SARAHXL1/Expo2023-HABOOB/hardware/3d-models/Anemometer DC motor - 3648443/images/piezas.png

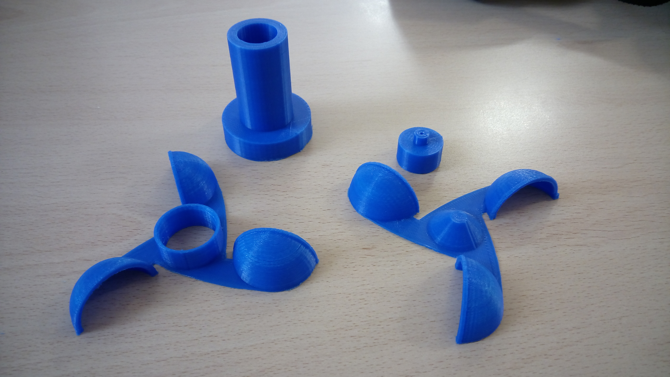
hardware/3d-models/Anemometer DC motor - 3648443/images/piezas.png
