SARAHXL1/Expo2023-HABOOB/hardware/3d-models/Anemometer DC motor - 3648443/README.txt

Anemometer DC motor by Rovegrod on Thingiverse: https://www.thingiverse.com/thing:3648443

Summary:
Low cost anemometer for your projects. I fully recommend the version wich is divided into two halves and the connector for a better an easier printing.Enjoy!
