SARAHXL1/Expo2023-HABOOB/src/05_docs/جدول-التوصيل.md

# جدول التوصيل الكامل

منقول من «دليل بناء عقدة الاستشعار — النموذج الأولي»، القسم 5.

> أرقام المنافذ مقترحة للوحة **ESP32 DevKit V1 ذات 30 منفذًا**.
> راجعها على الطباعة الموجودة على لوحتك قبل التوصيل.

## ملخص

- كل الحساسات والشاشة تتغذى من **3V3** في ESP32، ولها **GND مشترك** مع كل شيء.
- ناقل I2C (GPIO 21 و22) يجمع ADS1115 (`0x48`) وMLX90614 (`0x5A`) وBH1750 (`0x23`).
- ناقل SPI يربط الشاشة.
- DHT22 وDS18B20 لكل منهما سلك بيانات مستقل.
- خط 5V يأتي من TPS63020 إلى **VIN فقط**، ولا يدخل أي حساس.

## توزيع منافذ ESP32

| منفذ ESP32 | يوصل إلى | الغرض |
|---|---|---|
| VIN | VOUT في TPS63020، والطرف الموجب للمكثف | دخل 5V |
| GND | خط GND المشترك | أرضي |
| 3V3 | خط 3V3 على لوحة التجارب | تغذية الحساسات والشاشة |
| GPIO 4 | DATA في DHT22 | حرارة الهواء والرطوبة |
| GPIO 13 | DATA في DS18B20 | حرارة الكرة |
| GPIO 21 | SDA في ADS1115 وMLX90614 وBH1750 | بيانات I2C |
| GPIO 22 | SCL في ADS1115 وMLX90614 وBH1750 | ساعة I2C |
| GPIO 18 | SCL/CLK في الشاشة | ساعة SPI |
| GPIO 23 | SDA/DIN في الشاشة | بيانات SPI |
| GPIO 5 | CS في الشاشة | اختيار الشاشة |
| GPIO 16 | DC في الشاشة | أمر أو بيانات |
| GPIO 17 | RES/RST في الشاشة | إعادة تشغيل الشاشة |
| GPIO 32 | BL/BLK في الشاشة | تعتيم الإضاءة (PWM) |

**منافذ يجب تجنبها:** GPIO 6 إلى 11 (محجوزة للذاكرة). وGPIO 0 و2 و12 و15 منافذ
إقلاع (Strapping) قد تمنع الإقلاع. وGPIO 34 إلى 39 إدخال فقط.
GPIO 5 منفذ إقلاع أيضًا، لكنه مقبول لـ CS لأنه يبقى مرتفعًا وقت الإقلاع.

## DHT22

| الطرف | يوصل إلى |
|---|---|
| + (VCC) | 3V3 |
| OUT (DATA) | GPIO 4 |
| − (GND) | GND المشترك |

الحساس المجرد بأربعة أرجل يحتاج **مقاومة سحب 10kΩ** بين DATA وVCC.
الوحدة ذات الأطراف الثلاثة فيها المقاومة أصلًا.
لا يُقرأ أسرع من مرة كل ثانيتين، وإلا ترجع القراءة `NaN`.

## DS18B20 (داخل الكرة)

| الطرف | يوصل إلى |
|---|---|
| الأحمر (VDD) | 3V3 |
| الأسود (GND) | GND المشترك |
| الأصفر (DATA) | GPIO 13 |
| **مقاومة 4.7kΩ** | **بين DATA و3V3 — إلزامية** |

بدون المقاومة لا يرد الحساس. القراءة **−127 °م** تعني أن المجس غير متصل.
ألوان الأسلاك قد تختلف (الأبيض أحيانًا للبيانات).

## ADS1115

| الطرف | يوصل إلى | ملاحظة |
|---|---|---|
| VDD | 3V3 | |
| GND | GND المشترك | |
| SCL | GPIO 22 | ناقل I2C المشترك |
| SDA | GPIO 21 | ناقل I2C المشترك |
| ADDR | GND | العنوان `0x48` |
| ALRT | لا يوصل | |
| A0 | طرف الموتور الموجب **عبر مقاومة 1kΩ** | سرعة الرياح |
| A1 | منتصف مقسّم الجهد (10kΩ + 10kΩ) من B+ | جهد البطارية |
| A2، A3 | لا توصل | احتياط |

**لا يُدخل على أي مدخل جهد أعلى من 3.3V.** البطارية (4.2V) تُقسم على اثنين قبل A1.

الكسب: `GAIN_FOUR` (±1.024V) للموتور، و`GAIN_ONE` (±4.096V) للبطارية.

## الموتور (مقياس الرياح)

| من | إلى | ملاحظة |
|---|---|---|
| طرف الموتور (+) | مقاومة 1kΩ ثم A0 في ADS1115 | المقاومة تحد التيار |
| طرف الموتور (−) | GND المشترك | |
| مقاومة 10kΩ | بين طرفي الموتور مباشرة | حِمل يثبّت القراءة |

قِس جهد الموتور بالملتيميتر وأنت تديره بأقصى سرعة؛ إن تجاوز 3V أضف مقسّم جهد.
إن ظهرت القراءة سالبة، **اعكس سلكيه**. اجدل السلكين الطويلين لتقليل التشويش.

## MLX90614

| الطرف | يوصل إلى |
|---|---|
| VIN | 3V3 (تحقق من نسخة الجهد) |
| GND | GND المشترك |
| SCL | GPIO 22 |
| SDA | GPIO 21 |

يفرض سرعة I2C قدرها **100 kHz** على الناقل كله — `Wire.setClock(100000)`.

## BH1750

| الطرف | يوصل إلى |
|---|---|
| VCC | 3V3 (أقصى تغذية 3.6V) |
| GND | GND المشترك |
| SCL | GPIO 22 |
| SDA | GPIO 21 |
| ADDR | GND → العنوان `0x23` |

## شاشة ST7789

| طرف الشاشة | يوصل إلى |
|---|---|
| VCC | 3V3 |
| GND | GND المشترك |
| SCL أو CLK | GPIO 18 |
| SDA أو DIN | GPIO 23 |
| RES أو RST | GPIO 17 |
| DC | GPIO 16 |
| CS | GPIO 5 |
| BL أو BLK | GPIO 32 (أو 3V3 لإضاءة دائمة) |

أسماء الأطراف تختلف بين الموردين. أسلاك SPI تحب القِصر: أقل من 20 سم.

## دائرة الطاقة

### TP4056

| الطرف | يوصل إلى |
|---|---|
| منفذ USB-C | محول طاقة 5V USB-C (2A على الأقل) |
| IN+ / IN− | اللوح الشمسي (اختياري، فقط عند فصل المحول) |
| B+ | الطرف الموجب للبطاريتين (على التوازي) |
| B− | الطرف السالب للبطاريتين |
| OUT+ | طرف المفتاح الأوسط |
| OUT− | GND المشترك، وGND في TPS63020 |

**استخدم OUT وليس B للحمل**، لأن الحماية من التفريغ العميق تعمل على طرفي OUT فقط.

### البطاريتان (على التوازي)

| من | إلى |
|---|---|
| موجب الحامل 1 | موجب الحامل 2، ثم B+ |
| سالب الحامل 1 | سالب الحامل 2، ثم B− |

الجهد يبقى 3.7V والسعة تتضاعف إلى 7000 mAh.
**قِس جهد كل بطارية قبل الوصل**، ويجب أن يكون الفرق أقل من 0.1V.

### المفتاح SK12D07VG5

| الطرف | يوصل إلى |
|---|---|
| الأوسط (المشترك) | OUT+ في TP4056 |
| أحد الجانبيين | VIN في TPS63020 |
| الجانبي الآخر | لا يوصل |

المفتاح على خط الموجب فقط، فالشحن يستمر والعقدة مطفأة.

### TPS63020

| الطرف | يوصل إلى |
|---|---|
| VIN | الطرف الجانبي من المفتاح |
| GND (الدخل) | OUT− في TP4056 |
| VOUT | VIN في ESP32، والطرف الموجب للمكثف |
| GND (الخرج) | GND المشترك |
| EN (إن وُجد) | VIN |

**تحقق من جهد الخرج بالملتيميتر قبل توصيل ESP32.**

### المكثف 1000µF

| الطرف | يوصل إلى |
|---|---|
| الموجب (الرجل الأطول) | VIN في ESP32 (خط 5V) |
| السالب (جهة الخط الأبيض) | GND |

ضعه أقرب ما يمكن إلى VIN. **عكس قطبيته قد يجعله ينتفخ أو ينفجر.**

## خطوات أول تشغيل للطاقة

- [ ] قِس جهد كل بطارية منفردة، ثم صلهما على التوازي.
- [ ] صل البطاريتين بـ TP4056، وصل المحول. يجب أن يضيء ليد الشحن.
- [ ] **دون توصيل ESP32:** صل OUT ← المفتاح ← TPS63020، وقِس خرجه (قرابة 5V).
- [ ] ركّب المكثف على الخرج، مع الانتباه للقطبية.
- [ ] صل ESP32 بخرج 5V. يجب أن يضيء ليد الطاقة فيها.
- [ ] افصل المحول. يجب أن تستمر اللوحة في العمل دون إعادة تشغيل.

## ألوان الأسلاك المقترحة

أحمر = 5V · برتقالي = 3V3 · أسود = GND · أزرق = SDA · أخضر = SCL

## تحذيرات

- **لا تغذِّ ESP32 من USB ومن VIN في الوقت نفسه.** أثناء البرمجة من اللابتوب أطفئ مفتاح الطاقة.
- لا تلحم لوحة ESP32 مباشرة على PCB؛ استخدم مقابس نسائية.
- لا تلحم على البطارية مباشرة؛ استخدم الحاملين.
- تأكد من B+ وB− قبل أول توصيل؛ الخطأ هنا يتلف TP4056 فورًا.
