SARAHXL1/Expo2023-HABOOB/src/05_docs/خطة-الاختبار.md

# خطة الاختبار المرحلية

القسم 10 من ملف المتطلبات. **لا تنتقل لمرحلة قبل نجاح سابقتها.**
إضافة حساس واحد في كل مرة هي أسرع طريقة لمعرفة أي قطعة سببت المشكلة.

---

## المرحلة 0 — الخادم واللوحة في وضع المحاكاة ✅ جاهزة

**بلا أي عتاد.**

```bash
pip install pythermalcomfort pyserial
python3 02_server_backend/app.py --simulate
```

افتح `http://localhost:5000`.

**معيار النجاح:** تظهر كل البطاقات التسع بالحالات الصحيحة، ومحاكاة الأعطال
من قسم «أدوات» تغيّر الحالات والرسائل.

**تحقق آلي:**
```bash
python3 06_tools/acceptance_test.py
```

---

## المرحلة 1 — ESP32 وحده عبر USB

ارفع `01_firmware_esp32/sensor_node/sensor_node.ino` على اللوحة **بلا أي حساس موصول**.

```bash
python3 02_server_backend/app.py
python3 03_usb_bridge/serial_bridge.py --port <اسم المنفذ>
```

**معيار النجاح:** الجسر يمرر رسائل، والعقدة تظهر **متصلة** في اللوحة،
وكل الحساسات بحالة `not_found` — وهذا هو المتوقع تمامًا في هذه المرحلة.

> إن لم يفتح الجسر المنفذ: أغلق Serial Monitor في Arduino IDE.

---

## المرحلة 2 — إضافة DHT22

وصّل: `+` إلى 3V3، و`OUT` إلى GPIO 4، و`−` إلى GND.
إن كان مجردًا بأربعة أرجل، أضف مقاومة 10kΩ بين DATA و3V3.

**معيار النجاح:** بطاقة DHT22 خضراء، وقيمه منطقية (حرارة قريبة من حرارة الغرفة).

**إن فشل:** الحالة `read_error` تعني أن القراءة ترجع `NaN` — راجع سلك DATA،
والمقاومة، ولا تقرأه أسرع من كل ثانيتين.

---

## المرحلة 3 — التحقق من القطع المؤجلة وMRT المفترضة

**لا يوجد عتاد يُضاف في هذه المرحلة.** الكرة الحرارية والبطارية مؤجلتان
في الإصدار 2، والمطلوب التأكد أن الموقع يعرض ذلك بوضوح.

**معيار النجاح:**

- بطاقتا **حرارة الكرة الحرارية** و**البطارية** تظهران بحالة **«معطّل»** رمادية،
  لا «غير موجود» حمراء — فالفرق بين «مؤجلة عمدًا» و«مفقودة» واضح للجنة.
- بطاقة UTCI تعرض **MRT مع شارة «مفترضة»**، وقيمتها تساوي حرارة الهواء.
- UTCI يُحسب رغم ذلك، ولا تظهر رسالة نقص.
- لوحة التشخيص تعرض «مصدر MRT: مفترضة (تساوي حرارة الهواء)».

**لإعادة الكرة لاحقًا:** انظر القسم الأخير من هذا الملف.

---

## المرحلة 4 — إضافة ADS1115 والموتور

وصّل ADS1115 على I2C مع ADDR إلى GND، والموتور (+) عبر مقاومة 1kΩ إلى A0،
و(−) إلى GND، ومقاومة 10kΩ بين طرفي الموتور.

**معيار النجاح:** العنوان `0x48` يظهر في لوحة التشخيص،
و`wind_v` يرتفع عند تدوير الكؤوس بيدك.

**إن ظهرت القيمة سالبة:** اعكس سلكي الموتور (ستظهر لك رسالة CK-03 تلقائيًا).

### المعايرة

أمام مروحة عند 3 إلى 5 سرعات، قارن القراءة بمقياس رياح يدوي، وسجّل أزواج
(الجهد، السرعة). احسب ميل الخط `K` والتقاطع `B`، وأدخلهما في نموذج المعايرة
في اللوحة. **لا تحتاج إعادة رفع البرنامج** — الخادم يعيد الحساب من الجهد الخام.

---

## المرحلة 5 — إضافة MLX90614 وVEML7700

كلاهما على نفس ناقل I2C.

**معيار النجاح:** العنوانان `0x5A` و`0x10` يظهران في لوحة التشخيص،
وبطاقتاهما خضراوان.

**إن بقيت الإضاءة صفرًا** في مكان مضاء، سيظهر تنبيه CK-04 تلقائيًا:
تحقق من VIN وSDA وSCL ومن لحام أطراف VEML7700.

> MLX90614 يفرض سرعة I2C قدرها 100 kHz على الناقل كله. البرنامج يضبطها.

---

## المرحلة 6 — إضافة الشاشة (1.69 بوصة · 240×280)

وصّل حسب جدول SPI. أسلاك SPI قصيرة: أقل من 20 سم.

**معيار النجاح:** الشاشة تعرض القيم بالمقاس الصحيح **دون إزاحة أو قص**،
وقيمة UTCI تظهر بعد أول رد من الخادم. النصوص داخل هامش 20 بكسل
فلا تقطعها الزوايا الدائرية.

**إن ظهرت بيضاء:** راجع DC وRST، وتأكد من `init(240, 280)`.
**إن ظهرت مزاحة أو مقصوصة:** بعض وحدات ST7789V2 تحتاج ضبط بداية الصف
والعمود — جرّب `tft.setRowColStart()` حسب وحدتك، أو `init(240, 280, SPI_MODE2)`.
**إن انعكست الألوان:** جرّب `tft.invertDisplay(true)`.

---

## المرحلة 7 — الانتقال للواي فاي

1. شغّل هوتسبوت الجوال على **2.4 GHz**.
2. وصّل اللابتوب بالهوتسبوت.
3. شغّل الخادم وانسخ عنوان IP الذي يطبعه.
4. اكتب الشبكة والعنوان في إعدادات برنامج ESP32، وارفع البرنامج.
5. راقب Serial Monitor: يجب أن يظهر `WiFi connected` ثم `POST 200`.

**معيار النجاح:** نفس النتائج بلا كابل، وطريقة الاتصال في اللوحة «واي فاي».

**إن فشل:** تأكد أن جدار الحماية يسمح لـ Python بالاتصالات الواردة على المنفذ 5000.

---

## المرحلة 8 — استقرار التغذية من USB

دائرة البطارية مؤجلة في الإصدار 2، والتغذية من USB مباشرة بجهد 5V.

**معيار النجاح:** تشغيل متواصل **30 دقيقة** دون إعادة تشغيل —
راقب `وقت التشغيل` في شريط العقدة: يجب ألا يعود للصفر، ويجب أن يبقى
شريط العقدة أخضر طوال المدة.

**إن أُعيد التشغيل:** ستظهر رسالة CK-06 تلقائيًا. غيّر كابل USB
(كابل بيانات جيد، لا كابل شحن رخيص)، أو جرّب منفذ USB آخر، أو منفذًا
مغذّى (Powered Hub)، أو ركّب مكثفًا على خط التغذية.

**مصدر الطاقة** يظهر في شريط العقدة باسم «USB».

---

## المرحلة 9 — اختبار الأعطال

افصل كل حساس على حدة والعقدة تعمل.

**معيار النجاح:** بطاقة الحساس تتحول إلى الحالة الصحيحة **خلال 10 ثوانٍ**،
مع رسالة مساعدة، وإعادته تعيدها خضراء.

جرّب أيضًا إطفاء العقدة: يجب أن يظهر شريطها «غير متصلة» خلال 15 ثانية.

---

## المرحلة 10 — اختبار العرض

| التجربة | المتوقع |
|---|---|
| تشغيل مروحة أمام الكؤوس | ترتفع سرعة الرياح وتنخفض UTCI |
| إطفاء المروحة | تهبط الرياح وترتفع UTCI، وقد تظهر «رياح مقيّدة» |
| كلاهما | التغيير ظاهر بوضوح في الرسوم الصغيرة |

**المروحة وحدها** هي أداة العرض في هذا الإصدار، لأن الكرة الحرارية مؤجلة
وMRT مفترضة — فالمصباح الحراري لن يغيّر النتيجة.

> **في العرض الداخلي:** الرياح قرابة صفر عند إطفاء المروحة، فستظهر علامة
> «رياح مقيّدة». هذا سلوك صحيح: معادلة UTCI لا تقبل رياحًا أقل من 0.5 م/ث.

---

## قائمة التحقق قبل العرض

- [ ] مسح I2C يُظهر العناوين `0x10` و`0x48` و`0x5A`
- [ ] بطاقتا الكرة والبطارية تظهران «معطّل» لا «غير موجود»
- [ ] MRT تظهر بشارة «مفترضة»
- [ ] معايرة مقياس الرياح، وتسجيل K وB في اللوحة
- [ ] الشاشة تعرض 240×280 دون إزاحة أو قص
- [ ] تشغيل متواصل 30 دقيقة من USB دون إعادة تشغيل
- [ ] الخادم يستقبل `POST 200` واللوحة تعرض UTCI
- [ ] كابل USB جيد ومنفذ مغذٍّ جاهزان
- [ ] تجربة «وضع العرض» في اللوحة على الشاشة التي ستُستخدم
- [ ] **خطة احتياطية:** كابل USB وجسر USB جاهزان إن فشلت الشبكة

---

## إعادة الكرة الحرارية لاحقًا

ثلاث خطوات، والخطوة الثالثة وحدها تكفي من ناحية الخادم:

1. **العتاد:** وصّل DS18B20 على GPIO 13، مع مقاومة 4.7kΩ بين DATA و3V3.
2. **برنامج العقدة:** `#define ENABLE_GLOBE 1` في أعلى `sensor_node.ino`، ثم ارفعه.
3. **الخادم:** `"mrt_source": "globe"` في `config.json`، ثم أعد تشغيل الخادم.

ما يحدث تلقائيًا بعد الخطوة الثالثة:

- بطاقة DS18B20 تُفعَّل وتخرج من حالة «معطّل».
- MRT تُحسب من الكرة بمعادلة ISO، وتختفي شارة «مفترضة».
- الفحصان CK-01 وCK-05 يعملان.
- تصحيح الكرة (CA-06) يُطبَّق.
- `tg_c` تدخل في القيم الأساسية لـ UTCI (CA-07).

4. **المعايرة:** قبل إدخال المجس في الكرة، ضعه بجانب DHT22 في الظل، وقارن
   القراءتين، وسجّل الفرق في خانة «تصحيح الكرة» في نموذج المعايرة باللوحة.
