SARAHXL1/Expo2023-HABOOB/docs/requirements/متطلبات موقع اختبار الحساسات.docx

متطلبات موقع اختبار الحساسات والقطع

مشروع هاكثون إكسبو 2030 الرياض · تحدي 2.3

المشروع | منظومة الراحة الحرارية للمناطق الخارجية، تحدي 2.3، هاكثون إكسبو 2030 الرياض
نوع المستند | مواصفات متطلبات (Requirements Specification)، بلا أكواد
المرجع | «دليل بناء عقدة الاستشعار — النموذج الأولي» (الطلب رقم 85)
الاستخدام | يُعطى كاملًا لمحادثة جديدة لبناء الموقع خطوة بخطوة
التاريخ والحالة | 4 أكتوبر 2026 · الإصدار 1 · مسودة

هذا المستند يحدد ماذا يجب أن يفعله موقع الاختبار، ولا يحدد كيف يُكتب كوده. الهدف موقع يعمل على اللابتوب، يُظهر بوضوح قيمة كل حساس وحالته (يعمل، أو غير موجود، أو قراءته خاطئة، أو متوقف)، ويحسب UTCI، ويعمل مع العقدة عبر الواي فاي أو سلك USB.

ملاحظة لمن يبني الموقع: المعرّفات مثل FR-01 وDS-03 ثابتة، فاستخدمها عند مراجعة ما تم تنفيذه. الأرقام والحدود المذكورة قيم مقترحة يمكن تعديلها في ملف إعدادات واحد.

# 1. الهدف والنطاق

## 1.1 الهدف

موقع اختبار يُستخدم في ثلاث مراحل:

1. أثناء التجميع: للتأكد أن كل حساس موصول ويقرأ قيمًا منطقية، قبل اللحام.
2. أثناء المعايرة: لتسجيل القراءات الخام، مثل جهد الموتور، ومقارنتها بأجهزة مرجعية.
3. أثناء العرض أمام اللجنة: لعرض القيم وUTCI لحظيًا بشكل واضح.

## 1.2 داخل النطاق

- استقبال قراءات عقدة واحدة على الأقل (مع قابلية عدة عقد).
- عرض قيمة كل حساس وحالته وآخر تحديث له.
- حساب MRT وسرعة الرياح عند 10 م وUTCI وفئة الإجهاد.
- عرض تاريخ قصير (آخر 10 إلى 60 دقيقة) كرسوم صغيرة.
- تخزين القراءات محليًا وتصديرها إلى ملف CSV.
- طريقتا اتصال: الواي فاي، وسلك USB كبديل.
- وضع محاكاة يولّد بيانات وهمية لاختبار الموقع قبل وصول القطع.

## 1.3 خارج النطاق

- نموذج التقدير بين الأعمدة، والتوقع، والتوصيات، وحلقة الكفاءة (تأتي في المنصة).
- تسجيل الدخول والصلاحيات.
- الاستضافة على الإنترنت.

# 2. البنية العامة

النظام من أربعة أجزاء:

الجزء | يعمل على | مسؤوليته
برنامج العقدة (Firmware) | ESP32 | يقرأ الحساسات، ويحدد حالة كل قطعة، ويرسل رسالة JSON دورية
جسر USB (Serial Bridge) | اللابتوب | بديل عند غياب الواي فاي: يقرأ رسائل JSON من منفذ USB ويمررها للخادم
الخادم (Backend) | اللابتوب | يستقبل الرسائل، ويتحقق منها، ويحسب UTCI، ويحدد الحالات، ويخزن، ويقدم البيانات للواجهة
لوحة العرض (Dashboard) | متصفح اللابتوب | تعرض القيم والحالات والرسوم، وتتحدث تلقائيًا

مسار البيانات:

1. ESP32 يقرأ الحساسات.
2. يرسل JSON إلى الخادم: عبر الواي فاي (HTTP POST)، أو يطبعه على منفذ USB فيمرره الجسر.
3. الخادم يحسب ويخزن.
4. اللوحة تطلب آخر البيانات كل ثانيتين وتعرضها.

التقنيات المقترحة (قابلة للتغيير):

- برنامج العقدة: Arduino IDE مع حزمة esp32 من Espressif.
- الخادم والجسر: Python مع Flask (أو FastAPI)، ومكتبة pythermalcomfort للحسابات، وpyserial للجسر، وSQLite للتخزين.
- اللوحة: صفحة HTML واحدة مع JavaScript بسيط، بلا اعتماد على الإنترنت، لأن الشبكة في مكان العرض قد لا تكون متصلة بالإنترنت.

# 3. القطع المطلوب اختبارها وحالاتها

## 3.1 القطع ومعرّفاتها في الموقع

معرّف القطعة | القطعة | الاتصال | ما تُرسله
esp32 | لوحة ESP32 | — | حالة العقدة: وقت التشغيل، وقوة الواي فاي، والذاكرة الحرة، وسبب آخر إعادة تشغيل
dht22 | DHT22 | GPIO 4 | حرارة الهواء ta_c، والرطوبة rh_pct
ds18b20 | DS18B20 في الكرة | GPIO 13 (1-Wire) | حرارة الكرة tg_c، وعدد المجسات المكتشفة
ads1115 | ADS1115 | I2C 0x48 | جهد الموتور wind_v، وجهد البطارية bat_v
anemometer | موتور الرياح (عبر ADS1115) | A0 | سرعة الرياح wind_ms بعد المعايرة
mlx90614 | MLX90614 | I2C 0x5A | حرارة الأرض tsurf_c، وحرارة الحساس نفسه tamb_c
bh1750 | BH1750 | I2C 0x23 | الإضاءة lux
battery | البطاريتان (عبر ADS1115) | A1 | الجهد، ونسبة الشحن التقريبية
tft | شاشة ST7789 | SPI | لا ترسل قراءة؛ حالتها «مفترضة» فقط

## 3.2 حالات القطعة

كل قطعة لها حالة واحدة في كل لحظة. العقدة تحدد الحالات الثلاث الأولى، والخادم يحدد الباقي:

الحالة | من يحددها | المعنى | اللون في اللوحة
ok | العقدة، ثم يؤكدها الخادم | القطعة موجودة، والقراءة ضمن المدى المنطقي | أخضر
not_found | العقدة | القطعة لم تستجب عند التشغيل (عنوان I2C غير موجود، أو صفر مجسات) | أحمر
read_error | العقدة | القطعة موجودة لكن القراءة فشلت (NaN، أو −127 °م، أو انتهاء المهلة) | برتقالي
out_of_range | الخادم | القراءة خارج المدى المنطقي في الجدول 3.3 | أصفر
stale | الخادم | لم تصل قراءة جديدة منذ أكثر من 30 ثانية | رمادي
disabled | الإعدادات | القطعة معطلة عمدًا (مثل BH1750 في العرض الداخلي) | رمادي فاتح
assumed | العقدة | قطعة بلا طريقة للتحقق، مثل الشاشة | أزرق

## 3.3 المدى المنطقي لكل قيمة

القيمة | الحد الأدنى | الحد الأعلى | ملاحظة
ta_c (حرارة الهواء) | −10 °م | 60 °م | —
rh_pct (الرطوبة) | 0% | 100% | —
tg_c (حرارة الكرة) | −10 °م | 90 °م | −127 تعني أن المجس غير متصل
wind_v (جهد الموتور) | 0 V | 1.0 V | أعلى من 1V يعني أن مدى ADS1115 قد يتشبع؛ راجع الكسب
wind_ms (سرعة الرياح) | 0 م/ث | 30 م/ث | —
tsurf_c (حرارة الأرض) | −20 °م | 90 °م | —
lux (الإضاءة) | 0 | 120,000 | قيمة ثابتة عند 65,535 تعني تشبعًا
bat_v (البطارية) | 2.9 V | 4.3 V | أقل من 3.4V تحذير، وأقل من 3.1V حرج
rssi (الواي فاي) | −90 dBm | −30 dBm | أضعف من −80 تحذير

## 3.4 فحوص منطقية إضافية

المعرّف | الفحص | النتيجة عند الفشل
CK-01 | الفرق بين ta_c وtg_c أكبر من 3 °م في الظل وقت المعايرة | تنبيه «تحقق من معايرة الكرة»
CK-02 | wind_v ثابت عند الصفر مع تشغيل المروحة | تنبيه «تحقق من توصيل الموتور أو اتجاهه»
CK-03 | wind_v سالب | تنبيه «اعكس سلكي الموتور»
CK-04 | lux ثابت عند 65,535 | تنبيه «BH1750 متشبع، أضف مشتِّتًا»
CK-05 | tg_c يتغير أكثر من 10 °م خلال 10 ثوانٍ | تنبيه «قراءة الكرة غير مستقرة»
CK-06 | إعادة تشغيل متكررة للعقدة (uptime يعود للصفر أكثر من مرة خلال 5 دقائق) | تنبيه «مشكلة طاقة محتملة؛ تحقق من المكثف والمحول»

# 4. متطلبات برنامج العقدة (Firmware)

## 4.1 المتطلبات الوظيفية

المعرّف | المتطلب
FW-01 | عند التشغيل، يفحص البرنامج ناقل I2C، ويسجل العناوين الموجودة، ويحدد حالة ADS1115 وMLX90614 وBH1750 منها
FW-02 | يعدّ مجسات DS18B20 على السلك؛ إن كان العدد صفرًا فالحالة not_found
FW-03 | DHT22 لا يمكن اكتشافه مسبقًا؛ حالته تُحدد من أول قراءة (NaN تعني read_error)
FW-04 | يقرأ جهد الموتور كل 100 ملي ثانية، ويرسل متوسطه خلال فترة الإرسال
FW-05 | يقرأ باقي الحساسات كل 5 ثوانٍ، ولا يقرأ DHT22 أسرع من مرة كل ثانيتين
FW-06 | يرسل رسالة كل 5 ثوانٍ في وضع الاختبار، وكل 60 ثانية في وضع القياس الطويل؛ الفترة قابلة للتغيير
FW-07 | يرسل الرسالة بطريقتين في الوقت نفسه: HTTP POST عبر الواي فاي إن كان متصلًا، وسطر على منفذ USB يبدأ بالبادئة `DATA:` دائمًا
FW-08 | إن فشل الواي فاي، يستمر القياس والطباعة على USB، ويحاول إعادة الاتصال كل 30 ثانية دون أن يتوقف
FW-09 | لا يستخدم انتظارًا طويلًا (delay) في الحلقة الرئيسية؛ كل مهمة لها جدولة مستقلة بالوقت
FW-10 | يعرض على الشاشة: حرارة الهواء، والرطوبة، وحرارة الكرة، والرياح، والبطارية، وحالة الواي فاي، وآخر قيمة UTCI إن أرجعها الخادم
FW-11 | يقرأ قيمة UTCI وفئتها من رد الخادم (إن وُجدت) ويعرضها على الشاشة
FW-12 | كل الإعدادات (اسم الشبكة وكلمتها، وعنوان الخادم، ومعرّف العقدة، ومعاملات معايرة الرياح، وفترة الإرسال) في قسم واحد واضح أعلى البرنامج
FW-13 | يطبع على USB رسائل تشخيص مقروءة عند التشغيل: نتيجة فحص I2C، وعدد مجسات DS18B20، وحالة الواي فاي، وعنوان IP
FW-14 | يحصل على الوقت من NTP بتوقيت الرياض (UTC+3)؛ إن لم يتوفر، يرسل uptime ويترك الخادم يضع وقت الاستلام

## 4.2 المكتبات المطلوبة

القطعة | المكتبة
DHT22 | DHT sensor library (Adafruit) + Adafruit Unified Sensor
DS18B20 | OneWire + DallasTemperature
ADS1115 | Adafruit ADS1X15
MLX90614 | Adafruit MLX90614 Library
BH1750 | BH1750 (Christopher Laws)
الشاشة | Adafruit ST7735 and ST7789 Library + Adafruit GFX Library
JSON | ArduinoJson (الإصدار 7)
الشبكة والوقت | WiFi.h، وHTTPClient.h، وtime.h (مدمجة)

## 4.3 إعدادات العتاد التي يجب احترامها

- I2C: المنفذان SDA = GPIO 21 وSCL = GPIO 22، والسرعة 100 kHz (بسبب MLX90614).
- ADS1115: كسب `GAIN_FOUR` لمدخل الموتور A0، وكسب `GAIN_ONE` لمدخل البطارية A1. جهد البطارية الحقيقي = القراءة × 2 (مقسّم 10k/10k).
- معادلة الرياح: wind_ms = K × wind_v + B، وتساوي صفرًا إن كان wind_v أقل من V_MIN. القيم المبدئية K = 20 وB = 0.5 وV_MIN = 0.02 مؤقتة حتى المعايرة.
- الشاشة: CS = 5، وDC = 16، وRST = 17، والإضاءة على GPIO 32 بـ PWM.

# 5. عقد البيانات (رسالة JSON)

## 5.1 الهيكل

الرسالة كائن JSON واحد فيه معلومات العقدة، وكائن `sensors` فيه قطعة لكل حساس، ولكل قطعة حقل `status`:

{

"schema": 2,

"node_id": "node-01",

"fw": "0.2.0",

"ts": 1791100800,

"uptime_s": 742,

"reset_reason": "POWERON",

"wifi": {"connected": true, "rssi": -58, "ip": "192.168.1.77"},

"heap_free": 182340,

"i2c_found": ["0x23", "0x48", "0x5A"],

"send_interval_s": 5,

"sensors": {

"dht22": {"status": "ok", "ta_c": 34.2, "rh_pct": 21.5},

"ds18b20": {"status": "ok", "tg_c": 41.8, "count": 1},

"ads1115": {"status": "ok"},

"anemometer": {"status": "ok", "wind_v": 0.084, "wind_ms": 1.9, "height_m": 1.8, "samples": 50},

"battery": {"status": "ok", "bat_v": 3.98},

"mlx90614": {"status": "ok", "tsurf_c": 47.3, "tamb_c": 36.1},

"bh1750": {"status": "ok", "lux": 61200},

"tft": {"status": "assumed"}

}

}

## 5.2 قواعد العقد

المعرّف | القاعدة
DS-01 | الحقل `schema` إلزامي، ويُرفع رقمه عند أي تغيير في الهيكل
DS-02 | القيمة غير المتوفرة تُرسل `null`، ولا تُحذف ولا تُرسل كرقم وهمي
DS-03 | كل الوحدات ثابتة كما في أسماء الحقول (`_c` للدرجة المئوية، و`_pct` للنسبة، و`_v` للفولت، و`_ms` لمتر/ثانية)
DS-04 | العقدة ترسل القيم الخام، ولا تحسب MRT ولا UTCI
DS-05 | الرسالة على USB هي نفس JSON في سطر واحد، تسبقه البادئة `DATA:`
DS-06 | الخادم يقبل حقولًا إضافية غير معروفة ويتجاهلها، حتى لا يتعطل عند إضافة حساس جديد

## 5.3 رد الخادم

يرد الخادم على كل رسالة بكائن JSON فيه: `accepted` (نعم أو لا)، و`utci_c`، و`stress_category`، و`mrt_c`، و`server_time`. العقدة تعرض UTCI منه على الشاشة (FW-11).

# 6. متطلبات الخادم

## 6.1 الوظائف

المعرّف | المتطلب
SV-01 | يستقبل الرسائل من الواي فاي على نقطة استقبال (POST) ومن جسر USB بنفس الصيغة
SV-02 | يتحقق من الرسالة: وجود `node_id` و`sensors`، وأن الأرقام أرقام فعلًا؛ الرسالة المعطوبة تُرفض مع سبب واضح وتُسجل في سجل الأخطاء
SV-03 | يضع وقت الاستلام لكل رسالة، ويستخدمه بدل `ts` إن كان `ts` غير منطقي (مثل 1970)
SV-04 | يطبّق فحص المدى المنطقي (الجدول 3.3)، ويحوّل حالة `ok` إلى `out_of_range` عند الحاجة
SV-05 | يحدد حالة `stale` لأي قطعة لم تتحدث منذ أكثر من 30 ثانية، ويحدد أن العقدة غير متصلة إن لم تصل منها رسالة منذ أكثر من 15 ثانية في وضع الاختبار
SV-06 | يطبّق الفحوص المنطقية (الجدول 3.4) ويُخرج قائمة تنبيهات نصية
SV-07 | يحسب القيم المشتقة (القسم 7) ويخزنها مع الرسالة
SV-08 | يخزن كل رسالة كما وصلت مع القيم المشتقة في قاعدة بيانات محلية (SQLite)، مع وقت الاستلام ومعرّف العقدة
SV-09 | يقدم واجهات للوحة (القسم 6.2)
SV-10 | يصدّر البيانات إلى ملف CSV لفترة محددة، مع عمود لكل قيمة وعمود لكل حالة
SV-11 | يعمل على كل واجهات الشبكة (0.0.0.0) على منفذ ثابت (مقترح 5000)، حتى يصل إليه ESP32 من الشبكة المحلية
SV-12 | يطبع عند التشغيل عناوين IP الخاصة باللابتوب، حتى يعرف المستخدم ما يكتبه في إعدادات ESP32
SV-13 | فيه وضع محاكاة يولّد رسائل وهمية واقعية لعقدة أو اثنتين، مع خيار لمحاكاة أعطال (حساس مفقود، أو قراءة خاطئة، أو انقطاع)
SV-14 | ملف إعدادات واحد فيه: المنفذ، وحدود المدى، ومهلة stale، والقطع المعطلة، وقطر الكرة وانبعاثيتها، وارتفاع مقياس الرياح، ومعاملات المعايرة لكل عقدة
SV-15 | نقطة معايرة: إمكانية حفظ معاملات K وB لكل عقدة من الخادم وإعادة حساب wind_ms منها، حتى لا نعيد برمجة ESP32 بعد كل معايرة

## 6.2 الواجهات (API)

الطريقة | المسار | الوظيفة
POST | /api/readings | استقبال رسالة من العقدة أو الجسر
GET | /api/nodes | قائمة العقد، وحالة كل واحدة (متصلة أو لا)، وآخر ظهور
GET | /api/latest?node=node-01 | آخر رسالة بعد المعالجة: القيم، والحالات، والقيم المشتقة، والتنبيهات
GET | /api/history?node=node-01&minutes=15 | سلسلة زمنية للرسوم الصغيرة
GET | /api/export.csv?node=node-01&from=…&to=… | تصدير CSV
GET | /api/errors | آخر 50 رسالة مرفوضة وسبب الرفض
POST | /api/calibration | حفظ معاملات معايرة الرياح ومعامل تصحيح الكرة لعقدة
GET | / | لوحة العرض

# 7. الحسابات في الخادم

المعرّف | الحساب | الطريقة
CA-01 | سرعة الرياح عند 10 م | دالة `scale_wind_speed_log` من `pythermalcomfort.environment`، من ارتفاع الحساس (1.8 م مثلًا) إلى 10 م
CA-02 | MRT | دالة `mean_radiant_tmp` من `pythermalcomfort.environment`، بالمعطيات: tg، وtdb، وسرعة الرياح عند الكرة، وd = 0.04، وemissivity = 0.95، وstandard = "ISO"
CA-03 | UTCI وفئة الإجهاد | دالة `utci` من `pythermalcomfort.models` بالمعطيات tdb، وtr = MRT، وv = سرعة الرياح عند 10 م، وrh؛ ترجع `utci` و`stress_category`
CA-04 | حماية المدى | الدالة ترجع NaN إن كانت الرياح خارج 0.5 إلى 17 م/ث، أو MRT خارج (tdb − 30) إلى (tdb + 70). الخادم يرفع الرياح إلى 0.5 كحد أدنى، ويُظهر علامة «رياح مقيّدة» في اللوحة
CA-05 | نسبة البطارية | تقريب خطي من الجدول: 4.2V = 100%، و3.7V قرابة 50%، و3.3V قرابة 5%؛ مع تنبيه أنها تقريبية
CA-06 | تصحيح الكرة | إن وُجد معامل تصحيح محفوظ من المعايرة (الفرق مع DHT22 في الظل)، يُطرح من tg قبل الحساب
CA-07 | عند غياب قيمة | إن غابت قيمة أساسية (ta أو rh أو tg أو الرياح)، لا يُحسب UTCI، وتُعرض رسالة توضح القيمة الناقصة

ملاحظة: الكود يعتمد على الإصدار 3 أو أحدث من pythermalcomfort. يُراجع توثيق الإصدار المثبّت للتأكد من أسماء الدوال وما ترجعه.

# 8. متطلبات لوحة العرض

## 8.1 تخطيط الصفحة

الصفحة باللغة العربية ومن اليمين لليسار، ومن الأعلى إلى الأسفل:

الترتيب | القسم | المحتوى
1 | شريط العقدة | اسم العقدة؛ ونقطة ملونة (متصلة أو غير متصلة)؛ وآخر ظهور («منذ 3 ثوانٍ»)؛ وطريقة الاتصال (واي فاي أو USB)؛ وقوة الإشارة بأعمدة؛ والبطارية بالنسبة والجهد؛ ووقت التشغيل؛ وإصدار البرنامج
2 | بطاقة UTCI الكبيرة | القيمة بخط كبير؛ واسم فئة الإجهاد بالعربي؛ ولون الخلفية حسب الفئة (الجدول 8.3)؛ وتحتها MRT، والرياح عند 10 م، وعلامة «رياح مقيّدة» إن وُجدت
3 | شبكة بطاقات القطع | بطاقة لكل قطعة من الجدول 3.1 (القسم 8.2)
4 | التنبيهات | قائمة التنبيهات الحالية من الفحوص، مرتبة حسب الخطورة
5 | الرسوم الصغيرة | خط زمني لآخر 15 دقيقة لكل من: Ta، وTg، وMRT، وUTCI، وسرعة الرياح، وجهد البطارية
6 | لوحة التشخيص (قابلة للطي) | عناوين I2C المكتشفة، وعدد مجسات DS18B20، والذاكرة الحرة، وسبب آخر إعادة تشغيل، وآخر رسالة JSON خام كما وصلت، وآخر الرسائل المرفوضة
7 | أدوات | زر تصدير CSV؛ وزر إيقاف التحديث مؤقتًا؛ ونموذج إدخال معاملات المعايرة؛ ومفتاح تشغيل وضع المحاكاة

## 8.2 بطاقة القطعة

كل بطاقة تحتوي:

- اسم القطعة بالعربي، وتحته اسمها التقني (مثل «حرارة الهواء والرطوبة — DHT22»).
- شارة الحالة بالكلمة واللون (الجدول 3.2).
- القيمة أو القيم بخط واضح مع الوحدة.
- آخر تحديث كوقت نسبي.
- منفذ التوصيل كتذكير (مثل «GPIO 4»).
- سطر مساعدة يظهر فقط عند الخطأ، ويقترح السبب الأرجح (الجدول 8.4).

## 8.3 ألوان فئات UTCI

UTCI (°م) | الفئة بالعربي | اللون المقترح
أعلى من 46 | إجهاد حراري شديد جدًا | أحمر داكن
38 إلى 46 | إجهاد حراري قوي جدًا | أحمر
32 إلى 38 | إجهاد حراري قوي | برتقالي
26 إلى 32 | إجهاد حراري متوسط | أصفر
9 إلى 26 | لا يوجد إجهاد حراري | أخضر
0 إلى 9 | إجهاد بارد خفيف | أزرق فاتح
−13 إلى 0 | إجهاد بارد متوسط | أزرق
أقل من −13 | إجهاد بارد قوي أو أشد | أزرق داكن

## 8.4 رسائل المساعدة عند الأعطال

القطعة والحالة | الرسالة المقترحة
dht22 / read_error | تحقق من سلك DATA على GPIO 4، ومن مقاومة 10kΩ إن كان الحساس مجردًا، ولا تقرأه أسرع من كل ثانيتين
ds18b20 / not_found أو read_error | تحقق من مقاومة 4.7kΩ بين DATA و3V3، ومن ألوان الأسلاك؛ القيمة −127 تعني انقطاعًا
ads1115 / not_found | العنوان 0x48 غير موجود: تحقق من SDA وSCL ومن توصيل ADDR بـ GND
anemometer / out_of_range | راجع كسب ADS1115، أو اعكس سلكي الموتور إن كانت القيمة سالبة
mlx90614 / not_found | العنوان 0x5A غير موجود: تحقق من التغذية ونسخة الجهد
bh1750 / not_found | العنوان 0x23 غير موجود: تحقق من توصيل ADDR بـ GND
battery / out_of_range | تحقق من مقسّم الجهد على A1؛ والجهد المنخفض يعني الحاجة للشحن
العقدة / غير متصلة | تحقق من الطاقة، ومن الواي فاي 2.4 GHz، ومن عنوان الخادم في إعدادات ESP32، أو استخدم جسر USB

## 8.5 متطلبات عامة للوحة

المعرّف | المتطلب
UI-01 | تتحدث كل ثانيتين دون إعادة تحميل الصفحة
UI-02 | لا تعتمد على أي ملف من الإنترنت (لا CDN)؛ الخطوط والرسوم والسكربتات كلها محلية
UI-03 | الحالة لا تُعرف باللون وحده: كل شارة فيها كلمة أيضًا، لمن لا يميز الألوان
UI-04 | تُقرأ من مسافة مترين على شاشة لابتوب: قيمة UTCI بحجم 48 بكسل على الأقل، والقيم الأخرى 20 بكسل على الأقل
UI-05 | تعمل على متصفح الجوال أيضًا، فيفتحها عضو آخر من الفريق على نفس الشبكة
UI-06 | إن انقطع الخادم، تظهر رسالة واضحة أعلى الصفحة بدل تجمّد القيم
UI-07 | وضع العرض: زر يكبّر بطاقة UTCI والقيم الأساسية فقط، ويخفي التشخيص، لاستخدامه أمام اللجنة
UI-08 | عند اختيار عقدة من قائمة، تعرض اللوحة بياناتها (للاستعداد لعقدتين أو أكثر)

# 9. طرق ربط الحساسات باللابتوب

## 9.1 الطريقة الأولى: الواي فاي (الأساسية)

المتطلبات:

- شبكة واي فاي بتردد 2.4 GHz، لأن ESP32 لا يدعم 5 GHz. هوتسبوت الجوال هو الخيار الأضمن في مكان العرض.
- اللابتوب وESP32 على نفس الشبكة.
- جدار الحماية في اللابتوب يسمح لـ Python بالاتصالات الواردة على المنفذ 5000.

الخطوات:

1. شغّل هوتسبوت الجوال، وتأكد أنه على 2.4 GHz (في بعض الجوالات خيار «توسيع التوافق» أو «2.4 GHz»).
2. وصّل اللابتوب بالهوتسبوت.
3. شغّل الخادم، وانسخ عنوان IP الذي يطبعه (SV-12)، أو اعرفه بـ `ipconfig` في ويندوز أو من إعدادات الشبكة في ماك.
4. اكتب اسم الشبكة وكلمتها وعنوان الخادم في إعدادات برنامج ESP32، ثم ارفع البرنامج.
5. افتح Serial Monitor بسرعة 115200، وتأكد من ظهور: «WiFi connected» وعنوان IP للعقدة، ثم رد الخادم 200.
6. افتح اللوحة في المتصفح على `http://localhost:5000`.
7. إن تغيّر عنوان اللابتوب (يحدث عند إعادة الاتصال)، حدّث العنوان في ESP32. الحل الأفضل لاحقًا: تثبيت IP اللابتوب في إعدادات الشبكة، أو استخدام اسم mDNS.

## 9.2 الطريقة الثانية: سلك USB (البديلة)

تُستخدم إن لم يتوفر الواي فاي، أو لاختبار الحساسات قبل إعداد الشبكة.

المتطلبات:

- كابل USB للبيانات (لا للشحن فقط).
- تعريف شريحة USB في اللوحة: CP2102 أو CH340.
- جسر USB (برنامج Python صغير على اللابتوب) يقرأ المنفذ التسلسلي بسرعة 115200، ويأخذ فقط الأسطر التي تبدأ بـ `DATA:`، ويرسل ما بعدها إلى الخادم على `/api/readings`، ويضع في الرسالة أن طريقة الاتصال USB.

الخطوات:

1. وصّل ESP32 باللابتوب بالكابل.
2. اعرف اسم المنفذ: `COM3` مثلًا في ويندوز (من Device Manager)، أو `/dev/cu.usbserial-…` في ماك.
3. أغلق Serial Monitor في Arduino IDE، لأن المنفذ لا يُفتح من برنامجين في الوقت نفسه.
4. شغّل الخادم، ثم الجسر مع اسم المنفذ.
5. افتح اللوحة. يجب أن تظهر طريقة الاتصال «USB».

متطلبات الجسر:

المعرّف | المتطلب
BR-01 | يعيد محاولة فتح المنفذ تلقائيًا إن انفصل الكابل، دون أن يتوقف
BR-02 | يتجاهل أي سطر لا يبدأ بـ `DATA:`، ويطبع الأسطر الأخرى للتشخيص
BR-03 | يتجاهل السطر المعطوب ويستمر
BR-04 | يقبل اسم المنفذ والسرعة وعنوان الخادم كمعطيات عند التشغيل
BR-05 | يعرض قائمة المنافذ المتاحة إن لم يُحدَّد منفذ

## 9.3 مقارنة الطريقتين

| الواي فاي | USB
الحركة | العمود حر في مكانه | العمود قرب اللابتوب
الإعداد | شبكة، وعنوان IP، وجدار الحماية | كابل واسم منفذ
الطاقة | من بطارية العمود أو المحول | من اللابتوب عبر USB
مناسب لـ | العرض النهائي | التجميع الأول، والطوارئ في العرض

# 10. خطة الاختبار المرحلية

ابنِ واختبر بهذا الترتيب، ولا تنتقل لمرحلة قبل نجاح سابقتها:

المرحلة | ما يُختبر | معيار النجاح
0 | الخادم واللوحة في وضع المحاكاة | تظهر كل البطاقات بالحالات الصحيحة، ومحاكاة الأعطال تغيّر الحالات والرسائل
1 | ESP32 وحده عبر USB | الجسر يمرر رسائل، والعقدة تظهر متصلة، وكل الحساسات not_found
2 | إضافة DHT22 | بطاقته خضراء، وقيمه منطقية
3 | إضافة DS18B20 مع المقاومة | العدد 1، وقراءته قريبة من DHT22 في الظل
4 | إضافة ADS1115 والموتور | العنوان 0x48 يظهر، وwind_v يرتفع عند تدوير الكؤوس بيدك
5 | إضافة MLX90614 وBH1750 | العنوانان 0x5A و0x23 يظهران
6 | إضافة الشاشة | تعرض القيم
7 | الانتقال للواي فاي | نفس النتائج دون كابل، وطريقة الاتصال «واي فاي»
8 | دائرة الطاقة والبطارية | bat_v منطقي، وفصل المحول لا يسبب إعادة تشغيل (uptime لا يعود للصفر)
9 | اختبار الأعطال | فصل كل حساس يغيّر بطاقته إلى الحالة الصحيحة خلال 10 ثوانٍ، وإعادته تعيدها خضراء
10 | اختبار العرض | المصباح يرفع Tg وUTCI، والمروحة ترفع الرياح وتخفض UTCI، والتغيير ظاهر في الرسوم

# 11. المتطلبات غير الوظيفية

المعرّف | المتطلب
NF-01 | يعمل الموقع كاملًا بلا إنترنت، على شبكة محلية أو بسلك USB
NF-02 | يعمل على ويندوز وماك، بتثبيت أدوات Python المطلوبة فقط
NF-03 | التأخير من القياس إلى ظهوره في اللوحة أقل من 3 ثوانٍ في وضع الاختبار
NF-04 | يتحمل تشغيلًا متواصلًا 12 ساعة دون توقف أو تضخم ملحوظ في الذاكرة
NF-05 | ملف README يشرح التثبيت والتشغيل في أقل من 10 خطوات
NF-06 | هيكل ملفات واضح: مجلد للعقدة، ومجلد للخادم، ومجلد للواجهة، وملف إعدادات واحد
NF-07 | الرسائل للمستخدم بالعربي، وأسماء الحقول والمتغيرات بالإنجليزي
NF-08 | البيانات الخام لا تُعدّل بعد تخزينها؛ القيم المشتقة تُحسب وتُخزن بجانبها

# 12. معايير القبول

الموقع مقبول عندما:

☐ تظهر بطاقة لكل قطعة من الجدول 3.1، بحالتها الصحيحة.

☐ فصل أي حساس أثناء التشغيل يحوّل بطاقته إلى حالة خطأ مع رسالة مساعدة خلال 10 ثوانٍ.

☐ إطفاء العقدة يجعل شريطها «غير متصلة» خلال 15 ثانية.

☐ يُحسب UTCI وفئته، ويظهر لون الفئة، وتظهر علامة «رياح مقيّدة» عند الحاجة.

☐ تعمل الطريقتان: الواي فاي وUSB.

☐ يعمل وضع المحاكاة دون أي عتاد.

☐ يُصدَّر ملف CSV يُفتح في الإكسل بأعمدة واضحة.

☐ يعمل كل شيء بلا إنترنت.

# 13. نص جاهز لبدء المحادثة الجديدة

انسخ هذا النص وأرفق معه هذا الملف و«دليل بناء عقدة الاستشعار»:

أريد بناء موقع اختبار لعقدة استشعار ESP32 لمشروع الراحة الحرارية. أرفقت ملف متطلبات كاملًا فيه البنية، وعقد البيانات (JSON schema 2)، وحالات القطع، والحسابات بمكتبة pythermalcomfort، وتخطيط اللوحة، وطرق الربط بالواي فاي وUSB، وخطة الاختبار. وأرفقت دليل البناء الذي فيه توصيل كل قطعة ومنافذها. ابنِ المشروع على مراحل حسب القسم 10 من الملف: ابدأ بالخادم ولوحة العرض مع وضع المحاكاة (المرحلة 0)، ثم جسر USB، ثم برنامج ESP32. التزم بالمعرّفات (FR وDS وSV وCA وUI وBR) وأخبرني بعد كل مرحلة بما نُفذ منها. اللوحة عربية من اليمين لليسار، وتعمل بلا إنترنت. أنا أستخدم [ويندوز / ماك] وArduino IDE 2.

متطلبات موقع اختبار الحساسات والقطع
