SARAHXL1/Expo2023-HABOOB/hardware/3d-models/هبوب_مواصفات_الهيكل_الميكانيكي.md

# هبوب — مواصفات الهيكل الميكانيكي للنموذج الأولي
الإصدار B.2 · 12 أكتوبر 2026 · الحالة: مسودة للمراجعة
المرجع: «هبوب - الرسومات الهندسية - الإصدار B.2.pdf» (10 لوحات A3)، و«هبوب - ملفات STL - الإصدار B.2.zip»، وHB-201_202_outline.dxf

## قرارات الفريق المعتمدة (12 أكتوبر)
- الهيكل مقسّم إلى أقسام تُربط بوصلات: حجرة الحساسات، ثم العمود، ثم أسطوانة الزخارف، ثم حساس الرياح.
- حساس الرياح يركب على سطح غطاء أسطوانة الزخارف (الخيار الأخضر).
- لا يوجد حساس ضوء.
- فتحة الكيبل أفقية 50 × 10 في خلف حجرة الحساسات، وتبدأ على ارتفاع 5 من الأرضية. بجانبها مباشرة فتحة زر تشغيل 11 × 15.
- فتحة الموتور Ø20، مطابقة لملف base.STL.

## الأقسام (من الأسفل للأعلى)
| الرقم | القسم | المقاسات الأساسية | الارتفاع على الطاولة |
|---|---|---|---|
| HB-110 | حجرة الحساسات | القاعدة Ø150 × 3.2 ملتحمة بالجدار. أنبوب Ø130/Ø124.4 بارتفاع 100. 27 فتحة تهوية عرضها 10: 22 منها 5→60، والخمس التي فوق فتحتي الكيبل والزر 25→60. مجريان للوحة 90 × 70. فتحة الكيبل 50 × 10 (R5) في منتصف الخلف على 5→15 من الأرضية. فتحة الزر 11 × 15 على 5→20، والفاصل بينهما 4 على السطح الخارجي (على زاوية 121°). شفّة علوية Ø124.0 × 10 | 0 → 113.2 |
| HB-120 | العمود | أنبوب Ø130/Ø124.4 بارتفاع 100. نافذة الشاشة في الواجهة، مركزها على 50. شفّة علوية Ø124.0 × 10 | 103.2 → 203.2 |
| HB-130 | الوصلة الكبيرة | قرص Ø190 × 3. طوق داخلي Ø124.4 × 10، وشفّة خارجية Ø185.6 × 10 | 203.2 → 206.2 |
| HB-140 | أسطوانة الزخارف | أنبوب Ø190/Ø186 بارتفاع 100، وغطاؤه 3 جزء منه. في الغطاء فتحة Ø10، وثقبان Ø1.6 على دائرة Ø24. تُطبع مقلوبة | 206.2 → 306.2 |
| HB-104 | قاعدة المحرك | تجويف Ø20 نافذ، Ø30 عند الأعلى وØ40 عند الأسفل، ارتفاع 20. ثقبان Ø2 لبرغيي M2 | 306.2 → 326.2 |
| HB-200 | مجموعة الكؤوس | انظر أدناه، بدون تغيير | الارتفاع الكلي ≈394 |

## الوصلات
- **J1 وJ2 وJ3:** شفّة تخرج من القسم السفلي للأعلى بطول 10، والخلوص 0.2 قطريًا. J1 تُفك، وJ2 وJ3 تُلصقان.
- **J4:** قاعدة المحرك على الغطاء ببرغيين M2.
- **حلقات الاختبار HB-191…194:** تُطبع قبل الأقسام لضبط الخلوص.

## الشاشة (من رسم الفريق)
- TFT بمقاس 1.69 بوصة (ST7789).
- اللوحة 34 × 49، والعرض 34 مستنتج. الزجاج 30 × 38. الثقوب Ø2، والمسافة بينها 30 × 45.
- تُثبَّت من الداخل بأربعة براغٍ M2.

## الكؤوس (من STL، ولا تُعدَّل لأنها معايرة)
- أنصاف كرات: القطر الخارجي Ø39 والداخلي Ø35. الحافة Ø40 بسمك 1.5.
- المراكز على دائرة Ø80 بزاوية 120° بينها، وقطر الدوران Ø120. الارتفاع بعد اللصق 40.
- النصف السفلي فيه حلقة محور Ø29/Ø25 بطول 13.5. النصف العلوي فيه مخروط من Ø27 إلى Ø8 بارتفاع 10.5.
- الوصلة Ø24 × 18، فيها ثقب محور Ø2 بعمق 5.
- الرأس المدبب Ø8 × 30 يُطبع منفصلًا ويُلصق.
- الدوران عكس عقارب الساعة عند النظر من أعلى (مستنتج من شكل الكؤوس).

## افتراضات تحتاج تأكيدًا
- العرض 34 للشاشة، والمساحة المضيئة 28 × 32.6.
- ثقوب اللوحة الخضراء وسمكها 1.6.
- مقاس فتحة الزر وسمك اللوح الذي تمسكه مشابكه (الجدار مرقّق حوله إلى 1.6).
- طول الموتور البارز تقريبي.
- الزر يقطع خط 5V، ويحتاج لوحة USB صغيرة إذا كان الكيبل يدخل في منفذ ESP32 مباشرة.

## مفتوح
- تفاصيل النقش على أسطوانة الزخارف: بارز أم محفور، والعمق، وعدد التكرارات على المحيط 596.9.
