SARAHXL1/Expo2023-HABOOB/hardware/3d-models/هبوب - شبك التهوية وتعديل حساس الرياح/اقرأني.md

# هبوب: شبك التهوية وتعديل حساس الرياح

13 أكتوبر 2026 · ملف منفصل يكمّل حزمة «هبوب - ملفات الطباعة B.4» · الوحدة مم

## ما في هذا الملف

```
1 - شبك فتحات التهوية/
    HB-111 شبك فتحة تهوية طويلة.3mf          تحتاج 22 قطعة
    HB-112 شبك فتحة تهوية قصيرة.3mf          تحتاج 5 قطع
    لوح طباعة كامل - 22 شبك طويل و5 قصيرة.3mf    الـ 27 قطعة مرتبة على سرير واحد
2 - حساس الرياح/
    HB-195 قطعة اختبار ثقب عمود الموتور.3mf
    HB-200 مجموعة الكؤوس - ثقب 1 الأضيق.3mf
    HB-200 مجموعة الكؤوس - ثقب 2 المقترح.3mf
    HB-200 مجموعة الكؤوس - ثقب 3 الأوسع.3mf
صور للمراجعة/
STL/          القطع نفسها بالمجلدات نفسها (اللوح الكامل في 3MF فقط)
```

ملفات HB-200 هنا تحل محل ملف HB-200 في حزمة B.4. بقية القطع لم تتغير.

## 1 - شبك فتحات التهوية

**الوظيفة:** غطاء شبكي سداسي لكل فتحة تهوية في حجرة الحساسات HB-110. يمنع الحشرات والأوساخ والأصابع، ويبقى الهواء يمر إلى الحساس. يُركّب ويُفك باليد، ولا يحتاج تعديلًا في HB-110.

- **HB-111 شبك طويل:** للفتحات الـ 22 الطويلة.
- **HB-112 شبك قصير:** للفتحات الـ 5 القصيرة في الخلف، فوق فتحة الكيبل وزر التشغيل.
- **فتحة الكيبل وفتحة الزر بلا شبك،** لأنهما مستخدمتان.

**طريقة العمل:**
- **الوجه:** لوح أمامي بخلايا سداسية مقاسها 3.6 مم، وحافة بعرض 1.6 تجلس على سطح الجدار.
- **التثبيت:** خلف الوجه طوق يدخل الفتحة بعمق 2 مم، وعليه أربعة نتوءات صغيرة تمسكه بالاحتكاك. النتوءات مستدقة: أول الإدخال سهل، وآخره محكم.
- **الحز:** في الطرف السفلي من الحافة حز صغير للفك.

**التركيب والفك:**
- **التركيب:** اجعل الحز للأسفل، وادفع الشبك بالإبهام حتى تجلس الحافة على الجدار.
- **الفك:** ضع ظفرك أو مفكًا مسطحًا صغيرًا في الحز وارفع.

**الطباعة:**
- كما هي في الملف: الوجه على السرير، والطوق للأعلى، بلا دعامات.
- **ابدأ بشبك طويل واحد** وجرّبه في HB-110 المطبوع. إن ناسب، فاطبع اللوح الكامل.
- **إن كان ضيقًا أو واسعًا** فأخبرني، وأعدّل الخلوص في الملف كله.

**أثره على التهوية:** كل شبك يترك قرابة 60% من مساحة الفتحة مفتوحة، فتقل التهوية الكلية قرابة 40%. هذا يؤثر مباشرة على قراءة الحرارة والرطوبة. يُنصح بتجربة قصيرة: قارن قراءة الحساس بالشبك ومن دونه بجانب ميزان حرارة مرجعي.

## 2 - حساس الرياح: ثقب عمود الموتور

**المشكلة:** الثقب السابق مصمم Ø2.0، والثقوب الصغيرة تخرج في الطباعة أضيق من التصميم، فلم يدخل عمود الموتور (Ø2).

**التصميم الجديد للثقب:**
- **مدخل مشطوف:** Ø3.4، ليبدأ العمود بسهولة.
- **تجويف واسع Ø2.4،** وفيه ثلاثة أضلاع رفيعة بطول الثقب. الأضلاع وحدها تلمس العمود وتنضغط عليه، فيكون الإدخال بدفعة يد والإخراج أصعب قليلًا.
- **العمق 5،** وطرف الثقب مدبب فلا يحتاج دعامات داخله.
- **الأضلاع في الخيارات الثلاثة:** تضيّق الثقب إلى Ø1.85 في ثقب 1، وØ1.95 في ثقب 2، وØ2.05 في ثقب 3.

**الخطوات:**
1. **اطبع HB-195 قطعة الاختبار** (34 × 12 × 7). فيها الثقوب الثلاثة، وبجانب كل ثقب نقاط برقمه: نقطة لثقب 1، ونقطتان لثقب 2، وثلاث لثقب 3.
2. **جرّب عمود الموتور في كل ثقب.** اختر الثقب الذي يدخل فيه العمود بدفعة يد ولا يخرج بسحب خفيف.
3. **اطبع ملف HB-200 بالرقم نفسه.** الكؤوس تُطبع كما في B.4: قائمة، مع دعامات شجرية.

**إن كانت الثلاثة كلها ضيقة أو كلها واسعة،** فأخبرني بالنتيجة، وأزيح المدى كله.

## ملاحظات

- **قاعدة المحرك HB-104 لم تتغير.** إن وجدتم فتحتها Ø20 ضيقة على الموتور، فأعالجها بالطريقة نفسها.
- **أرقام القطع الجديدة مقترحة:** HB-111 وHB-112 وHB-195، وتُعتمد بعد موافقتكم.
- **التحقق:** القطع مغلقة وسليمة. قُرئت كل ملفات 3MF بالمكتبة المرجعية دون تحذيرات. ركّبت الشبك على نموذج HB-110 رقميًا في الفتحات الـ 27: الحافة تجلس على الجدار، ولا يدخل شيء داخل الحجرة، ولا تتلامس شبكتان.
