SARAHXL1/Expo2023-HABOOB/hardware/3d-models/هبوب - ملفات الطباعة B.4/اقرأني.md

# هبوب: ملفات الطباعة، الإصدار B.4

12 أكتوبر 2026 · من نموذج Onshape B.4 (HabubB4Structure) · الوحدة مم

## ترتيب المجلدات

```
هبوب - ملفات الطباعة B.4/
├── 1 - حلقات اختبار الخلوص (اطبعها أولًا)/   HB-191 إلى HB-194
├── 2 - الهيكل/                                HB-110 و HB-120 و HB-130
├── 3 - أسطوانة الزخارف/                       HB-140 (4 ألوان)
├── 4 - حساس الرياح/                           HB-104 و HB-200
├── صور للمراجعة/
└── STL/                                       نسخة احتياطية بالمجلدات نفسها
```

- **أرقام المجلدات:** تتبع ترتيب الطباعة المقترح.
- **رقم القطعة:** كل ملف يبدأ برقمه (HB-xxx)، وهو الرقم نفسه في Onshape ومستند المواصفات.
- **حساس الرياح:** صار قطعتين فقط، هما قاعدة المحرك HB-104 ومجموعة الكؤوس HB-200 قطعة واحدة. حُذفت الأجزاء المفصولة HB-201 وHB-202 وHB-203 وHB-204.

## طريقة الاستخدام

- **الطابعة:** Bambu Lab A1 أو P1S أو X1C (سرير 256 × 256).
- **الملفات:** ملف 3MF لكل قطعة، في منتصف السرير وباتجاه الطباعة الصحيح، فلا تحتاج تدويرًا.
- **الألوان:** كل القطع بيضاء، ما عدا HB-140.
- **HB-140:** جسم واحد من 4 أجزاء: 1 أحمر (الجسم والغطاء كاملين)، 2 أبيض، 3 أخضر، 4 أسود.
  - إن ظهرت نافذة ربط الألوان عند فتح الملف في Bambu Studio، فاربط كل لون بخانته في الـ AMS.
  - إن لم تظهر، فغيّر خيط كل جزء يدويًا من قائمة الأجسام بالترتيب نفسه.
- **مجلد STL:** للطابعات أو البرامج التي لا تقرأ 3MF. أسطوانة الزخارف فيه 4 ملفات، ملف لكل لون:
  - اسحبها معًا إلى Bambu Studio.
  - ثم وافق على رسالة «Load these files as a single object with multiple parts?».

## القطع

| المجلد | الملف | المقاس (مم) | الوضع على السرير | الدعامات |
|---|---|---|---|---|
| 1 | HB-191 إلى HB-194 حلقات الاختبار | حتى Ø190 × 18 | كما هي | لا |
| 2 | HB-110 حجرة الحساسات | Ø150 × 113.2 | القاعدة على السرير | لا. سقف فتحة الكيبل جسر بطول 40، وقد يترهل قليلًا |
| 2 | HB-120 العمود | Ø130 × 110 | الطرف السفلي على السرير، والشفّة للأعلى | نعم، من السرير فقط، تحت قاعدة الشاشة الداخلية |
| 2 | HB-130 الوصلة الكبيرة | Ø190 × 13 | القرص على السرير | لا |
| 3 | HB-140 أسطوانة الزخارف | Ø190 × 100 | مقلوبة، والغطاء على السرير | لا |
| 4 | HB-104 قاعدة المحرك | Ø40 × 20 | القاعدة العريضة على السرير | لا |
| 4 | HB-200 مجموعة الكؤوس | 99.5 × 106 × 60.5 | قائمة، وأسفل الكؤوس على السرير | نعم، دعامات شجرية تلقائية (انظر أدناه) |

## HB-200 مجموعة الكؤوس، قطعة واحدة

- **القطعة:** الكؤوس الثلاث والصفيحة والمحور والمخروط والرأس المدبب كلها جسم واحد، فلا تحتاج لصقًا.
- **الربط مع الموتور:** المحور مصمت، وفيه بروز Ø8 وثقب عمود الموتور Ø2 بعمق 5.
- **الدعامات لا مفر منها في أي اتجاه،** وتلزم في هذه المواضع:
  - تحت الكؤوس.
  - تحت الصفيحة، على ارتفاع 19 فوق السرير.
  - تحت المحور.
  - داخل قبة كل كأس. هذه الدعامات تقوم على القطعة نفسها، فلا تختر «On build plate only».
- **أثرها على القياس:** سطح الكؤوس يكون أخشن مكان الدعامات. معايرة الحساس تكون على القطعة المطبوعة نفسها.

## HB-140 بأربعة ألوان

- **عدد تبديلات الخيط:** قرابة 640 بطبقة 0.2، وقرابة 460 بطبقة 0.28. هذا تقدير، والعدد الفعلي يحدده برنامج التقطيع.
- **الهدر:** خيار «Flush into objects' infill» يقلّل هدر التنظيف.
- **البديل السريع:** اطبع الجزء الأحمر وحده، ثم لُفّ عليه ملصقًا مطبوعًا بالنقش بمقاس 596.9 × 100.

## التحقق

- **الحجوم:** حجم كل قطعة يطابق Onshape B.4 بفرق أقل من 0.06%.
- **سلامة الملفات:** كل الشبكات مغلقة ومتسقة الاتجاه، وقُرئت كل ملفات 3MF بالمكتبة المرجعية lib3mf في الوضع الصارم دون تحذيرات.
- **صور للمراجعة:** فيها النقش مفرودًا كما قُرئ من الملف، ومقطع في مجموعة الكؤوس.

## ملاحظات

- **مسافة ثقوب اللوحة الخضراء في HB-110:** 85 × 65 افتراض، قيسوها على اللوحة الفعلية قبل الطباعة.
- **مخطط الصفيحة في HB-200:** مأخوذ من رسم اللوحة 8، لأن ملف DXF الأصلي غير متوفر.
