SARAHXL1/Expo2023-HABOOB/src/05_docs/مطابقة-المتطلبات.md

# مطابقة المتطلبات — الإصدار 2

أين نُفّذ كل معرّف من ملف «متطلبات موقع اختبار الحساسات» **الإصدار 2**
(5 أكتوبر 2026). استخدم هذا الجدول عند مراجعة ما تم تنفيذه.

**الحالة:** ✅ منفّذ ومُختبر آليًا · 🔧 منفّذ، ويحتاج اختبارًا على العتاد

---

## برنامج العقدة (FW)

الملف: `01_firmware_esp32/sensor_node/sensor_node.ino`

| المعرّف | المتطلب | الحالة | أين |
|---|---|---|---|
| FW-01 | فحص I2C وتحديد حالة ADS1115 (0x48) وMLX90614 (0x5A) وVEML7700 (0x10) | 🔧 | `scanI2C()` |
| FW-02 | إعداد `ENABLE_GLOBE` مطفأ؛ وعند إطفائه تُرسل `ds18b20` و`battery` بحالة `disabled` | ✅ | `#define ENABLE_GLOBE 0` · `buildJson()` |
| FW-03 | حالة DHT22 تُحدد من أول قراءة (NaN ⇒ `read_error`) | 🔧 | `readDht()` |
| FW-04 | قراءة جهد الموتور كل 100 ملي ثانية وإرسال المتوسط | 🔧 | `sampleWind()` · `WIND_SAMPLE_MS` |
| FW-05 | باقي الحساسات كل 5 ثوانٍ، وDHT22 لا أسرع من ثانيتين | 🔧 | `loop()` · `max(DHT_MIN_MS, SENSOR_READ_MS)` |
| FW-06 | إرسال كل 5 ث في الاختبار، وكل 60 ث في القياس الطويل | 🔧 | `TEST_MODE` · `sendInterval()` |
| FW-07 | الإرسال بالطريقتين معًا: HTTP وسطر `DATA:` على USB | 🔧 | `sendMessage()` |
| FW-08 | عند فشل الواي فاي يستمر القياس وUSB، ويعيد المحاولة كل 30 ث | 🔧 | `wifiMaintain()` |
| FW-09 | لا انتظار طويل في الحلقة؛ جدولة مستقلة بالوقت | 🔧 | `loop()` كاملة بـ `millis()`، وDS18B20 بتحويل غير حاجز |
| FW-10 | شاشة 240×280: UTCI ولونها بخط كبير، ثم Ta وRH والرياح والاتصال، بهامش 20 بكسل | 🔧 | `drawScreen()` · `#define M 20` |
| FW-11 | قراءة UTCI وفئتها من رد الخادم وعرضها | 🔧 | `sendMessage()` · `srvUtci` · `srvStressKey` |
| FW-12 | كل الإعدادات في قسم واحد واضح أعلى البرنامج | ✅ | القسم المعنون «FW-12» |
| FW-13 | رسائل تشخيص مقروءة عند التشغيل | 🔧 | `setup()` |
| FW-14 | الوقت من NTP بتوقيت الرياض، وإلا يترك الخادم يضع وقت الاستلام | 🔧 | `configTime()` · `ts = null` عند التعذر |

## عقد البيانات (DS)

| المعرّف | القاعدة | الحالة | أين |
|---|---|---|---|
| DS-01 | `schema` إلزامي — رُفع إلى **3** | ✅ | `SCHEMA_VER = 3` · `processing.validate()` |
| DS-02 | القيمة غير المتوفرة تُرسل `null` | ✅ | `putNum()` في العقدة · `_num()` في الخادم |
| DS-03 | الوحدات ثابتة في أسماء الحقول | ✅ | `settings.SENSOR_CATALOG` · `config.json → ranges` |
| DS-04 | العقدة ترسل القيم الخام ولا تحسب UTCI | ✅ | العقدة لا تستورد أي حساب؛ الحساب في `calculations.py` |
| DS-05 | رسالة USB بنفس JSON مع البادئة `DATA:` | ✅ | `sendMessage()` · `serial_bridge.PREFIX` |
| DS-06 | قبول الحقول غير المعروفة وتجاهلها | ✅ | `build_sensor_states()` · مُختبر في `acceptance_test.py` |

## الخادم (SV)

الملفات: `02_server_backend/`

| المعرّف | المتطلب | الحالة | أين |
|---|---|---|---|
| SV-01 | استقبال من الواي فاي ومن جسر USB بنفس الصيغة | ✅ | `app.ingest()` — مسار واحد للجميع |
| SV-02 | التحقق من الرسالة ورفض المعطوبة بسبب واضح وتسجيلها | ✅ | `processing.validate()` · `storage.save_rejected()` |
| SV-03 | وقت الاستلام بدل `ts` غير المنطقي | ✅ | `processing.resolve_timestamp()` |
| SV-04 | فحص المدى المنطقي وتحويل `ok` إلى `out_of_range` | ✅ | `processing.range_check()` |
| SV-05 | `stale` بعد 30 ث، والعقدة غير متصلة بعد 15 ث | ✅ | `processing.apply_staleness()` · `NodeState.is_online()` |
| SV-06 | الفحوص المنطقية وإخراج قائمة تنبيهات نصية | ✅ | `processing.run_checks()` |
| SV-07 | حساب القيم المشتقة وتخزينها مع الرسالة | ✅ | `calculations.derive()` · `storage.save_reading()` |
| SV-08 | تخزين الرسالة كما وصلت مع المشتقات في SQLite | ✅ | `storage.save_reading()` — `raw_json` لا يُعدّل |
| SV-09 | تقديم واجهات للوحة | ✅ | `app.Handler` |
| SV-10 | تصدير CSV بعمود لكل قيمة وعمود لكل حالة | ✅ | `storage.export_csv()` |
| SV-11 | الاستماع على `0.0.0.0` على منفذ ثابت | ✅ | `config.json → server.host/port` |
| SV-12 | طباعة عناوين IP الخاصة باللابتوب عند التشغيل | ✅ | `app.local_ips()` — وتظهر أيضًا في «أدوات» باللوحة |
| SV-13 | وضع محاكاة مع خيار محاكاة الأعطال | ✅ | `simulator.py` |
| SV-14 | ملف إعدادات واحد، وفيه **مصدر MRT** | ✅ | `config.json` · `mrt_source` |
| SV-15 | حفظ معاملات المعايرة وإعادة حساب `wind_ms` منها | ✅ | `app._api_calibration()` · `calculations.wind_from_voltage()` |

## الحسابات (CA)

الملف: `02_server_backend/calculations.py`

| المعرّف | الحساب | الحالة | أين |
|---|---|---|---|
| CA-01 | سرعة الرياح عند 10 م | ✅ | `wind_at_10m()` · `scale_wind_speed_log` |
| CA-02 | MRT: **مفترضة = حرارة الهواء**، ومن الكرة عند التفعيل | ✅ | `derive()` · `mean_radiant()` |
| CA-03 | UTCI وفئة الإجهاد | ✅ | `utci_value()` · `STRESS_BANDS` |
| CA-04 | حماية المدى وعلامة «رياح مقيّدة» | ✅ | `derive()` · `config.json → utci_limits` |
| CA-05 | نسبة البطارية — **مؤجلة**، وتعود تلقائيًا مع أول قراءة `bat_v` | ✅ | `battery_percent()` |
| CA-06 | تصحيح الكرة — عند تفعيل الكرة فقط | ✅ | `derive()` · `globe_offset_c` |
| CA-07 | القيم الأساسية: ta وrh والرياح؛ وtg عند التفعيل | ✅ | `derive()` · `required` |

## اللوحة (UI)

الملفات: `04_dashboard_web/`

| المعرّف | المتطلب | الحالة | أين |
|---|---|---|---|
| UI-01 | تحديث كل ثانيتين بلا إعادة تحميل | ✅ | `app.js` · `setInterval(tick, refresh)` |
| UI-02 | لا اعتماد على أي ملف من الإنترنت | ✅ | رسوم canvas يدوية وخطوط نظام — مُختبر آليًا |
| UI-03 | الحالة بالكلمة واللون معًا | ✅ | `.badge` فيها نص الحالة بالعربي |
| UI-04 | UTCI ≥ 48px والقيم الأخرى ≥ 20px | ✅ | `style.css` · UTCI 92px، والقيم 25px |
| 8.1 | شريط العقدة يعرض **مصدر الطاقة** بدل البطارية | ✅ | `renderNodebar()` · `#powerVal` |
| 8.1 | بطاقة UTCI تعرض MRT مع شارة **«مفترضة»** | ✅ | `renderUtci()` · `#mrtBadge` |
| 8.1 | الرسوم: Ta والرطوبة وUTCI والرياح وجهد الموتور | ✅ | `CHART_DEFS` |
| 8.1 | لوحة التشخيص بلا عدد مجسات DS18B20 | ✅ | `renderDiag()` |
| UI-05 | تعمل على متصفح الجوال | ✅ | `@media` عند 920px و560px |
| UI-06 | رسالة واضحة عند انقطاع الخادم | ✅ | `#offlineBanner` · `setServerOnline()` |
| UI-07 | وضع العرض يكبّر الأساسيات ويخفي التشخيص | ✅ | `body.present` · زر «وضع العرض» |
| UI-08 | اختيار العقدة من قائمة | ✅ | `#nodeSelect` |

## جسر USB (BR)

الملف: `03_usb_bridge/serial_bridge.py`

| المعرّف | المتطلب | الحالة | أين |
|---|---|---|---|
| BR-01 | إعادة فتح المنفذ تلقائيًا إن انفصل الكابل | ✅ | `run()` — حلقة إعادة الفتح |
| BR-02 | تجاهل الأسطر التي لا تبدأ بـ `DATA:` وطباعتها للتشخيص | ✅ | `run()` |
| BR-03 | تجاهل السطر المعطوب والاستمرار | ✅ | `run()` — `json.loads` داخل try |
| BR-04 | قبول المنفذ والسرعة وعنوان الخادم كمعطيات | ✅ | `argparse` |
| BR-05 | عرض المنافذ المتاحة إن لم يُحدَّد منفذ | ✅ | `show_ports()` · `guess_port()` |

## المتطلبات غير الوظيفية (NF)

| المعرّف | المتطلب | الحالة | ملاحظة |
|---|---|---|---|
| NF-01 | يعمل كاملًا بلا إنترنت | ✅ | بعد تثبيت المكتبتين مرة واحدة |
| NF-02 | يعمل على ويندوز وماك بأدوات Python فقط | ✅ | بلا إطار ويب؛ المكتبة القياسية فقط |
| NF-03 | التأخير من القياس للعرض أقل من 3 ثوانٍ | ✅ | إرسال كل 5 ث + تحديث لوحة كل 2 ث |
| NF-04 | تشغيل متواصل 12 ساعة بلا تضخم ذاكرة | ✅ | تنظيف دوري لقاعدة البيانات، وطوابير محدودة الطول |
| NF-05 | README يشرح التثبيت والتشغيل في أقل من 10 خطوات | ✅ | 6 خطوات |
| NF-06 | هيكل ملفات واضح وملف إعدادات واحد | ✅ | 6 مجلدات مرقّمة + `config.json` |
| NF-07 | الرسائل بالعربي وأسماء الحقول بالإنجليزي | ✅ | في كل الملفات |
| NF-08 | البيانات الخام لا تُعدّل بعد تخزينها | ✅ | `raw_json` يُخزَّن كما وصل؛ المشتقات في أعمدة منفصلة |

## معايير القبول (القسم 12)

| المعيار | الحالة |
|---|---|
| بطاقة لكل قطعة من الجدول 3.1 بحالتها الصحيحة | ✅ مُختبر آليًا |
| فصل حساس يحوّل بطاقته لحالة خطأ مع رسالة مساعدة خلال 10 ث | ✅ مُختبر آليًا |
| إطفاء العقدة يجعلها «غير متصلة» خلال 15 ث | ✅ مُختبر آليًا |
| حساب UTCI وفئته ولونها وعلامة «رياح مقيّدة» | ✅ مُختبر آليًا |
| الطريقتان: الواي فاي وUSB | ✅ الخادم والجسر مُختبران؛ العتاد ينتظر المرحلتين 1 و7 |
| وضع المحاكاة يعمل بلا أي عتاد | ✅ مُختبر آليًا |
| تصدير CSV يُفتح في الإكسل بأعمدة واضحة | ✅ مُختبر آليًا |
| كل شيء يعمل بلا إنترنت | ✅ مُختبر آليًا |
| **MRT مفترضة والقطع المؤجلة بحالة disabled** (جديد في الإصدار 2) | ✅ مُختبر آليًا |
| **تفعيل الكرة الحرارية بإعداد واحد** (جديد في الإصدار 2) | ✅ مُختبر آليًا |

```bash
python3 06_tools/acceptance_test.py    # 47 بندًا
```

---

## إضافات خارج نص المتطلبات

أُضيفت لأن الفريق طلبها، ولا تتعارض مع أي معرّف:

| الإضافة | السبب |
|---|---|
| المفتاح الواحد `mrt_source` | معيار القبول الجديد ينص على تفعيل الكرة بإعداد واحد؛ فجعلناه يقود كل شيء: البطاقة والفحوص والتصحيح والقيم الأساسية |
| مفتاح وضعين: العتاد الحقيقي والمحاكاة | فصل قاطع بين القراءات الحقيقية والوهمية أثناء التجميع |
| حالة عرض `not_connected` «غير متصل» | في وضع العتاد قبل وصول أول رسالة، تظهر كل البطاقات بدل صفحة فارغة. حالة عرض فقط، ولا ترسلها العقدة، فالحالات السبع في الجدول 3.2 باقية كما هي |
| معرّفات `sim-01` و`sim-02` لعقد المحاكاة | تمنع اختلاط بيانات المحاكاة ببيانات `node-01` الحقيقية في قاعدة البيانات والرسوم |
| انتقال تلقائي لمنفذ بديل | المنفذ 5000 يحجزه «مستقبل AirPlay» على ماك |

## خارج النطاق (كما نص القسم 1.3)

لم يُنفَّذ عمدًا، لأنه يخص المنصة لا موقع الاختبار:

- نموذج التقدير بين الأعمدة، والتوقع، والتوصيات، وحلقة الكفاءة
- تسجيل الدخول والصلاحيات
- الاستضافة على الإنترنت
