SARAHXL1/Expo2023-HABOOB/docs/requirements/تحديثات ملف المتطلبات - من الإصدار 1 إلى 2.docx

تحديثات ملف متطلبات موقع الاختبار — من الإصدار 1 إلى الإصدار 2

مشروع هاكثون إكسبو 2030 الرياض · تحدي 2.3

المشروع | هبوب — عقدة استشعار الراحة الحرارية، تحدي 2.3، هاكثون إكسبو 2030 الرياض
نوع المستند | سجل التغييرات
يقارن بين | «متطلبات موقع اختبار الحساسات والقطع» الإصدار 1 (4 أكتوبر 2026) والإصدار 2 (5 أكتوبر 2026)
الحالة | مسودة

# 1. أسباب التحديث

1. تغيّر اسم المشروع إلى هبوب.
2. تأجيل الكرة الحرارية (DS18B20)، لأن التقييم داخل القاعة وليس في الشمس.
3. وصل حساس الضوء VEML7700 بدل BH1750.
4. وصلت شاشة 1.69 بوصة بدل شاشة 2.0 بوصة.
5. صارت التغذية من USB مباشرة بدل دائرة البطارية.

# 2. التغييرات حسب أقسام الملف

القسم | الإصدار 1 | الإصدار 2
العنوان والترويسة | منظومة الراحة الحرارية | هبوب، ومرجعه «دليل بناء عقدة هبوب» الإصدار 2
جديد: جدول «التغييرات في الإصدار 2» | غير موجود | أُضيف في أول الملف
1.2 داخل النطاق | حساب MRT من الكرة | MRT مفترضة تساوي حرارة الهواء، وقابلة للتحويل إلى قياس من الكرة لاحقًا
3.1 القطع | bh1750 على 0x23 | veml7700 على 0x10
3.1 القطع | ds18b20 تعمل | ds18b20 مؤجلة (disabled)
3.1 القطع | battery على A1 | battery مؤجلة (disabled)
3.1 القطع | ads1115 يقرأ الموتور والبطارية | يقرأ الموتور فقط
3.1 القطع | شاشة ST7789 | شاشة 1.69 بوصة ST7789V2
3.2 الحالات | disabled مثالها BH1750 | مثالها DS18B20 والبطارية
3.2 الحالات | assumed للشاشة فقط | assumed للشاشة، ولقيمة MRT المفترضة
3.3 المدى | lux حتى 120,000 | lux حتى 140,000، وهو حد VEML7700 في ملف المواصفات
3.3 المدى | tg_c وbat_v مفعّلتان | عند التفعيل فقط
3.4 الفحوص | CK-01 وCK-05 مفعّلان | عند تفعيل الكرة فقط
3.4 الفحوص | CK-04: تشبع BH1750 عند 65,535 | CK-04: lux ثابت عند الصفر في مكان مضاء (تحقق من VEML7700)
3.4 الفحوص | CK-06: تحقق من المكثف والمحول | CK-06: غيّر كابل USB أو المنفذ، أو ركّب المكثف
4.1 FW-01 | عناوين ADS1115 وMLX90614 وBH1750 | 0x48 و0x5A و0x10 (VEML7700)
4.1 FW-02 | عدّ مجسات DS18B20 | إعداد جديد ENABLE_GLOBE مطفأ. عند إطفائه تُرسل ds18b20 وbattery بحالة disabled
4.1 FW-10 | الشاشة تعرض الكرة والبطارية | شاشة 240×280: UTCI ولونها بخط كبير، ثم Ta وRH والرياح والاتصال، مع هامش 20 بكسل للزوايا الدائرية
4.2 المكتبات | BH1750 (Christopher Laws) | Adafruit VEML7700 Library؛ ومكتبات DS18B20 عند التفعيل فقط
4.3 العتاد | A1 للبطارية مع الكسب GAIN_ONE | A1 غير مستخدم
4.3 العتاد | — | أضيفت قائمة عناوين I2C المتوقعة
4.3 العتاد | الشاشة: الأطراف فقط | ST7789V2 بدقة 240×280، مع التحقق من الدقة والإزاحة
4.3 العتاد | — | أضيف أن التغذية USB بجهد 5V
5.1 رسالة JSON | schema 2 | schema 3، والإصدار fw 0.3.0
5.1 رسالة JSON | — | حقل جديد power_source = "usb"
5.1 رسالة JSON | قائمة I2C: 0x23 و0x48 و0x5A | 0x10 و0x48 و0x5A
5.1 رسالة JSON | ds18b20 وbattery بقيم | disabled مع null
5.1 رسالة JSON | bh1750 | veml7700
5.3 رد الخادم | utci وmrt وغيرها | أضيف حقل mrt_source (assumed أو globe)
6.1 SV-14 الإعدادات | قطر الكرة وانبعاثيتها | أضيف مصدر MRT (assumed أو globe)
7 CA-02 حساب MRT | من الكرة بمعادلة ISO | الآن MRT = Ta بحالة assumed؛ ومعادلة الكرة عند التفعيل
7 CA-05 البطارية | مفعّل | مؤجل
7 CA-06 تصحيح الكرة | مفعّل | عند تفعيل الكرة
7 CA-07 القيم الأساسية | ta وrh وtg والرياح | ta وrh والرياح؛ وtg عند التفعيل
8.1 شريط العقدة | البطارية بالنسبة والجهد | مصدر الطاقة (USB)
8.1 بطاقة UTCI | MRT | MRT مع شارة «مفترضة»
8.1 الرسوم | Ta وTg وMRT وUTCI والرياح والبطارية | Ta والرطوبة وUTCI والرياح وجهد الموتور
8.1 التشخيص | فيه عدد مجسات DS18B20 | أزيل
8.4 رسائل الأعطال | DHT22: مقاومة 10kΩ | تحقق من OUT والتغذية (الوحدة فيها المقاومة)
8.4 رسائل الأعطال | MLX90614: نسخة الجهد | التغذية ولحام الأطراف
8.4 رسائل الأعطال | BH1750 على 0x23 | VEML7700 على 0x10: VIN وSDA وSCL ولحام الأطراف
8.4 رسائل الأعطال | رسالة البطارية موجودة | حُذفت
8.4 رسائل الأعطال | العقدة غير متصلة: الطاقة | كابل USB والطاقة
9.3 مقارنة الطريقتين | الطاقة من بطارية العمود | من محول USB أو باور بانك
10 المرحلة 3 | إضافة DS18B20 | التحقق أن القطع المؤجلة disabled، وMRT «مفترضة»
10 المرحلة 5 | MLX90614 وBH1750 (0x23) | MLX90614 وVEML7700 (0x10)
10 المرحلة 6 | الشاشة تعرض القيم | تعرض بالمقاس 240×280 دون إزاحة أو قص
10 المرحلة 8 | دائرة البطارية وفصل المحول | استقرار التغذية من USB لمدة 30 دقيقة
10 المرحلة 10 | المصباح يرفع Tg وUTCI | المروحة فقط، وMRT «مفترضة»
12 معايير القبول | — | أضيف معياران: MRT مفترضة والقطع المؤجلة disabled؛ وتفعيل الكرة بإعداد واحد
13 النص الجاهز | عام | يذكر هبوب والقطع الفعلية وschema 3، والمعرّفات FW
ملاحظة البداية | المعرّف FR-01 | تصحيح إلى FW-01

# 3. ما لم يتغير

- البنية العامة: برنامج العقدة، وجسر USB، والخادم، ولوحة العرض.
- طريقتا الربط: الواي فاي وكابل USB، وخطواتهما.
- واجهات الخادم (API).
- ألوان فئات UTCI.
- حساب الرياح عند 10 م، وحد 0.5 م/ث الأدنى.
- المتطلبات غير الوظيفية NF-01 إلى NF-08.
- متطلبات الجسر BR-01 إلى BR-05.

# 4. لإعادة الكرة الحرارية لاحقًا

1. وصّل DS18B20 على GPIO 13، مع مقاومة 4.7kΩ.
2. شغّل الإعداد ENABLE_GLOBE في برنامج العقدة.
3. غيّر مصدر MRT في إعدادات الخادم إلى globe.
4. نفّذ المعايرة: قارن حساس الكرة مع DHT22 في الظل، وسجّل الفرق كمعامل تصحيح.

تحديثات ملف المتطلبات — هبوب
