SARAHXL1/Expo2023-HABOOB/docs/data-science/هبوب_دليل_علم_البيانات_v3.docx

هبوب

HABOOB · Expo 2030 Riyadh Challenge 2.3

الدليل المرجعي لمسار علم البيانات والذكاء الاصطناعي

الحد الأدنى اللازم للنموذج الأولي، ومعه التحسينات المقترحة

البند | القيمة
نوع الوثيقة | وثيقة مرجعية تقنية (Technical Reference)
المشروع | هبوب — منظومة ترصد الإحساس الحراري في المساحات الخارجية لإكسبو 2030 الرياض
المؤشر المعتمد | حرارة الكرة والبصيلة الرطبة (WBGT) وفق المعيار ISO 7243:2017
النطاق | نموذج أولي للهاكثون: أقل بيانات وأقل جهد برمجي يثبت الفكرة
القالب المستخدم | لا يوجد قالب رسمي لهذا النوع من الوثائق؛ هيكل مقترح
الجمهور | ريناد العوفي (علم البيانات والذكاء الاصطناعي)، ثم بقية الفريق التقني
الإصدار والتاريخ | الإصدار 3.0 · 12 أكتوبر 2026 (يحل محل الإصدار 2.0)
الحالة | مسودة للمراجعة (Draft)

المحتويات

ملاحظة: إذا ظهر الفهرس فارغًا، اضغط عليه بالزر الأيمن في Word واختر «تحديث الحقل».

# 1. الملخص: ما الأساسي وما التحسين

هذه النسخة مبنية على قاعدة واحدة: في كل جزء نأخذ أبسط ما يثبت الفكرة ويعمل يوم العرض، وكل ما عداه يُذكر كتحسين مقترح. كل جدول في الوثيقة فيه عمود يوضح أي البنود أساسية وأيها تحسين.

الجزء | الأساسي فقط | التحسين المقترح
الحساسات | DHT22، والكؤوس عبر ADS1115، وVEML7700 | حرارة السطح، والكرة السوداء، وحساس إشعاع حقيقي
المؤشر | WBGT بدالة جاهزة واحدة (Liljegren) وعلم الخطر | عرض Tnw وTg منفصلتين، وتصحيح الملابس CAV
البيانات من خارج الحساسات | ثوابت: ضغط الهواء، والموقع، ومعامل الإضاءة، وحالة الزائر | خصائص المناطق، والفعاليات، وحالة الأجهزة
التخزين | الجدول الموجود readings، مع إضافة wbgt_c وflag | جدول متوسطات الدقيقة، وجداول منفصلة
التحليلات | 8 تحليلات: الحساب، العلم، المؤشرات، حالة العمود، التفسير، التوصية، أثرها، التوقع | 16 تحليلًا إضافيًا، منها نماذج التعلم الآلي
التوقع | توقع الطقس من Open-Meteo يُحوَّل إلى WBGT بالدالة نفسها، بلا تدريب | نموذج تعلم آلي يصحح التوقع محليًا

أين الذكاء الاصطناعي في الحد الأدنى؟ القرار التشغيلي مبني على معادلة فيزيائية وقواعد شفافة، والتوقع مأخوذ من نموذج طقس عالمي. نموذج التعلم الآلي المدرَّب هو أول تحسين مقترح (القسم 7.3)، ويُبنى إذا بقي وقت بعد اكتمال الأساسي.

# 2. الحساسات المرتبطة بالمؤشر

في العقدة ثلاثة حساسات تغذي معادلة WBGT. هذه هي البيانات الوحيدة التي يحتاجها الحد الأدنى:

الحساس | ما يقيسه | الحقل في الرسالة | الوحدة | دوره في WBGT
DHT22 | حرارة الهواء Ta | sensors.dht22.ta_c | °C | يدخل مباشرة بوزن 10%، ويدخل في حساب Tnw وTg
DHT22 | الرطوبة النسبية RH | sensors.dht22.rh_pct | % | أهم مدخل في Tnw (وزنه 70%)
الكؤوس مع محرك DC عبر ADS1115 | جهد يتحول إلى سرعة رياح | sensors.anemometer.wind_v | V ثم m/s | الرياح تبرّد الكرة وتزيد التبخر، فتؤثر في Tg وTnw
VEML7700 | شدة الإضاءة | sensors.veml7700.lux | lux | تتحول إلى إشعاع شمسي W/m²، وهو أكبر مدخل في Tg

سرعة الرياح = K × الجهد + B، والمعاملان K وB من معايرة الكؤوس ومحفوظان في config.json. الرسالة تُرسل كل 5 ثوانٍ، والكؤوس على ارتفاع 1.8 م.

### للعلم فقط: مكونات مرتبطة بالمؤشر خارج الحد الأدنى

المكوّن | ما يضيفه | البديل في الحد الأدنى
MLX90614 (مفصول حاليًا) | حرارة سطح الأرضية، لتمييز الأسطح الساخنة وللتقدير المكاني | لا يحتاجه حساب WBGT
الكرة السوداء DS18B20 (مؤجلة) | Tg مقاسة مباشرة بدل حسابها | Tg تُحسب من الإشعاع والرياح والحرارة
ترمومتر البصيلة الرطبة الطبيعية (غير مدرج) | Tnw مقاسة مباشرة | Tnw تُحسب من الحرارة والرطوبة والرياح والإشعاع

# 3. وصول البيانات وتخزينها

## 3.1 المسار

# | الخطوة | أين | ماذا يحدث

1 | القراءة | العقدة ESP32 | تقرأ الحساسات وتحسب متوسط جهد الكؤوس
2 | الإرسال | العقدة ← الخادم | رسالة JSON واحدة كل 5 ثوانٍ، بطلب HTTP POST إلى ‎/api/readings على المنفذ 5050 عبر هوتسبوت الجوال
3 | التخزين | app.py ← data/readings.db | الخادم يحفظ الرسالة في جدول readings
4 | الحساب | الخادم | يحسب الرياح من الجهد، ثم WBGT والعلم، ويحفظهما مع الرسالة نفسها
5 | العرض والتحليل | اللوحة وكود التحليل | اللوحة تعرض القيم الحية، وكود التحليل يقرأ الجدول نفسه

## 3.2 التخزين: نستخدم الجدول الموجود

الخادم يحفظ كل رسالة صفًا في الجدول readings داخل قاعدة SQLite المحلية. الحد الأدنى لا يضيف جداول جديدة؛ يضيف فقط حقلين داخل نتيجة الحساب المحفوظة مع كل رسالة:

عمود في readings | محتواه | التعديل في الحد الأدنى
node_id | معرّف العمود (node-01) | لا شيء
rx_ts | وقت الاستلام (epoch) | لا شيء
raw_json | الرسالة كما وصلت من العقدة | لا شيء
derived_json | ما حسبه الخادم | إضافة wbgt_c وflag (وwbgt_method)

إعداد واحد ضروري: الإعداد history_keep_minutes في config.json يحدد مدة الاحتفاظ بالقراءات (180 دقيقة الآن). يُرفع إلى 1,440 دقيقة (يوم) أو أكثر إذا أردنا تحليل يوم كامل. وقبل إيقاف الخادم يمكن التصدير من «أدوات ← تصدير CSV».

## 3.3 كيف يقرأ كود التحليل البيانات

دالة واحدة تقرأ الجدول وتحوّله إلى جدول pandas: صف لكل رسالة، ثم متوسط كل دقيقة لكل عمود. متوسط الدقيقة هو الصيغة التي تعمل عليها كل التحليلات:

import json, sqlite3

import pandas as pd

def load_readings(db="data/readings.db"):

"""Read stored messages into one table: one row per message, then 1-minute means per node."""

con = sqlite3.connect(f"file:{db}?mode=ro", uri=True)

rows = con.execute("select rx_ts, node_id, raw_json, derived_json from readings order by id").fetchall()

recs = []

for rx, node, raw, der in rows:

s = json.loads(raw)["sensors"]

d = json.loads(der or "{}").get("derived", {})

recs.append({"ts": pd.to_datetime(rx, unit="s") + pd.Timedelta(hours=3), "node_id": node,

"ta_c": s["dht22"]["ta_c"], "rh_pct": s["dht22"]["rh_pct"],

"wind_v": s["anemometer"]["wind_v"], "lux": s["veml7700"]["lux"],

"wbgt_c": d.get("wbgt_c"), "flag": d.get("flag")})

df = pd.DataFrame(recs)

per_min = (df.set_index("ts").groupby("node_id")

.resample("1min").mean(numeric_only=True).reset_index())

return df, per_min

الكود جُرّب على قاعدة تجريبية بالبنية نفسها، ولم يُجرَّب بعد على قاعدة الفريق الفعلية.

## 3.4 جودة البيانات في الحد الأدنى

فحصان فقط، وكلاهما موجود فعليًا في المنظومة: الخادم يرفض القيم الخارجة عن المدى المحدد في config.json، والقيمة الفارغة (null) لا تدخل في الحساب.

تحسين مقترح: كشف القفزات المفاجئة، والقيم الثابتة لفترة طويلة، وسد الفجوات القصيرة، ومقارنة الأعمدة ببعضها (القسم 7.3، ب1 وب2).

# 4. البيانات التي لا تأتي من الحساسات

أرقام الأثر محسوبة على حالة ظهر أكتوبر في القسم 5.4 (WBGT = 29.1). الخلاصة: لا يوجد بند خارجي يمنع حساب WBGT، وكل البنود الأساسية ثوابت تُكتب مرة واحدة في الإعدادات.

البيان | النوع | القيمة أو البديل | هل افتراضه خطير؟
ضغط الهواء | أساسي | ثابت 945 hPa يناسب ارتفاع الرياض (نحو 600 م) | لا: بين 900 و1013 يتغير WBGT أقل من 0.2°
موقع الشمس | أساسي | يُحسب من الوقت والإحداثيات (24.71، 46.68) بمعادلة جاهزة | لا: حساب دقيق
تحويل الإضاءة إلى إشعاع | أساسي | الإشعاع = الإضاءة ÷ 110 | متوسط: خطأ 20% يغيّر WBGT نحو 1.2° تحت الشمس، وصفر داخل القاعة
نسبة الإشعاع المباشر | أساسي | 0.8 إذا زاد الإشعاع عن 250 W/m²، وإلا 0 | لا: بين 0.6 و0.9 يتغير أقل من 0.7°
نشاط الزائر وتأقلمه | أساسي | مشي خفيف وغير متأقلم، فالحد المرجعي 29°C | لا: يغيّر الحد المرجعي فقط لا قيمة WBGT
ملابس الزائر (CAV) | تحسين مقترح | ملابس عادية: CAV = 0 | لا
خصائص المناطق (ظل، أرضية) | تحسين مقترح | الاستغناء عنها؛ عمود واحد = منطقة واحدة في العرض | لا يمس القراءة المقاسة
جدول الفعاليات | تحسين مقترح | بيانات تجريبية معلنة كذلك | لا
حالة الأجهزة | تحسين مقترح | تسجيل يدوي في المنصة | لا
أعداد الزوار | تحسين مقترح | الاستغناء عنها | لا

# 5. المعادلات

## 5.1 مؤشر WBGT

WBGT يجمع العوامل البيئية الأربعة (حرارة الهواء، والرطوبة، والإشعاع، والرياح) في رقم واحد بوحدة °C. الوزن الأكبر للبصيلة الرطبة لأن تبخر العرق هو العامل الحاسم في تبريد الجسم:

WBGT = 0.7 × Tnw + 0.2 × Tg + 0.1 × Ta

Tnw حرارة البصيلة الرطبة الطبيعية، وTg حرارة الكرة السوداء، وTa حرارة الهواء. العمود لا يقيس Tnw ولا Tg، لذلك تحسبهما دالة جاهزة من حرارة الهواء والرطوبة والرياح والإشعاع بطريقة Liljegren (2008)، وهي الطريقة التي يستخدمها تشغيليًا معهد الأرصاد الهولندي (KNMI). الدالة calculate_wbgt_liljegren في مكتبة thermofeel من المركز الأوروبي (ECMWF)، الإصدار 2.3.0. لا حاجة لبرمجة المعادلات الفيزيائية.

## 5.2 مدخلات الدالة

المدخل | من أين | المعادلة
حرارة الهواء | DHT22 | Ta + 273.15 (بالكلفن)
الرطوبة | DHT22 | كما هي
الرياح على 10 م | الكؤوس | v10 = 1.33 × v عند ارتفاع 1.8 م (المقطع اللوغاريتمي بخشونة 0.01 م)
الإشعاع الشمسي | VEML7700 | G = E ÷ 110
نسبة الإشعاع المباشر | ثابت | 0.8 في الشمس، 0 في الظل
زاوية الشمس | الوقت والموقع | cos θz = sin φ sin δ + cos φ cos δ cos h (صيغة NOAA)
ضغط الهواء | ثابت | 945 hPa

## 5.3 الاحتياط إذا غاب الإشعاع أو الرياح

WBGT ≈ 0.567 × Ta + 0.393 × e + 3.94

صيغة تقريبية (ACSM 1984) تحتاج حرارة الهواء والرطوبة فقط، وموجودة في المكتبة نفسها (calculate_wbgt_simple). تُستخدم تلقائيًا إذا غابت قراءة الكؤوس أو الإضاءة، حتى تبقى قيمة معروضة، مع وسم الطريقة simple.

## 5.4 أمثلة محسوبة

حُسبت بمكتبة thermofeel 2.3.0. الإشعاع وأثر الأجهزة افتراضات توضيحية لبيان حساسية المؤشر، وليست قياسات.

الحالة | Ta °C | RH % | رياح عند الكؤوس m/s | إشعاع W/m² | WBGT °C | العلم
ظهر أكتوبر، شمس مباشرة | 35 | 20 | 1.0 | 800 | 29.1 | أخضر
+ تظليل | 35 | 20 | 1.0 | 120 | 24.5 | أبيض
+ مراوح | 35 | 20 | 3.0 | 800 | 26.8 | أخضر
+ رذاذ (Ta ‎−3‎°، RH ‎+14‎) | 32 | 34 | 1.0 | 800 | 29.3 | أخضر
ظهر أكتوبر حار وساكن | 38 | 25 | 0.3 | 850 | 34.7 | أسود
داخل القاعة | 25 | 47 | 0.3 | 0 | 19.1 | أبيض

ما تكشفه الأمثلة

التظليل أقوى تدخل لأنه يقطع الإشعاع عن الكرة: ‎−4.6‎°.

المراوح تفيد (‎−2.3‎°) في هذا المثال، لكنها مقيدة بحرارة هواء أقل من 37° لأنها قد تزيد الإجهاد في الحر الشديد الجاف.

الرذاذ لا يخفض رقم WBGT (‎+0.2‎°) لأنه يخفض الحرارة ويرفع الرطوبة معًا، فيبقى أثره على الإحساس لا على المؤشر.

تحسينات مقترحة على الحساب: عرض Tnw وTg منفصلتين بجانب WBGT (الدالتان solve_wetbulb وsolve_globe في المكتبة)، وتصحيح الملابس WBGTeff = WBGT + CAV، ومتوسط الساعة كما يشترط المعيار للتقارير.

# 6. الحدود والجداول العالمية المعتمدة للإجهاد الحراري

## 6.1 الحدود المرجعية لـ WBGT وفق ISO 7243:2017

المعيار الدولي لا يعطي رقمًا واحدًا للخطر، بل حدًا مرجعيًا لكل مستوى نشاط. إذا تجاوز WBGTeff هذا الحد فالإجهاد الحراري قائم ويلزم إجراء (تقليل النشاط، راحة، تبريد). القيم من إصدار 2017، والجهات الأمريكية (ACGIH) تتبنى المنهجية نفسها وتسمي حد المتأقلم TLV وحد غير المتأقلم Action Limit.

فئة النشاط | مثال | المعدل التقريبي (W) | الحد للمتأقلم (°C) | الحد لغير المتأقلم (°C)
0 – راحة | جلوس | 115 | 33 | 32
1 – خفيف | عمل يدوي خفيف، وقوف | 180 | 30 | 29
2 – متوسط | مشي مستمر، حمل خفيف | 300 | 28 | 26
3 – شاق | حمل ثقيل، حفر | 415 | 26 | 23
4 – شاق جدًا | جهد أقصى سريع | 520 | 25 | 20

تطبيقها في هبوب: الزائر الذي يقف أو يمشي ببطء بين الأجنحة يقع غالبًا في الفئة 1، ومن يمشي مسافات طويلة في الفئة 2. والمقترح اعتبار الزوار غير متأقلمين لأن أغلبهم قادمون من خارج المنطقة. بهذا يكون الحد المرجعي للزوار 29°C (الفئة 1، غير متأقلم). أما فرق التشغيل والصيانة فيُطبّق عليهم حد فئة نشاطهم الفعلي، وهي زاوية إضافية لسلامة العاملين في الموقع.

## 6.2 جدول الأعلام التشغيلي

هذا التصنيف المبسط هو الأوسع استخدامًا ميدانيًا (العسكرية الأمريكية، OSHA، الرياضة)، ويحوّل قيمة WBGT إلى مستوى خطر وزمن راحة لكل ساعة نشاط تحت الشمس، بحسب حاسبة WBGT لدى هيئة الأرصاد الأمريكية (NWS).

العلم | WBGT (°C) | يبدأ الإجهاد بعد | الراحة المطلوبة كل ساعة
أبيض | 26.6 أو أقل | — | لا قيود خاصة
أخضر | 26.7 إلى 29.3 | 45 دقيقة | 15 دقيقة على الأقل
أصفر | 29.4 إلى 31.0 | 30 دقيقة | 30 دقيقة على الأقل
أحمر | 31.1 إلى 32.1 | 20 دقيقة | 40 دقيقة على الأقل
أسود | 32.2 أو أكثر | 15 دقيقة | 45 دقيقة على الأقل

لا تُخلط الأرقام بين المؤشرات: 32°C في WBGT تعني خطرًا عاليًا (علم أسود)، بينما 32°C في مؤشر الحرارة بداية الحذر فقط.

## 6.3 المؤشرات المساندة وجداولها

هذه المؤشرات لا تحل محل WBGT، لكن اللجنة قد تسأل عنها، وبعضها مفيد للمقارنة.

### مؤشر المناخ الحراري العالمي (UTCI)

مؤشر دولي لراحة الناس في الأماكن الخارجية، يحسب من حرارة الهواء والرطوبة والرياح على 10 م ومتوسط درجة الحرارة الإشعاعية (Tmrt) بمتعددة حدود من الدرجة السادسة، ويغطي الحر والبرد. فئاته العشر للعلم:

UTCI °C | الفئة | الإجراءات الموصى بها
أكبر من 46 | إجهاد حراري شديد (Extreme heat stress) | تبريد مؤقت للجسم، منع النشاط البدني، شرب أكثر من 0.5 لتر/ساعة
38 إلى 46 | إجهاد حراري قوي جدًا (Very strong) | تكييف مؤقت، أماكن مظللة ضرورية، تقليل النشاط
32 إلى 38 | إجهاد حراري قوي (Strong) | أماكن مظللة، شرب أكثر من 0.25 لتر/ساعة
26 إلى 32 | إجهاد حراري معتدل (Moderate) | شرب أكثر من 0.25 لتر/ساعة
9 إلى 26 | لا إجهاد حراري (No thermal stress) | لا إجراء
0 إلى 9 | إجهاد برد خفيف (Slight cold) | ملابس دافئة خفيفة
‎−13‎ إلى 0 | إجهاد برد معتدل (Moderate cold) | زيادة النشاط، حماية الوجه والأطراف
‎−27‎ إلى ‎−13‎ | إجهاد برد قوي (Strong cold) | ملابس دافئة
‎−40‎ إلى ‎−27‎ | إجهاد برد قوي جدًا (Very strong cold) | تقليل وقت البقاء في الخارج
أقل من ‎−40‎ | إجهاد برد شديد (Extreme cold) | البقاء في الداخل

### مؤشر الحرارة (Heat Index) — هيئة الأرصاد الأمريكية NWS

يعتمد على حرارة الهواء والرطوبة فقط بمعادلة Rothfusz (1990)، ويفترض الظل. في الأجواء الجافة جدًا مثل الرياض يكون منخفضًا نسبيًا رغم شدة الشمس، فلا يصلح مؤشرًا رئيسيًا. التصنيف بحسب جدول ECMWF المأخوذ من NWS:

مؤشر الحرارة °C | التصنيف | الأثر على الجسم
26.7 إلى 32.2 | حذر (Caution) | إرهاق محتمل مع التعرض الطويل أو النشاط
32.2 إلى 39.4 | حذر شديد (Extreme caution) | ضربة شمس أو تشنجات أو إنهاك حراري محتمل مع التعرض الطويل
39.4 إلى 51.1 | خطر (Danger) | التشنجات والإنهاك مرجّحان، وضربة الشمس محتملة
51.1 فأكثر | خطر شديد (Extreme danger) | ضربة الشمس مرجّحة جدًا

### مؤشر Humidex — كندا

Humidex = Ta + 0.5555 × (e − 10)، حيث e ضغط البخار بوحدة hPa. يعتمد على الحرارة والرطوبة فقط، وأثره محدود في هواء الرياض الجاف.

Humidex °C | درجة الإزعاج
20 إلى 30 | إزعاج بسيط
30 إلى 40 | بعض الإزعاج
40 إلى 46 | إزعاج كبير؛ تجنب المجهود
46 فأكثر | خطر؛ ضربة شمس محتملة

### حرارة المكافئ الفسيولوجي (PET)

PET شائع في دراسات التخطيط الحضري، ويحتاج المدخلات البيئية مع افتراضات عن الشخص. التصنيف المتداول (Matzarakis وMayer 1996، لغرب أوروبا ووسطها): 18–23 لا إجهاد، 23–29 إجهاد حراري خفيف، 29–35 معتدل، 35–41 قوي، أكثر من 41 شديد. هذه الحدود معايرة على مناخ أوروبي، ويُتحقق منها في المرجع قبل الاستشهاد بها.

## 6.4 لماذا WBGT هو المؤشر الرئيسي في هبوب

المؤشر | المدخلات | يشمل الإشعاع | يشمل الرياح | له حدود تدخل دولية | دوره في هبوب
WBGT | Tnw، Tg، Ta | نعم | نعم | نعم (ISO 7243، ACGIH، OSHA) | المؤشر الرئيسي لكل القرارات
UTCI | Ta، RH، الرياح، Tmrt | نعم | نعم | فئات استجابة لا حدود تدخل | مقارنة، ولتغطية البرد مستقبلًا
Heat Index | Ta، RH | لا (يفترض الظل) | لا | تصنيف تحذيري | مقارنة مفهومة للجمهور فقط
Humidex | Ta، ضغط البخار | لا | لا | لا | لا يُستخدم
PET | المدخلات البيئية + صفات الشخص | نعم | نعم | لا | مقارنة أكاديمية إن طُلبت

أسباب الاختيار: WBGT يجمع العوامل البيئية الأربعة التي يذكرها نص التحدي 2.3، وله معيار دولي بحدود تدخل واضحة لكل مستوى نشاط، ونظام أعلام مجرّب في الفعاليات والرياضة يفهمه المشغّل مباشرة، ومعادلته بسيطة تفسّر أثر كل أداة تلطيف (الظل يخفض Tg، والتكييف يخفض Tnw). حدّان يجب معرفتهما: المعيار صُمم للتعرض المهني حتى 8 ساعات، ولا يقيس إجهاد البرد.

## 6.5 مناخ الرياض خلال فترة إكسبو

يُقام إكسبو 2030 الرياض من 1 أكتوبر 2030 إلى 31 مارس 2031 بحسب المكتب الدولي للمعارض (BIE). المتوسطات الشهرية التالية من سجل climate-zone لمحطة الرياض، وهي تقريبية للتخطيط فقط:

الشهر | متوسط العظمى °C | متوسط الصغرى °C | ما يعنيه لهبوب
أكتوبر | 35 | 21 | أعلام خضراء إلى سوداء في الساحات المشمسة ظهرًا؛ أعلى حمل على التظليل والتبريد
نوفمبر | 26 | 15 | علم أبيض غالبًا، وأخضر محتمل في الشمس المباشرة
ديسمبر | 22 | 11 | علم أبيض؛ لا إجهاد حراري
يناير | 20 | 8 | علم أبيض؛ البرد في الفجر والليل خارج نطاق WBGT
فبراير | 23 | 11 | مشابه لديسمبر
مارس | 26 | 13 | عودة الأعلام الخضراء في الشمس أواخر الشهر

الاستنتاج: الطلب على التدخل يتركز في أكتوبر وبداية نوفمبر ومارس. من ديسمبر إلى فبراير يبقى WBGT غالبًا بعلم أبيض، والبرد في الأمسيات خارج نطاق المؤشر. إذا أراد الفريق تغطيته لاحقًا يمكن عرض UTCI كمؤشر مساند في هذه الأشهر.

## 6.6 ربط المنصة بأعلام WBGT

حالات المنصة مضبوطة على أرقام UTCI، وتُحوَّل إلى أعلام WBGT كالتالي:

العنصر في النموذج الأولي | الحد المستخدم | ما يقابله في WBGT | التعديل المطلوب
الحالة «مريحة» | أقل من 32 | 32 في WBGT علم أسود | تصبح: علم أبيض، 26.6 أو أقل
الحالة «تنبيه» | 32 إلى 38 | كلها فوق حد الخطر | تصبح: أخضر وأصفر
الحالتان «إجهاد حراري» و«حرجة» | 38–42 وأكبر من 42 | قيم WBGT نادرة الحدوث | تصبحان: أحمر وأسود
شريط التصنيف في صفحة المنطقة | فئات UTCI الخمس | غير مطابق | يُستبدل بالأعلام الخمسة مع خط الحد المرجعي 29
رد الخادم وشاشة العقدة | utci_c وstress_key | غير مطابق | wbgt_c وflag، وتلوين الشاشة بالأعلام

### المقترح: المستوى التشغيلي = علم WBGT

المستوى التشغيلي | شرط الدخول (WBGT °C) | الإجراء الافتراضي
أبيض — مراقبة | 26.6 أو أقل | مراقبة فقط
أخضر — جاهزية | 26.7 إلى 29.3 | توفير مياه الشرب، ومتابعة الفعاليات القريبة
أصفر — تدخل | 29.4 إلى 31.0 | تفعيل التظليل، ثم المراوح بحسب جدول التوصية (7.2)؛ تجاوز الحد المرجعي 29 للزوار
أحمر — تدخل فوري | 31.1 إلى 32.1 | التظليل والتبريد فورًا، ومراجعة توقيت الفعاليات
أسود — خطر | 32.2 أو أكثر | تدخل فوري، وتقليل النشاط، وتقييد الوصول عند الحاجة

قواعد الاستقرار المقترحة: الصعود لعلم أعلى بعد بقاء الشرط 3 دقائق متصلة، والنزول بعد انخفاض WBGT نصف درجة تحت الحد لمدة 5 دقائق. هذا يمنع تذبذب الحالة والأجهزة حول الحد. هذه القواعد تحسين مقترح؛ الحد الأدنى يكتفي بالعلم اللحظي.

# 7. التحليلات والقرارات في المنصة

الحصر مأخوذ من صفحات النموذج الأولي للمنصة. كل بند مصنّف حسب طريقة بنائه: أ حساب حتمي بمعادلة أو جدول، وب قواعد وإحصاء ومحاكاة بلا تدريب، وج نموذج تعلم آلي يحتاج بيانات وتدريبًا. ثم قُسمت البنود إلى أساسي (يكفي لإثبات الفكرة) وتحسين مقترح.

## 7.1 التحليلات الأساسية (8 بنود)

# | التحليل | الفئة | طريقة البناء | الجهد

1 | حساب WBGT لكل رسالة | أ | دالة thermofeel (الملحق أ) | منخفض
2 | علم الخطر ومقارنته بالحد المرجعي 29 | أ | جدول الأعلام (القسم 6.2) | منخفض جدًا
3 | حالة المنطقة ومؤشرات الصفحة الرئيسية | أ | عمود واحد = منطقة واحدة؛ عدّ المناطق لكل علم | منخفض جدًا
4 | حالة اتصال العمود | أ | متصل إذا وصلت رسالة خلال 5 دقائق، وإلا غير متصل | منخفض جدًا
5 | تفسير السبب: مساهمة الإشعاع وضعف الرياح | ب | إعادة حساب WBGT مرتين (الملحق ب) | منخفض
6 | التوصية بالإجراء | ب | جدول قواعد من 4 أسطر (7.2) | منخفض
7 | الأثر المتوقع للإجراء | ب | إعادة حساب WBGT بالمدخل المعدّل | منخفض
8 | توقع WBGT للساعات القادمة | ب | توقع Open-Meteo يُحوَّل إلى WBGT بالدالة نفسها (الملحق ج) | منخفض

## 7.2 تفاصيل البنود الأساسية

### 1 إلى 4: من الرسالة إلى الصفحة الرئيسية

1. قراءة حرارة الهواء والرطوبة؛ إذا غابت لا يُحسب WBGT.
2. إذا غابت الكؤوس أو الإضاءة تُستخدم الصيغة الاحتياطية (5.3).
3. حساب الرياح على 10 م، والإشعاع، وزاوية الشمس، ثم WBGT والعلم.
4. حفظ wbgt_c وflag في derived_json، وعرضهما في اللوحة وعلى شاشة العقدة.

### 5: تفسير السبب

نعيد حساب WBGT مرة بإشعاع صفر (ظل كامل)، ومرة برياح معتادة (3 m/s على 10 م). الفرق عن القيمة الحالية هو مساهمة كل عامل. في مثال ظهر أكتوبر (29.1): الإشعاع يساهم بـ 6.1 درجة، وضعف الرياح بـ 1.8. التفسير ناتج من المعادلة نفسها لا من تخمين، ويقود مباشرة إلى الأداة المناسبة.

مساهمة الإشعاع = WBGT(الآن) − WBGT(بإشعاع صفر)

### 6: جدول قواعد التوصية (الحد الأدنى)

الشرط | الإجراء | السبب
العلم أصفر فأعلى، ومساهمة الإشعاع هي الأكبر | التظليل | يخفض Tg، وهو أكبر أثر (‎−4.6‎° في المثال)
العلم أصفر فأعلى، والرياح أقل من 1.5 m/s، وحرارة الهواء أقل من 37° | المراوح | تزيد التبخر وتبرّد الكرة
العلم أحمر أو أسود | التظليل والتبريد فورًا، وتقليل النشاط | حد الخطر في جدول الأعلام
العلم أبيض أو أخضر | مراقبة فقط | تحت الحد المرجعي

### 7: الأثر المتوقع

WBGT بعد الإجراء − WBGT الآن: التظليل يخفض الإشعاع إلى 120 W/m² (المنتشر فقط)، والمراوح ترفع الرياح إلى 3 m/s. هذه قيم افتراضية معلنة؛ قياس أثر الأجهزة الحقيقي تحسين مقترح.

### 8: التوقع

نطلب توقع الساعات القادمة لموقع الرياض من Open-Meteo (حرارة، رطوبة، رياح على 10 م، إشعاع كلي ومباشر)، ونمرر كل ساعة على دالة WBGT نفسها. النتيجة منحنى WBGT وأعلامه لست ساعات قادمة، بلا تدريب وبلا بيانات تاريخية. يحتاج اتصالًا بالإنترنت، والهوتسبوت يوفره.

## 7.3 التحسينات المقترحة (16 بندًا)

مرتبة حسب قيمتها أمام اللجنة. يُبنى منها ما يسمح به الوقت بعد اكتمال الأساسي، بدءًا من الأعلى.

# | التحسين | الفئة | ماذا يضيف | ما يحتاجه

ج1 | نموذج تعلم آلي يصحح توقع WBGT محليًا | ج | مكوّن ذكاء اصطناعي مدرَّب، ورقم دقة مقيس | بيانات ERA5 للرياض + LightGBM؛ تقييم MAE على سنة محجوزة
ج2 | تقدير WBGT للمناطق بلا أعمدة | ج | قلب التحدي 2.3: القياس في نقاط قليلة | عمودان فأكثر، وفئة ظل لكل منطقة
ب11 | خطر الفعالية واقتراح وقت أنسب | ب | ربط مباشر بتشغيل إكسبو | التوقع (بند 8) وجدول فعاليات
ب7 | الأتمتة مع منع التذبذب | ب | تشغيل وإيقاف مستقر للأجهزة | مدة صعود 3 دقائق ونزول 5 دقائق
ب10 | مؤشر جودة القراءة | ب | شفافية: مقاسة أم مقدّرة | وسم الطريقة ووجود الحساسات
ب8 | الاتجاه: سرعة ارتفاع WBGT | ب | إنذار مبكر | ميل خط على آخر 30 دقيقة
ب1 | كشف القفزات والقيم الثابتة | ب | بيانات أنظف | قواعد معدل التغير والثبات
ب2 | سد الفجوات القصيرة | ب | رسوم متصلة | استيفاء خطي حتى 3 رسائل
ب3 | تقدير عمود منقطع من جيرانه | ب | استمرار الخريطة عند الأعطال | عمودان فأكثر
ب9 | كشف عطل جهاز من أثره | ب | صيانة استباقية | سجل تشغيل الأجهزة
أ6 | ساعات العلم الأصفر فأعلى، وخريطة الساعات × الأيام | أ | تحليلات يومية وأسبوعية | بيانات متراكمة لأيام
أ7 | مؤشرات الكفاءة: التدخلات، الاعتماد، الاستجابة، المياه | أ | قياس الأثر التشغيلي | سجل قرارات المنصة
أ8 | زمن الراحة الموصى به لكل علم | أ | إرشاد مباشر للمشغل | جدول الأعلام فقط
ج3 | اختيار أفضل وقت ومكان للفعالية | ج | تحسين جدولة الفعاليات | ج1 وج2
ج4 | تعلّم الأثر الفعلي لكل جهاز | ج | توصيات مبنية على قياس | أسابيع من بيانات قبل/بعد
ج5 | كشف الشذوذ متعدد المتغيرات | ج | كشف أعطال أدق | بيانات متراكمة

# 8. مصادر البيانات

المصدر | النوع | ماذا يوفر | الاستخدام
قاعدة readings في الخادم | أساسي | قراءات العقدة وWBGT المحسوب | العرض الحي والتحليلات الأساسية
Open-Meteo Forecast | أساسي | توقع ساعي: حرارة، رطوبة، رياح على 10 م، إشعاع كلي ومباشر. بلا مفتاح، والرياح بوحدة m/s عبر wind_speed_unit=ms | التوقع (بند 8)
مكتبة thermofeel 2.3.0 | أساسي | دوال WBGT | كل الحسابات
Open-Meteo Historical (ERA5) | تحسين مقترح | بيانات ساعية منذ 1940 بالمتغيرات نفسها | تدريب نموذج ج1
وضع المحاكاة في الخادم | تحسين مقترح | عقدتان وهميتان | اختبار ب3 وج2 بلا عتاد إضافي
المخطط العام لإكسبو | تحسين مقترح | مواقع المناطق وظلالها | التقدير المكاني ج2

# 11. قرارات للفريق وافتراضات

## 11.1 قرارات تحتاج الفريق

1. اعتماد الحد المرجعي للزوار 29°C (الفئة 1، غير متأقلم)، والأعلام الخمسة كحالات المنصة.
2. اعتماد التوقع من Open-Meteo بلا تدريب في الحد الأدنى، وتأجيل نموذج التعلم الآلي لما بعد اكتمال الأساسي.

## 11.2 الافتراضات

- ضغط هواء 945 hPa، وخشونة أرض 0.01 م، ومعامل إضاءة 110، ونسبة إشعاع مباشر 0.8 في الشمس.
- الإشعاع وأثر الأجهزة في أمثلة القسم 5.4 توضيحية.
- حدود قواعد التوصية (1.5 m/s و37°) مقترحة وتُضبط بالتجربة.

## 11.3 الأثر على ملفات أخرى

رد الخادم وتلوين شاشة العقدة (من utci_c إلى wbgt_c وflag)، وحالات المنصة (إلى الأعلام الخمسة)، وشرائح العرض التي تذكر UTCI.

# 12. المراجع

[1] ISO 7243:2017 — Ergonomics of the thermal environment: Assessment of heat stress using the WBGT index.

[2] Liljegren J.C. et al. (2008). Modeling the wet bulb globe temperature using standard meteorological measurements. J Occup Environ Hyg 5(10):645–655.

[3] ECMWF thermofeel 2.3.0 — calculate_wbgt_liljegren, calculate_wbgt_simple. https://github.com/ecmwf/thermofeel

[4] ACSM (1984). Prevention of thermal injuries during distance running. Physician and Sportsmedicine 12(7).

[5] NWS — WBGT calculator and flag categories. https://www.weather.gov

[6] ECMWF Forecast User Guide — New parameters: heat and cold indices (IFS Cycle 49r1). https://confluence.ecmwf.int/spaces/FCST/pages/462912535

[7] Błażejczyk K. et al. (2013). An introduction to the Universal Thermal Climate Index (UTCI). Geographia Polonica 86(1):5–10.

[8] Rothfusz L. (1990). The heat index equation. NWS Technical Attachment SR 90-23.

[9] Matzarakis A., Mayer H. (1996). Another kind of environmental stress: thermal stress. WHO Newsletter 18:7–10.

[10] BIE — General Assembly grants registration to World Expo 2030 Riyadh (1 Oct 2030 – 31 Mar 2031). https://www.bie-paris.org

[11] Open-Meteo — Weather Forecast API documentation. https://open-meteo.com/en/docs

[12] climate-zone.com — Riyadh monthly climate averages. https://www.climate-zone.com/climate/saudi-arabia/celsius/riyadh.htm

[13] مصادر الفريق الداخلية: ملف مقاييس الإجهاد الحراري (WBGT وفق ISO 7243 وجدول الأعلام وأدوات التلطيف)، وبرنامج العقدة، وخادم الموقع التجريبي، والنموذج الأولي للمنصة.

# الملحق أ: حساب WBGT

جُرّب في بيئة Python مع thermofeel 2.3.0: رسالة ظهر أكتوبر في الشمس أعطت 29.1 بعلم أخضر، ورسالة القاعة 19.2 بعلم أبيض، ورسالة بلا كؤوس انتقلت للصيغة الاحتياطية. لم يُجرَّب بعد داخل خادم الفريق.

import math

import datetime as dt

import numpy as np

import thermofeel as tf

CFG = {"k": 20.0, "b": 0.5, "v_min": 0.02, "z0": 0.01, "lux_per_wm2": 110.0,

"sun_wm2": 250.0, "fdir_sun": 0.8, "p_hpa": 945.0, "lat": 24.71, "lon": 46.68, "tz": 3}

FLAGS = [(26.6, "white"), (29.3, "green"), (31.0, "yellow"), (32.1, "red")] # upper bound inclusive

def wbgt_flag(w):

for upper, key in FLAGS:

if w <= upper:

return key

return "black"

def wind_10m(v_h, h, z0=CFG["z0"]):

return v_h * math.log(10 / z0) / math.log(h / z0)

def cos_zenith(t_local, lat=CFG["lat"], lon=CFG["lon"], tz=CFG["tz"]):

"""NOAA solar position approximation. t_local: datetime in local time."""

n = t_local.timetuple().tm_yday

hour = t_local.hour + t_local.minute / 60

g = 2 * math.pi / 365 * (n - 1 + (hour - 12) / 24)

decl = (0.006918 - 0.399912 * math.cos(g) + 0.070257 * math.sin(g)

- 0.006758 * math.cos(2 * g) + 0.000907 * math.sin(2 * g)

- 0.002697 * math.cos(3 * g) + 0.00148 * math.sin(3 * g))

eqt = 229.18 * (0.000075 + 0.001868 * math.cos(g) - 0.032077 * math.sin(g)

- 0.014615 * math.cos(2 * g) - 0.040849 * math.sin(2 * g))

tst = hour * 60 + eqt + 4 * lon - 60 * tz

ha = math.radians(tst / 4 - 180)

la = math.radians(lat)

return max(0.0, math.sin(la) * math.sin(decl) + math.cos(la) * math.cos(decl) * math.cos(ha))

def wbgt_liljegren(ta, rh, v10, ghi, fdir, cz, p=CFG["p_hpa"]):

a = lambda x: np.array([x], dtype=float)

r = tf.calculate_wbgt_liljegren(a(ta + 273.15), a(rh), a(p), a(v10), a(ghi), a(fdir), a(cz))

return float(r[0]) - 273.15

def wbgt_simple(ta, rh):

e = rh / 100 * 6.112 * math.exp(17.62 * ta / (243.12 + ta))

return 0.567 * ta + 0.393 * e + 3.94

def compute(msg, t_local, cfg=CFG):

s, flags = msg["sensors"], []

d = s.get("dht22", {})

if d.get("status") != "ok" or d.get("ta_c") is None or d.get("rh_pct") is None:

return {"wbgt_c": None, "reason": "missing_ta_rh"}

ta, rh = float(d["ta_c"]), float(d["rh_pct"])

an, li = s.get("anemometer", {}), s.get("veml7700", {})

if an.get("status") != "ok" or an.get("wind_v") is None or li.get("status") != "ok" or li.get("lux") is None:

w = wbgt_simple(ta, rh) # fallback: no wind or no light reading

return {"wbgt_c": round(w, 1), "flag": wbgt_flag(w), "wbgt_method": "simple", "flags": ["fallback_simple"]}

V = float(an["wind_v"])

v_h = 0.0 if V < cfg["v_min"] else cfg["k"] * V + cfg["b"]

v10 = wind_10m(v_h, float(an.get("height_m") or 1.8))

ghi = float(li["lux"]) / cfg["lux_per_wm2"]

sun = ghi > cfg["sun_wm2"]

cz = cos_zenith(t_local)

w = wbgt_liljegren(ta, rh, v10, ghi, cfg["fdir_sun"] if sun else 0.0, cz)

if math.isnan(w):

return {"wbgt_c": None, "reason": "no_convergence"}

return {"wbgt_c": round(w, 1), "flag": wbgt_flag(w), "wbgt_method": "liljegren",

"v10_ms": round(v10, 2), "ghi_wm2": round(ghi), "sun_flag": int(sun),

"cossza": round(cz, 3), "flags": flags}

## الملحق ب: تفسير السبب

def explain(ta, rh, v10, ghi, fdir, cz, v10_ref=3.0):

"""Contribution = WBGT(actual) - WBGT(with that factor at its reference value)."""

base = wbgt_liljegren(ta, rh, v10, ghi, fdir, cz)

return {

"radiation": round(base - wbgt_liljegren(ta, rh, v10, 0.0, 0.0, cz), 1),

"low_wind": round(base - wbgt_liljegren(ta, rh, max(v10_ref, v10), ghi, fdir, cz), 1),

"humidity": round(base - wbgt_liljegren(ta, 50.0, v10, ghi, fdir, cz), 1),

"wbgt": round(base, 1),

}

# explain(35, 20, 1.33, 800, 0.8, 0.836)

# -> {'radiation': 6.1, 'low_wind': 1.8, 'humidity': -4.9, 'wbgt': 29.1}

## الملحق ج: التوقع من Open-Meteo

جُرّب منطق الدالة على استجابة وهمية بالبنية نفسها؛ الاتصال الفعلي بالخدمة لم يُجرَّب من هنا.

import datetime as dt

import requests

from haboob_wbgt import wbgt_liljegren, wbgt_flag, cos_zenith

URL = "https://api.open-meteo.com/v1/forecast"

def wbgt_forecast(lat=24.71, lon=46.68, hours=6):

"""Next-hours WBGT from the Open-Meteo forecast, using the same WBGT function (no training).

Open-Meteo radiation is the mean of the preceding hour, so the sun angle is taken at mid-hour."""

p = {"latitude": lat, "longitude": lon, "timezone": "Asia/Riyadh", "forecast_days": 2,

"wind_speed_unit": "ms",

"hourly": "temperature_2m,relative_humidity_2m,wind_speed_10m,shortwave_radiation,direct_radiation"}

h = requests.get(URL, params=p, timeout=10).json()["hourly"]

now = dt.datetime.now().replace(minute=0, second=0, microsecond=0)

out = []

for i, t in enumerate(h["time"]):

ti = dt.datetime.fromisoformat(t)

if ti <= now or len(out) >= hours:

continue

ghi = h["shortwave_radiation"][i] or 0.0

fdir = (h["direct_radiation"][i] or 0.0) / ghi if ghi > 0 else 0.0

w = wbgt_liljegren(h["temperature_2m"][i], h["relative_humidity_2m"][i],

h["wind_speed_10m"][i], ghi, min(fdir, 0.9), cos_zenith(ti - dt.timedelta(minutes=30)))

out.append({"time": t, "wbgt_c": round(w, 1), "flag": wbgt_flag(w)})

return out

هبوب · الدليل المرجعي لمسار علم البيانات والذكاء الاصطناعي · الإصدار 3.0
