SARAHXL1/Expo2023-HABOOB/docs/system-docs/الإجهاد الحراري.docx

# الإجهاد الحراري: العوامل والقياس وجداول التصنيف

7 أكتوبر 2026

## الخلاصة

الإجهاد الحراري هو مجموع الحرارة التي يتعرض لها الجسم من البيئة ومن نشاطه وملابسه، بحيث يصعب عليه التخلص منها. المقياس المعتمد دوليًا لتقييمه هو WBGT وفق المعيار ISO 7243:2017، ويُقرأ مقابل حدود تتغير حسب شدة النشاط والتأقلم.

- 6 عوامل تحدد الإجهاد: 4 بيئية (حرارة الهواء، الرطوبة، الإشعاع، حركة الهواء) و2 شخصية (النشاط، الملابس).
- WBGT يجمع العوامل البيئية الأربعة في رقم واحد، بعكس مؤشر الحرارة (Heat Index) الذي يكتفي بالحرارة والرطوبة.

## العوامل الست للإجهاد الحراري

الجسم يبرد نفسه أساسًا بتبخر العرق، فكل عامل يزيد الحرارة الداخلة أو يعيق التبخر يرفع الإجهاد. العوامل الست معتمدة في أدبيات الصحة المهنية (AIHA (https://publications.aiha.org/202004-heat-and-humidity)).

العامل | النوع | تأثيره ببساطة | أداة القياس
حرارة الهواء (Ta) | بيئي | كلما ارتفعت قلّ فرق الحرارة بين الجلد والهواء فيصعب التبريد | ترمومتر جاف محمي من الشمس
الرطوبة | بيئي | الهواء الرطب يبطئ تبخر العرق، فيفقد الجسم وسيلة تبريده الرئيسية | ترمومتر رطب أو حساس رطوبة
الحرارة الإشعاعية (Tmrt) | بيئي | حرارة الشمس والأسطح الساخنة (أسفلت، جدران) تصل للجسم مباشرة | الكرة السوداء (Globe)
حركة الهواء (الرياح) | بيئي | تساعد التبريد ما دام الهواء أبرد من الجلد (نحو 35°C)، وفوق ذلك قد تنقل حرارة للجسم | مقياس سرعة الهواء (Anemometer)
معدل النشاط (الأيض M) | شخصي | المجهود البدني ينتج حرارة داخلية؛ العمل الشاق يضاعف الحمل | جداول تقدير بالواط (W)
الملابس | شخصي | تعزل الجسم وتعيق التبخر؛ الملابس الثقيلة أو الواقية ترفع الإجهاد | قيمة تصحيح الملابس (CAV)

عوامل مساندة تزيد قابلية التأثر: التأقلم مع الحر (يحتاج أيامًا من التعرض التدريجي)، والعمر، واللياقة، وبعض الأمراض والأدوية.

## كيف يُقاس: جهاز WBGT ومعادلته

جهاز WBGT يحوي ثلاثة حساسات، وكل حساس يمثل جانبًا من شعور الجسم بالحر (NWS (https://www.weather.gov/mpx/wbgt)):

- الترمومتر الرطب الطبيعي (Tnw): بصيلة ملفوفة بفتيل مبلل ومعرضة للهواء الطبيعي، تحاكي تبريد العرق، فتعكس الرطوبة والرياح معًا.
- الكرة السوداء (Tg): حساس داخل كرة سوداء مطفأة تمتص الإشعاع، فتعكس حرارة الشمس والأسطح.
- الترمومتر الجاف (Ta): حرارة الهواء العادية في الظل.

في الخارج تحت الشمس:

WBGT=0.7 T_(nw) +0.2 T_g +0.1 T_a

في الداخل أو بدون شمس مباشرة:

WBGT=0.7 T_(nw) +0.3 T_g

الوزن الأكبر (70%) للترمومتر الرطب لأن قدرة العرق على التبخر هي العامل الحاسم. مثال: هواء 35°C، رطب 29°C، كرة سوداء 47°C تعطي WBGT = 20.3 + 9.4 + 3.5 = 33.2°C.

تصحيح الملابس (ISO 7243:2017): تُضاف قيمة CAV حسب نوع اللباس للحصول على القيمة الفعلية:

WBGT_(eff) =WBGT+CAV

حسب المعيار، يُقاس عند مستوى البطن أو عند أشد نقطة حرارة، ويُحسب متوسط ساعة ممثلة للعمل، ويطبق على تعرض حتى 8 ساعات (ISO 7243 – EVS (https://www.evs.ee/en/iso-7243-2017)).

## المؤشرات الأخرى ومعادلاتها باختصار

WBGT هو الأشمل لأنه يدخل الإشعاع والرياح؛ المؤشرات الأخرى أبسط أو موجهة لاستخدام مختلف.

المؤشر | ما يدخل في حسابه | المرجع | متى يُستخدم
WBGT (https://www.weather.gov/mpx/wbgt) | حرارة الهواء + رطوبة + إشعاع + رياح | ISO 7243، OSHA، ACGIH | العمل والرياضة والفعاليات، خصوصًا تحت الشمس
UTCI (https://thermofeel.readthedocs.io/en/stable/guide/utci/) | حرارة الهواء + إشعاع (Tmrt) + رياح + رطوبة، مع نموذج لاستجابة الجسم | مؤشر دولي (Jendritzky وآخرون، 2012) | تقييم راحة الناس في الأماكن الخارجية والمدن
مؤشر الحرارة HI (https://www.weather.gov/media/unr/heatindex.pdf) | حرارة الهواء + الرطوبة فقط | هيئة الأرصاد الأمريكية NWS | تحذيرات الطقس العامة؛ قيمه للظل وقد ترتفع حتى 15°F (نحو 8°C) في الشمس
Humidex (https://www.canada.ca/en/services/environment/weather/severeweather/humidex.html) | حرارة الهواء + نقطة الندى | الأرصاد الكندية | الإحساس العام بالحر والرطوبة

Humidex (أبسطها حسابًا)، حيث e ضغط بخار الماء بالهكتوباسكال:

H=T_a +0.5555 (e−10)

مؤشر الحرارة HI: معادلة انحدار (Rothfusz) من الحرارة والرطوبة النسبية، تُقرأ عمليًا من جدول NWS.

UTCI: يُحسب بمعادلة متعددة الحدود طويلة من أربعة مدخلات (حرارة الهواء، Tmrt، الرياح على 10 م، ضغط البخار)، ولا يُحسب يدويًا بل ببرامج وحزم جاهزة.

ملاحظة مهمة: في الأجواء الجافة جدًا (مثل الرياض صيفًا) يكون HI وHumidex منخفضين نسبيًا رغم شدة الشمس، لذا WBGT هو الأدق للأماكن المكشوفة.

## الجدول المعتمد دوليًا: حدود WBGT حسب ISO 7243

المعيار الدولي لا يعطي رقمًا واحدًا للخطر، بل حدًا مرجعيًا لكل مستوى نشاط؛ إذا تجاوز WBGTeff هذا الحد فالإجهاد قائم ويلزم إجراء (تقليل العمل، راحة، تبريد). القيم من الإصدار 2017 (Certifico (https://certifico.com/component/attachments/download/7733)، KEM (https://www.kem.kyoto/en/wp-content/uploads/sites/2/2023/07/WBGT-301WBGT-302_CN131A.pdf)).

فئة النشاط | مثال | المعدل التقريبي (W) | الحد للمتأقلم (°C) | الحد لغير المتأقلم (°C)
0 – راحة | جلوس | 115 | 33 | 32
1 – خفيف | عمل يدوي خفيف، وقوف | 180 | 30 | 29
2 – متوسط | مشي مستمر، حمل خفيف | 300 | 28 | 26
3 – شاق | حمل ثقيل، حفر | 415 | 26 | 23
4 – شاق جدًا | جهد أقصى سريع | 520 | 25 | 20

الجهات الأمريكية (ACGIH) تتبنى المنهجية نفسها وتسمي حد المتأقلم TLV وحد غير المتأقلم Action Limit.

### جدول الأعلام التشغيلي (WBGT)

هذا التصنيف المبسط الأوسع استخدامًا ميدانيًا (العسكرية الأمريكية، OSHA، الرياضة) ويحوّل قيمة WBGT إلى مستوى خطر وزمن راحة لكل ساعة عمل تحت الشمس (NWS – حاسبة WBGT (https://www.weather.gov/epz/wxcalc_wbgt)).

العلم | WBGT (°C) | يبدأ الإجهاد بعد | الراحة المطلوبة كل ساعة
أبيض | ≤ 26.6 | — | لا قيود خاصة
أخضر | 26.7 – 29.3 | 45 دقيقة | 15 دقيقة على الأقل
أصفر | 29.4 – 31.0 | 30 دقيقة | 30 دقيقة على الأقل
أحمر | 31.1 – 32.1 | 20 دقيقة | 40 دقيقة على الأقل
أسود | ≥ 32.2 | 15 دقيقة | 45 دقيقة على الأقل

بالمثال السابق (33.2°C) يكون التصنيف أسود، وهو فوق حد ISO لكل الفئات حتى الراحة (33°C).

## جدول مساند: مؤشر الحرارة

مؤشر الحرارة (NWS) بأربع فئات، وقيمه للظل (PMC – NOAA (https://pmc.ncbi.nlm.nih.gov/articles/PMC3001853/table/T0001)):

مؤشر الحرارة (°C) | الفئة | الأثر المحتمل
54 فأكثر | خطر شديد | ضربة شمس مرجحة
41 – 54 | خطر | تقلصات وإنهاك حراري مرجح، وضربة شمس ممكنة مع الاستمرار
32 – 41 | حذر شديد | تقلصات وإنهاك حراري ممكن مع التعرض الطويل
27 – 32 | حذر | إرهاق مع التعرض الطويل أو المجهود

لا تُخلط الأرقام بين المؤشرات: 32°C في WBGT تعني خطرًا عاليًا، بينما 32°C في مؤشر الحرارة بداية الحذر فقط.

## أدوات وأجهزة تلطيف الأجواء الخارجية

كل أداة تخفض مكوّنًا مختلفًا من WBGT، ولهذا تُصنف هنا أيضًا حسب المكوّن الذي تؤثر فيه:

- الظل يخفض حرارة الكرة السوداء (Tg، وزنها 20%).
- التبريد بالتبخير يخفض حرارة الهواء (Ta، وزنها 10%) لكنه يرفع الرطوبة، فيبقى الترمومتر الرطب (Tnw، وزنه 70%) شبه ثابت. لذلك أثره على رقم WBGT أقل من أثره على الإحساس.
- التكييف بالتبريد الميكانيكي يخفض الحرارة والرطوبة معًا، فيخفض Tnw، وهو الأكثر خفضًا لـ WBGT لكنه الأعلى كلفة.

### الصنف الأول: قابل للأتمتة

أجهزة تعمل بالكهرباء أو بمحرك، فيمكن تشغيلها وإيقافها وضبطها آليًا بحساسات ومتحكمات.

الأداة | كيف تعمل | المكوّن الذي تخفضه | ما يُتحكم فيه آليًا | ملاحظة تشغيلية
رشاشات الرذاذ عالي الضغط (Misting) | مضخة بضغط 500–1000 psi تدفع الماء عبر فوهات دقيقة جدًا فيتبخر في الهواء (براءة اختراع (https://image-ppubs.uspto.gov/dirsearch-public/print/downloadPdf/4721250)) | Ta | تشغيل/إيقاف المضخة والصمامات، تقسيم المناطق، دورات التشغيل | كلما كان الهواء أحر وأجف زاد التبريد؛ تحتاج ماء معالجًا وتنظيف فوهات
مراوح الرذاذ | مروحة تنفث رذاذًا مع تيار هواء | Ta + تبخير العرق | السرعة، الرذاذ، الدوران | في المسجد النبوي 436 مروحة على أعمدة المظلات، وكل عمود يستهلك نحو 200 لتر/ساعة (الرياض ديلي/واس (https://alriyadhdaily.com/article/eb0001f99e7540a1aefdd5f2b8cac8c2))
المبردات التبخيرية المتنقلة (الصحراوية) | يمر الهواء عبر وسادة مبللة فيبرد | Ta | التشغيل، السرعة، مضخة الماء | أقصى خفض ممكن = الفرق بين الترمومتر الجاف والرطب، وتضعف كفاءتها فوق رطوبة 50% (ITU (https://polen.itu.edu.tr/entities/publication/cc9b8a51-e417-4ab1-ad7d-4d3036967f73/full))
التكييف الموضعي الخارجي (Spot cooling) | هواء مبرد ميكانيكيًا يُدفع عبر فتحات قريبة من الناس، مثل فتحات تحت المقاعد في ملاعب قطر (فيفا (https://www.fifa.com/en/news/dr-cool-the-mastermind-behind-qatar-2022-s-air-cooled-stadiums)) | Ta + الرطوبة (Tnw) | درجة الحرارة المطلوبة، تدفق الهواء، المناطق | الأعلى فاعلية والأعلى استهلاكًا للطاقة
المكيفات المتنقلة للخيام والمناطق شبه المغلقة | تكييف ميكانيكي لمساحة محاطة | Ta + Tnw | الحرارة المطلوبة، التشغيل | فعالة فقط حين يكون المكان محاطًا جزئيًا
المراوح الكبيرة (بدون رذاذ) | تحريك الهواء لزيادة تبخر العرق | Tnw (بزيادة الرياح) | السرعة والتشغيل | في الحر الشديد الجاف قد تزيد الإجهاد؛ بحث جامعة سيدني يقترح حدًا قرابة 39°C للشباب الأصحاء (جامعة سيدني (https://www.sydney.edu.au/news-opinion/news/2021/06/11/air-conditioning-unnecessary-in-majority-of-heatwave-conditions-.html))
المظلات الآلية القابلة للطي | مظلات كبيرة تفتح وتغلق بمحركات | Tg | الفتح والإغلاق حسب الوقت أو الشمس أو الرياح | مثال: 250 مظلة آلية في ساحات المسجد النبوي (عكاظ (https://www.okaz.com.sa/news/local/2200586))
الستائر والمظلات المتحركة (برجولات بشرائح، مظلات قابلة للسحب) | ظل يتحرك بمحرك | Tg | زاوية الشرائح، الفتح والسحب | مناسبة للممرات والجلسات

### الصنف الثاني: غير مؤتمت (تشغيل يدوي من فريق المشغلين)

أجهزة وأدوات يركّبها فريق التشغيل ويشغّلها ويتابعها بيده في العادة، وليس فيها تحكم إلكتروني. لبعضها نسخ مؤتمتة مذكورة في الصنف الأول، لكن النسخ الشائعة ميدانيًا يدوية.

الأداة | كيف تعمل | المكوّن الذي تخفضه | مهمة فريق المشغلين
المظلات اليدوية (مظلات بذراع أو رافعة يدوية) | تُفتح وتُغلق باليد لتوفير ظل | Tg | فتحها وتوجيهها مع حركة الشمس، وإغلاقها عند الرياح القوية. الظل يخفض الحرارة الإشعاعية بفارق كبير، ففي دراسة ميدانية انخفضت نحو 28°C مقابل 1–2°C للهواء (HIT (https://scholar.hit.edu.cn/en/publications/field-assessment-of-neighboring-building-and-tree-shading-effects/))
الأشرعة والمظلات القماشية المؤقتة | قماش مشدود على أعمدة أو حبال | Tg | التركيب والشد وتعديل الزاوية، والفك عند الرياح
الخيام والسرادقات المتنقلة | مساحة مظللة شبه مغلقة | Tg (وتسمح بالتكييف داخلها) | النصب، ورفع الستائر الجانبية وإنزالها حسب اتجاه الشمس والتهوية
مراوح الرذاذ المتنقلة بخزان | مروحة مع خزان ماء ومضخة صغيرة | Ta | النقل والتوزيع، تعبئة الخزان، التشغيل والإيقاف بالمفتاح، تنظيف الفوهات
المبردات التبخيرية المتنقلة (الصحراوية) | هواء يمر على وسادة مبللة | Ta | تعبئة الماء وإضافة الثلج، تغيير الوسائد، تحريكها نحو أماكن التجمع
خطوط الرذاذ منخفضة الضغط | خرطوم بفوهات يعمل بضغط ماء الشبكة | Ta | فتح المحبس وإغلاقه يدويًا، ومراقبة تبلل الأرضيات وخطر الانزلاق
رش الأرضيات والممرات بالماء | خراطيم أو صهاريج ماء لتبريد الأسطح الساخنة | Tg (حرارة الأسطح) | الرش في أوقات الذروة، مع تجنب تجمّع الماء
المراوح المتنقلة (أرضية وعمودية) | تحريك الهواء | Tnw (بزيادة الرياح) | التوزيع والتوجيه والتشغيل، مع الحذر في الحر الجاف جدًا
المكيفات المتنقلة للخيام | تكييف ميكانيكي لمساحة محاطة | Ta + Tnw | التوصيل، ضبط الحرارة يدويًا، تصريف الماء، إغلاق الفتحات
مولدات الكهرباء المتنقلة | تغذية الأجهزة في المواقع بلا كهرباء | لا تخفض شيئًا مباشرة | التشغيل والوقود والصيانة، وتوزيع الأحمال على الأجهزة
جهاز WBGT المحمول | قياس يدوي للإجهاد الحراري | — (أداة قياس) | أخذ القراءات دوريًا في نقاط محددة، وتسجيلها، ورفع مستوى الاستجابة حسب جدول الأعلام

## المصادر

- ISO 7243:2017 – وصف المعيار (EVS) (https://www.evs.ee/en/iso-7243-2017)
- حدود WBGT وفق EN ISO 7243:2017 – Certifico (https://certifico.com/component/attachments/download/7733)
- جدول حدود ISO 7243 – نشرة أجهزة KEM (https://www.kem.kyoto/en/wp-content/uploads/sites/2/2023/07/WBGT-301WBGT-302_CN131A.pdf)
- WBGT ومعادلته – هيئة الأرصاد الأمريكية NWS (https://www.weather.gov/mpx/wbgt)
- حاسبة WBGT وجدول الأعلام – NWS (https://www.weather.gov/epz/wxcalc_wbgt)
- فئات UTCI – thermofeel (ECMWF) (https://thermofeel.readthedocs.io/en/stable/guide/utci/)
- جدول مؤشر الحرارة – NWS (https://www.weather.gov/media/unr/heatindex.pdf)
- فئات مؤشر الحرارة – PMC/NOAA (https://pmc.ncbi.nlm.nih.gov/articles/PMC3001853/table/T0001)
- Humidex – حكومة كندا (https://www.canada.ca/en/services/environment/weather/severeweather/humidex.html)
- عوامل الإجهاد الحراري – AIHA (https://publications.aiha.org/202004-heat-and-humidity)
- نظام الرذاذ عالي الضغط – براءة اختراع USPTO 4721250 (https://image-ppubs.uspto.gov/dirsearch-public/print/downloadPdf/4721250)
- مراوح الرذاذ في المسجد النبوي – الرياض ديلي/واس (https://alriyadhdaily.com/article/eb0001f99e7540a1aefdd5f2b8cac8c2)
- المظلات الآلية في المسجد النبوي – عكاظ (https://www.okaz.com.sa/news/local/2200586)
- كفاءة المبردات التبخيرية – ITU (https://polen.itu.edu.tr/entities/publication/cc9b8a51-e417-4ab1-ad7d-4d3036967f73/full)
- التبريد الموضعي في ملاعب قطر – FIFA (https://www.fifa.com/en/news/dr-cool-the-mastermind-behind-qatar-2022-s-air-cooled-stadiums)
- حدود استخدام المراوح في الحر – جامعة سيدني (https://www.sydney.edu.au/news-opinion/news/2021/06/11/air-conditioning-unnecessary-in-majority-of-heatwave-conditions-.html)
- أثر الظل على الحرارة الإشعاعية – HIT (https://scholar.hit.edu.cn/en/publications/field-assessment-of-neighboring-building-and-tree-shading-effects/)
