SARAHXL1/Expo2023-HABOOB/docs/system-docs/هبوب منظومة الراحه الحراريه.docx

تحدي إكسبو 2030 الرياض

مسار الاستدامة والأثر البيئي

منظومة الراحة الحرارية للمساحات الخارجية

وصف فكرة الحل

التحدي 2.3: الراحة الحرارية في المناطق الخارجية

مسودة عمل – الإصدار 0.1

سبتمبر 2026

# أولًا: المسار – الاستدامة والأثر البيئي

يُعنى هذا المسار بتطوير حلول تقلل الأثر البيئي لموقع إكسبو 2030 الرياض أثناء تشغيله، عبر إدارة أذكى للمياه والطاقة والموارد. ويرفع المسار السؤال من "كيف نشغّل الموقع؟" إلى "كيف نشغّله بكفاءة ودون هدر؟".

وتزداد أهمية هذا المسار بالنظر إلى حجم الحدث؛ إذ يُقام المعرض في الفترة من 1 أكتوبر 2030 إلى 31 مارس 2031، ويستهدف 40 مليون زيارة. كما أن المخطط العام للمعرض يجمع بين مفهومي الواحة والحديقة، وهما أصل اسم مدينة الرياض، مما يجعل المساحات الخارجية جزءًا أساسيًا من هوية الموقع وتجربة زواره.

# ثانيًا: التحدي – 2.3 الراحة الحرارية في المناطق الخارجية

ينص التحدي على إبقاء المناطق الخارجية صالحة للاستخدام حين تتغير الحرارة والرطوبة والرياح على مدار اليوم، بينما لا تُقاس هذه الظروف إلا في نقاط ثابتة قليلة.

وعليه، فإن التحدي لا يطلب مجرد قياس الطقس، بل ضمان بقاء المساحات قابلة للاستخدام الفعلي في ظروف متغيرة وبمعلومات محدودة.

# ثالثًا: المشكلة والمشكلات الفرعية

## 1. المشكلة الرئيسية

يفتقر المشغلون إلى صورة دقيقة ولحظية لمدى صلاحية كل منطقة خارجية للاستخدام؛ لذلك تُتخذ قرارات التبريد والتدفئة والتظليل وتوزيع الأنشطة كرد فعل بعد تدهور الظروف، لا استباقًا له. والنتيجة تجربة زائر متراجعة، وموارد مياه وطاقة تُستهلك دون معرفة أثرها الفعلي.

## 2. المشكلات الفرعية

تتفرع عن المشكلة الرئيسية خمس مشكلات:

1. فجوة التغطية المكانية: نقاط القياس الثابتة القليلة لا تعكس التباين الحاد بين منطقة وأخرى؛ فساحة مكشوفة وأخرى مظللة تفصل بينهما أمتار قليلة قد تختلفان جذريًا في صلاحيتهما للاستخدام، والقراءة الواحدة لا تمثل الموقع كله.
2. قياس لا يعبّر عن إحساس الإنسان: حرارة الهواء وحدها لا تحدد الراحة الحرارية في الأماكن المفتوحة؛ إذ تؤثر أشعة الشمس والحرارة المنبعثة من الأسطح والرياح والرطوبة مجتمعةً في إحساس الزائر، وتجاهلها يعطي صورة مضللة. فالمنطقتان اللتان تسجلان حرارة الهواء نفسها قد يختلف الإحساس فيهما اختلافًا كبيرًا.
3. الفجوة الزمنية وتأخر القرار: تتغير الظروف خلال ساعات اليوم، والمشغل الذي يعتمد على قراءات لحظية فقط يكتشف المشكلة بعد وقوعها، ولا يملك مؤشرًا مبكرًا يتيح له الاستعداد.
4. فجوة التحويل إلى قرار: حتى مع توفر البيانات، تبقى أرقامًا خامًا تتطلب خبرة وتحليلًا لفهمها، بينما يحتاج المشغل في غرفة العمليات إلى إجابة مباشرة: أي منطقة تحتاج تدخلًا؟ وما التدخل المناسب؟
5. هدر الموارد دون قياس الأثر: تستهلك الرشاشات والمكيفات والدفايات الخارجية مياهًا وطاقة كبيرة، ولا توجد عادةً آلية تقيس هل حسّن تشغيلها الظروف فعلًا، وبأي قدر، وبأي تكلفة؛ فتستمر الموارد في العمل حيث لا تُحدث فرقًا يُذكر.

## 3. البعد الموسمي

تمتد فترة المعرض من أواخر الصيف حتى الشتاء، فتواجه المساحات الخارجية الحر في أسابيعها الأولى وأوقات الظهيرة، والبرودة والرياح في ليالي الشتاء، وهو ما يتطلب حلًا يتعامل مع الاتجاهين معًا.

# رابعًا: فكرة الحل

الحل منظومة متكاملة موجهة للمشغلين، تحوّل الظروف المناخية في المساحات الخارجية إلى قرارات تشغيلية واضحة. وتنتقل المنظومة من سؤال "كم درجة الحرارة؟" إلى سؤال "هل هذه المنطقة صالحة للاستخدام الآن وخلال الساعات القادمة؟ وما أنسب إجراء لها؟".

وتعتمد المنظومة على أعمدة استشعار مدمجة في تصميم الموقع، بارتفاع أعمدة إنارة الحدائق، تقيس العوامل المؤثرة فعليًا في الراحة الحرارية. وتُرسل هذه القياسات إلى منصة تحللها وتحولها إلى مؤشر مفهوم لقابلية الاستخدام، يقدّر حالة المناطق الواقعة بين الأعمدة ويتوقع تغيرها، ثم يقترح على المشغل الإجراء المناسب: تشغيل الرشاشات، أو التبريد، أو التدفئة، أو إعادة توجيه الزوار أو الأنشطة.

وتتميز المنظومة بحلقة تقييم مستمرة؛ فبعد تنفيذ أي إجراء تقيس المنظومة أثره الفعلي على المنطقة، وبذلك تتعلم مع الوقت أي الموارد أكثر فاعلية في كل موقع وتوقيت، فتوجّه تشغيلها حيث يُحدث فرقًا حقيقيًا، وتتجنب تشغيلها حيث يكون هدرًا.

# خامسًا: آلية العمل

تعمل المنظومة عبر ثلاث مراحل متتابعة:

## المرحلة الأولى: الاستشعار والجمع (عمود الاستشعار)

يقيس كل عمود الظروف المحيطة على مستوى إحساس الإنسان: حرارة الهواء، والرطوبة، وسرعة الرياح، وأثر الإشعاع الشمسي، وحرارة الأسطح، ثم يرسل هذه البيانات الخام دوريًا إلى المنصة. ويقتصر دور العمود على القياس الدقيق والإرسال الموثوق.

## المرحلة الثانية: التحليل واتخاذ القرار (الخادم والخوارزميات والذكاء الاصطناعي)

تستقبل المنصة البيانات وتنقّيها وتعايرها، ثم تنفذ الخطوات التالية:

- حساب مؤشر قابلية الاستخدام لكل منطقة استنادًا إلى مؤشرات الراحة الحرارية المعتمدة علميًا.
- تقدير حالة المناطق التي لا تحتوي على أعمدة، بالاستفادة من خصائص كل منطقة كالتظليل ونوع الأرضية واتجاه الشمس.
- توقع تغير الظروف خلال الساعات القادمة.
- توليد توصيات تشغيلية مرتبة حسب الأولوية.
- تقييم أثر الإجراءات المنفذة لتحسين التوصيات لاحقًا.

## المرحلة الثالثة: العرض والتنفيذ (واجهة المشغلين)

تعرض الواجهة حالة الموقع كاملًا على خريطة بألوان تدل على قابلية الاستخدام، مع التنبيهات والتوصيات الجاهزة للتنفيذ. وقد صُممت الواجهة لتمكّن المشغل من فهم الوضع واتخاذ القرار خلال ثوانٍ، دون الحاجة إلى تفسير أرقام أو رسوم معقدة. ويبقى القرار النهائي بيد المشغل، إذ يعتمد التوصية أو يعدّلها.

# سادسًا: مميزات الحل وارتباطها بمعايير التقييم

يوضح الجدول (1) ارتباط مميزات الحل بمعايير التقييم المعتمدة في التحدي وأوزانها.

المعيار | الوزن | المميزات المرتبطة
الابتكار والإبداع | 25% | - ينتقل الحل من قياس الطقس إلى قياس قابلية الاستخدام كما يشعر بها الإنسان. - لا يكتفي بزيادة نقاط القياس، بل يقدّر الحالة بين النقاط ويتوقعها. - يضيف حلقة تقييم تقيس أثر كل مورد وتتعلم منه. - التصميم الخارجي للعمود مستلهم من المشربية التقليدية التي عالجت تاريخيًا المشكلة نفسها: الظل مع التهوية، والغلاف الزخرفي يؤدي وظيفة هندسية في حماية الحساسات من الإشعاع، لا وظيفة جمالية فقط.
جدوى الحل وقابلية التطبيق | 25% | - يعتمد على مكونات متاحة ومنخفضة التكلفة نسبيًا. - تندمج الأعمدة في البنية التحتية للإنارة والتنسيق الخارجي، ولا تُضاف كمعدات غريبة عن الموقع. - قدرة التقدير بين الأعمدة تقلل عدد الأعمدة المطلوبة لتغطية الموقع. - يبقى القرار النهائي للمشغل، مما يسهّل تبني المنظومة ضمن إجراءات التشغيل القائمة. - البنية قابلة للتوسع لاحقًا لخدمة فريق المسطحات الخضراء وإدارة الري.
الجودة التقنية والتنفيذ | 20% | - تتكامل في المنظومة تخصصات هندسة الاستشعار والإلكترونيات، وتحليل البيانات والذكاء الاصطناعي، وتطوير الخادم، وتصميم تجربة المستخدم. - يمثل كل تخصص حلقة لا تعمل المنظومة بدونها. - القياس مبني على أسس علمية معتمدة في قياس الراحة الحرارية، لا على قراءات حرارة مجردة.
الارتباط بمستهدفات إكسبو 2030 | 20% | - يخدم الاستدامة مباشرة عبر ترشيد استهلاك المياه والطاقة في التبريد والتدفئة الخارجية. - يرتقي بتجربة الزائر في المساحات المفتوحة التي تمثل جوهر مفهوم الواحة والحديقة في المخطط العام. - يعكس الهوية السعودية عبر زخارف قابلة للتخصيص حسب كل جناح. - يحمل قيمة إرثية؛ إذ صُمم المعرض ليبقى إرثًا دائمًا لا ليُفكك بعد انتهائه، مما يتيح للمنظومة الاستمرار في خدمة الحي بعد المعرض.
جودة العرض | 10% | - لحظة الإثبات في العرض بصرية ومباشرة: تتغير الظروف حول النموذج أمام اللجنة، فيتغير المؤشر على الواجهة، وتظهر التوصية، ثم يُقاس أثر تنفيذها لحظيًا.

جدول (1): ارتباط مميزات الحل بمعايير التقييم

# سابعًا: مكونات الحل

## 1. وحدة الاستشعار الميدانية (العمود)

- الحساسات:
  - حساس حرارة الهواء والرطوبة.
  - مقياس الحرارة الكروي لقياس أثر الإشعاع الشمسي.
  - مقياس سرعة الرياح.
  - حساس حرارة الأسطح بالأشعة تحت الحمراء.
  - حساس شدة الإضاءة (اختياري).
- المعالجة والاتصال: متحكم دقيق (ESP32) يقرأ الحساسات ويرسل البيانات لاسلكيًا إلى المنصة.
- الهيكل والحماية:
  - عمود بارتفاع يتراوح بين متر ومتر ونصف.
  - غلاف زخرفي مثقّب يعمل كواقٍ من الإشعاع مع تهوية للحساسات.
  - قفص زخرفي يحمي المقياس الكروي.
  - تصميم مقاوم للظروف الخارجية.
- الطاقة: تغذية كهربائية للنموذج الأولي، مع إمكانية الربط بشبكة الإنارة في التطبيق الفعلي.

## 2. الخادم ومعالجة البيانات (Backend)

- استقبال البيانات: واجهة برمجية (API) لاستقبال القراءات من الأعمدة.
- التخزين: قاعدة بيانات للقراءات الزمنية، ولبيانات المناطق وخصائصها، ولسجل الإجراءات المنفذة.
- التنقية والمعايرة: معالجة القراءات الشاذة أو المفقودة، وتوحيد معايرة الأعمدة فيما بينها.

## 3. التحليل والذكاء الاصطناعي

- مؤشر قابلية الاستخدام: يحدد حالة كل منطقة (صالحة، محدودة، غير صالحة) بناءً على مؤشر راحة حرارية معتمد.
- نموذج التقدير المكاني: يقدّر حالة المناطق الواقعة بين الأعمدة.
- نموذج التوقع قصير المدى: يتنبأ بتغير الحالة خلال الساعات القادمة.
- محرك التوصيات: يقترح الإجراء المناسب لكل منطقة ويرتبه حسب الأولوية.
- تقييم الكفاءة: يقيس أثر كل مورد مقارنة باستهلاكه، ويغذي التوصيات المستقبلية.

## 4. واجهة المشغلين (Frontend)

- الخريطة الرئيسية: تعرض حالة جميع المناطق بألوان واضحة.
- صفحة المنطقة: تفاصيل الحالة الحالية والمتوقعة والعوامل المؤثرة فيها.
- لوحة التوصيات والتنبيهات: إجراءات جاهزة للاعتماد أو التعديل.
- تقارير الكفاءة: أثر الموارد واستهلاكها بمرور الوقت.

## 5. الهوية البصرية والتصميم

- أغلفة زخرفية قابلة للتبديل: مستوحاة من أنماط الزخرفة السعودية (النجدي، والسدو، والقط العسيري، والرواشين الحجازية، وغيرها) بحسب هوية كل جناح.
- تكامل الشكل مع الوظيفة: الزخرفة نفسها تؤدي دورًا في حماية الحساسات وتهويتها.

# ملحق: ملاحظات العمل قبل الاعتماد

هذا الملحق للاستخدام الداخلي، ويُحذف من النسخة النهائية.

## أولًا: بنود مؤكدة من الفريق

- المسار والتحدي، وفئة المستخدمين (المشغلون).
- المراحل الثلاث، ووجود واجهة سهلة.
- الموارد المستهدفة (الدفايات والرشاشات والمكيفات).
- الارتفاع، والزخارف القابلة للتخصيص.
- التوسع المستقبلي لخدمة المسطحات.

## ثانيًا: بنود مقترحة أُدرجت في النص (تُحذف إن لم تُعتمد)

- مؤشر قابلية الاستخدام.
- التقدير بين الأعمدة والتوقع.
- حلقة تقييم الكفاءة.
- فكرة الغلاف كواقٍ من الإشعاع.
- بقاء القرار بيد المشغل.

## ثالثًا: بنود موثقة بمصادر

- تواريخ المعرض، وعدد الزيارات المستهدفة، ومفهوم الواحة والحديقة، والطابع الإرثي للموقع.

## رابعًا: بنود تحتاج إلى تحقق

- محاور إكسبو الفرعية: تختلف تسمياتها بين المصادر، فلم تُذكر بالاسم. والشعار في الموقع الرسمي هو (Foresight for Tomorrow)، ويجب اعتماد الصياغة الرسمية.
- تقليل عدد الأعمدة المطلوبة، وترشيد الاستهلاك: هدفان يحتاجان إلى اختبار لإثباتهما، ولا يُقدَّمان بوصفهما نتائج.

## خامسًا: أسئلة مفتوحة

1. اسم الحل: يحتاج الملف والعرض إلى اسم معتمد؛ هل لدى الفريق اسم، أم تُقترح خيارات؟
2. قائمة الحساسات المتوفرة: مطلوبة لضبط قسم المكونات بدقة.
3. الإدارة الآلية للموارد: هل يُضاف تشغيل الرشاشات دون تدخل بشري بوصفه عملًا مستقبليًا، أم يبقى القرار دائمًا بيد المشغل؟

## المصادر

1. Saudipedia. Riyadh Expo 2030. saudipedia.com/en/riyadh-expo-2030
2. Expomuseum. Expo 2030 Riyadh. expomuseum.com/expo-2030-riyadh
3. MICE Times. What "Expo 2030 Riyadh" Envisions. micetimes.jp/en/expo-2030-en
4. Expo 2030 Riyadh (الموقع الرسمي). expo2030riyadh.sa/en

منظومة الراحة الحرارية للمساحات الخارجية – وصف فكرة الحل
