SARAHXL1/Expo2023-HABOOB/docs/ux-ui/فيد باك النسخه الاولى لواجهات هبوب.docx

# ملاحظات تطوير واجهات منصة «هبوب | HABOOB»

## مراجعة شاملة لتجربة المستخدم (UX)، تصميم الواجهات (UI)، والوظائف التشغيلية

الهدف من المراجعة: تطوير واجهات منصة «هبوب» لتكون أكثر وضوحًا وفعالية لفريق إدارة وتشغيل المساحات الخارجية، مع التركيز على سهولة الوصول إلى المعلومات، تقليل خطوات المستخدم، وربط صفحات النظام ببعضها استعدادًا لتحويل النموذج الأولي إلى نظام تشغيلي فعلي.

جرى تنظيم الملاحظات الواردة في التسجيلات بحسب صفحات المنصة ووظائفها، مع الحفاظ على جميع المتطلبات والاقتراحات والنقاط التي تحتاج إلى مناقشة أو تحديد لاحقًا.

هناك تمييز مهم بين ثلاثة أنواع من الملاحظات:

- متطلب أساسي: وظيفة أو تعديل أكّد التسجيل ضرورة وجوده في النظام.
- تحسين مقترح: تعديل يُفضّل تنفيذه، مع ترك حرية اختيار التصميم المناسب للفريق.
- اختياري أو قابل للنقاش: فكرة لم يُحسم شكلها النهائي، أو ذُكر أن تنفيذها يعتمد على الوقت المتاح.

# أولًا: الصفحة الرئيسية (Overview / Dashboard)

## 1. ربط خريطة إكسبو بالخريطة الحية

المشكلة الحالية:

تُعرض خريطة إكسبو في الصفحة الرئيسية، لكن التفاعل معها لا يحقق الانتقال المطلوب إلى الخريطة الحية وتفاصيل المناطق.

التعديل المطلوب:

1. جعل خريطة إكسبو الموجودة في الصفحة الرئيسية قابلة للتفاعل.
2. عند الضغط على الخريطة أو إحدى مناطقها، يتم الانتقال إلى صفحة الخريطة الحية.
3. عند اختيار منطقة معينة، يجب أن تظهر التفاصيل المرتبطة بالمنطقة المحددة.
4. تشمل التفاصيل حالة المنطقة، والفعاليات الموجودة فيها، والمعلومات التشغيلية ذات العلاقة.
5. يجب أن تكون تفاصيل المنطقة أوضح وأكثر اكتمالًا من المعلومات المختصرة المعروضة في الصفحة الرئيسية.

الهدف:

أن تكون خريطة الصفحة الرئيسية نقطة وصول سريعة للخريطة الحية، دون الحاجة إلى الانتقال يدويًا عبر القائمة الجانبية.

## 2. إعادة تقييم بطاقات الإحصائيات الرئيسية (KPIs)

المشكلة الحالية:

تعرض الصفحة الرئيسية بطاقات إحصائية مثل:

- إجمالي المناطق الخارجية.
- المناطق المريحة.
- المناطق التي تحتاج متابعة.
- المناطق الحرجة.
- التنبيهات النشطة.

لكن لا يتضح الأساس الذي تعتمد عليه هذه التصنيفات أو المعايير المستخدمة لحساب الأرقام.

التعديل المطلوب:

أ. توضيح أساس التصنيف

يجب أن يكون واضحًا للمستخدم على أي أساس صُنفت المناطق إلى مريحة أو تحتاج متابعة أو حرجة.

هل تعتمد التصنيفات على مؤشر الإجهاد الحراري؟ أم حالة التشغيل؟ أم معايير أخرى؟

لا بد من تحديد هذه المعايير وإظهارها بصورة مناسبة في الواجهة.

ب. مراجعة القيمة الفعلية لكل بطاقة

ينبغي تقييم المعلومات الموجودة من وجهة نظر فريق المشغلين.

السؤال الأساسي هو: ما المعلومة التي يحتاج المشغّل إلى معرفتها فور فتح المنصة، والتي تساعده على اتخاذ إجراء أو الوصول إلى مشكلة بسرعة؟

ليس الهدف عرض أرقام لمجرد وجودها، وإنما تقديم معلومات ذات قيمة تشغيلية.

ج. تحويل البطاقات إلى اختصارات تفاعلية

يُفضّل أن تكون بطاقات الإحصائيات قابلة للضغط، وأن تنقل المستخدم مباشرة إلى الصفحة المرتبطة بالمعلومة.

على سبيل المثال، عند الضغط على «إجمالي المناطق الخارجية»، ينتقل المستخدم إلى الخريطة الحية.

وينطبق المبدأ نفسه على بقية البطاقات بحسب طبيعتها.

ملاحظة: لم يُحدد في التسجيل تصميم نهائي لهذه البطاقات أو مجموعة بديلة من المؤشرات. المطلوب من الفريق دراسة المعلومات الأنسب لشخصية المستخدم الأساسية، وهي فريق التشغيل والإدارة.

## 3. تحسين عرض حالة شبكة المستشعرات

المشكلة الحالية:

تظهر في الصفحة الرئيسية معلومة مثل:

«36 عمود استشعار متصل».

لكن عرض الرقم وحده لا يساعد المستخدم على فهم الحالة التشغيلية للشبكة.

التعديل المطلوب:

1. إظهار عدد المستشعرات المتصلة مقارنة بإجمالي عدد المستشعرات.
2. توضيح ما إذا كانت هناك مستشعرات غير متصلة.
3. توضيح وجود مستشعرات تحتاج إلى صيانة أو تدخل.
4. جعل هذه المعلومة قابلة للضغط للانتقال مباشرة إلى صفحة شبكة المستشعرات.

مثال توضيحي لشكل العرض، وليس بيانات فعلية:

«36 من أصل 37 عمود استشعار متصل».

بهذه الطريقة يستطيع المستخدم معرفة أن هناك عمودًا غير متصل، بدل الاكتفاء برقم لا يوضح الصورة الكاملة.

ملاحظة إضافية:

يوجد حاليًا إشعار يشير إلى وجود مستشعر واحد غير متصل. يُفضّل إعادة النظر في موضع هذا الإشعار بحيث يظهر بصورة أنسب ضمن المعلومات المتعلقة بشبكة المستشعرات.

## 4. تحسين وضوح المنطقة المحددة على الخريطة

المشكلة الحالية:

عند الضغط على إحدى المناطق داخل الخريطة، لا يكون واضحًا بصورة كافية أي منطقة اختارها المستخدم.

اللون أو تأثير التحديد الحالي غير بارز بما يكفي، كما ظهر في المثال المذكور عن المنطقة W.

التعديل المطلوب:

1. تحسين الحالة البصرية للمنطقة المحددة (Selected State).
2. استخدام لون أو درجة تظليل أكثر وضوحًا.
3. يمكن تغميق المنطقة المحددة أو إضافة حدود بارزة حولها.
4. يجب أن يستطيع المستخدم معرفة المنطقة المحددة مباشرة دون البحث عن اسمها أو محاولة استنتاجها من التصميم.

الهدف:

زيادة وضوح التفاعل وتقليل الالتباس عند التنقل بين المناطق.

## 5. تحسين مفتاح ألوان حالات المناطق (Map Legend)

المشكلة الحالية:

تظهر تصنيفات مثل:

- مريحة.
- إجهاد حراري.
- حرجة.
- تنبيه.

لكن طريقة عرض التصنيفات لا توضح معناها أو حجم تأثيرها بصورة كافية.

التحسين المقترح:

إعادة تصميم مفتاح الألوان ليكون أكثر وضوحًا، مع إمكانية إضافة أرقام أو إحصائيات مرتبطة بكل حالة.

يمكن، على سبيل المثال، توضيح عدد المناطق الموجودة ضمن كل تصنيف.

درجة الأولوية: تحسين اختياري.

لم يُطلب تصميم محدد أو إضافة جميع الإحصائيات بالضرورة، وإنما تحسين الوضوح العام بحسب ما يراه الفريق مناسبًا.

## 6. إعادة تنظيم بطاقة المنطقة المحددة

المشكلة الحالية:

المعلومات المعروضة عن المنطقة المحددة تحتاج إلى إعادة ترتيب، بحيث يظهر المؤشر الأساسي وحالة المنطقة بصورة أوضح.

التعديل المطلوب:

### أ. إبراز المؤشر الأساسي

عند اختيار منطقة، يجب أن يظهر المؤشر الرئيسي المرتبط بحالتها بصورة واضحة.

ويُعرض معه التصنيف المقابل للقيمة، مثل «معتدل».

### ب. إضافة وصف مختصر للحالة

لا يكفي عرض قيمة المؤشر والتصنيف فقط.

يُضاف وصف قصير يشرح معنى حالة المنطقة وما إذا كانت الظروف مناسبة أو تستدعي الانتباه.

ملاحظة: سيُقدَّم ملف مستقل يتضمن معلومات المؤشر، ومعاني تصنيفاته، والأجهزة المرتبطة بالنظام. ينبغي اعتماد هذه المعلومات عند كتابة الأوصاف، بدل صياغة تفسيرات غير مستندة إلى معايير المشروع.

### ج. مراجعة الإحصائيات الثانوية

يمكن إعادة ترتيب المعلومات الموجودة أسفل المؤشر، مثل:

- حالة الراحة في المنطقة.
- عدد الزوار.
- عدد الفعاليات.
- أي معلومات تشغيلية أخرى مناسبة.

المطلوب اختيار البيانات التي تعطي المستخدم تصورًا سريعًا عن وضع المنطقة.

لا توجد أرقام أو بطاقات محددة يجب إضافتها جميعًا؛ للفريق حرية اختيار الأنسب.

## 7. إعادة تنظيم القيم المناخية والأجهزة المرتبطة

المشكلة الحالية:

تستهلك بعض البطاقات مساحة يمكن استخدامها لعرض معلومات أخرى أكثر ارتباطًا بالتشغيل.

كما أن العلاقة بين القيم المناخية والأجهزة التشغيلية المرتبطة بالمنطقة ليست واضحة بما يكفي.

التعديل المطلوب:

أولًا: القيم المناخية

إعادة تنظيم عرض القيم المناخية، مع إمكانية تصغير بطاقاتها.

وتشمل:

1. درجة الحرارة.
2. الرطوبة.
3. سرعة الرياح.
4. الإشعاع الشمسي.

يجب توضيح أن هذه البيانات تمثل القراءات المناخية للمنطقة المحددة.

ثانيًا: الأجهزة والأنظمة المرتبطة

إضافة قسم واضح للأجهزة أو الأنظمة التشغيلية الموجودة في المنطقة.

يجب أن يوضح القسم وجود هذه الأجهزة وارتباطها بالنظام، بما في ذلك الأجهزة التي يمكن تشغيلها من خلال الأتمتة.

الهدف:

أن يستطيع المستخدم التمييز بين البيانات التي تقيسها المستشعرات والأنظمة التي يمكن استخدامها للتأثير في الظروف التشغيلية للمنطقة.

## 8. إعادة النظر في موضع قسم «يتطلب قرارك الآن»

المشكلة الحالية:

يظهر قسم «يتطلب قرارك الآن» بصورة بارزة عند فتح الصفحة الرئيسية، لكن مكانه وآلية ظهوره لا يبدوان مناسبين تمامًا.

كما لا تتضح طريقة التعامل معه بعد إغلاقه أو تجاوزه.

التعديل المطلوب:

1. إعادة تقييم موقع هذا القسم في الصفحة الرئيسية.
2. دراسة ما إذا كان الأنسب عرضه ضمن الصفحة أو من خلال نافذة منبثقة (Popup).
3. توضيح المكان الذي يمكن للمستخدم العودة إليه لمراجعة القرار.
4. توضيح وقت التنبيه أو الطلب؛ هل يشير إلى وقت إرساله أم وقت حدوث المشكلة؟
5. إظهار حالة القراءة، بحيث يعرف المستخدم ما إذا كان قد اطّلع على التنبيه سابقًا.
6. تحسين عرض المعلومات بما يساعد المستخدم على اتخاذ القرار.

ملاحظة:

لا يوجد اشتراط بنقل القسم إلى مكان محدد؛ المطلوب دراسة السيناريو الأنسب من منظور المستخدم.

يمكن الاحتفاظ به في الصفحة الرئيسية إذا أُعيد تصميمه بصورة أوضح.

## 9. نقل سجل العمليات إلى قسم الصيانة والعمليات

المشكلة الحالية:

يوجد سجل للعمليات ضمن الصفحة الرئيسية، لكن طبيعة العمليات المسجلة فيه غير واضحة.

هل هي:

- قراءات المستشعرات؟
- عمليات الصيانة؟
- المهام المسندة للعاملين؟
- الإجراءات التشغيلية المنفذة؟

التعديل المطلوب:

1. توضيح المقصود بسجل العمليات ونوعية المعلومات التي يحتوي عليها.
2. إعادة النظر في وجوده داخل الصفحة الرئيسية.
3. يُفضّل نقله إلى صفحة «الصيانة والعمليات».
4. ربط السجل بالمهام والإجراءات التي يقوم بها فريق التشغيل والصيانة.
5. إظهار تفاصيل العمليات بشكل يفيد المدير عند مراجعة الإجراءات والإسنادات.

الهدف:

وضع المعلومات في القسم الأكثر ارتباطًا بوظيفتها بدل توزيعها بطريقة قد تربك المستخدم.

## 10. ربط توقعات الساعات القادمة بالمنطقة المحددة

المشكلة الحالية:

تعرض الصفحة الرئيسية توقعات الساعات القادمة، لكن هذه التوقعات لا تتغير عند تغيير المنطقة المحددة.

كذلك لا يتضح ما إذا كانت التوقعات تخص منطقة معينة أو متوسط جميع المناطق.

التعديل المطلوب:

1. ربط بيانات التوقعات بالمنطقة التي يحددها المستخدم.
2. تحديث التوقعات عند اختيار منطقة مختلفة.
3. توضيح المنطقة التي تمثلها البيانات.
4. عرض متوسطات أو توقعات المنطقة المحددة بما يساعد المستخدم على تقييم حالتها مستقبلًا.

الهدف:

أن تكون التوقعات مرتبطة بسياق المستخدم الحالي، بدل عرض بيانات عامة لا يستطيع ربطها بمنطقة محددة.

## 11. تحسين قائمة الحساب الشخصي

المشكلة الحالية:

لا يؤدي الضغط على الحساب الشخصي إلى عرض معلومات أو خيارات واضحة.

كما أن تسجيل الخروج غير متاح بصورة ظاهرة.

التعديل المطلوب:

إضافة قائمة للحساب الشخصي تظهر عند الضغط على صورة المستخدم أو اسمه.

وتحتوي على:

1. الملف الشخصي.
2. إعدادات الحساب.
3. معلومات المستخدم.
4. تسجيل الخروج.

يمكن للفريق تنفيذ القائمة بالشكل المناسب دون الحاجة إلى تصميم معقد.

ملاحظة تقنية:

ستُبرمج وظائف تسجيل الدخول والإعدادات العامة والبريد وغيرها لاحقًا، لكن ينبغي أن تكون الواجهات مستعدة لهذه الوظائف.

## 12. الفصل بين إعدادات المستخدم وإعدادات النظام

المشكلة الحالية:

لا يتضح المقصود بزر «الإعدادات».

هل يشير إلى:

- إعدادات حساب المستخدم؟
- إعدادات شبكة المستشعرات؟
- إعدادات تشغيل المنصة؟

التعديل المطلوب:

توضيح الفرق بين إعدادات الحساب والإعدادات التشغيلية للنظام.

ويُفضّل عدم وضع الوظائف المختلفة تحت مسمى عام قد يسبب التباسًا للمستخدم.

# ثانيًا: الخريطة الحية (Live Map)

## 13. إعادة تنظيم صفحة الخريطة الحية

الملاحظة العامة:

الخريطة الموجودة حاليًا ستبقى جزءًا أساسيًا من الصفحة، لكن المطلوب إعادة تنظيم المحتوى والوظائف المحيطة بها.

الهدف أن تصبح الخريطة الحية مركزًا موحدًا لعرض المناطق والفعاليات وحالتها التشغيلية.

التعديل المطلوب:

تجميع المعلومات المرتبطة بالمناطق داخل صفحة الخريطة الحية، مع توفير وسائل واضحة للوصول إلى التفاصيل.

يُترك للفريق تحديد طريقة توزيع العناصر بصريًا بما يحقق أفضل تجربة استخدام.

## 14. إضافة عرض مختصر للفعاليات داخل الخريطة الحية

المشكلة الحالية:

لا تظهر الفعاليات المرتبطة بالمناطق الخارجية ضمن الخريطة الحية بالشكل المطلوب.

مع أن هذه المعلومات ضرورية لفريق التشغيل.

التعديل المطلوب:

إضافة جزء واضح يعرض الفعاليات المهمة المرتبطة بالمناطق الخارجية.

يمكن أن يكون عنوان الصفحة مثلًا:

«الخريطة والفعاليات».

أو يمكن الإبقاء على اسم الخريطة الحية مع إضافة قسم مستقل للفعاليات.

### البيانات المطلوب عرضها لكل فعالية

يحتوي كرت الفعالية على:

1. اسم الفعالية.
2. المنطقة التي تُقام فيها.
3. وقت الفعالية.
4. حالة الفعالية من ناحية الحاجة إلى التدخل.
5. معلومات مختصرة عن الفعالية.

التفاعل المطلوب:

عند الضغط على الفعالية، ينبغي أن يستطيع المستخدم الوصول إلى تفاصيل المنطقة المرتبطة بها.

ومن هناك يمكن الاطلاع على حالتها والأنظمة والأجهزة المرتبطة بها.

ملاحظة مهمة:

لا يُفضّل عرض جميع تفاصيل الفعاليات في الصفحة الرئيسية؛ لأن ذلك قد يسبب ازدحامًا بصريًا.

المكان الأساسي لعرض هذه المعلومات هو الخريطة الحية، مع إمكانية توفير اختصار لها في الصفحة الرئيسية.

## 15. تطوير صفحة تفاصيل المنطقة

صفحة تفاصيل المنطقة الحالية تحتاج إلى استكمال بعض المعلومات والوظائف.

التعديل المطلوب:

عند الدخول إلى أي منطقة، يجب أن تتوفر معلومات عن:

- الحالة الحالية للمنطقة.
- المؤشر الرئيسي وتصنيفه.
- وصف مختصر لمعنى الحالة.
- القيم المناخية.
- الفعاليات الموجودة داخل المنطقة.
- الأنظمة والأجهزة التشغيلية المرتبطة بها.
- شبكة المستشعرات الموجودة داخل المنطقة.
- المشكلات أو التنبيهات المتعلقة بالمنطقة.
- وسائل الانتقال إلى الصيانة أو إسناد المهام عند الحاجة.

ملاحظة:

هذه ليست مطالبة بإنشاء صفحة مختلفة عن صفحة تفاصيل المنطقة الموجودة؛ المطلوب تطوير الصفحة نفسها واستكمال المعلومات والروابط الناقصة.

## 16. توضيح عدد أعمدة الاستشعار في المنطقة

المشكلة الحالية:

في مثال المنطقة F «جادة الأمم»، تظهر معرفات مثل:

HBB-06 وHBB-30

لكن طريقة العرض لا توضح أن هذه المعرفات تمثل عمودَي استشعار مختلفين.

التعديل المطلوب:

1. توضيح عدد أعمدة الاستشعار الموجودة في المنطقة.
2. عرض معرف كل عمود بصورة مفهومة.
3. عدم الاكتفاء بعرض المعرفات دون تعريفها.
4. يمكن إضافة عبارة توضح أن المنطقة تحتوي على عمودَي استشعار، ثم عرض أرقامهما.

الهدف:

أن يفهم المستخدم طبيعة المعلومات دون الحاجة إلى تفسير رموز الأجهزة بنفسه.

## 17. تحسين وضوح المعلومات النصية داخل المنطقة

الملاحظة:

بعض المعلومات، مثل عدد الزوار، واضحة في معناها الحالي.

لذلك لا تتطلب بالضرورة إعادة تصميم كاملة.

لكن المعلومات المتعلقة بالمستشعرات والفعاليات تحتاج إلى تسميات ووصف أوضح.

التعديل المطلوب:

مراجعة النصوص والعناوين المعروضة، والتأكد من أن المستخدم يستطيع فهم المقصود بكل رقم أو معرف أو حالة.

# ثالثًا: صفحة المناطق (Zones)

## 18. دمج قائمة المناطق مع الخريطة الحية

المشكلة الحالية:

توجد صفحة مستقلة للمناطق، رغم أن المعلومات المعروضة فيها مرتبطة مباشرة بالخريطة الحية.

الفرق الأساسي أن صفحة المناطق تعرض المعلومات في شكل جدول، بينما تعرضها الخريطة بصورة مكانية.

هذا يؤدي إلى فصل وظيفتين مترابطتين في صفحتين مختلفتين.

التعديل المقترح:

دمج جدول المناطق داخل صفحة الخريطة الحية، بدل الاحتفاظ به بالضرورة كصفحة مستقلة.

يمكن وضع الجدول أسفل الخريطة أو في موضع آخر مناسب.

الهدف:

توفير طريقتين لعرض المناطق داخل الواجهة نفسها:

1. العرض الجغرافي من خلال الخريطة.
2. العرض التفصيلي من خلال الجدول.

## 19. إضافة البحث والتصفية إلى جدول المناطق

التعديل المطلوب:

توفير إمكانية:

- البحث عن منطقة بالاسم.
- تصفية المناطق.
- الوصول إلى المنطقة المطلوبة مباشرة.
- الاطلاع على البيانات الرئيسية للمنطقة من الجدول.

المعلومات المقترحة داخل الجدول:

اسم المنطقة، حالتها، درجة الحرارة، وبقية القيم والمعلومات التشغيلية المناسبة.

ملاحظة:

لم يُحدد التسجيل جميع أعمدة الجدول بصورة نهائية؛ المطلوب اختيار الأعمدة الأكثر فائدة للمستخدم.

## 20. تقليل خطوات الوصول إلى تفاصيل المنطقة

المشكلة الحالية:

قد يضطر المستخدم إلى تنفيذ عدة خطوات للوصول إلى المعلومات المطلوبة، مثل:

1. اختيار المنطقة.
2. الضغط على «فتح التفاصيل».
3. البحث داخل صفحة التفاصيل عن المعلومة.

وهذا يزيد عدد خطوات مسار المستخدم (User Flow).

التعديل المطلوب:

تبسيط مسار الوصول إلى المعلومات.

يُفضّل أن تظهر البيانات الأساسية مباشرة داخل الجدول، وأن يتيح الضغط على المنطقة فتح تفاصيلها دون خطوات إضافية غير ضرورية.

الهدف:

تقليل عدد التفاعلات المطلوبة لإنجاز المهمة وتحسين سرعة استخدام النظام.

# رابعًا: التنبيهات (Alerts)

## 21. إعادة تقييم وجود صفحة مستقلة للتنبيهات

الملاحظة:

قد لا تكون هناك حاجة للاحتفاظ بصفحة كاملة للتنبيهات إذا أمكن عرضها بصورة أكثر فاعلية في موضع آخر.

الخيارات المطروحة:

الخيار الأول: دمج التنبيهات داخل الصفحة الرئيسية أو أحد أقسام المنصة المرتبطة بها.

الخيار الثاني: عرض التنبيهات من خلال قائمة أو واجهة مختصرة يمكن الوصول إليها بسهولة.

الخيار الثالث: الإبقاء على صفحة التنبيهات المستقلة إذا كانت توفر تجربة استخدام أفضل.

التوجيه:

يُترك للفريق تقييم الخيار المناسب.

ليس المطلوب حذف صفحة التنبيهات بشكل إلزامي، وإنما تجنب الفصل غير الضروري بين الوظائف.

## 22. تحسين محتوى التنبيه نفسه

المشكلة الحالية:

عند ظهور تنبيه مثل «إجهاد حراري حرج»، يستطيع المستخدم معرفة طبيعة المشكلة، لكنه لا يعرف بالضرورة الإجراء المطلوب للتعامل معها.

التعديل المطلوب:

يجب أن يوضح التنبيه:

1. نوع المشكلة.
2. المنطقة المتأثرة.
3. وصف المشكلة بصورة مفهومة.
4. نوع التدخل المطلوب.

### أنواع التدخل المذكورة

أ. تدخل صيانة

عندما تكون المشكلة مرتبطة بعطل أو خلل يحتاج إلى معالجة فنية.

ب. تدخل تشغيلي أو إسناد

عندما تتطلب المشكلة توجيه أحد أفراد فريق التشغيل لتنفيذ مهمة.

ج. تدخل تلقائي (Automation)

عندما يكون بالإمكان معالجة الحالة من خلال الأنظمة الآلية المرتبطة بالمنصة.

الهدف:

تحويل التنبيه من مجرد عرض للمشكلة إلى معلومة تساعد المستخدم على فهم ما ينبغي فعله.

درجة الأولوية: تحسين مقترح يعتمد على الوقت المتاح.

ذُكر في التسجيل أن تنفيذ هذا التحسين ليس إلزاميًا إذا كان سيحتاج إلى وقت كبير.

كما سيُقدَّم ملف يتضمن المعلومات التفصيلية المرتبطة بالحالات والتدخلات.

# خامسًا: الفعاليات (Events)

## 23. ربط الفعاليات بالخريطة الحية

المشكلة الحالية:

توجد صفحة مستقلة للفعاليات، بينما يفترض أن تكون الفعاليات مرتبطة بالمناطق الخارجية الموجودة على الخريطة.

التعديل المقترح:

دمج عرض الفعاليات ضمن الخريطة الحية، مع الاحتفاظ بإمكانية الوصول إلى تفاصيل الفعاليات.

المقترح:

أن تتضمن الخريطة الحية جزءًا يعرض الفعاليات، مع توضيح المناطق المرتبطة بها وحالتها التشغيلية.

## 24. عرض مختصر للفعاليات في الصفحة الرئيسية

المقترح:

يمكن إضافة قسم مختصر في الصفحة الرئيسية يعرض عددًا محدودًا من الفعاليات، مثل أول ثلاث فعاليات.

عند الضغط على أي فعالية أو على خيار عرض المزيد، ينتقل المستخدم إلى صفحة الفعاليات أو تفاصيلها.

الهدف:

توفير نظرة سريعة على الفعاليات دون ازدحام الصفحة الرئيسية بالمعلومات.

## 25. تحديد الشكل النهائي لصفحة الفعاليات

يوجد أكثر من خيار مقبول:

1. دمج الفعاليات بالكامل داخل الخريطة الحية.
2. الاحتفاظ بصفحة مستقلة للفعاليات مع ربطها بالخريطة.
3. عرض مختصر للفعاليات في الصفحة الرئيسية، مع توفير عرض تفصيلي في صفحة أخرى.

ملاحظة:

لم يُحسم اختيار أحد هذه الحلول بصورة نهائية.

المعيار الأساسي هو سهولة الوصول إلى الفعاليات وارتباطها بالمناطق التي تُقام فيها.

# سادسًا: الأتمتة (Automation)

## 26. إعادة تنظيم صفحة الأتمتة بحسب نوع الجهاز

المشكلة الحالية:

تُعرض الأنظمة والأجهزة التشغيلية بطريقة تجعل التمييز بين أنواعها غير واضح.

كما أن تكرار عناصر مثل التظليل لكل منطقة قد يسبب ازدحامًا وصعوبة في الوصول إلى الأجهزة المطلوبة.

التعديل المطلوب:

إعادة تنظيم الصفحة بحسب أنواع الأنظمة والأجهزة، بدل عرض جميع الأجهزة بصورة مختلطة.

تشمل الأنواع المذكورة في التسجيل:

- أنظمة التظليل.
- أنظمة الرذاذ.
- أنظمة التبريد.
- المراوح.

طريقة العرض المقترحة:

استخدام جداول أو بطاقات (Cards) لتنظيم الأجهزة.

عند اختيار فئة معينة، مثل «الرذاذ»، تظهر الأجهزة التابعة لهذه الفئة فقط.

وعند اختيار «التظليل»، تظهر أجهزة التظليل وحدها.

ينطبق الأمر نفسه على بقية الأنواع.

الهدف:

أن يستطيع المشغّل الوصول إلى مجموعة محددة من الأجهزة دون الحاجة إلى استعراض جميع الأنظمة في الوقت نفسه.

## 27. تحسين عرض الأجهزة داخل كل فئة

التعديل المطلوب:

عند الدخول إلى فئة معينة من الأتمتة، يجب أن تظهر الأجهزة المرتبطة بها بصورة منظمة وواضحة.

يمكن استخدام الجدول الموجود حاليًا بعد تعديله ليتوافق مع الفئة المحددة.

المطلوب ألّا تظهر جميع أنواع الأجهزة مجتمعة عندما يختار المستخدم نوعًا معينًا.

ملاحظة تصميمية:

لم يُشترط استخدام الجداول تحديدًا؛ يمكن استخدام البطاقات إذا كانت أنسب لتجربة المستخدم.

## 28. إضافة سجل لحالات تشغيل الأجهزة

الملاحظة:

من المفيد أن يستطيع المستخدم الاطلاع على الحالات السابقة للأجهزة التشغيلية.

التعديل المقترح:

عند الدخول إلى جهاز أو فئة من الأجهزة، يمكن عرض سجل يتضمن:

1. وقت تشغيل الجهاز.
2. وقت إيقافه.
3. حالة الجهاز في الوقت المحدد.
4. التغيرات التي حدثت في حالته.
5. أي حالات غير طبيعية أو أعطال مسجلة.

الفائدة التشغيلية:

عند مراجعة مشكلة معينة، يستطيع المستخدم معرفة ما إذا كان الجهاز يعمل في ذلك الوقت، أو كان متوقفًا، أو حدث له خلل.

كما تساعد هذه المعلومات في تتبع أسباب الأعطال لاحقًا.

الجانب التقني:

يمكن الاستفادة من البيانات التي ستُسجل في قاعدة البيانات من خلال النظام والأجهزة المرتبطة به.

درجة الأولوية: تحسين إضافي غير أساسي.

ذُكر أن تنفيذه يعتمد على الوقت المتاح، ويمكن تطوير واجهته بالشكل المناسب دون الحاجة إلى تعقيد كبير.

## 29. توفير خيار لإيقاف الأتمتة والتحكم اليدوي

المشكلة الحالية:

لا توجد طريقة واضحة تتيح للمستخدم التدخل عند حدوث خلل في نظام يعمل تلقائيًا.

المتطلب الأساسي:

يجب توفير وسيلة واضحة لإيقاف الأتمتة عند الحاجة.

التعديل المطلوب:

1. إضافة خيار واضح مثل «إيقاف الأتمتة».
2. تمكين المستخدم من إيقاف التشغيل التلقائي عند حدوث مشكلة.
3. توفير إمكانية الانتقال إلى التحكم اليدوي (Manual Control).
4. تمكين المستخدم من التحكم بالنظام بعد إيقاف الأتمتة.

مثال على الاستخدام:

إذا كان نظام تبريد يعمل تلقائيًا وحدث خلل، يجب أن يستطيع المسؤول إيقاف الأتمتة والتحكم بالنظام يدويًا.

مكان الوظيفة:

يمكن وضع هذه الإمكانية داخل:

- لوحة التحكم الرئيسية.
- الخريطة الحية.
- صفحة الأتمتة.
- أي موضع آخر مناسب يختاره الفريق.

ملاحظة مهمة:

وجود وظيفة إيقاف الأتمتة والتحكم اليدوي متطلب أساسي، حتى لو تُرك مكانها النهائي للفريق.

# سابعًا: التحليلات (Analytics)

## 30. إعادة تحديد محتوى صفحة التحليلات

الملاحظة العامة:

لم يُحدد تصور نهائي لصفحة التحليلات أثناء التسجيل.

المطلوب من الفريق إعداد تصور أولي للمحتوى والواجهات، ثم مناقشته واعتماده.

الفئات المقترحة للتحليلات:

### أ. أداء المناطق

تحليل حالة المناطق المختلفة ومستوى أدائها خلال الفترات الزمنية.

يمكن أن يشمل ذلك التغيرات التي تطرأ على ظروف المناطق.

### ب. الصيانة والتدخلات

تحليل العمليات المرتبطة بالصيانة والتدخلات التشغيلية.

ومن المعلومات المقترحة:

- عدد التدخلات.
- أنواع التدخلات.
- سرعة الاستجابة.
- الوقت المستغرق لتنفيذ الإجراءات.

### ج. ساعات الذروة

دراسة الأوقات التي ترتفع فيها الحاجة إلى التدخل أو التشغيل.

### د. الكفاءة التشغيلية

تحليل مستوى كفاءة عمليات التشغيل.

يمكن أن يشمل عدد الإجراءات المنفذة وطبيعتها.

### هـ. أداء الأتمتة

تحليل التدخلات التي نُفذت من خلال الأنظمة الآلية.

ومن ذلك معرفة العمليات التي تمت تلقائيًا مقارنة بالتدخلات الأخرى.

### و. تحليلات الفعاليات

تحليل الفعاليات المرتبطة بالمناطق الخارجية.

وتشمل المؤشرات المقترحة:

- عدد الفعاليات.
- أداء المناطق أثناء الفعاليات.
- المعلومات التشغيلية المرتبطة بكل فعالية.

مصادر البيانات:

ستعتمد هذه التحليلات على البيانات الموجودة في النظام، بما في ذلك البيانات المتاحة من نموذج الذكاء الاصطناعي والأنظمة المرتبطة به.

ملاحظة:

هذه الفئات تمثل تصورًا أوليًا، وليست قائمة نهائية بمؤشرات الأداء.

المطلوب من الفريق اقتراح طريقة عرضها، ثم مناقشة التفاصيل قبل اعتماد التصميم النهائي.

## 31. إضافة إصدار التقارير وتصديرها

التعديل المقترح:

إضافة إمكانية إصدار التقارير وتصدير البيانات من صفحة التحليلات.

المطلوب:

1. توفير زر واضح لإنشاء أو تصدير تقرير.
2. تمكين المستخدم من تحديد البيانات أو نوع الأداء الذي يريد تضمينه في التقرير.
3. إتاحة تنزيل التقرير.
4. توفير صيغ مناسبة للتصدير.

الصيغ المذكورة:

- Excel.
- Word.

ملاحظة:

لا يُشترط دعم جميع الصيغ منذ البداية.

لكن يُفضّل، من منظور تجربة المستخدم، توفير إمكانية اختيار صيغة التصدير إذا كانت المنصة تدعم أكثر من صيغة.

# ثامنًا: شبكة المستشعرات (Sensor Network)

## 32. إظهار المستشعرات داخل تفاصيل كل منطقة

المشكلة الحالية:

توجد صفحة مستقلة لشبكة المستشعرات، لكنها ليست مرتبطة بتفاصيل المناطق بالشكل الكافي.

التعديل المطلوب:

عند فتح تفاصيل أي منطقة، يجب أن يظهر قسم يوضح المستشعرات الموجودة فيها.

المعلومات المطلوب إظهارها:

1. أسماء المستشعرات أو معرفاتها.
2. عدد المستشعرات الموجودة في المنطقة.
3. حالة اتصال المستشعر.
4. حالة تشغيل المستشعر.
5. المعلومات الأساسية المرتبطة به.

طريقة العرض:

يمكن استخدام جدول مختصر داخل تفاصيل المنطقة.

كما يمكن اختيار موضع آخر مناسب بشرط أن تكون المعلومات واضحة وسهلة الوصول.

الهدف:

أن يستطيع المستخدم معرفة المستشعرات المرتبطة بالمنطقة دون الحاجة إلى الخروج من تفاصيلها والانتقال إلى صفحة أخرى.

## 33. الإبقاء على صفحة شبكة المستشعرات المستقلة

الملاحظة:

صفحة شبكة المستشعرات الحالية مناسبة بشكل عام.

لا يوجد طلب لإعادة تصميمها بالكامل أو حذفها.

التعديل الأساسي:

ربط المعلومات الموجودة فيها بصفحات المناطق.

بمعنى أن صفحة شبكة المستشعرات توفر عرضًا شاملًا للشبكة، بينما تعرض صفحة المنطقة المستشعرات الخاصة بتلك المنطقة.

# تاسعًا: الصيانة والعمليات (Maintenance & Operations)

## 34. إضافة صفحة لإدارة الصيانة والمهام

المتطلب الأساسي:

إضافة صفحة مخصصة للصيانة والعمليات التشغيلية، تكون موجهة إلى إدارة فرق التشغيل والصيانة.

الهدف:

تمكين المسؤول من إنشاء مهام الصيانة، وتحديد طبيعتها، وإسنادها إلى العاملين.

## 35. إنشاء مهام الصيانة

التعديل المطلوب:

توفير إمكانية إنشاء مهمة صيانة جديدة.

يجب أن يستطيع المستخدم تحديد:

1. المنطقة التي تحتاج إلى الصيانة.
2. الجهاز أو الجزء الذي يحتاج إلى الصيانة.
3. نوع الصيانة المطلوبة.
4. وصف المشكلة أو المهمة.
5. الشخص الذي ستُسند إليه المهمة.
6. الوقت المرتبط بالمهمة.

التوضيح:

يجب ألّا يقتصر الإسناد على اختيار منطقة عامة.

بل ينبغي أن يتمكن المسؤول من تحديد المشكلة أو الجهاز المطلوب التعامل معه بدقة.

كما يجب توفير خانة تسمح بكتابة وصف تفصيلي عند الحاجة.

طريقة العرض:

يمكن تنفيذ هذه الوظائف من خلال جدول ونموذج لإضافة المهام، أو أي طريقة أخرى مناسبة.

## 36. ربط الصيانة بالتنبيهات وتفاصيل المناطق

المشكلة:

إذا ظهرت مشكلة في منطقة أو جهاز، يجب ألّا يضطر المسؤول إلى بدء عملية الإسناد من الصفر في صفحة منفصلة.

التعديل المطلوب:

ربط صفحة الصيانة والعمليات بكل من:

- تفاصيل المناطق.
- التنبيهات.
- الأجهزة التشغيلية المرتبطة بالمناطق.

سيناريو الاستخدام:

عند ظهور مشكلة في جهاز تبريد داخل منطقة معينة، يستطيع المسؤول الانتقال من التنبيه أو تفاصيل المنطقة إلى وظيفة إنشاء مهمة صيانة.

ويجب أن يكون الربط بين المشكلة والمهمة واضحًا.

الهدف:

تقليل خطوات المستخدم، والمحافظة على الترابط بين اكتشاف المشكلة واتخاذ الإجراء المطلوب.

## 37. عرض حالة أفراد الفريق وتوزيع المهام

المشكلة الحالية:

يحتاج مدير الفريق إلى معرفة حالة العاملين قبل إسناد أي مهمة.

التعديل المطلوب:

توفير عرض يوضح:

1. أفراد الفريق المتاحين.
2. الأفراد المشغولين.
3. الأفراد الذين لم تُسند إليهم مهام.
4. المهام المسندة إلى كل فرد.

الهدف:

مساعدة المدير على اختيار الشخص المناسب للمهمة بناءً على حالة انشغاله والمهام المسندة إليه.

ملاحظة تصميمية:

يمكن وضع هذه المعلومات داخل صفحة الصيانة، أو إنشاء قسم مستقل لإدارة العاملين.

لم يُشترط أحد الخيارين.

## 38. توضيح سجل العمليات والمهام

التعديل المطلوب:

إذا أُضيف سجل للعمليات داخل صفحة الصيانة، يجب أن يوضح نوع العمليات التي يسجلها.

ومن الأمثلة التي نوقشت:

- مهام الصيانة.
- عمليات إسناد المهام.
- الإجراءات التشغيلية المنفذة.

ويجب تمييز هذه المعلومات عن القراءات التي تنتجها المستشعرات.

# عاشرًا: إدارة العاملين والفرق (Team Management)

## 39. إنشاء صفحة لإدارة الكادر البشري

المتطلب الأساسي:

توفير مكان يستطيع المدير من خلاله الاطلاع على جميع أفراد الفريق وإدارتهم.

يمكن إنشاء صفحة مستقلة أو دمج هذه الوظائف ضمن قسم الصيانة والعمليات.

## 40. تصنيف العاملين بحسب أدوارهم

التصنيفات التي جرى الاتفاق عليها في التسجيل:

### أ. الإدارة والمسؤولون

يشمل هذا القسم الأشخاص الذين يمتلكون صلاحيات إدارية.

لا يقتصر النظام على مدير واحد؛ يجب أن يكون بالإمكان إضافة مسؤولين آخرين.

ومن وظائف الإدارة:

- الإشراف على النظام.
- الاطلاع على المعلومات التشغيلية.
- اتخاذ القرارات.
- توجيه الفرق وإسناد المهام.

### ب. فريق التشغيل

يتولى فريق التشغيل تنفيذ المهام الميدانية والتعليمات الصادرة من المسؤولين.

ومن الأمثلة المذكورة:

- نقل أجهزة التبريد بين المواقع.
- تنفيذ إجراءات تشغيلية داخل الفعاليات.
- تحريك معدات أو أجهزة إلى أماكن مختلفة.
- تنفيذ الإجراءات التي لا تتم تلقائيًا.

الفرق بين الإدارة وفريق التشغيل:

الأصل أن الإدارة تتخذ القرارات، بينما ينفذ المشغلون التعليمات.

لكن قد يمتلك بعض العاملين صلاحية اتخاذ قرارات في حالات محددة.

لا يعني ذلك أن جميع المشغلين يملكون صلاحيات إدارية كاملة.

### ج. فريق الصيانة

يتولى معالجة الأعطال والمشكلات الفنية المرتبطة بالأجهزة والأنظمة.

يجب تمييز هذا الفريق عن فريق التشغيل؛ لأن طبيعة مهامه مختلفة.

ملاحظة:

وردت في التسجيل تسميات متعددة أثناء مناقشة التقسيم، لكن التقسيم النهائي المقصود هو ثلاثة أقسام رئيسية: الإدارة أو المسؤولون، التشغيل، والصيانة.

## 41. إضافة العاملين وإدارة بياناتهم

التعديل المطلوب:

إتاحة إضافة أفراد جدد إلى النظام.

تتضمن البيانات الأساسية المذكورة:

1. بيانات تعريف الموظف.
2. البريد الإلكتروني.
3. رقم الهاتف.
4. القسم أو الدور الوظيفي.
5. المهام المسندة إليه.

التفاعل المطلوب:

عند الدخول إلى بيانات أحد العاملين، يستطيع المسؤول الاطلاع على المهام المرتبطة به.

## 42. إدارة صلاحيات المسؤولين

المتطلب:

يجب ألّا تقتصر الإدارة على حساب مسؤول واحد.

التعديل المطلوب:

إتاحة إضافة مسؤولين آخرين يستطيعون الاطلاع على النظام وممارسة الصلاحيات التي تُمنح لهم.

ملاحظة:

لم تُحدد مستويات الصلاحيات التفصيلية في التسجيل، لذلك يجب مناقشة آلية توزيعها عند تطوير النظام.

# الحادي عشر: الإعدادات (Settings)

## 43. إعادة تصميم صفحة الإعدادات

المشكلة الحالية:

تحتوي الإعدادات على معلومات لا تمثل إعدادات فعلية للنظام، وإنما معلومات مرتبطة بالعرض التوضيحي للنموذج الأولي.

التعديل المطلوب:

تحويل صفحة الإعدادات إلى واجهة مناسبة لنظام تشغيلي حقيقي.

يجب أن تكون المعلومات الموجودة فيها مرتبطة بوظائف المستخدم أو إعدادات النظام، لا بطريقة استعراض المشروع.

## 44. إزالة المعلومات الخاصة بالعرض التجريبي

المعلومات المطلوب إزالتها من الإعدادات:

- مسار المستخدم العام عندما يكون الغرض منه شرح العرض.
- الهيكلة التوضيحية للنظام.
- المعلومات الخاصة بكيفية استعراض وظائف الذكاء الاصطناعي.
- دورة العرض أو مسار العرض التجريبي.
- أي محتوى موجود فقط لإرشاد مقدم المشروع أثناء شرح النموذج.

السبب:

هذه العناصر قد تكون مفيدة أثناء تقديم المشروع، لكنها ليست جزءًا مناسبًا من إعدادات النظام الفعلي.

## 45. إضافة إعدادات مناسبة للمستخدم والنظام

التعديل المطلوب:

تنظيم الإعدادات بحيث تتضمن الوظائف التي يحتاج إليها المستخدم بصورة فعلية.

ومن الأمور المذكورة سابقًا في التسجيل:

- معلومات الحساب.
- الإعدادات العامة.
- البريد الإلكتروني.
- وظائف الحساب الأساسية.
- تسجيل الخروج.

مع توضيح الفرق بين إعدادات الحساب والإعدادات المرتبطة بالأجهزة والنظام.

ملاحظة:

لم تُحدد جميع إعدادات النظام النهائية؛ المطلوب إنشاء واجهة أولية مناسبة وقابلة للتطوير لاحقًا.

# الثاني عشر: ملاحظات عامة على تجربة المستخدم وهيكلة المنصة

## 46. تصميم الواجهات بناءً على شخصية المستخدم الأساسية

يجب تقييم تصميم المنصة من منظور الشخص الذي سيستخدمها فعليًا، وليس فقط من منظور عرض المعلومات.

الشخصية الأساسية التي ركز عليها التسجيل:

مدير فريق التشغيل أو المسؤول عن إدارة المساحات الخارجية.

ويحتاج هذا المستخدم إلى:

- فهم حالة المناطق بسرعة.
- تحديد المشكلات التي تتطلب تدخلًا.
- معرفة الأجهزة والمستشعرات المرتبطة بالمناطق.
- الاطلاع على الفعاليات.
- اتخاذ قرارات تشغيلية.
- إسناد المهام.
- متابعة العاملين.
- مراجعة العمليات والنتائج.

التوجيه:

عند اختيار المعلومات أو مواضع العناصر، يجب سؤال الفريق عن القيمة التي سيحصل عليها المستخدم من كل عنصر.

## 47. تقليل عدد خطوات المستخدم (User Flow)

من الملاحظات المتكررة أن بعض الوظائف تتطلب انتقالات أكثر من اللازم.

المطلوب:

- تقليل التنقل بين الصفحات التي تؤدي وظائف متشابهة.
- إظهار المعلومات الأساسية بصورة مباشرة.
- جعل البطاقات والعناصر المهمة تفاعلية.
- توفير روابط واضحة بين المعلومات والإجراءات المرتبطة بها.
- تجنب إضافة خطوات لا تحقق فائدة للمستخدم.

## 48. تجنب ازدحام الصفحة الرئيسية

لا ينبغي نقل جميع معلومات النظام إلى الصفحة الرئيسية.

المطلوب تحديد ما يحتاجه المستخدم فور الدخول، مع توفير اختصارات للأقسام الأكثر تفصيلًا.

أمثلة على ذلك:

تُعرض الفعاليات بصورة مختصرة في الصفحة الرئيسية، بينما تظهر معلوماتها التفصيلية في الخريطة الحية أو قسم الفعاليات.

كذلك تُعرض حالة المستشعرات بصورة مختصرة، مع إمكانية الانتقال إلى شبكة المستشعرات لمراجعة التفاصيل.

## 49. تحسين وضوح النصوص والتسميات

يجب ألّا يحتاج المستخدم إلى تخمين المقصود بالمعلومات المعروضة.

يشمل ذلك:

- أسماء الأجهزة والمستشعرات.
- أعداد الأجهزة.
- حالات المناطق.
- أنواع التنبيهات.
- أوقات حدوث المشكلات.
- حالة قراءة التنبيهات.
- أنواع التدخل المطلوبة.
- طبيعة سجلات العمليات.
- المقصود بكل قسم في الإعدادات.

## 50. تعزيز الترابط بين وظائف النظام

من أهم التوجهات العامة الواردة في التسجيل ألا تعمل أقسام المنصة بصورة منفصلة.

الترابط المطلوب:

المنطقة ← المستشعرات: يستطيع المستخدم معرفة المستشعرات الموجودة في منطقة معينة.

المنطقة ← الفعاليات: يستطيع المستخدم معرفة الفعاليات المرتبطة بالمنطقة.

المنطقة ← الأجهزة: يستطيع المستخدم معرفة الأنظمة التشغيلية الموجودة في المنطقة.

التنبيه ← الصيانة: يستطيع المسؤول الوصول إلى إجراءات الصيانة المرتبطة بالمشكلة.

المهمة ← الموظف: يستطيع المسؤول معرفة الشخص الذي أُسندت إليه المهمة.

الأتمتة ← التحكم اليدوي: يستطيع المسؤول إيقاف الأتمتة والتدخل يدويًا عند الحاجة.

العمليات ← التحليلات: يمكن الاستفادة من بيانات التشغيل والصيانة لإعداد التحليلات والتقارير.

# الثالث عشر: نقاط تحتاج إلى تحديد لاحق

هذه النقاط لم تُحسم أثناء التسجيل، ولذلك يُفترض عدم اعتماد قرار نهائي بشأنها دون مناقشة.

الموضوع | النقطة التي تحتاج إلى تحديد
بطاقات الصفحة الرئيسية | تحديد أهم المؤشرات والمعلومات المناسبة لفريق التشغيل.
تصنيف حالات المناطق | تحديد المعايير المستخدمة لتصنيف المناطق.
مؤشر UTCI | اعتماد الأوصاف والتصنيفات وفق ملف المعلومات الذي سيُقدَّم.
التنبيهات | تقرير الإبقاء على صفحة مستقلة أو دمجها في موضع آخر.
الفعاليات | تحديد ما إذا كانت ستصبح جزءًا من الخريطة الحية أو ستحتفظ بصفحة مستقلة.
جدول المناطق | تحديد موضعه النهائي داخل الخريطة الحية.
التحليلات | تحديد مؤشرات الأداء وطريقة عرضها بصورة نهائية.
إدارة العاملين | تحديد ما إذا كانت صفحة مستقلة أو جزءًا من الصيانة والعمليات.
صلاحيات المستخدمين | تحديد مستويات الوصول والصلاحيات لكل دور.
تصدير التقارير | تحديد الصيغ التي سيدعمها النظام.
سجل تشغيل الأجهزة | تحديد التفاصيل التي ستُعرض وكيفية الوصول إليها.
الحساب والإعدادات | تحديد الشكل النهائي للقوائم والإعدادات.
إيقاف الأتمتة | تحديد موضع التحكم، مع التأكيد على ضرورة وجود الوظيفة.

# الرابع عشر: ترتيب أولويات التنفيذ

هذا الترتيب مقترح لتنظيم العمل بناءً على التأكيدات الواردة في التسجيل، وليس ترتيبًا نصيًا حدده المتحدث بصورة نهائية.

## الأولوية الأولى: المتطلبات الأساسية

1. ربط الخريطة الرئيسية بالخريطة الحية.
2. تحسين تمييز المنطقة المحددة.
3. ربط معلومات المنطقة بالمؤشر الرئيسي وحالتها.
4. توضيح القيم المناخية والأجهزة المرتبطة.
5. ربط توقعات الساعات القادمة بالمنطقة المحددة.
6. عرض الفعاليات المرتبطة بالمناطق.
7. توضيح أعمدة الاستشعار داخل كل منطقة.
8. ربط المستشعرات بتفاصيل المناطق.
9. إعادة تنظيم الأتمتة بحسب أنواع الأجهزة.
10. توفير إيقاف الأتمتة والتحكم اليدوي.
11. إنشاء صفحة الصيانة والعمليات.
12. توفير إنشاء المهام وإسنادها.
13. توفير إدارة العاملين وتصنيف الأدوار.
14. إضافة وظائف الحساب الشخصي وتسجيل الخروج.
15. إزالة معلومات العرض التجريبي من الإعدادات.

## الأولوية الثانية: تحسينات تجربة المستخدم

1. تحسين محتوى بطاقات الإحصائيات وجعلها اختصارات تفاعلية.
2. تحسين عرض حالة اتصال شبكة المستشعرات.
3. إعادة تنظيم بطاقة المنطقة المحددة.
4. تحسين مفتاح ألوان حالات المناطق.
5. إعادة تقييم مكان «يتطلب قرارك الآن».
6. توضيح وقت التنبيهات وحالة قراءتها.
7. نقل سجل العمليات إلى موضع مناسب.
8. دمج جدول المناطق مع الخريطة الحية.
9. إضافة البحث والتصفية.
10. تقليل خطوات الانتقال إلى تفاصيل المناطق.
11. تحسين وصف التنبيهات وأنواع التدخلات.
12. تنظيم عرض الفعاليات في الصفحة الرئيسية والخريطة الحية.
13. إعادة تنظيم إعدادات المستخدم والنظام.

## الأولوية الثالثة: تحسينات إضافية قابلة للنقاش

1. إضافة سجل تاريخي لحالات الأجهزة التشغيلية.
2. تطوير التصور النهائي للتحليلات ومؤشرات الأداء.
3. إضافة خيارات إصدار التقارير وتصديرها.
4. توسيع معلومات حالة العاملين وتوزيع المهام.
5. تحسين طرق عرض الفعاليات ومعلوماتها الثانوية.
6. إضافة تفاصيل وإحصائيات أخرى داخل مفتاح حالات المناطق.

# الخامس عشر: تصور الهيكلة المقترحة للمنصة

استنادًا إلى الملاحظات، يمكن أن تصبح البنية العامة للمنصة بالشكل التالي:

القسم الرئيسي | الوظائف والمحتوى
النظرة العامة | مؤشرات الأداء، حالة المناطق، خريطة مختصرة، التنبيهات المهمة، الفعاليات المختصرة، التوقعات.
الخريطة الحية | الخريطة التفاعلية، الفعاليات، جدول المناطق، البحث والتصفية، الوصول إلى تفاصيل المناطق.
تفاصيل المنطقة | الحالة، مؤشر UTCI، القيم المناخية، الفعاليات، المستشعرات، الأنظمة التشغيلية، التنبيهات، الصيانة.
الأتمتة | إدارة الأجهزة بحسب النوع، متابعة حالة التشغيل، سجل التشغيل، التحكم اليدوي وإيقاف الأتمتة.
شبكة المستشعرات | جميع أعمدة الاستشعار، حالات الاتصال والتشغيل، معلومات الأجهزة.
الصيانة والعمليات | إنشاء المهام، تحديد المشكلات، إسناد المهام، متابعة الصيانة، سجل العمليات.
إدارة العاملين | الإدارة، فريق التشغيل، فريق الصيانة، بيانات العاملين، المهام المسندة.
التحليلات | أداء المناطق، الصيانة، التدخلات، ساعات الذروة، الكفاءة التشغيلية، الفعاليات، التقارير.
الإعدادات | إعدادات النظام الفعلية، الإعدادات العامة، إدارة الخصائص ذات العلاقة.
الحساب الشخصي | الملف الشخصي، بيانات الحساب، إعدادات المستخدم، تسجيل الخروج.

تنبيه بشأن الهيكلة: هذا تصور تنظيمي يجمع الملاحظات، وليس شرطًا أن تكون جميع الأقسام المذكورة صفحات مستقلة. بعض الملاحظات طرحت صراحةً إمكانية دمج صفحات المناطق والفعاليات والتنبيهات، كما تركت للفريق حرية تحديد موقع إدارة العاملين.

## الخلاصة العامة للملاحظات

تتمحور المراجعة حول تحويل «هبوب» من واجهة تعرض بيانات ومعلومات متفرقة إلى منصة متكاملة لإدارة وتشغيل المساحات الخارجية.

التركيز الأساسي ليس على تحسين التصميم البصري وحده، بل على جعل النظام يساعد المسؤول في إنجاز سلسلة مترابطة من المهام:

مراقبة المنطقة ← فهم حالتها ← اكتشاف المشكلة ← تحديد التدخل المناسب ← تنفيذ الإجراء أو إسناده ← متابعة النتيجة وتحليل الأداء.

ولهذا يجب أن تعكس الواجهات الاحتياجات الفعلية للإدارة والمشغلين وفرق الصيانة، مع تقليل خطوات الوصول إلى المعلومات والقرارات.

كذلك يجب الحفاظ على مرونة التصميم؛ فبعض الملاحظات حددت وظائف أساسية لا بد من تنفيذها، بينما تُركت تفاصيل كثيرة، مثل مكان عرض التنبيهات، وأسلوب تنظيم الجداول والبطاقات، وتوزيع الصفحات، لاجتهاد فريق تجربة المستخدم.

ملاحظتان مهمتان عند التنفيذ:

أولًا، ورد في التسجيل أن هناك ملفًا سيُقدَّم لاحقًا يتضمن تفاصيل مؤشر UTCI، والأجهزة المرتبطة بالنظام، ومعاني الحالات والتدخلات. لم يكن هذا الملف ضمن المرفقات الحالية، لذلك لم تُفترض قيم أو معايير علمية غير موجودة في المصادر.

ثانيًا، لم تُحسم جميع وظائف التحليلات أو جميع قرارات دمج الصفحات؛ ولذلك احتُفظ بها بوصفها موضوعات تحتاج إلى مناقشة، بدل تحويل الاقتراحات إلى متطلبات إلزامية.

بهذا الترتيب، جُمعت الملاحظات المتعلقة بجميع صفحات المنصة، بما فيها الملاحظات التي وردت في نهاية التسجيل عن إيقاف الأتمتة، وإدارة الفرق، وتصدير التقارير، مع الفصل بين المتطلبات الأساسية والتحسينات الاختيارية.
