SARAHXL1/Expo2023-HABOOB/docs/data-science/هبوب_دليل_علم_البيانات_v2.docx

هبوب

HABOOB · Expo 2030 Riyadh Challenge 2.3

الدليل المرجعي لمسار علم البيانات والذكاء الاصطناعي

بيانات الحساسات، ومعادلات مؤشر WBGT، والمعايير العالمية للإجهاد الحراري، وحصر التحليلات المطلوبة وتصنيفها

البند | القيمة

المحتويات

ملاحظة: إذا ظهر الفهرس فارغًا، اضغط عليه بالزر الأيمن في Word واختر «تحديث الحقل».

# 1. الملخص التنفيذي

مهمة مسار علم البيانات في هبوب أن يحوّل قراءات أعمدة الاستشعار إلى مؤشر WBGT لكل عمود، ثم إلى علم خطر وحالة تشغيلية لكل منطقة، ومعها تفسير لسبب الإجهاد، وتوصية بإجراء وأثرها المتوقع، وتوقع للساعات القادمة، وتقدير للمناطق التي لا يوجد فيها عمود.

المعيار ISO 7243 يعرّف WBGT من ثلاث قراءات: البصيلة الرطبة الطبيعية (Tnw)، والكرة السوداء (Tg)، وحرارة الهواء (Ta). عمود هبوب لا يقيس Tnw ولا Tg مباشرة، لذلك يحسبهما الخادم فيزيائيًا من حرارة الهواء والرطوبة والرياح والإشعاع الشمسي بطريقة Liljegren (2008)، وهي الطريقة التي يستخدمها تشغيليًا معهد الأرصاد الهولندي (KNMI) وتنفّذها مكتبة thermofeel من المركز الأوروبي (ECMWF).

الخلاصة الأهم من حصر المنصة: معظم ما يظهر للمشغّل حسابات حتمية وقواعد واضحة، ولا يحتاج تدريب نموذج. نموذجان فقط يحتاجان تعلمًا آليًا فعليًا: التوقع الزمني، والتقدير المكاني.

الفئة | عدد التحليلات | أمثلة | تحتاج تدريبًا؟
أ. حساب حتمي (معادلة أو جدول) | 8 | WBGT، علم الخطر، حالة المنطقة، مؤشرات الصفحة الرئيسية، ساعات التجاوز | لا
ب. قواعد وإحصاء ومحاكاة فيزيائية | 11 | تنظيف البيانات، تفسير السبب، التوصية وأثرها المتوقع، قواعد الأتمتة، الاتجاه | لا، لكنها تحتاج معاملات تُضبط
ج. نموذج تعلم آلي | 5 | توقع WBGT للساعات القادمة، تقدير المناطق بلا حساسات، تعلّم أثر التدخلات | نعم

ثلاث ملاحظات قبل البدء بالبناء

1. الإشعاع الشمسي هو أكبر عامل في WBGT تحت الشمس (6.1 درجة في مثال ظهر أكتوبر، القسم 4.7)، وهو يُقدَّر من حساس الإضاءة بتحويل تقريبي. داخل القاعة الإشعاع صفر، فيكون الحساب دقيقًا للعرض.

2. حدود الحالات في النموذج الأولي للمنصة مبنية على أرقام UTCI (32، 38، 42)، ويجب استبدالها بأعلام WBGT (26.7، 29.4، 31.1، 32.2). التفاصيل في القسم 5.6.

3. الخادم يحذف القراءات الأقدم من 180 دقيقة. يجب رفع المدة أو التصدير الدوري قبل أي جمع بيانات للتدريب أو المعايرة (القسم 3).

# 2. الحساسات المرتبطة بالمؤشر

العمود يحمل أربعة حساسات لها علاقة بمؤشر WBGT. كل حساس يغذي مكوّنًا أو أكثر من مكوّنات المعادلة:

الحساس | ما يقيسه | الحقل في الرسالة | الوحدة | دوره في WBGT
DHT22 | حرارة الهواء Ta | sensors.dht22.ta_c | °C | يدخل مباشرة بوزن 10%، ويدخل في حساب Tnw وTg
DHT22 | الرطوبة النسبية RH | sensors.dht22.rh_pct | % | أهم مدخل في Tnw (وزنه 70%)
مقياس رياح بمحرك DC عبر محول ADS1115 | جهد يتحول إلى سرعة رياح | sensors.anemometer.wind_v و height_m | V ثم m/s | الرياح تبرّد الكرة وتزيد التبخر من البصيلة الرطبة، فتؤثر في Tg وTnw
VEML7700 | شدة الإضاءة E | sensors.veml7700.lux | lux | تتحول تقريبيًا إلى إشعاع شمسي W/m²، وهو أكبر مدخل في Tg

قيم التشغيل في الكود الحالي: عينة رياح كل 100 ملي ثانية تُجمع في متوسط، وبقية الحساسات كل 5 ثوانٍ (DHT22 لا يُقرأ أسرع من ثانيتين)، ومقياس الرياح على ارتفاع 1.8 م. معاملات تحويل جهد الرياح إلى سرعة (K = 20 وB = 0.5) مؤقتة حتى المعايرة.

### للعلم فقط: مكونات مرتبطة بالمؤشر غير موجودة في النموذج الأولي

المكوّن | ما كان سيقيسه | البديل المستخدم الآن
حساس الكرة السوداء DS18B20 داخل كرة (مؤجل) | حرارة الكرة Tg مباشرة | Tg يُحسب من الإشعاع والرياح وحرارة الهواء بطريقة Liljegren
ترمومتر البصيلة الرطبة الطبيعية (غير مدرج في التصميم) | Tnw مباشرة | Tnw يُحسب من حرارة الهواء والرطوبة والرياح والإشعاع بطريقة Liljegren
MLX90614 | حرارة سطح الأرضية Ts | sensors.mlx90614.tsurf_c | °C | لا يدخل في معادلة Liljegren مباشرة؛ يُستخدم لتمييز الأسطح الساخنة وفي التقدير المكاني

# 3. كيف تصل البيانات إلى الخادم وكيف تُخزَّن

العقدة تقيس وترسل القيم الخام فقط، والخادم يحسب كل شيء آخر. السبب أن تعديل المعادلات ومعاملات المعايرة في الخادم أسهل من إعادة برمجة الأعمدة.

## 3.1 المسار خطوة بخطوة

# | المرحلة | أين | ماذا يحدث

1 | القراءة | العقدة ESP32 | تقرأ الحساسات وتحسب متوسط جهد الرياح لعيّنات الفترة
2 | التغليف | العقدة | تضع القراءات في رسالة JSON واحدة فيها معرّف العمود والوقت وحالة كل حساس
3 | الإرسال | العقدة ← الخادم | طلب HTTP POST إلى ‎/api/readings على المنفذ 5050 عبر الواي فاي، كل 5 ثوانٍ في وضع الاختبار أو كل 60 ثانية في القياس الطويل. البديل عند تعطل الشبكة: سطر DATA على كابل USB يقرأه برنامج الجسر serial_bridge.py ويرسله للخادم نفسه
4 | الاستقبال | الخادم app.py | يتحقق من الرسالة، ويضع وقت الاستلام إذا وصل الوقت فارغًا، ويحفظها كما هي
5 | المعالجة | الخادم | يطبّق فحوص الجودة، ويحسب سرعة الرياح والإشعاع ثم WBGT والعلم، ويحفظ الناتج
6 | الرد | الخادم ← العقدة | يرد بقيمة WBGT والعلم لتعرضهما شاشة العقدة
7 | التحليل | خدمة التحليل في الخادم | تقرأ الجدول المعالج لحساب الحالات والتنبيهات والتوقع، وتُصدَّر منه ملفات CSV للتدريب

## 3.2 شكل الرسالة الواصلة (الحقول المرتبطة بالمؤشر)

القيم توضيحية لشكل الرسالة. الرسالة الفعلية تحمل أيضًا بيانات تشخيص للعقدة (مدة التشغيل، سبب آخر إعادة تشغيل، قوة إشارة الواي فاي)، وهي تفيد الصيانة ولا تدخل في المؤشر.

{

"schema": 3, "node_id": "node-01", "ts": 1792401522, "send_interval_s": 5,

"sensors": {

"dht22": {"status": "ok", "ta_c": 25.3, "rh_pct": 47.0},

"anemometer": {"status": "ok", "wind_v": 0.0412, "height_m": 1.80, "samples": 50},

"mlx90614": {"status": "ok", "tsurf_c": 27.9},

"veml7700": {"status": "ok", "lux": 412}

}

}

لكل حساس حقل status: القيمة ok تعني قراءة سليمة، وnot_found تعني أن القطعة لم تظهر عند الإقلاع، وread_error تعني فشل القراءة. في الحالتين الأخيرتين تصل القيمة فارغة (null) ولا تدخل في الحساب.

## 3.3 طريقة التخزين المقترحة

الخادم يحفظ الرسائل حاليًا في قاعدة SQLite محلية (data/readings.db). المقترح تنظيم التخزين في ثلاثة جداول، حتى يأخذ النموذج بياناته بالصيغة نفسها دائمًا:

الجدول | محتواه | صف واحد = | الغرض
raw_readings | الرسالة كما وصلت (نص JSON) مع وقت الاستلام | رسالة واحدة | الرجوع للأصل عند أي خطأ في المعالجة
wbgt_readings | القيم المنظفة والمشتقة وWBGT والعلم وعلامات الجودة | رسالة واحدة | العرض الحي والتنبيهات
wbgt_minute | متوسط كل دقيقة لكل عمود | عمود × دقيقة | مدخل التحليلات ونماذج التعلم الآلي

أعمدة الجدول wbgt_minute، وهي الصيغة الموحدة التي يقرأها النموذج:

ts_minute, node_id, zone_id,

ta_c, rh_pct, v_h_ms, v10_ms, lux, ghi_wm2, sun_flag, cossza, tsurf_c,

tnw_c, tg_c, wbgt_c, wbgt_method, flag,

quality, n_msgs, devices_on, event_id

العمود | المعنى
ghi_wm2 | الإشعاع الشمسي المقدّر من الإضاءة (W/m²)
sun_flag | 1 إذا كان العمود في الشمس، و0 إذا كان في الظل أو داخل مبنى
cossza | جيب تمام زاوية سمت الشمس، محسوب من الوقت والإحداثيات
tnw_c وtg_c | البصيلة الرطبة الطبيعية والكرة السوداء المحسوبتان
wbgt_method | liljegren أو simple (القسم 4.5)
flag | white أو green أو yellow أو red أو black
quality | high أو medium أو low (القسم 6.3، ب10)
n_msgs | عدد الرسائل التي دخلت في متوسط الدقيقة

إعدادان يجب تغييرهما قبل جمع البيانات

مدة الحفظ: الإعداد history_keep_minutes في config.json قيمته 180 دقيقة. يُرفع إلى 43,200 دقيقة (30 يومًا) على الأقل، أو تُصدَّر البيانات قبل إيقاف الخادم من «أدوات ← تصدير CSV».

فترة الإرسال: 5 ثوانٍ مناسبة للعرض الحي. لجمع بيانات طويلة تكفي 60 ثانية، لأن النموذج يعمل على متوسط الدقيقة.

## 3.4 أهم مشكلات جودة البيانات في النموذج الأولي

هذه المشكلات الخمس هي التي تؤثر فعلًا على الأرقام في نموذج أولي. ما عداها يُعالج لاحقًا في النسخة الميدانية.

المشكلة | أثرها | المعالجة البسيطة
معاملات الرياح مؤقتة | سرعة الرياح وWBGT غير معايرة | معايرة سريعة بالمروحة ومقياس يدوي (القسم 4.6) قبل عرض أي رقم للرياح
تحويل الإضاءة إلى إشعاع تقريبي | خطأ 20% في الإشعاع يغيّر WBGT نحو ±1.2° تحت الشمس | داخل القاعة لا أثر له؛ في الخارج يُعلن أنه تقدير
رياح ضعيفة جدًا تُقرأ صفرًا | المحرك لا يدور تحت عتبة معينة | المكتبة ترفع الرياح تلقائيًا إلى حد أدنى 0.62 m/s على ارتفاع 10 م
حساس الهواء تحت الشمس بلا واقٍ | يقرأ حرارة أعلى من الحقيقة | واقٍ إشعاعي عند أي اختبار خارجي؛ لا يلزم داخل القاعة
فجوات أو قيم شاذة | قفزات في الرسم ومتوسطات خاطئة | فحص المدى ومعدل التغير، وعدم سد الفجوات الأطول من 3 رسائل (القسم 6.3، ب1 وب2)

## 3.5 بيانات يحتاجها التحليل ولا تأتي من الحساسات

لكل بند: هل يمكن الاستغناء عنه، وما البديل، وهل افتراضه يؤثر تأثيرًا خطيرًا. أرقام الحساسية محسوبة على حالة ظهر أكتوبر في القسم 4.7 (WBGT = 29.1).

البيان | يُستخدم في | هل نستغني عنه؟ | البديل أو الافتراض | أثر الافتراض
ضغط الهواء | معادلة Liljegren | لا، لكن لا يحتاج قياسًا | قيمة ثابتة 945 hPa تناسب ارتفاع الرياض (نحو 600 م) | مهمل: تغييره بين 900 و1013 يغيّر WBGT أقل من 0.2°
موقع الشمس (cossza) | Liljegren | لا | يُحسب من الوقت والإحداثيات بمعادلة فلكية | لا أثر؛ حساب دقيق
نسبة الإشعاع المباشر (fdir) | Liljegren | لا، لكن يُفترض | 0.8 إذا كان العمود في الشمس، و0 في الظل | صغير: بين 0.6 و0.9 يتغير WBGT أقل من 0.7°
مستوى نشاط الزوار | اختيار حد ISO المرجعي (القسم 5.1) | نعم للعرض الحي | افتراض مشي خفيف (الفئة 1 أو 2) | يغيّر الحد المرجعي لا قيمة WBGT
ملابس الزوار (CAV) | WBGT الفعلي | نعم | ملابس عادية: CAV = 0 | لا أثر للملابس العادية
التأقلم مع الحر | اختيار حد ISO | نعم | افتراض غير متأقلم، لأن أغلب الزوار قادمون من خارج المنطقة | افتراض متحفظ في صالح سلامة الزائر
خصائص كل منطقة (ظل، نوع أرضية) | التقدير المكاني ج2 | نعم في الهاكثون | ثلاث فئات يدوية: شمس، ظل جزئي، ظل | لا يمس القراءة المقاسة؛ يمس تقدير المناطق بلا أعمدة فقط
حالة الأجهزة | قياس أثر التدخل، كشف الأعطال | نعم في الهاكثون | تسجيل يدوي في المنصة أو بيانات المحاكاة | لا أثر على المؤشر
جدول الفعاليات | خطر الفعالية | نعم | بيانات تجريبية معلنة كذلك | لا أثر على المؤشر
أعداد الزوار | ترتيب الأولوية | نعم | الاستغناء عنها، أو الاستعاضة بجدول الفعاليات | لا أثر؛ تُحذف الأرقام الوهمية أو يُعلن أنها وهمية
توقعات الطقس الخارجية | نموذج التوقع ج1 | نعم للعرض الحي | خط أساس بالاستمرارية أو المنحنى اليومي | التوقع يصبح أقل دقة فقط

الخلاصة: لا يوجد بند خارجي يمنع حساب WBGT. الافتراض الوحيد الذي يغيّر الرقم بشكل ملحوظ هو تحويل الإضاءة إلى إشعاع، وأثره صفر داخل القاعة.

# 4. المعادلات المعتمدة

## 4.1 مؤشر WBGT وفق ISO 7243:2017

WBGT يجمع العوامل البيئية الأربعة للإجهاد (حرارة الهواء، والرطوبة، والإشعاع، وحركة الهواء) في رقم واحد بوحدة °C. الوزن الأكبر للبصيلة الرطبة لأن قدرة العرق على التبخر هي العامل الحاسم في تبريد الجسم.

في الخارج تحت الشمس: WBGT = 0.7 × Tnw + 0.2 × Tg + 0.1 × Ta

في الداخل أو بلا شمس مباشرة: WBGT = 0.7 × Tnw + 0.3 × Tg

مع تصحيح الملابس: WBGTeff = WBGT + CAV

الرمز | المعنى | مصدره في هبوب
Tnw | حرارة البصيلة الرطبة الطبيعية: بصيلة بفتيل مبلل في الهواء الطبيعي، تمثل تبريد العرق | محسوبة (4.2)
Tg | حرارة الكرة السوداء: تمثل حرارة الشمس والأسطح | محسوبة (4.2)
Ta | حرارة الهواء في الظل | DHT22
CAV | قيمة تصحيح الملابس | 0 للملابس العادية

بحسب المعيار يُقاس WBGT عند مستوى البطن أو أشد نقطة حرارة، ويُحسب متوسط ساعة ممثلة، ويطبق على تعرض حتى 8 ساعات. في هبوب يُعرض الرقم اللحظي (متوسط دقيقة) للتشغيل، ومتوسط الساعة للتحليلات.

## 4.2 حساب Tnw وTg بطريقة Liljegren

بما أن العمود لا يحمل كرة سوداء ولا بصيلة رطبة، تُحسب القيمتان من موازنة الطاقة لكل منهما: الكرة تكسب حرارة من الشمس والأسطح وتفقدها بالرياح والإشعاع، والبصيلة الرطبة تفقد حرارة بالتبخر الذي يتحدد بالرطوبة والرياح. الحل بالتكرار حتى الاستقرار، ثم تُجمع القيم بمعادلة WBGT الخارجية.

المدخل | الوحدة | مصدره
حرارة الهواء Ta | K | DHT22 (‎+273.15‎)
الرطوبة النسبية RH | % | DHT22
ضغط الهواء | hPa | ثابت 945
سرعة الرياح على 10 م | m/s | مقياس الرياح بعد التحويل (4.3)
الإشعاع الشمسي الهابط | W/m² | VEML7700 بعد التحويل (4.4)
نسبة الإشعاع المباشر fdir | 0 إلى 1 | 0.8 في الشمس، 0 في الظل
جيب تمام زاوية سمت الشمس | 0 إلى 1 | محسوب من الوقت والإحداثيات (4.4)

التنفيذ: الدالة calculate_wbgt_liljegren في مكتبة thermofeel الإصدار 2.3.0. المكتبة تطبق تلقائيًا ضوابط KNMI: ترفع الرياح الأقل من 0.62 m/s على 10 م إلى هذا الحد، وتصفّر الإشعاع المباشر عندما تكون الشمس عند الأفق، وترجع NaN إذا لم يستقر الحل.

import numpy as np, thermofeel as tf

wbgt_k = tf.calculate_wbgt_liljegren(

t2_k=np.array([35 + 273.15]), rh=np.array([20.0]), pressure=np.array([945.0]),

va=np.array([1.33]), ssrd=np.array([800.0]), fdir=np.array([0.8]),

cossza=np.array([0.836]))

print(round(float(wbgt_k[0]) - 273.15, 1)) # 29.1

## 4.3 تحويل سرعة الرياح إلى ارتفاع 10 م

المكتبة تتوقع الرياح على ارتفاع 10 م، بينما مقياس هبوب على 1.8 م. التحويل بمقطع الرياح اللوغاريتمي، مع طول خشونة z0 = 0.01 م:

v10 = vh × ln(10 / z0) / ln(h / z0) = 1.33 × vh (عند h = 1.8 م)

سرعة الرياح عند الحساس تُحسب أولًا من الجهد بمعاملات المعايرة: v = K × V + B، وتساوي صفرًا إذا كان الجهد أقل من Vmin.

## 4.4 الإشعاع الشمسي وموقع الشمس

### الإشعاع من حساس الإضاءة

G (W/m²) ≈ E (lux) / 110

المعامل 110 تقريبي لضوء الشمس، والقيمة الحقيقية بين 95 و120 تقريبًا حسب حالة السماء. العمود يُعدّ «في الشمس» إذا زاد G عن 250 W/m²، فتُستخدم fdir = 0.8، وإلا فـ fdir = 0. الحساس يجب أن يكون موجهًا للأعلى وغير مظلل بجسم العمود.

### زاوية سمت الشمس

cos θz = sin φ × sin δ + cos φ × cos δ × cos h

φ خط العرض (الرياض 24.71°)، وδ ميل الشمس حسب يوم السنة، وh الزاوية الساعية من التوقيت الشمسي (خط الطول 46.68°، التوقيت UTC‎+3‎). تُحسب بصيغة NOAA المعروفة، أو بمكتبة pvlib. مثال: ظهر 15 أكتوبر cos θz = 0.836، وظهر 15 يناير 0.689.

## 4.5 الطريقة المبسطة الاحتياطية

WBGT ≈ 0.567 × Ta + 0.393 × e + 3.94

e ضغط بخار الماء بوحدة hPa. هذه الصيغة (ACSM 1984، وتستخدمها هيئة الأرصاد الأسترالية) لا تحتاج رياحًا ولا إشعاعًا، وتفترض شمسًا متوسطة ورياحًا خفيفة. تُستخدم فقط إذا تعطل مقياس الرياح أو حساس الإضاءة، مع العلامة wbgt_method = simple. عيبها أنها لا ترى أثر الظل ولا أثر المراوح، وتبالغ داخل القاعة (نحو 24 مقابل 19.1 بطريقة Liljegren في مثال القاعة).

e = (RH / 100) × 6.112 × exp( 17.62 × Ta / (243.12 + Ta) ) [hPa]

## 4.6 معايرة مقياس الرياح

1. تشغيل المروحة على 5 سرعات، مع مقياس رياح يدوي مرجعي في الموضع نفسه.
2. تسجيل 60 ثانية لكل سرعة: متوسط wind_v من العقدة ومتوسط القراءة المرجعية.
3. ملاءمة خط مستقيم بالمربعات الصغرى، وحساب R² وخطأ RMSE بوحدة m/s.
4. حفظ K وB وVmin في إعدادات الخادم مع تاريخ المعايرة.

## 4.7 أمثلة محسوبة

حُسبت بمكتبة thermofeel 2.3.0. الإشعاع وأثر الأجهزة افتراضات توضيحية لبيان حساسية المؤشر، وليست قياسات. الرياح على 1.8 م وحُوّلت إلى 10 م، والضغط 945 hPa.

الحالة | Ta °C | RH % | رياح عند الحساس m/s | إشعاع W/m² | WBGT °C | العلم
ظهر أكتوبر، شمس مباشرة | 35 | 20 | 1.0 | 800 | 29.1 | أخضر
+ تظليل | 35 | 20 | 1.0 | 120 (منتشر فقط) | 24.5 | أبيض
+ مراوح | 35 | 20 | 3.0 | 800 | 26.8 | أخضر
+ رذاذ (Ta ‎−3‎°، RH ‎+14‎) | 32 | 34 | 1.0 | 800 | 29.3 | أخضر
تظليل + رذاذ | 32 | 34 | 1.0 | 120 | 24.7 | أبيض
ظهر أكتوبر حار وساكن | 38 | 25 | 0.3 | 850 | 34.7 | أسود
داخل القاعة | 25 | 47 | 0.3 | 0 | 19.1 | أبيض
أمسية نوفمبر | 20 | 35 | 2.0 | 0 | 13.5 | أبيض
ظهر يناير مشمس | 20 | 30 | 1.5 | 600 | 17.8 | أبيض

ما تكشفه الأمثلة

التظليل أقوى تدخل لأنه يقطع الإشعاع عن الكرة: ‎−4.6‎° في المثال.

المراوح تفيد في هذا المثال (‎−2.3‎°) لأن الرياح تبرّد الكرة وتزيد التبخر. لكن ملف الفريق ينبّه إلى أن المراوح في الحر الشديد الجاف (قرب 39° فأعلى) قد تزيد الإجهاد على الجسم؛ لذلك قاعدة المراوح مقيدة بحرارة الهواء (القسم 6.3، ب5).

الرذاذ لا يخفض WBGT عمليًا (‎+0.2‎°) لأنه يخفض حرارة الهواء ويرفع الرطوبة، فتبقى البصيلة الرطبة شبه ثابتة. هذا يطابق ما في ملف الفريق: أثر الرذاذ على الإحساس أكبر من أثره على رقم WBGT.

الشتاء خارج نطاق WBGT: أمسيات نوفمبر وظهر يناير بعلم أبيض، والمؤشر لا يقيس البرد.

# 5. الحدود والجداول العالمية المعتمدة للإجهاد الحراري

## 5.1 الحدود المرجعية لـ WBGT وفق ISO 7243:2017

المعيار الدولي لا يعطي رقمًا واحدًا للخطر، بل حدًا مرجعيًا لكل مستوى نشاط. إذا تجاوز WBGTeff هذا الحد فالإجهاد الحراري قائم ويلزم إجراء (تقليل النشاط، راحة، تبريد). القيم من إصدار 2017، والجهات الأمريكية (ACGIH) تتبنى المنهجية نفسها وتسمي حد المتأقلم TLV وحد غير المتأقلم Action Limit.

فئة النشاط | مثال | المعدل التقريبي (W) | الحد للمتأقلم (°C) | الحد لغير المتأقلم (°C)
0 – راحة | جلوس | 115 | 33 | 32
1 – خفيف | عمل يدوي خفيف، وقوف | 180 | 30 | 29
2 – متوسط | مشي مستمر، حمل خفيف | 300 | 28 | 26
3 – شاق | حمل ثقيل، حفر | 415 | 26 | 23
4 – شاق جدًا | جهد أقصى سريع | 520 | 25 | 20

تطبيقها في هبوب: الزائر الذي يقف أو يمشي ببطء بين الأجنحة يقع غالبًا في الفئة 1، ومن يمشي مسافات طويلة في الفئة 2. والمقترح اعتبار الزوار غير متأقلمين لأن أغلبهم قادمون من خارج المنطقة. بهذا يكون الحد المرجعي للزوار 29°C (الفئة 1، غير متأقلم). أما فرق التشغيل والصيانة فيُطبّق عليهم حد فئة نشاطهم الفعلي، وهي زاوية إضافية لسلامة العاملين في الموقع.

## 5.2 جدول الأعلام التشغيلي

هذا التصنيف المبسط هو الأوسع استخدامًا ميدانيًا (العسكرية الأمريكية، OSHA، الرياضة)، ويحوّل قيمة WBGT إلى مستوى خطر وزمن راحة لكل ساعة نشاط تحت الشمس، بحسب حاسبة WBGT لدى هيئة الأرصاد الأمريكية (NWS).

العلم | WBGT (°C) | يبدأ الإجهاد بعد | الراحة المطلوبة كل ساعة
أبيض | 26.6 أو أقل | — | لا قيود خاصة
أخضر | 26.7 إلى 29.3 | 45 دقيقة | 15 دقيقة على الأقل
أصفر | 29.4 إلى 31.0 | 30 دقيقة | 30 دقيقة على الأقل
أحمر | 31.1 إلى 32.1 | 20 دقيقة | 40 دقيقة على الأقل
أسود | 32.2 أو أكثر | 15 دقيقة | 45 دقيقة على الأقل

لا تُخلط الأرقام بين المؤشرات: 32°C في WBGT تعني خطرًا عاليًا (علم أسود)، بينما 32°C في مؤشر الحرارة بداية الحذر فقط.

## 5.3 المؤشرات المساندة وجداولها

هذه المؤشرات لا تحل محل WBGT، لكن اللجنة قد تسأل عنها، وبعضها مفيد للمقارنة.

### مؤشر المناخ الحراري العالمي (UTCI)

مؤشر دولي لراحة الناس في الأماكن الخارجية، يحسب من حرارة الهواء والرطوبة والرياح على 10 م ومتوسط درجة الحرارة الإشعاعية (Tmrt) بمتعددة حدود من الدرجة السادسة، ويغطي الحر والبرد. فئاته العشر للعلم:

UTCI °C | الفئة | الإجراءات الموصى بها
أكبر من 46 | إجهاد حراري شديد (Extreme heat stress) | تبريد مؤقت للجسم، منع النشاط البدني، شرب أكثر من 0.5 لتر/ساعة
38 إلى 46 | إجهاد حراري قوي جدًا (Very strong) | تكييف مؤقت، أماكن مظللة ضرورية، تقليل النشاط
32 إلى 38 | إجهاد حراري قوي (Strong) | أماكن مظللة، شرب أكثر من 0.25 لتر/ساعة
26 إلى 32 | إجهاد حراري معتدل (Moderate) | شرب أكثر من 0.25 لتر/ساعة
9 إلى 26 | لا إجهاد حراري (No thermal stress) | لا إجراء
0 إلى 9 | إجهاد برد خفيف (Slight cold) | ملابس دافئة خفيفة
‎−13‎ إلى 0 | إجهاد برد معتدل (Moderate cold) | زيادة النشاط، حماية الوجه والأطراف
‎−27‎ إلى ‎−13‎ | إجهاد برد قوي (Strong cold) | ملابس دافئة
‎−40‎ إلى ‎−27‎ | إجهاد برد قوي جدًا (Very strong cold) | تقليل وقت البقاء في الخارج
أقل من ‎−40‎ | إجهاد برد شديد (Extreme cold) | البقاء في الداخل

### مؤشر الحرارة (Heat Index) — هيئة الأرصاد الأمريكية NWS

يعتمد على حرارة الهواء والرطوبة فقط بمعادلة Rothfusz (1990)، ويفترض الظل. في الأجواء الجافة جدًا مثل الرياض يكون منخفضًا نسبيًا رغم شدة الشمس، فلا يصلح مؤشرًا رئيسيًا. التصنيف بحسب جدول ECMWF المأخوذ من NWS:

مؤشر الحرارة °C | التصنيف | الأثر على الجسم
26.7 إلى 32.2 | حذر (Caution) | إرهاق محتمل مع التعرض الطويل أو النشاط
32.2 إلى 39.4 | حذر شديد (Extreme caution) | ضربة شمس أو تشنجات أو إنهاك حراري محتمل مع التعرض الطويل
39.4 إلى 51.1 | خطر (Danger) | التشنجات والإنهاك مرجّحان، وضربة الشمس محتملة
51.1 فأكثر | خطر شديد (Extreme danger) | ضربة الشمس مرجّحة جدًا

### مؤشر Humidex — كندا

Humidex = Ta + 0.5555 × (e − 10)، حيث e ضغط البخار بوحدة hPa. يعتمد على الحرارة والرطوبة فقط، وأثره محدود في هواء الرياض الجاف.

Humidex °C | درجة الإزعاج
20 إلى 30 | إزعاج بسيط
30 إلى 40 | بعض الإزعاج
40 إلى 46 | إزعاج كبير؛ تجنب المجهود
46 فأكثر | خطر؛ ضربة شمس محتملة

### حرارة المكافئ الفسيولوجي (PET)

PET شائع في دراسات التخطيط الحضري، ويحتاج المدخلات البيئية مع افتراضات عن الشخص. التصنيف المتداول (Matzarakis وMayer 1996، لغرب أوروبا ووسطها): 18–23 لا إجهاد، 23–29 إجهاد حراري خفيف، 29–35 معتدل، 35–41 قوي، أكثر من 41 شديد. هذه الحدود معايرة على مناخ أوروبي، ويُتحقق منها في المرجع قبل الاستشهاد بها.

## 5.4 لماذا WBGT هو المؤشر الرئيسي في هبوب

المؤشر | المدخلات | يشمل الإشعاع | يشمل الرياح | له حدود تدخل دولية | دوره في هبوب
WBGT | Tnw، Tg، Ta | نعم | نعم | نعم (ISO 7243، ACGIH، OSHA) | المؤشر الرئيسي لكل القرارات
UTCI | Ta، RH، الرياح، Tmrt | نعم | نعم | فئات استجابة لا حدود تدخل | مقارنة، ولتغطية البرد مستقبلًا
Heat Index | Ta، RH | لا (يفترض الظل) | لا | تصنيف تحذيري | مقارنة مفهومة للجمهور فقط
Humidex | Ta، ضغط البخار | لا | لا | لا | لا يُستخدم
PET | المدخلات البيئية + صفات الشخص | نعم | نعم | لا | مقارنة أكاديمية إن طُلبت

أسباب الاختيار: WBGT يجمع العوامل البيئية الأربعة التي يذكرها نص التحدي 2.3، وله معيار دولي بحدود تدخل واضحة لكل مستوى نشاط، ونظام أعلام مجرّب في الفعاليات والرياضة يفهمه المشغّل مباشرة، ومعادلته بسيطة تفسّر أثر كل أداة تلطيف (الظل يخفض Tg، والتكييف يخفض Tnw). حدّان يجب معرفتهما: المعيار صُمم للتعرض المهني حتى 8 ساعات، ولا يقيس إجهاد البرد.

## 5.5 مناخ الرياض خلال فترة إكسبو

يُقام إكسبو 2030 الرياض من 1 أكتوبر 2030 إلى 31 مارس 2031 بحسب المكتب الدولي للمعارض (BIE). المتوسطات الشهرية التالية من سجل climate-zone لمحطة الرياض، وهي تقريبية للتخطيط فقط:

الشهر | متوسط العظمى °C | متوسط الصغرى °C | ما يعنيه لهبوب
أكتوبر | 35 | 21 | أعلام خضراء إلى سوداء في الساحات المشمسة ظهرًا؛ أعلى حمل على التظليل والتبريد
نوفمبر | 26 | 15 | علم أبيض غالبًا، وأخضر محتمل في الشمس المباشرة
ديسمبر | 22 | 11 | علم أبيض؛ لا إجهاد حراري
يناير | 20 | 8 | علم أبيض؛ البرد في الفجر والليل خارج نطاق WBGT
فبراير | 23 | 11 | مشابه لديسمبر
مارس | 26 | 13 | عودة الأعلام الخضراء في الشمس أواخر الشهر

الاستنتاج: الطلب على التدخل يتركز في أكتوبر وبداية نوفمبر ومارس. من ديسمبر إلى فبراير يبقى WBGT غالبًا بعلم أبيض، والبرد في الأمسيات خارج نطاق المؤشر. إذا أراد الفريق تغطيته لاحقًا يمكن عرض UTCI كمؤشر مساند في هذه الأشهر.

## 5.6 موقف حدود المنصة الحالية من المعيار

النموذج الأولي للمنصة بُني على أرقام UTCI، وهذه الأرقام لا تصلح مع WBGT لأن المقياسين مختلفان:

العنصر في النموذج الأولي | الحد المستخدم | ما يقابله في WBGT | التعديل المطلوب
الحالة «مريحة» | أقل من 32 | 32 في WBGT علم أسود | تصبح: علم أبيض، 26.6 أو أقل
الحالة «تنبيه» | 32 إلى 38 | كلها فوق حد الخطر | تصبح: أخضر وأصفر
الحالتان «إجهاد حراري» و«حرجة» | 38–42 وأكبر من 42 | قيم WBGT نادرة الحدوث | تصبحان: أحمر وأسود
شريط التصنيف في صفحة المنطقة | فئات UTCI الخمس | غير مطابق | يُستبدل بالأعلام الخمسة مع خط الحد المرجعي 29
رد الخادم وشاشة العقدة | utci_c وstress_key | غير مطابق | wbgt_c وflag، وتلوين الشاشة بالأعلام

### المقترح: المستوى التشغيلي = علم WBGT

المستوى التشغيلي | شرط الدخول (WBGT °C) | الإجراء الافتراضي
أبيض — مراقبة | 26.6 أو أقل | مراقبة فقط
أخضر — جاهزية | 26.7 إلى 29.3 | توفير مياه الشرب، ومتابعة الفعاليات القريبة
أصفر — تدخل | 29.4 إلى 31.0 | تفعيل التظليل، ثم المراوح بحسب القاعدة ب5؛ تجاوز الحد المرجعي 29 للزوار
أحمر — تدخل فوري | 31.1 إلى 32.1 | التظليل والتبريد فورًا، ومراجعة توقيت الفعاليات
أسود — خطر | 32.2 أو أكثر | تدخل فوري، وتقليل النشاط، وتقييد الوصول عند الحاجة

قواعد الاستقرار المقترحة: الصعود لعلم أعلى بعد بقاء الشرط 3 دقائق متصلة، والنزول بعد انخفاض WBGT نصف درجة تحت الحد لمدة 5 دقائق. هذا يمنع تذبذب الحالة والأجهزة حول الحد. القيم مقترحة وتحتاج قرار الفريق، وتغييرها يمس الواجهة وشاشة العقدة والعرض التقديمي.

# 6. حصر التحليلات والقرارات في المنصة وتصنيفها

الحصر مأخوذ من صفحات النموذج الأولي: النظرة العامة، الخريطة والفعاليات، تفاصيل المنطقة، التنبيهات، الأتمتة، الصيانة، التحليلات، وشبكة المستشعرات. كل بند صُنّف في واحدة من ثلاث فئات:

- الفئة أ — حساب حتمي: معادلة أو جدول؛ المدخل نفسه يعطي المخرج نفسه دائمًا. لا تدريب.
- الفئة ب — قواعد وإحصاء ومحاكاة فيزيائية: منطق شرطي، عتبات، متوسطات، استيفاء، أو إعادة حساب WBGT بمدخلات معدّلة. لا تدريب، لكن فيها معاملات تُضبط بالتجربة.
- الفئة ج — نموذج تعلم آلي: يحتاج بيانات تاريخية وتدريبًا وتقييمًا على بيانات لم يرها.

## 6.1 الجدول الشامل

# | التحليل | أين يظهر | الفئة | ممكن في الهاكثون

أ1 | حساب WBGT لكل رسالة | تفاصيل المنطقة، شاشة العقدة | أ | نعم
أ2 | علم WBGT، ومقارنته بالحد المرجعي 29 | كل الصفحات | أ | نعم
أ3 | حالة المنطقة: متوسط أعمدتها ثم المستوى التشغيلي | الخريطة، المؤشرات | أ | نعم
أ4 | مؤشرات الصفحة الرئيسية: عدد المناطق لكل علم، التنبيهات، الأعمدة المتصلة | النظرة العامة | أ | نعم
أ5 | حالة اتصال العمود (متصل، تحذير، غير متصل) | شبكة المستشعرات | أ | نعم
أ6 | ساعات العلم الأصفر فأعلى لكل منطقة، وخريطة الساعات × الأيام | التحليلات | أ | بعد تراكم بيانات
أ7 | مؤشرات الكفاءة: عدد التدخلات، نسبة اعتماد التوصيات، زمن الاستجابة، المياه والطاقة | التحليلات | أ (من سجلات المنصة) | جزئيًا
أ8 | زمن الراحة الموصى به لكل ساعة بحسب العلم | تفاصيل المنطقة | أ | نعم
ب1 | تنظيف البيانات وكشف القيم الشاذة | خلفية | ب | نعم
ب2 | سد الفجوات القصيرة | خلفية | ب | نعم
ب3 | تقدير قراءة عمود منقطع من جيرانه | تنبيه «قراءات تقديرية» | ب | يحتاج عمودين
ب4 | تفسير السبب: مساهمة كل عامل في WBGT | «لماذا ارتفع الإجهاد؟» | ب (محاكاة) | نعم
ب5 | اختيار الإجراء الموصى به | توصية هبوب | ب (قواعد) | نعم
ب6 | الأثر المتوقع للإجراء على WBGT | «انخفاض متوقع −X°» | ب (محاكاة) | نعم
ب7 | قواعد الأتمتة مع منع التذبذب | الأتمتة | ب | نعم
ب8 | الاتجاه: «ارتفع 1.5° خلال 40 دقيقة» | التنبيهات | ب (إحصاء) | نعم
ب9 | كشف عطل جهاز من أثره | الصيانة | ب | جزئيًا
ب10 | مؤشر جودة القراءة بدل «ثقة 94%» | توصية هبوب | ب | نعم
ب11 | خطر الفعالية ومدى حاجتها لتدخل | الفعاليات | ب (يعتمد على ج1) | نعم مع ج1
ج1 | توقع WBGT للساعات القادمة لكل منطقة | النظرة العامة، تفاصيل المنطقة | ج | نموذج أولي على بيانات عامة
ج2 | تقدير WBGT للمناطق بلا أعمدة | الخريطة | ج (يبدأ فيزيائيًا) | تصميم ومحاكاة
ج3 | اقتراح أفضل وقت ومكان للفعالية | تحسين الفعالية | تحسين يعتمد على ج1 وج2 | نعم بصيغة مبسطة
ج4 | تعلّم الأثر الفعلي للتدخلات من البيانات | التحليلات | ج | مستقبلي
ج5 | كشف الشذوذ متعدد المتغيرات | الصيانة | ج (اختياري) | مستقبلي

خارج النطاق: «الزوار الآن» لا مصدر بيانات له. تبقى أرقامه وهمية وتُعلن كذلك، أو تُحذف من العرض.

## 6.2 الفئة أ: الحسابات الحتمية

### أ1 إلى أ3: من الرسالة إلى حالة المنطقة

1. التحقق من حالة DHT22؛ إذا نقصت حرارة الهواء أو الرطوبة لا يُحسب WBGT ويُسجل السبب.
2. إذا نقص مقياس الرياح أو حساس الإضاءة: الطريقة المبسطة (4.5) مع العلامة fallback_simple.
3. حساب سرعة الرياح من الجهد، وتحويلها إلى 10 م.
4. حساب الإشعاع من الإضاءة، وتحديد الشمس أو الظل، وحساب زاوية الشمس من الوقت.
5. حساب WBGT بطريقة Liljegren، ثم العلم.
6. حالة المنطقة = متوسط WBGT لأعمدتها السليمة خلال آخر دقيقتين، وتُعرض معه أعلى قيمة إذا اختلفت الأعمدة بأكثر من درجة.
7. المستوى التشغيلي من الجدول في القسم 5.6 مع قواعد الاستقرار.

الكود المرجعي لهذه الخطوات في الملحق أ، وقد جُرّب على أمثلة في بيئة Python (لم يُجرَّب بعد مع العقدة).

### أ5: حالة العمود

الحالة | الشرط المقترح
متصل | آخر رسالة خلال 5 دقائق، والحساسات المرتبطة بالمؤشر بحالة ok
تحذير | حساس مرتبط بالمؤشر بحالة read_error أو not_found، أو إعادة تشغيل متكررة، أو إشارة واي فاي أضعف من ‎−80‎ dBm
غير متصل | لا رسالة منذ 5 دقائق

### أ6 إلى أ8: التجميعات

ساعات التجاوز = عدد الدقائق التي كان فيها WBGT 29.4 فأكثر (أصفر فأعلى) مقسومًا على 60، لكل منطقة ويوم. خريطة الحرارة = متوسط WBGT لكل ساعة × يوم. زمن الراحة الموصى به يُقرأ مباشرة من جدول الأعلام. مؤشرات الكفاءة تُحسب من سجل الأجهزة والقرارات: نسبة الاعتماد = المعتمد ÷ المقترح، وزمن الاستجابة = وقت الاعتماد − وقت التنبيه. استهلاك المياه والطاقة لا يُقاس الآن؛ يُقدَّر من مدة التشغيل × معدل الجهاز الاسمي ويُعلن أنه تقدير.

## 6.3 الفئة ب: القواعد والإحصاء والمحاكاة

### ب1: قواعد تنظيف البيانات (قيم مقترحة)

الفحص | القاعدة | النتيجة
حدود المدى | Ta بين ‎−10‎ و60، RH بين 0 و100، الرياح بين 0 و40 m/s، الإضاءة بين 0 و130,000 lux | رفض القراءة
معدل التغير | Ta أكثر من 3° في الدقيقة، أو RH أكثر من 15% في الدقيقة | علامة spike وإبعادها عن المتوسط
قيمة ثابتة | تغير أقل من 0.05 لمدة 30 دقيقة (عدا الرياح الصفرية) | علامة stuck وتنبيه صيانة
اتساق الأعمدة | فرق Ta بين عمودين في المنطقة نفسها أكثر من 3° لمدة 15 دقيقة | تنبيه اشتباه انحراف حساس

### ب2 وب3: الفجوات والأعمدة المنقطعة

الفجوة حتى 3 رسائل تُسد باستيفاء خطي مع علامة estimated، والفجوة الأطول لا تُسد. عند انقطاع عمود تُقدَّر قراءته من الأعمدة المجاورة بمتوسط موزون بمعكوس المسافة (IDW)، وتُعرض بلون مختلف مع عبارة «تقديرية». مع عقدة واحدة في الهاكثون يُعرض هذا بوضع المحاكاة في الخادم.

### ب4: تفسير السبب بالمحاكاة العكسية (Counterfactual)

النموذج الأولي يحسب «مساهمة العوامل» بمعادلات خطية اعتباطية. البديل المقترح دقيق وقابل للدفاع عنه: نعيد حساب WBGT وفي كل مرة نعيد عاملًا واحدًا إلى قيمة مرجعية، والفرق هو مساهمته:

مساهمة الإشعاع = WBGT(الحالي) − WBGT(بإشعاع صفر)

مساهمة ضعف الرياح = WBGT(الحالي) − WBGT(برياح المنطقة المعتادة)

القيم المرجعية: إشعاع صفر (ظل كامل)، ورياح المنطقة المعتادة (وسيطها، واقتراح أولي 3 m/s عند 10 م حتى تتوفر بيانات)، ورطوبة 50%. في مثال ظهر أكتوبر (29.1): الإشعاع يساهم بـ 6.1 درجة، وضعف الرياح بـ 1.8، والهواء الجاف يخفض المؤشر 4.9 درجات مقارنة برطوبة 50%. هذه ميزة ابتكار قوية: التفسير ناتج من المعادلة الفيزيائية نفسها، لا من تخمين، ويقود مباشرة إلى الأداة المناسبة.

### ب5: جدول قواعد التوصية

القواعد مبنية على المكوّن الذي تخفضه كل أداة، بحسب ملف الفريق عن أدوات التلطيف:

الشرط | الإجراء المقترح | المكوّن الذي يخفضه | سبب الاختيار
العلم أصفر فأعلى، ومساهمة الإشعاع هي الأكبر | التظليل أولًا (آلي أو يدوي) | Tg | أكبر أثر في الأمثلة (‎−4.6‎°)
الرياح عند الحساس أقل من 1.5 m/s، وTa أقل من 37° | المراوح | Tnw وTg | تزيد التبخر وتبرّد الكرة؛ وفوق قرابة 39° في الحر الجاف قد تزيد الإجهاد
العلم أحمر أو أسود في مساحة شبه مغلقة | التكييف الموضعي | Ta وTnw | الأكثر خفضًا لـ WBGT والأعلى كلفة
Ta أعلى من 32 والرطوبة أقل من 40%، بعد التظليل | الرذاذ لتحسين الإحساس | Ta | أثره على رقم WBGT صغير لكنه يحسّن الإحساس
الرطوبة أعلى من 50% | لا رذاذ ولا مبردات تبخيرية | — | تضعف كفاءتها وترفع الرطوبة
لا أنظمة ثابتة في المنطقة | إسناد مهمة نقل مبرّد أو مظلة متنقلة | بحسب الأداة | يطابق سير العمل في المنصة

حدود الرطوبة والرياح والحرارة هنا مقترحة، وتُضبط بعد قياس أثر الأجهزة الفعلية.

### ب6: الأثر المتوقع للإجراء

يُحسب بالطريقة نفسها: WBGT بعد الإجراء − WBGT الآن، مع تعديل المدخل الذي يؤثر فيه الجهاز. التظليل يخفض الإشعاع إلى المنتشر فقط، والمراوح ترفع الرياح بقيمة يحددها الجهاز، والرذاذ يخفض Ta ويرفع RH. قيم أثر كل جهاز غير معروفة بعد، وتُستخرج من تجربة قبل/بعد على النموذج الأولي (مثل تجربة المروحة). بعد تراكم بيانات حقيقية يتحول هذا البند إلى ج4.

### ب7 إلى ب11

- ب7 قواعد الأتمتة: التشغيل عند تجاوز الحد لمدة 3 دقائق، والإيقاف عند النزول نصف درجة تحت الحد لمدة 5 دقائق، مع حد أدنى لمدة التشغيل 10 دقائق لحماية الأجهزة.
- ب8 الاتجاه: ميل خط الانحدار لـ WBGT خلال آخر 30 دقيقة بوحدة °/ساعة؛ التنبيه عند ميل أكبر من 1.5°/ساعة والعلم أخضر فأعلى.
- ب9 كشف العطل من الأثر: جهاز يعمل منذ 15 دقيقة ولم ينخفض WBGT بنصف الأثر المتوقع على الأقل يُعلَّم «اشتباه عطل».
- ب10 مؤشر الجودة: عالٍ إذا حُسب WBGT بطريقة Liljegren بحساسات معايرة، ومتوسط إذا كانت الرياح غير معايرة أو الإشعاع مقدّرًا تحت الشمس، ومنخفض إذا استُخدمت الطريقة المبسطة أو كانت القراءة مقدّرة من الجيران. يُعرض بدل نسبة الثقة.
- ب11 خطر الفعالية: WBGT المتوقع لموقع الفعالية ووقتها (من ج1) ثم العلم، فيُصنّف: لا يحتاج، متابعة، يحتاج تدخل.

## 6.4 الفئة ج: ما يحتاج نموذج تعلم آلي

### ج1: توقع WBGT للساعات القادمة

البند | التفاصيل
الهدف | WBGT لكل منطقة لكل ساعة من 1 إلى 6 ساعات قادمة
النهج الموصى به | هجين: نتوقع المدخلات (Ta، RH، الرياح، الإشعاع) من توقع طقس خارجي، ونصحح انحيازها المحلي بنموذج تعلم آلي، ثم نحسب WBGT بطريقة Liljegren. أدق وأسهل تفسيرًا من توقع WBGT مباشرة
خط الأساس للمقارنة | الاستمرارية (القيمة الآن = القيمة بعد ساعة)، والمنحنى اليومي المتوسط لنفس الشهر
النموذج | Gradient Boosting (مثل LightGBM) لتصحيح الانحياز، وهو مناسب لبيانات جدولية صغيرة
الخصائص (Features) | الساعة، زاوية الشمس، القيم السابقة (قبل 1 و2 و3 ساعات)، قيم التوقع الخارجي، علامات تشغيل الأجهزة
بيانات التدريب | قبل الهاكثون: ERA5 للرياض لأشهر أكتوبر إلى مارس لعدة سنوات، ويُحسب منها WBGT بالمعادلة نفسها. لاحقًا: بيانات الأعمدة
التقييم | MAE وRMSE بالدرجات على سنة لم يرها النموذج، ونسبة التحسن على خط الأساس، ونسبة إصابة العلم الصحيح
ما يُقال للجنة | الدقة المقيسة على بيانات ERA5 فقط؛ دقة الموقع الفعلية تحتاج بيانات من الأعمدة

### ج2: تقدير المناطق التي لا يوجد فيها عمود

هذا البند هو قلب التحدي 2.3 الذي ينص على أن القياس «في نقاط ثابتة قليلة فقط». الهواء متقارب بين المناطق القريبة، والفرق الأكبر في WBGT يأتي من الإشعاع (الظل أو الشمس) ومن الرياح.

1. المرحلة الفيزيائية (ممكنة الآن): Ta وRH من أقرب الأعمدة بـ IDW، والرياح معدلة بمعامل انكشاف المنطقة، والإشعاع من فئة الظل للمنطقة (شمس، ظل جزئي، ظل) وزاوية الشمس، ثم WBGT بطريقة Liljegren.
2. مرحلة التعلم (بعد جمع بيانات): نموذج يتعلم الفرق بين WBGT المنطقة والعمود المرجعي من خصائص المنطقة والوقت، ثم توزيع البواقي مكانيًا (Kriging) إن توفرت أعمدة كافية.
3. التحقق: إخفاء عمود واحد في كل مرة وتقدير قيمته من البقية (Leave-one-out)، وحساب الخطأ.

مع عقدة واحدة في الهاكثون لا يمكن التحقق من التقدير المكاني. يُعرض كتصميم ومحاكاة، ويُذكر ذلك صراحة.

### ج3 إلى ج5

- ج3 تحسين الفعالية: بحث في الخيارات المتاحة (المناطق × الأوقات) لاختيار أقل WBGT متوقع مع قيود السعة والمسافة، باستخدام مخرجات ج1 وج2.
- ج4 أثر التدخلات الفعلي: مقارنة قبل/بعد التشغيل مع ضبط أثر الوقت والطقس (مقارنة بمنطقة لم يُشغّل فيها جهاز). يحتاج أسابيع من البيانات، وهو مستقبلي.
- ج5 كشف الشذوذ متعدد المتغيرات: مثل Isolation Forest على متجه القراءات. اختياري، وقواعد ب1 تكفي للنموذج الأولي.

# 7. مصادر البيانات للتدريب والاختبار

المصدر | ماذا يوفر | الاستخدام في هبوب | طريقة الوصول وملاحظات
عقدة هبوب node-01 | قراءات خام كل 5 ثوانٍ وحالة الحساسات | المعايرة، التحقق، لحظة الإثبات | جدول wbgt_minute (القسم 3.3)، أو «أدوات ← تصدير CSV» بعد رفع مدة الحفظ
وضع المحاكاة في الخادم | عقدتان وهميتان ومحاكاة أعطال | اختبار التنظيف والتنبيهات والتقدير من الجيران | app.py --simulate --port 5050
Open-Meteo Historical (ERA5) | بيانات ساعية منذ 1940: حرارة الهواء، الرطوبة، الرياح على 10 م، الإشعاع الشمسي، ضغط السطح | حساب WBGT التاريخي للرياض لتدريب ج1، وبناء المنحنى اليومي لأشهر إكسبو | بلا مفتاح للاستخدام غير التجاري. الرياح افتراضيًا بوحدة km/h، فيُطلب wind_speed_unit=ms
Open-Meteo Forecast | توقعات ساعية حية بالمتغيرات نفسها | مدخل نموذج التوقع الهجين | الواجهة نفسها
مكتبة thermofeel من ECMWF | WBGT بطريقة Liljegren والطريقة المبسطة، وUTCI | المحرك الحسابي في الخادم | مفتوحة المصدر، الإصدار 2.3.0
المخطط العام لإكسبو | مواقع المناطق وأنواع الأسطح والظل | خصائص المناطق في ج2 | يُعد يدويًا في جدول

هيكل البيانات الموحد للتدريب هو جدول wbgt_minute في القسم 3.3. بيانات ERA5 تُحوَّل إلى الأعمدة نفسها (مع node_id = era5) حتى يعمل الكود نفسه على الاثنين.

# 8. خطة التنفيذ حتى التسليم

الأولوية لما يُثبت أمام اللجنة في 16–17 أكتوبر. كل بند مرتبط بمعيار التحكيم الذي يخدمه.

الموعد | المهمة | المخرج | المعيار الذي يخدمه
12–13 أكتوبر | محرك WBGT (أ1–أ3) بمكتبة thermofeel، ورفع مدة الحفظ، وتعديل رد الخادم إلى wbgt_c وflag | دالة مختبرة على أمثلة القسم 4.7 | الجودة التقنية 20%
13 أكتوبر | معايرة الرياح بالمروحة والمقياس اليدوي، وفحص قراءة الإضاءة في الشمس | K وB وVmin مع R² وRMSE | الجودة التقنية، الجدوى
14 أكتوبر | ب1 تنظيف، وب4 التفسير بالمحاكاة العكسية، وب6 الأثر المتوقع، وب10 مؤشر الجودة | نهايات API تستدعيها اللوحة | الابتكار 25%
14–15 أكتوبر | ج1 خط أساس على ERA5 للرياض (أكتوبر–مارس): الاستمرارية مقابل النموذج | MAE مقيس على سنة محجوزة | الابتكار، الجدوى
15–16 أكتوبر | ربط النتائج بالمنصة، وإعداد لحظة الإثبات | عرض حي يعمل | جودة العرض 10%
16 أكتوبر | تجميد الكود، وتوثيق الأرقام المقيسة فقط في ملف المشروع | جدول نتائج | كل المعايير

لحظة الإثبات المقترحة أمام اللجنة (30 ثانية)

1. العقدة تعرض WBGT وعلمه داخل القاعة (أبيض).

2. مصباح قوي موجّه لحساس الإضاءة يحاكي الشمس: الإشعاع يرتفع، وWBGT يرتفع، والعلم يتغير على الشاشة واللوحة.

3. تغطية الحساس بمظلة صغيرة: WBGT ينخفض، والتفسير يعرض أن الإشعاع كان السبب.

4. تشغيل المروحة: الرياح ترتفع وWBGT ينخفض أكثر، والتوصية تتغير.

5. جملة واحدة: «الحساب نفسه يعمل على كل عمود، والخريطة تقدّر ما بين الأعمدة».

تنبيه: ضوء المصباح يختلف عن الشمس، فيُعلن أنه محاكاة لإثبات الاستجابة لا قياس للشمس.

# 9. أسئلة اللجنة المتوقعة

السؤال | الإجابة المدعومة
لماذا WBGT وليس UTCI أو مؤشر الحرارة؟ | WBGT معيار دولي (ISO 7243) يجمع العوامل البيئية الأربعة، وله حدود تدخل وأعلام مجربة في الفعاليات والرياضة. مؤشر الحرارة يتجاهل الشمس والرياح، وUTCI لا يعطي حدود تدخل.
لا يوجد عندكم كرة سوداء ولا بصيلة رطبة. كيف تحسبون WBGT؟ | نحسبهما من حرارة الهواء والرطوبة والرياح والإشعاع بطريقة Liljegren (2008)، وهي المستخدمة تشغيليًا في معهد الأرصاد الهولندي، ومنفذة في مكتبة ECMWF.
الإشعاع من حساس إضاءة؟ ما دقته؟ | تحويل تقريبي، وخطأ 20% فيه يغيّر WBGT نحو 1.2 درجة تحت الشمس. داخل القاعة لا أثر له. النسخة الميدانية تضيف حساس إشعاع أو كرة سوداء.
أين الذكاء الاصطناعي؟ | في التوقع والتقدير المكاني، حيث لا تكفي المعادلة. القرارات اليومية حسابات فيزيائية وقواعد شفافة عن قصد، لأن المشغّل يحتاج قرارًا يمكن تفسيره.
كيف تقدّرون المناطق بلا حساسات؟ | الهواء متقارب بين المناطق، والفرق يأتي من الظل والرياح. نستوفي الهواء من الأعمدة ونحسب الإشعاع من فئة الظل لكل منطقة، ونتحقق بإخفاء عمود وتقديره.
ما دقة التوقع؟ | نذكر فقط الرقم المقيس على بيانات ERA5 المحجوزة، ونقارنه بالاستمرارية. دقة الموقع تحتاج بيانات من الأعمدة نفسها.
الرذاذ لا يخفض WBGT في حساباتكم. لماذا تقترحونه؟ | صحيح، ولهذا لا يوصي به هبوب لخفض المؤشر بل لتحسين الإحساس بعد التظليل، وفي هواء جاف فقط، وهذا يقلل استهلاك المياه.
ماذا يحدث إذا تعطل حساس؟ | لكل حساس حالة في كل رسالة. إذا تعطل مقياس الرياح أو حساس الإضاءة نستخدم الطريقة المبسطة بعلامة واضحة، وإذا تعطل حساس الحرارة لا نعرض رقمًا، ويُنشأ تنبيه صيانة.

# 10. المفتوح والافتراضات والمخاطر

## 10.1 قرارات تحتاج الفريق

1. اعتماد الحد المرجعي للزوار (29°C: الفئة 1 غير متأقلم) وجدول الأعلام كمستوى تشغيلي، وقواعد الاستقرار.
2. تحديث الواجهة وشاشة العقدة من أرقام UTCI إلى أعلام WBGT.
3. حذف «ثقة التوصية» ونسب التوفير من النموذج الأولي أو تحويلها إلى «هدف».
4. قيمة history_keep_minutes وسياسة التصدير.
5. هل يُعرض UTCI كمؤشر مساند في أشهر الشتاء لتغطية البرد؟

## 10.2 الافتراضات المستخدمة في هذه الوثيقة

- ضغط هواء ثابت 945 hPa، وطول خشونة z0 = 0.01 م في تحويل الرياح.
- تحويل الإضاءة إلى إشعاع بمعامل 110، ونسبة إشعاع مباشر 0.8 في الشمس.
- قيم الإشعاع وأثر الأجهزة في أمثلة القسم 4.7 توضيحية.
- حدود التنظيف وقواعد التوصية والاستقرار مقترحة وتُضبط بالتجربة.

## 10.3 أدلة مطلوبة

- نتيجة معايرة الرياح (K، B، R²، RMSE).
- قياس أثر المروحة والتظليل على WBGT في تجربة قبل/بعد.
- MAE لنموذج التوقع على سنة محجوزة من ERA5.

## 10.4 المخاطر

الخطر | الأثر | التخفيف
ناقل I2C لا يعمل يوم العرض | لا رياح ولا إضاءة، فيُحسب WBGT بالطريقة المبسطة | وضع المحاكاة جاهز، وتسجيل فيديو احتياطي للعرض الحي
عدم توافق إصدارات المكتبات | توقف الحساب أثناء العرض | تثبيت thermofeel==2.3.0 في requirements.txt واختبار قبل يوم
عرض أرقام غير مقيسة كنتائج | إضعاف المصداقية أمام اللجنة | كل رقم في العرض يُربط بمصدره أو يُصاغ كهدف
بيانات تدريب محلية غير موجودة | دقة التوقع في الموقع غير معروفة | التصريح بذلك، والاعتماد على ERA5 لإثبات المنهجية

## 10.5 الأثر على ملفات أخرى

اعتماد هذه الوثيقة يعني تحديث: حدود الحالات في النموذج الأولي للمنصة (ريم وريفان)، وتلوين شاشة العقدة ورد الخادم (لينا وسارة)، وإعدادات الخادم config.json، وشرائح العرض التي تذكر UTCI أو الدقة أو التوفير، وملف المشروع في قسم التقنيات.

## 10.6 الخطوة التالية الموصى بها

تشغيل محرك WBGT على الخادم الآن مع رفع مدة حفظ البيانات، لأن كل ما بعده (المعايرة، التفسير، التوقع) يعتمد على حساب صحيح وبيانات محفوظة.

# 11. المراجع

[1] ISO 7243:2017 — Ergonomics of the thermal environment: Assessment of heat stress using the WBGT index.

[2] Liljegren J.C. et al. (2008). Modeling the wet bulb globe temperature using standard meteorological measurements. J Occup Environ Hyg 5(10):645–655.

[3] ECMWF thermofeel 2.3.0 — calculate_wbgt_liljegren, calculate_wbgt_simple. https://github.com/ecmwf/thermofeel

[4] ACSM (1984). Prevention of thermal injuries during distance running. Physician and Sportsmedicine 12(7).

[5] NWS — WBGT calculator and flag categories. https://www.weather.gov

[6] ECMWF Forecast User Guide — New parameters: heat and cold indices (IFS Cycle 49r1). https://confluence.ecmwf.int/spaces/FCST/pages/462912535

[7] Błażejczyk K. et al. (2013). An introduction to the Universal Thermal Climate Index (UTCI). Geographia Polonica 86(1):5–10.

[8] Rothfusz L. (1990). The heat index equation. NWS Technical Attachment SR 90-23.

[9] Matzarakis A., Mayer H. (1996). Another kind of environmental stress: thermal stress. WHO Newsletter 18:7–10.

[10] BIE — General Assembly grants registration to World Expo 2030 Riyadh (1 Oct 2030 – 31 Mar 2031). https://www.bie-paris.org

[11] Open-Meteo — Free weather API, ERA5 historical data from 1940. https://open-meteo.com

[12] climate-zone.com — Riyadh monthly climate averages. https://www.climate-zone.com/climate/saudi-arabia/celsius/riyadh.htm

[13] مصادر الفريق الداخلية: ملف مقاييس الإجهاد الحراري (WBGT وفق ISO 7243 وجدول الأعلام وأدوات التلطيف)، وsensor_node.ino الإصدار 0.3.0، وصفحة تشغيل الموقع التجريبي في نوشن، والنموذج الأولي HABOOB_Smart_Outdoor_Operations_v2.

# الملحق أ: الكود المرجعي لحساب WBGT

نموذج أولي غير مختبر مع العقدة. جُرّب في بيئة Python مع thermofeel 2.3.0: رسالة ظهر أكتوبر في الشمس أعطت 29.1 بعلم أخضر، ورسالة القاعة 19.2 بعلم أبيض، ورسالة بلا مقياس رياح انتقلت للطريقة المبسطة بالعلامة fallback_simple.

import math

import datetime as dt

import numpy as np

import thermofeel as tf

CFG = {"k": 20.0, "b": 0.5, "v_min": 0.02, "z0": 0.01, "lux_per_wm2": 110.0,

"sun_wm2": 250.0, "fdir_sun": 0.8, "p_hpa": 945.0, "lat": 24.71, "lon": 46.68, "tz": 3}

FLAGS = [(26.6, "white"), (29.3, "green"), (31.0, "yellow"), (32.1, "red")] # upper bound inclusive

def wbgt_flag(w):

for upper, key in FLAGS:

if w <= upper:

return key

return "black"

def wind_10m(v_h, h, z0=CFG["z0"]):

return v_h * math.log(10 / z0) / math.log(h / z0)

def cos_zenith(t_local, lat=CFG["lat"], lon=CFG["lon"], tz=CFG["tz"]):

"""NOAA solar position approximation. t_local: datetime in local time."""

n = t_local.timetuple().tm_yday

hour = t_local.hour + t_local.minute / 60

g = 2 * math.pi / 365 * (n - 1 + (hour - 12) / 24)

decl = (0.006918 - 0.399912 * math.cos(g) + 0.070257 * math.sin(g)

- 0.006758 * math.cos(2 * g) + 0.000907 * math.sin(2 * g)

- 0.002697 * math.cos(3 * g) + 0.00148 * math.sin(3 * g))

eqt = 229.18 * (0.000075 + 0.001868 * math.cos(g) - 0.032077 * math.sin(g)

- 0.014615 * math.cos(2 * g) - 0.040849 * math.sin(2 * g))

tst = hour * 60 + eqt + 4 * lon - 60 * tz

ha = math.radians(tst / 4 - 180)

la = math.radians(lat)

return max(0.0, math.sin(la) * math.sin(decl) + math.cos(la) * math.cos(decl) * math.cos(ha))

def wbgt_liljegren(ta, rh, v10, ghi, fdir, cz, p=CFG["p_hpa"]):

a = lambda x: np.array([x], dtype=float)

r = tf.calculate_wbgt_liljegren(a(ta + 273.15), a(rh), a(p), a(v10), a(ghi), a(fdir), a(cz))

return float(r[0]) - 273.15

def wbgt_simple(ta, rh):

e = rh / 100 * 6.112 * math.exp(17.62 * ta / (243.12 + ta))

return 0.567 * ta + 0.393 * e + 3.94

def compute(msg, t_local, cfg=CFG):

s, flags = msg["sensors"], []

d = s.get("dht22", {})

if d.get("status") != "ok" or d.get("ta_c") is None or d.get("rh_pct") is None:

return {"wbgt_c": None, "reason": "missing_ta_rh"}

ta, rh = float(d["ta_c"]), float(d["rh_pct"])

an, li = s.get("anemometer", {}), s.get("veml7700", {})

if an.get("status") != "ok" or an.get("wind_v") is None or li.get("status") != "ok" or li.get("lux") is None:

w = wbgt_simple(ta, rh) # fallback: no wind or no light reading

return {"wbgt_c": round(w, 1), "flag": wbgt_flag(w), "wbgt_method": "simple", "flags": ["fallback_simple"]}

V = float(an["wind_v"])

v_h = 0.0 if V < cfg["v_min"] else cfg["k"] * V + cfg["b"]

v10 = wind_10m(v_h, float(an.get("height_m") or 1.8))

ghi = float(li["lux"]) / cfg["lux_per_wm2"]

sun = ghi > cfg["sun_wm2"]

cz = cos_zenith(t_local)

w = wbgt_liljegren(ta, rh, v10, ghi, cfg["fdir_sun"] if sun else 0.0, cz)

if math.isnan(w):

return {"wbgt_c": None, "reason": "no_convergence"}

return {"wbgt_c": round(w, 1), "flag": wbgt_flag(w), "wbgt_method": "liljegren",

"v10_ms": round(v10, 2), "ghi_wm2": round(ghi), "sun_flag": int(sun),

"cossza": round(cz, 3), "flags": flags}

## الملحق ب: دالة التفسير بالمحاكاة العكسية

def explain(ta, rh, v10, ghi, fdir, cz, v10_ref=3.0):

"""Contribution = WBGT(actual) - WBGT(with that factor at its reference value)."""

base = wbgt_liljegren(ta, rh, v10, ghi, fdir, cz)

return {

"radiation": round(base - wbgt_liljegren(ta, rh, v10, 0.0, 0.0, cz), 1),

"low_wind": round(base - wbgt_liljegren(ta, rh, max(v10_ref, v10), ghi, fdir, cz), 1),

"humidity": round(base - wbgt_liljegren(ta, 50.0, v10, ghi, fdir, cz), 1),

"wbgt": round(base, 1),

}

# explain(35, 20, 1.33, 800, 0.8, 0.836)

# -> {'radiation': 6.1, 'low_wind': 1.8, 'humidity': -4.9, 'wbgt': 29.1}

قراءة المثال: من أصل WBGT 29.1، يساهم الإشعاع بـ 6.1 درجة وضعف الرياح بـ 1.8، والهواء الجاف يخفض المؤشر 4.9 درجات مقارنة برطوبة 50%. لذلك التوصية الأولى هي التظليل.

هبوب · الدليل المرجعي لمسار علم البيانات والذكاء الاصطناعي · الإصدار 2.0
