SARAHXL1/Expo2023-HABOOB/hardware/3d-models/Anemometer DC motor - 3648443/images/4cdf1b852a035a181bdcbd6dd520e0d5.png

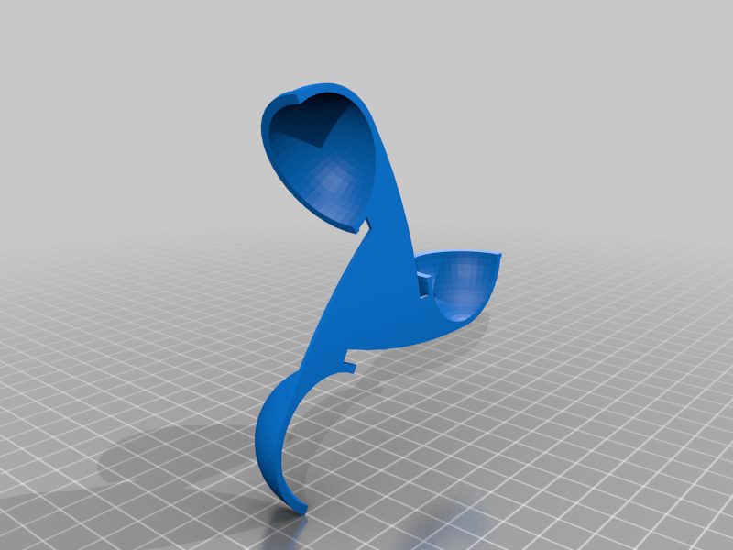
hardware/3d-models/Anemometer DC motor - 3648443/images/4cdf1b852a035a181bdcbd6dd520e0d5.png
