SARAHXL1/Expo2023-HABOOB/hardware/3d-models/Anemometer DC motor - 3648443/images/9e7e7479611f4a0699cbe084387714f6.png

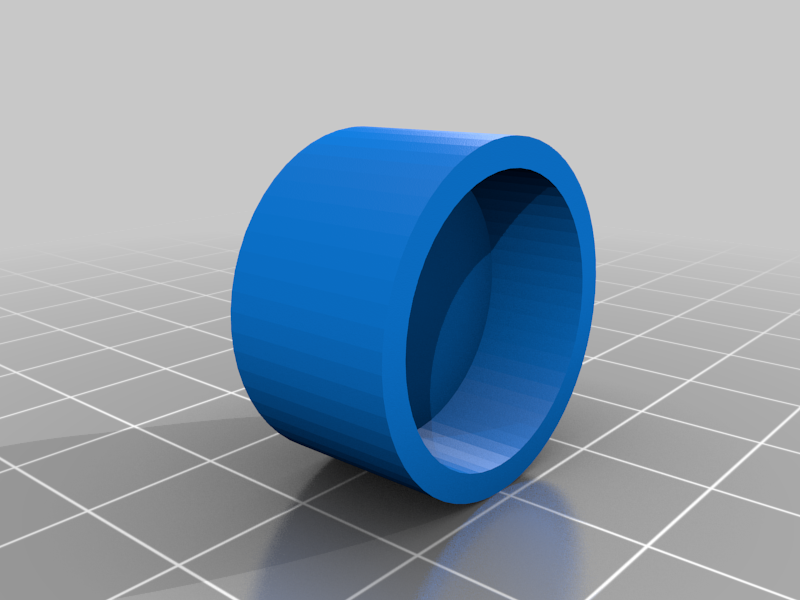
hardware/3d-models/Anemometer DC motor - 3648443/images/9e7e7479611f4a0699cbe084387714f6.png
