SARAHXL1/Expo2023-HABOOB/hardware/3d-models/Anemometer DC motor - 3648443/images/ea35e3248423d630fb57c955e7d1f504.png

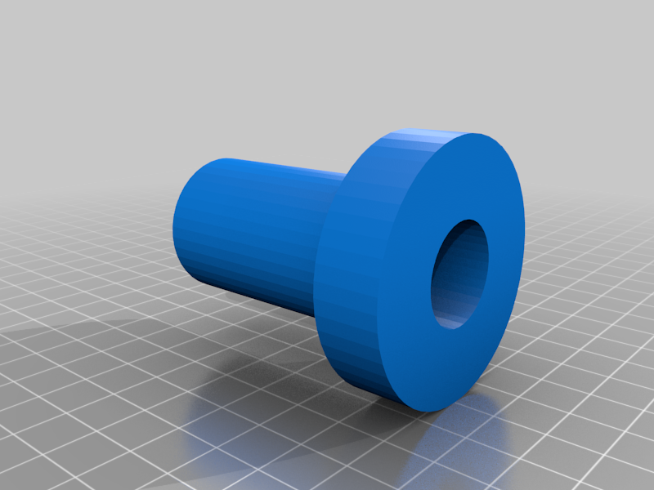
hardware/3d-models/Anemometer DC motor - 3648443/images/ea35e3248423d630fb57c955e7d1f504.png
