SARAHXL1/Expo2023-HABOOB/hardware/3d-models/هبوب - شبك التهوية وتعديل حساس الرياح/صور للمراجعة/شبك التهوية - الوجه والمقطع.png

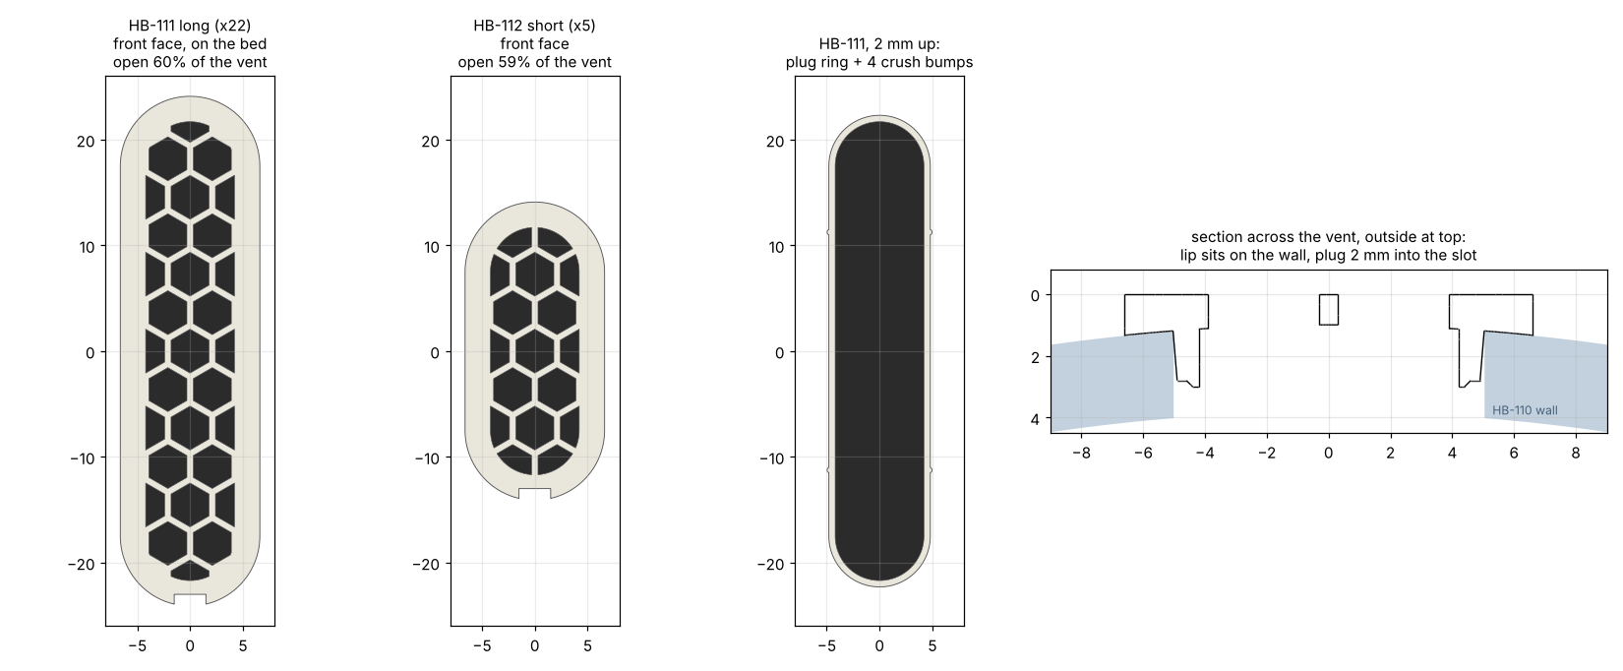
hardware/3d-models/هبوب - شبك التهوية وتعديل حساس الرياح/صور للمراجعة/شبك التهوية - الوجه والمقطع.png
