SARAHXL1/Expo2023-HABOOB/hardware/3d-models/هبوب - ملفات الطباعة B.4/صور للمراجعة/HB-140 النقش مفرودا.png

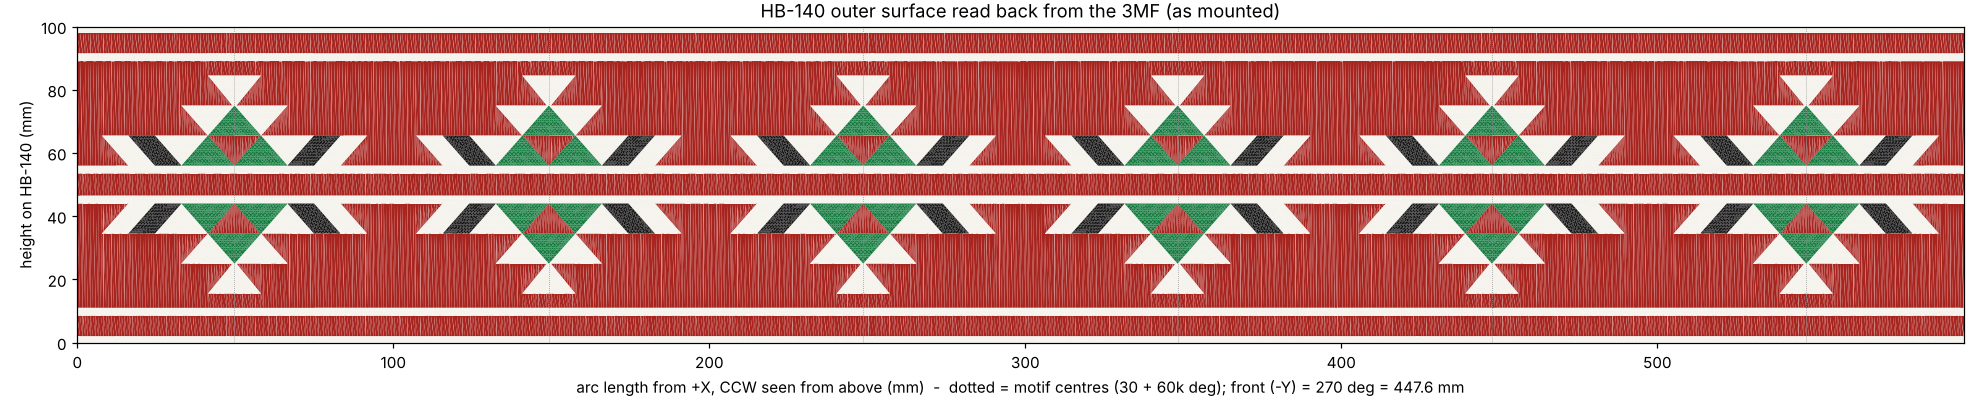
hardware/3d-models/هبوب - ملفات الطباعة B.4/صور للمراجعة/HB-140 النقش مفرودا.png
