SARAHXL1/Expo2023-HABOOB/media/prototype-images/النموذج الاول من العمود.png

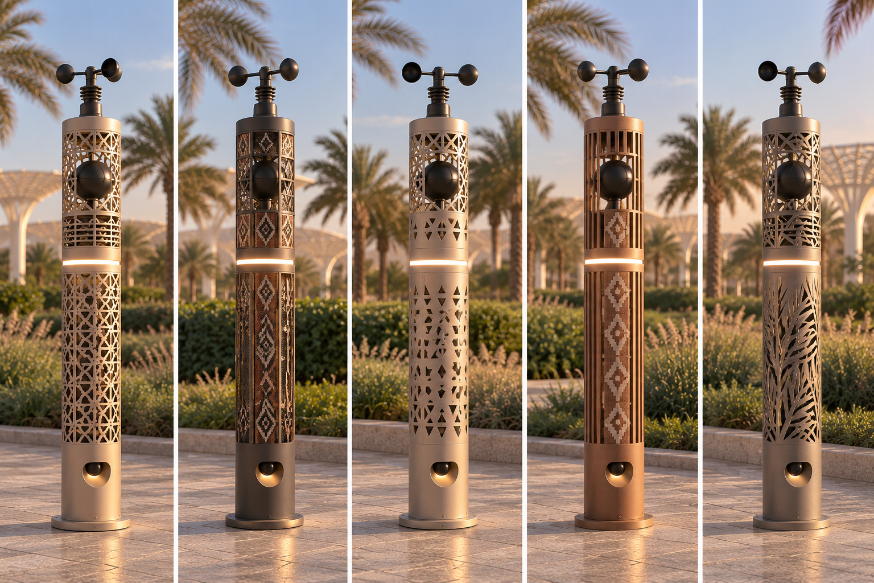
media/prototype-images/النموذج الاول من العمود.png
