SARAHXL1/Expo2023-HABOOB/media/prototype-images/النموذج الثاني من العمود.png

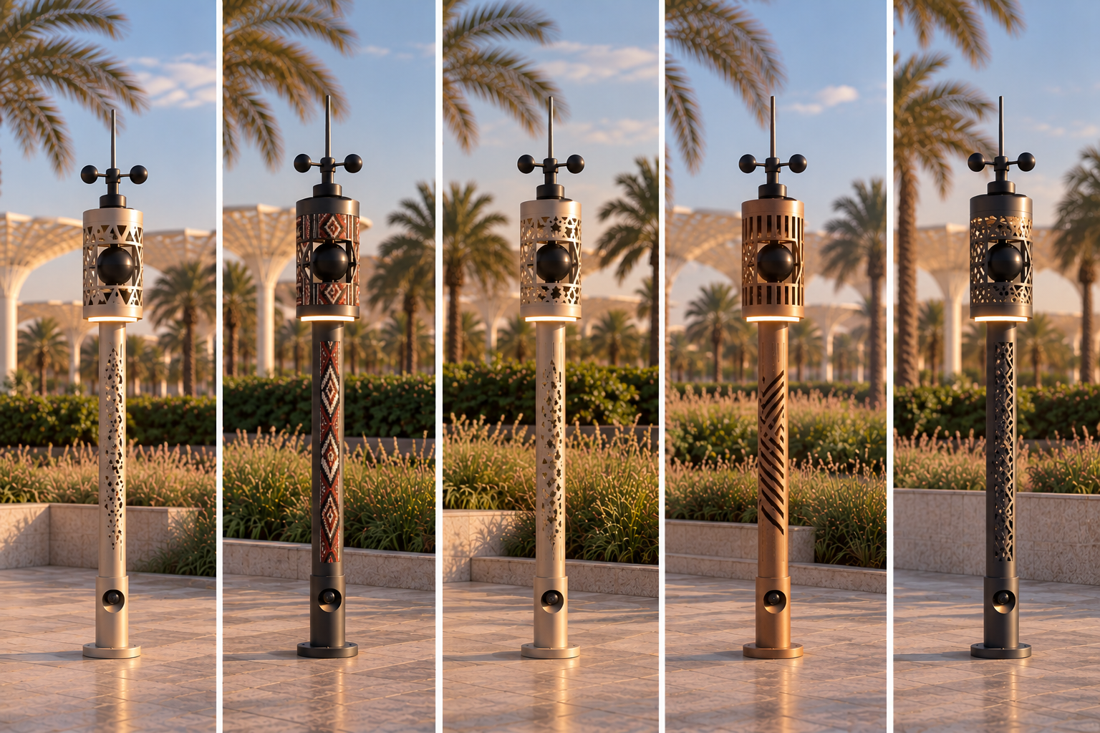
media/prototype-images/النموذج الثاني من العمود.png
