SARAHXL1/Expo2023-HABOOB/media/prototype-images/الهياكل ساده بدون نقوش.png

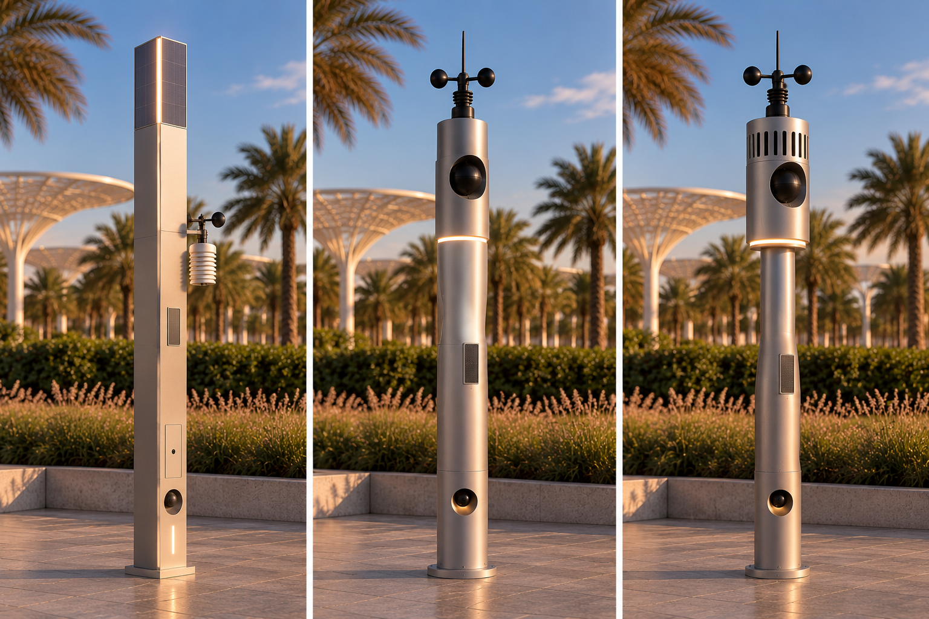
media/prototype-images/الهياكل ساده بدون نقوش.png
