SARAHXL1/Expo2023-HABOOB/hardware/parts-guides/الوصف الهندسي لوحدة الاستشعار الميدانية العمود.docx

الوصف الهندسي لوحدة الاستشعار الميدانية (العمود)

مشروع هاكثون إكسبو 2030 الرياض · تحدي 2.3

نوع المستند | وصف هندسي للعتاد ومتطلباته (Hardware Description & Requirements)
المشروع | منظومة الراحة الحرارية للمناطق الخارجية، تحدي 2.3، هاكثون إكسبو 2030 الرياض
القالب المستخدم | لا يوجد قالب رسمي لهذا المستند؛ الهيكل مقترح
الجمهور | فريق المشروع (الميكاترونكس، علم البيانات، الخادم، UX/UI) ولجنة التحكيم عند الحاجة
الإصدار والتاريخ | 0.1 · 30 سبتمبر 2026
الحالة | مسودة (Draft)

يصف هذا المستند الجهاز المادي في المشروع، وهو وحدة الاستشعار الميدانية (العمود): ما هو، وما يقيسه بالضبط، ومتطلباته، والقطع اللازمة لنموذجه الأولي، ثم اقتراحات قطع متوافقة مع متحكم ESP32.

# 1. ما هو الجهاز المادي؟

الجهاز المادي هو عقدة استشعار (Sensor Node) على شكل عمود بهوية سعودية، يُثبَّت في المناطق الخارجية ليقيس الظروف التي تحدد إحساس الإنسان بالحرارة، ويرسلها لاسلكيًا إلى المنصة.

العمود ليس هو الابتكار بحد ذاته، بل وسيلة جمع البيانات التي تغذي الابتكار الأساسي: مؤشر قابلية الاستخدام، والتقدير بين الأعمدة، والتوقع، وحلقة تقييم الكفاءة.

موقعه في المنظومة:

1. العمود (هذا المستند): يقيس ويرسل.
2. الخادم (Backend): يستقبل القراءات وينقيها ويخزنها.
3. التحليل والذكاء الاصطناعي: يحسب المؤشر ويقدّر ويتوقع ويوصي.
4. واجهة المشغلين: تعرض الحالة والتوصيات للمشغل صاحب القرار.

مكوناته الرئيسية باختصار:

- متحكم ESP32: يقرأ الحساسات ويرسل البيانات عبر الواي فاي.
- حزمة حساسات: حرارة الهواء والرطوبة، ومقياس حرارة كروي، ومقياس رياح، وحساس حرارة الأسطح، وحساس إضاءة اختياري.
- هيكل معياري: ماسورة مركزية جاهزة تُركّب عليها وحدات مطبوعة ثلاثيًا، وغلاف زخرفي مثقّب يعمل كواقٍ إشعاعي.
- منظومة طاقة: في القاعدة، ولم تُحسم بعد (انظر القسم 4.3).

# 2. وظيفة الجهاز وما يقيسه بالضبط

وظيفة العمود أن يوفّر المدخلات الأربعة لمؤشر الراحة الحرارية UTCI في نقطته، ومعها قراءتان مساندتان، كل دقيقة تقريبًا، بقيم موثوقة وقابلة للمقارنة بين الأعمدة.

## 2.1 ما يقيسه

الكمية المقاسة | الرمز | لماذا نحتاجها | طريقة القياس | الأولوية
حرارة الهواء | Ta | مدخل أساسي في UTCI | حساس رقمي داخل واقٍ إشعاعي مهوّى | أساسي
الرطوبة النسبية | RH | مدخل أساسي في UTCI | نفس الحساس السابق | أساسي
سرعة الرياح | va | مدخل أساسي في UTCI، ويدخل في حساب MRT | مقياس رياح كأسي | أساسي
حرارة الكرة | Tg | لحساب متوسط الحرارة الإشعاعية (MRT)، وهو أثر الشمس والأسطح | حساس حرارة في مركز كرة مطلية بلون مطفي | أساسي
حرارة سطح الأرضية | Ts | تقوية التقدير المكاني: البلاط المشمس يختلف عن العشب | حساس أشعة تحت حمراء موجّه للأسفل | موصى به
شدة الإضاءة | E | تمييز الظل من الشمس، ودعم نموذج التقدير | حساس ضوء تحت قبة مشتِّتة | اختياري

## 2.2 ما يفعله بالقراءات

1. يقرأ كل الحساسات بدورة ثابتة (مقترح: كل 10 ثوانٍ للرياح، وكل 60 ثانية للباقي).
2. يعالج أوليًا: يحسب متوسط سرعة الرياح خلال الدورة، ويرفض القراءات الخارجة عن المدى المعقول.
3. يغلّف القراءات برسالة واحدة فيها معرّف العمود والوقت وحالة كل حساس.
4. يرسل الرسالة للخادم عبر الواي فاي.
5. يحفظ نسخة محليًا (اختياري، على بطاقة microSD) عند انقطاع الشبكة، ثم يرسلها لاحقًا.

ما لا يفعله العمود: لا يحسب مؤشر UTCI ولا يتخذ قرارات. الحساب يتم في الخادم، لأن تعديل المعادلة أو معاملات التصحيح هناك أسهل من إعادة برمجة كل الأعمدة.

## 2.3 شروط القياس الصحيح

- الارتفاع: حساسات الراحة (Ta وRH وTg) على ارتفاع 1.1 إلى 1.5 م، وهو ارتفاع جسم الإنسان.
- الواقي الإشعاعي إلزامي: بدونه يقرأ حساس الهواء حرارة أعلى من الحقيقة بعدة درجات تحت الشمس.
- العزل عن حرارة المتحكم: الواي فاي يسخّن لوحة ESP32، فتُفصل حجرة الإلكترونيات عن الواقي.
- مجال رؤية مفتوح: الكرة الحرارية ومقياس الرياح بعيدان عن ظل العمود وعن عوائق الهواء.

# 3. البنية المعمارية للجهاز

العمود هيكل معياري: ماسورة مركزية جاهزة (PVC أو ألمنيوم بقطر 32 إلى 40 ملم) تحمل الوزن وتمر الأسلاك داخلها، وتنزلق عليها ست وحدات مطبوعة ثلاثيًا تُثبّت ببراغي. هذا يتجاوز حدود حجم الطابعة، ويسمح بفك أي وحدة منفردة عند العطل.

الحساسات عند ارتفاع الإنسان، والطاقة وحدها تنزل للقاعدة — وحدات العمود من الأعلى إلى الأسفل:

الارتفاع | الوحدة | المحتوى
أعلى العمود | القبعة العلوية | مقياس الرياح، وحساس الإضاءة تحت قبة مشتِّتة
1.1 إلى 1.5 م | الواقي الإشعاعي | SHT45: حرارة الهواء والرطوبة
1.1 إلى 1.5 م | ذراع الكرة الحرارية | DS18B20 في مركز كرة مطفية
تحت الواقي مباشرة | حجرة الإلكترونيات | ESP32 واللوحة الملحومة، مفصولة حراريًا عن الواقي، وترسل عبر Wi-Fi إلى الخادم (حساب UTCI والتقدير)
قرابة 1 م | حامل حساس الأرضية | MLX90614 مائل للأسفل 30 إلى 45 درجة
الأرض | القاعدة | مصدر الطاقة، ومخرج الكابلات، وأثقال الثبات

الصف المظلل هو حجرة الإلكترونيات، مركز العقدة.

حجرة الإلكترونيات قريبة من الحساسات لأن ناقل I2C لا يتحمل الأسلاك الطويلة، ولا ينزل للقاعدة إلا سلك الطاقة. الغلاف الزخرفي (المشربية) يُركّب فوق هذه الوحدات، ويؤدي وظيفة الواقي الإشعاعي عند مستوى الحساسات.

# 4. المتطلبات والمواصفات

القيم المستهدفة أدناه مقترحة للنموذج الأولي، وتُعتمد أو تُعدّل بعد اختبار الطاولة الأول.

## 4.1 متطلبات القياس

المعرّف | المتطلب | القيمة المستهدفة | طريقة التحقق
HW-M01 | يقيس النظام حرارة الهواء داخل واقٍ إشعاعي | مدى 0 إلى 60 °م، دقة ±0.3 °م أو أفضل | مقارنة بمرجع معايَر في الظل
HW-M02 | يقيس النظام الرطوبة النسبية | مدى 0 إلى 100%، دقة ±2% أو أفضل | مقارنة بمرجع
HW-M03 | يقيس النظام حرارة الكرة الحرارية | مدى 0 إلى 85 °م، دقة ±0.5 °م | مقارنة الحساس بمرجع قبل تركيبه في الكرة
HW-M04 | يقيس النظام سرعة الرياح | مدى 0.5 إلى 30 م/ث | مقارنة بمقياس رياح يدوي أو بمروحة ثابتة السرعة
HW-M05 | يقيس النظام حرارة سطح الأرضية | مدى 0 إلى 80 °م، دقة ±1 °م تقريبًا | مقارنة بمقياس حرارة يدوي بالأشعة تحت الحمراء
HW-M06 | يقيس النظام شدة الإضاءة دون تشبع تحت الشمس المباشرة | حتى 120,000 لوكس على الأقل، أو مع مشتِّت | اختبار ظهرًا في شمس مباشرة
HW-M07 | تتطابق قراءات الأعمدة فيما بينها | فرق ≤ 0.5 °م في Ta بعد المعايرة المتبادلة | تشغيل الأعمدة جنبًا إلى جنب عدة ساعات

## 4.2 متطلبات المعالجة والاتصال

المعرّف | المتطلب | القيمة المستهدفة | طريقة التحقق
HW-C01 | يرسل العمود قراءة كاملة دوريًا | كل 60 ثانية | سجل الخادم
HW-C02 | يتصل العمود بالخادم لاسلكيًا | Wi-Fi 2.4 GHz، ببروتوكول MQTT أو HTTP (يُحسم مع فريق الخادم) | اختبار الإرسال
HW-C03 | يُعلّم العمود كل قراءة بمعرّفه ووقتها | ختم زمني من NTP | فحص الرسائل
HW-C04 | يُبلغ العمود عن حساس متعطل بدل إرسال قيمة خاطئة | علامة حالة لكل حساس | فصل حساس أثناء التشغيل
HW-C05 | يعود العمود للعمل تلقائيًا بعد انقطاع الشبكة أو الطاقة | إعادة اتصال دون تدخل | فصل الراوتر ثم إعادته

## 4.3 المتطلبات الكهربائية والطاقة

المعرّف | المتطلب | القيمة المستهدفة | طريقة التحقق
HW-E01 | تعمل كل الحساسات على منطق 3.3V المتوافق مع ESP32 | لا يدخل أي منفذ جهد أعلى من 3.3V | قياس بالملتيميتر
HW-E02 | يتحمل مصدر الطاقة ذروة استهلاك الواي فاي | 5V بتيار 1A على الأقل للعقدة (الاستهلاك الفعلي يُقاس) | قياس التيار أثناء الإرسال
HW-E03 | يعمل العمود طوال يوم العرض دون انقطاع | 10 ساعات على الأقل في نسخة البطارية | اختبار تشغيل كامل
HW-E04 | يحمي النظام من عكس القطبية والقصر | فيوز أو حماية على المدخل | فحص التصميم

الطاقة لم تُحسم بعد. الخيار الأبسط للعرض محول 5V أو باور بانك. أما إن اخترتم مقياس رياح يحتاج 7 إلى 24V، فالأنسب مصدر 12V مع محول خافض (Buck) إلى 5V.

## 4.4 المتطلبات الميكانيكية والبيئية

المعرّف | المتطلب | القيمة المستهدفة | طريقة التحقق
HW-P01 | ترتفع حساسات الراحة إلى ارتفاع الإنسان | 1.1 إلى 1.5 م | قياس بالمتر
HW-P02 | يتكون الهيكل من وحدات تُفك وتُركّب منفصلة | كل وحدة تُفك دون قص أسلاك | تجربة فك وحدة
HW-P03 | تتحمل القطع المطبوعة حرارة الشمس | PETG كحد أدنى، ويُفضّل ASA | ترك قطعة تحت الشمس يومًا كاملًا
HW-P04 | يكون الواقي الإشعاعي أبيض ومهوّى | أبيض، بفتحات تهوية من كل الجهات | فحص بصري ومقارنة بقراءة مرجعية
HW-P05 | يقاوم الهيكل الغبار ورذاذ الماء | حجرة الإلكترونيات مغلقة مع مخارج كابلات محكمة (IP54 كهدف) | رش ماء خفيف
HW-P06 | يثبت العمود دون أن ينقلب | قاعدة مثقلة | دفع جانبي خفيف

# 5. قائمة القطع للنموذج الأولي

القائمة لعمود واحد. الكميات تتضاعف لكل عمود إضافي، والتوصية عمودان على الأقل لإظهار فرق الظل عن الشمس.

## 5.1 الإلكترونيات

# | القطعة | الكمية | الوظيفة

1 | لوحة تطوير ESP32 | 1 (+1 احتياط) | المعالجة والاتصال
2 | حساس حرارة ورطوبة رقمي | 1 | Ta وRH
3 | حساس حرارة مقاوم للماء (1-Wire) | 1 | داخل الكرة الحرارية لقياس Tg
4 | كرة مجوفة مطلية بلون مطفي | 1 | جسم الكرة الحرارية
5 | مقياس رياح كأسي | 1 | va
6 | حساس حرارة بالأشعة تحت الحمراء | 1 | Ts
7 | حساس إضاءة | 1 | E (اختياري)
8 | محول تناظري إلى رقمي خارجي (ADC) | 1 | فقط إن كان مقياس الرياح تناظريًا
9 | وحدة بطاقة microSD | 1 | تسجيل احتياطي (اختياري)
10 | شاشة OLED صغيرة | 1 | عرض القراءات على العمود أثناء العرض (اختياري)

## 5.2 الطاقة

# | القطعة | الكمية | الوظيفة

11 | مصدر طاقة (محول أو بطارية) | 1 | تغذية العقدة، يُحسم لاحقًا
12 | محول جهد خافض (Buck) | 1 | فقط إن كان المصدر 12V
13 | فيوز مع حامله، ومفتاح تشغيل | 1 لكل منهما | الحماية والتحكم
14 | مكثف إلكتروليتي 470 إلى 1000µF | 1 | تثبيت الجهد عند ذروة الواي فاي

## 5.3 التوصيل واللحام

# | القطعة | الكمية | الوظيفة

15 | لوحة مثقبة (Perfboard) | 2 | لوحة التوصيل الرئيسية
16 | مقابس نسائية (Female Headers) | 2 شريط | تركيب ESP32 دون لحام مباشر
17 | موصلات JST-XH أو براغي طرفية | 10 تقريبًا | فك أي حساس دون قص الأسلاك
18 | مقاومة 4.7kΩ | 5 | سحب خط 1-Wire، واحتياط لخط I2C
19 | مقاومات لمقسّم الجهد | حسب الحاجة | خفض خرج مقياس الرياح إن تجاوز 3.3V
20 | أسلاك مجدولة أو كابل متعدد الأسلاك | 5 م تقريبًا | تمديد الحساسات داخل الماسورة
21 | أنابيب انكماش حراري ورابطات | علبة | العزل والتنظيم
22 | أدوات اللحام: كاوية، قصدير، فلكس، ملتيميتر | 1 | التجميع والفحص

## 5.4 الهيكل والتثبيت

# | القطعة | الكمية | الوظيفة

23 | ماسورة PVC أو ألمنيوم بقطر 32 إلى 40 ملم | 1.5 م | العمود الحامل وممر الأسلاك
24 | خيوط طباعة PETG أو ASA (بيضاء للواقي) | 1 إلى 2 كجم | الوحدات المطبوعة
25 | براغي M3 مع حشوات نحاسية حرارية | علبة | تثبيت الوحدات
26 | أثقال للقاعدة (رمل أو صفائح حديد) | حسب الحاجة | الثبات
27 | جلب كابلات (Cable Glands) | 2 إلى 3 | إحكام مخارج الأسلاك

## 5.5 عدة العرض أمام اللجنة (خارج العمود)

# | القطعة | الوظيفة

28 | مروحة صغيرة | محاكاة الرياح وإثبات تغير المؤشر
29 | جهاز رذاذ بالموجات فوق الصوتية | محاكاة الرشاشات وقياس أثرها
30 | مصباح حراري | محاكاة الشمس ورفع حرارة الكرة

# 6. اقتراحات القطع المتوافقة مع ESP32

كل اقتراح أدناه يعمل على منطق 3.3V، ويتصل بـ ESP32 مباشرة أو عبر وسيط واحد مذكور. المواصفات من المعرفة العامة بهذه القطع، وتُراجع في ورقة بيانات اللوحة المشتراة فعلًا لأن لوحات الموردين تختلف.

## 6.1 الاقتراح الأساسي والبدائل

الوظيفة | الاقتراح الأول | البديل | الربط مع ESP32 | ملاحظات
المتحكم | ESP32-DevKitC (شريحة ESP32-WROOM-32E) | ESP32-S3-DevKitC | — | منطق 3.3V. منافذ ADC2 لا تعمل مع الواي فاي، فالقراءات التناظرية على ADC1 أو ADS1115
حرارة الهواء والرطوبة | SHT45 (دقة نموذجية ±0.1 °م) | SHT40 (±0.2 °م) أو SHT31 (±0.3 °م) | I2C، عنوان 0x44 | تجنّب DHT22 لضعف دقته وثباته. اختر لوحة عليها غطاء PTFE يحمي الحساس من الغبار
حرارة الكرة | DS18B20 بغلاف معدني مقاوم للماء | PT100 مع محول MAX31865 (دقة أعلى، عبر SPI) | 1-Wire على أي منفذ رقمي، مع مقاومة سحب 4.7kΩ | دقته ±0.5 °م. يُثبّت طرفه في مركز الكرة تمامًا
جسم الكرة | كرة نحاسية مجوفة 150 ملم مطلية بالأسود المطفي (المقاس القياسي) | كرة تنس طاولة 38 إلى 40 ملم مطلية بالرمادي المطفي | — | الكرة الصغيرة أسرع استجابة وأرخص، لكنها تحتاج معامل تصحيح لقطرها في معادلة MRT
سرعة الرياح | مقياس رياح نبضي بمفتاح مغناطيسي (Reed)، مثل مقياس حزم محطات الطقس الهاوية | مقياس تناظري بخرج 0.4 إلى 2V (يحتاج تغذية 7 إلى 24V)، أو صناعي RS485 | النبضي: منفذ مقاطعة (Interrupt) مع مقاومة سحب إلى 3.3V، بلا تحويل | النبضي أبسط خيار: لا يحتاج جهدًا عاليًا ولا ADC. معامل التحويل من النبضات إلى السرعة يؤخذ من ورقة بياناته
حرارة سطح الأرضية | MLX90614 نسخة 3V | MLX90640 (مصفوفة حرارية 32×24، ترقية لاحقة) | I2C، عنوان 0x5A | اطلب نسخة 3V تحديدًا. اختر زاوية رؤية تغطي الأرض المطلوبة دون ظل العمود. يعمل على I2C بسرعة 100 kHz فقط
شدة الإضاءة | VEML7700 (يصل تقريبًا إلى 120,000 لوكس) | BH1750 (حدّه 65,535 لوكس، فيتشبع في الشمس المباشرة دون مشتِّت) | I2C، عنوان 0x10 | الترقية المستقبلية الأدق: مقياس إشعاع شمسي (Pyranometer) يقيس W/m²
التحويل التناظري | ADS1115 (16 بت، 4 قنوات) | منافذ ADC1 الداخلية | I2C، عنوان 0x48 | يُحتاج فقط مع مقياس رياح تناظري
التسجيل الاحتياطي | وحدة microSD تعمل على 3.3V | ذاكرة الفلاش الداخلية في ESP32 | SPI | تحقق أن الوحدة لا تفترض تغذية 5V
عرض محلي | شاشة OLED SSD1306 مقاس 0.96 بوصة | — | I2C، عنوان 0x3C | مفيدة جدًا في العرض: اللجنة ترى القراءة على العمود نفسه
الطاقة (عرض داخلي) | محول 5V بتيار 2A بمخرج USB | باور بانك لا ينطفئ تلقائيًا عند الاستهلاك المنخفض | منفذ USB أو طرف 5V في اللوحة | الأبسط والأضمن ليوم العرض
الطاقة (خارجي أو مقياس 12V) | بطارية 12V مع محول خافض إلى 5V (مثل وحدات LM2596 أو MP1584) | ألواح شمسية مع منظم شحن (عمل مستقبلي) | طرف 5V في اللوحة | اضبط خرج المحول بالملتيميتر قبل توصيل ESP32

## 6.2 عناوين ناقل I2C

كل أجهزة I2C المقترحة تتشارك سلكين فقط، وعناوينها الافتراضية لا تتعارض:

الجهاز | العنوان الافتراضي
VEML7700 | 0x10
SSD1306 | 0x3C
SHT45 / SHT40 | 0x44
ADS1115 | 0x48
MLX90614 | 0x5A

أول اختبار بعد التجميع: برنامج مسح I2C (I2C Scanner) يُظهر هذه العناوين كلها. أي عنوان مفقود يعني مشكلة توصيل في ذلك الحساس.

# 7. خطة التوصيل المقترحة

العقدة كلها تحتاج ثلاثة ناقلات فقط: ناقل I2C مشترك، وخط 1-Wire، ومنفذ مقاطعة لمقياس الرياح، إضافة إلى SPI إن أُضيفت بطاقة microSD. المنافذ أدناه مقترحة للوحة ESP32-DevKitC، وتُثبّت بعد شراء اللوحة ومراجعة مخططها.

الناقل | المنفذ المقترح (GPIO) | الأجهزة | ملاحظات
I2C | SDA = 21، SCL = 22 | SHT45، MLX90614، VEML7700، ADS1115، SSD1306 | سرعة 100 kHz بسبب MLX90614. أسلاك مجدولة، وأقصر طول ممكن
1-Wire | 4 | DS18B20 | مقاومة 4.7kΩ بين خط البيانات و3.3V
مقاطعة | 27 | مقياس الرياح النبضي | مقاومة سحب خارجية 10kΩ إلى 3.3V، مع مكثف صغير لتنعيم ارتداد المفتاح
SPI | SCK = 18، MISO = 19، MOSI = 23، CS = 5 | وحدة microSD | اختياري
الطاقة | 5V وGND | اللوحة وكل الحساسات عبر منظم 3.3V في اللوحة | مكثف 470 إلى 1000µF قرب مدخل 5V

منافذ يجب تجنبها في ESP32:

- GPIO 6 إلى 11: مخصصة لذاكرة الفلاش.
- GPIO 0 و2 و12 و15: منافذ إقلاع (Strapping)، وقد تمنع الإقلاع إذا شُدّت لجهد خاطئ.
- GPIO 34 إلى 39: إدخال فقط وبلا مقاومات سحب داخلية.
- منافذ ADC2: لا تعمل للقراءة التناظرية أثناء تشغيل الواي فاي.

ترتيب التجميع المقترح:

1. اختبار كل حساس منفردًا على لوحة تجارب (Breadboard) قبل أي لحام.
2. مسح ناقل I2C مع كل الحساسات موصولة معًا.
3. لحام اللوحة المثقبة بموصلات قابلة للفك.
4. تشغيل العقدة على الطاولة 24 ساعة مع الإرسال للخادم.
5. التركيب في الهيكل المطبوع، ثم المعايرة المتبادلة بين الأعمدة.

# 8. الأسئلة المفتوحة والمخاطر والخطوة التالية

## الأسئلة المفتوحة

☐ حجم النموذج: عمود بالارتفاع الحقيقي يقيس فعلًا، أم نموذج مصغّر للعرض، أم الاثنان؟

☐ الطابعة المتوفرة: مقاس سطح الطباعة، وهل تطبع PETG أو ASA؟

☐ الحساسات الموجودة لديكم فعلًا: لمطابقتها مع القائمة قبل الشراء.

☐ مصدر الطاقة: محول 5V للعرض الداخلي، أم بطارية 12V للقياس الخارجي؟

☐ نوع مقياس الرياح: نبضي أم تناظري؟ وهذا يحدد جهد التغذية.

☐ بروتوكول الإرسال: MQTT أم HTTP؟ يُحسم مع فريق الخادم.

☐ عدد الأعمدة: التوصية عمودان على الأقل.

## الافتراضات

- العمود عقدة قياس وإرسال فقط، والحساب في الخادم.
- الإرسال عبر واي فاي متوفر في موقع العرض.
- القيم المستهدفة في القسم 4 مقترحة، وتُعدّل بعد اختبار الطاولة.

## المخاطر

الخطر | الأثر | التخفيف
غياب الواقي الإشعاعي أو ضعف تهويته | قراءة حرارة أعلى من الحقيقة، وفقدان مصداقية البيانات | واقٍ أبيض مهوّى، ومقارنته بمرجع في الظل
حرارة ESP32 تصل للحساسات | انحياز في قراءة Ta | فصل حجرة الإلكترونيات عن الواقي بفراغ هوائي
تشوه القطع المطبوعة تحت الشمس | ميلان الحساسات أو سقوطها | PETG أو ASA بدل PLA
تشبع حساس الإضاءة | قراءة ثابتة لا تميز الظل من الشمس | VEML7700 أو مشتِّت أمام الحساس
دخول جهد 5V لمنفذ ESP32 | تلف المتحكم | مقسّم جهد، وفحص كل خرج بالملتيميتر قبل التوصيل
ضعف الواي فاي في موقع العرض | فقدان القراءات أثناء العرض | تسجيل احتياطي على microSD، وراوتر جوال خاص بالفريق
كرة صغيرة دون معامل تصحيح | خطأ في حساب MRT ثم في المؤشر | تطبيق معامل تصحيح القطر في الخادم

## الخطوة التالية

الإجابة عن الأسئلة الثلاثة الأولى (الحجم، والطابعة، والحساسات الموجودة). بعدها نحسم الطاقة، ونحوّل القائمة إلى قائمة شراء نهائية بالموديلات والكميات.

الوصف الهندسي لوحدة الاستشعار الميدانية · مسودة 0.1
