SARAHXL1/Expo2023-HABOOB/hardware/parts-guides/جرد قطع هبوب.docx

جرد قطع النموذج الأولي — مشروع هبوب

مشروع هاكثون إكسبو 2030 الرياض · تحدي 2.3

المشروع | هبوب — عقدة استشعار الراحة الحرارية (تحدي إكسبو 2030 الرياض 2.3)
نوع المستند | جرد القطع المستلمة ومطابقتها مع القائمة
المرجع | قائمة الطلب رقم 85، وصور القطع المستلمة
التاريخ | 4 أكتوبر 2026
الحالة | مسودة: القطع غير الظاهرة في الصور تحتاج تأكيدًا

# 1. ملخص سريع

الحالة | العدد | القطع
✅ موجودة ومطابقة | 7 | ESP32، DHT22، ADS1115، MLX90614، TP4056، TPS63020، المفتاح
🔄 مستبدلة بنوع آخر | 3 | حساس الضوء، الشاشة، البطارية
❌ غير ظاهرة في الصور | 6 | DS18B20، الموتور، MT3608، المكثف، المحول، قطع التوصيل

القطع المعلّمة ❌ لم تظهر في الصور فقط، وقد تكون موجودة. أهمها DS18B20 والموتور، فبدونهما لا يمكن قياس حرارة الكرة ولا سرعة الرياح، وهما من مدخلات UTCI.

# 2. تفاصيل كل قطعة

## 1. لوحة تطوير ESP32 — ✅ موجودة

ما هي: لوحة ESP32-WROOM-32 بمنفذ USB-C، عدد أطرافها 38 تقريبًا.

وظيفتها: عقل العقدة. تقرأ الحساسات، وتحسب القيم، وتعرضها على الشاشة، وترسلها للابتوب عبر الواي فاي.

ملاحظة: أرقام GPIO لا تتغير، لكن مكان كل طرف على اللوحة يختلف عن لوحة الـ 30 طرفًا. اتبع الكتابة المطبوعة بجانب كل طرف.

## 2. حساس الحرارة والرطوبة DHT22 — ✅ موجود

ما هو: حساس DHT22 مركّب على لوحة صغيرة بثلاثة أطراف، ومعه سلك جاهز.

وظيفته: يقيس حرارة الهواء (Ta) والرطوبة (RH)، وهما مدخلان أساسيان في UTCI.

ملاحظة: اللوحة الصغيرة فيها مقاومة سحب جاهزة، فلا تحتاج مقاومة إضافية.

## 3. حساس الحرارة DS18B20 — ❌ غير ظاهر

ما هو: مجس حرارة رقمي مقاوم للماء، بسلك.

وظيفته: يوضع داخل الكرة السوداء ويقيس حرارتها (Tg)، ومنها نحسب متوسط الحرارة الإشعاعية (MRT).

الأهمية: أساسي، فلا يوجد بديل له بين القطع المستلمة.

## 4. محول الإشارة ADS1115 — ✅ موجود

ما هو: محول تماثلي إلى رقمي بدقة 16 بت، أطرافه VDD وGND وSCL وSDA وADDR وALRT وA0 إلى A3.

وظيفته: يقرأ الجهد الصغير الذي يولّده موتور الرياح على A0، وجهد البطارية على A1.

## 5. محرك تيار مستمر DC 5V — ❌ غير ظاهر

ما هو: موتور صغير بفرش، مقاس 130.

وظيفته: مقياس الرياح. تديره الكؤوس فيولّد جهدًا يزيد مع سرعة الرياح.

الأهمية: أساسي، فلا يوجد بديل له بين القطع المستلمة.

## 6. ترمومتر الأشعة تحت الحمراء MLX90614 — ✅ موجود

ما هو: حساس حرارة لاتلامسي داخل علبة معدنية، أطرافه VIN وGND وSCL وSDA.

وظيفته: يقيس حرارة سطح الأرض عن بُعد. قطعة إضافية لا تدخل في حساب UTCI.

## 7. حساس الضوء BH1750 — 🔄 مستبدل بـ VEML7700

ما وصل: حساس ضوء VEML7700.

وظيفته: يقيس شدة الضوء بوحدة lux ليميّز هل العمود في الشمس أم في الظل. قطعة إضافية.

هل البديل مناسب؟ نعم. يؤدي نفس الوظيفة ويتصل بنفس طريقة I2C، ومداه أعلى.

ما يتغير:

- عنوانه 0x10 بدل 0x23.
- مكتبته Adafruit VEML7700.
- طرف VIN يوصل بـ 3V3، وطرف 3Vo يبقى بدون توصيل.

## 8. شاشة TFT 2.0 بوصة ST7789 — 🔄 مستبدلة بشاشة 1.69 بوصة

ما وصل: شاشة 1.69 بوصة بثمانية أطراف (1.69 TFT 8针)، شريحتها في الغالب ST7789V2.

وظيفتها: تعرض القراءات وقيمة UTCI وفئة الإجهاد الحراري على العمود.

هل البديل مناسب؟ نعم. أطرافها الثمانية هي نفسها: GND وVCC وSCL وSDA وRES وDC وCS وBLK، فيبقى التوصيل كما هو.

ما يتغير:

- الدقة غالبًا 240×280 بدل 240×320، وهذا إعداد في البرنامج فقط.
- الشاشة أصغر، فيُختصر ما يُعرض عليها.

## 9. بطارية 18650 - 3500mAh ×2 — 🔄 مستبدلة ببطارية ليثيوم بوليمر

ما وصل: بطارية ليثيوم بوليمر طراز 103450، جهدها 3.7V وسعتها 2000mAh، أي 7.4Wh، ولها سلك بمقبس.

وظيفتها: تشغّل العقدة عند فصل الكهرباء.

هل البديل مناسب؟ مناسب كاحتياط فقط. طاقتها قرابة ربع طاقة التصميم (7.4Wh مقابل 25.9Wh). مدة التشغيل التقريبية:

الوضع | مع البطارية المخططة | مع البطارية المستلمة
عادي | قرابة 21 ساعة | قرابة 6 إلى 7 ساعات
اقتصادي | قرابة 42 ساعة | قرابة 12 ساعة

ما يتغير:

- توصل مباشرة: الأحمر إلى B+ والأسود إلى B− في TP4056.
- لا تحتاج حاملي البطارية.
- يُعدَّل حساب نسبة شحن البطارية في البرنامج حسب سعتها.

التوصية: يكفي يوم العرض إذا بقي المحول موصولًا. للتشغيل يومًا كاملًا بلا كهرباء، اطلب بطاريتي 18650.

## 10. وحدة الشحن TP4056 USB-C — ✅ موجودة

ما هي: شاحن بطاريات ليثيوم بمنفذ USB-C، وفيه دائرة حماية. أطرافه B+ وB− وOUT+ وOUT−.

وظيفتها: تشحن البطارية من المحول، وتحميها من الشحن الزائد والتفريغ العميق، وتمرر الطاقة لبقية الدائرة.

## 11. منظم الجهد TPS63020 — ✅ موجود

ما هو: محول رفع وخفض للجهد (Buck-Boost)، عليه نقاط لاختيار الخرج: 5V و4V2 و3V3.

وظيفته: يحوّل جهد البطارية المتغير (من 3.0 إلى 4.2V) إلى 5V ثابتة تغذي ESP32.

تنبيه مهم: قس الخرج بالملتيميتر وتأكد أنه 5V قبل توصيله بـ ESP32. إذا ظهر جهد آخر، فنقطة 5V غير ملحومة أو اللحام على نقطة أخرى.

## 12. محول رافع الجهد MT3608 — ❌ غير ظاهر

ما هو: محول رافع للجهد قابل للضبط.

وظيفته: احتياط للقطعة 11 فقط. لا تحتاجه إذا عمل TPS63020 على 5V.

## 13. مفتاح الانزلاق SK12D07VG5 — ✅ موجود

ما هو: مفتاح صغير بثلاثة أطراف.

وظيفته: تشغيل العقدة وإطفاؤها، ويركّب بين الشاحن والمنظم.

كيف توصله: الطرف الأوسط مع أحد الطرفين.

## 14. مكثف إلكتروليتي 1000µF 25V — ❌ غير ظاهر

وظيفته: يثبّت جهد 5V ويمنع هبوطه عند ذروات استهلاك الواي فاي، فلا تعيد اللوحة التشغيل فجأة.

الأهمية: مهم، وهو رخيص.

## 15. محول 5V USB-C — ❌ غير ظاهر

وظيفته: المصدر الثابت: يشغّل العقدة ويشحن البطارية.

بديل مؤقت: أي شاحن جوال 5V بتيار 2A.

## 16. قطع التوصيل والتجميع — ❌ غير ظاهرة

- لوحة تجارب 830 نقطة.
- المقاومات:
  - 4.7kΩ لحساس الكرة.
  - 1kΩ و10kΩ للموتور.
  - 10kΩ ×2 لقياس جهد البطارية.
- الأسلاك.
- لوحة PCB.
- كرة تنس طاولة مع بخاخ أسود مطفي.

ملاحظة: حاملا البطارية لم يعودا لازمين بسبب البطارية الجديدة.

# 3. المطلوب الآن

1. أكّد هل وصلت القطع المعلّمة ❌، وأولها DS18B20 والموتور.
2. قس خرج TPS63020 قبل أي توصيل بـ ESP32.
3. حدّث القيم التالية في المحادثة الثانية عند كتابة البرنامج:
  - عنوان حساس الضوء 0x10.
  - دقة الشاشة 240×280.
  - سعة البطارية 2000mAh.

جرد قطع النموذج الأولي — هبوب
