SARAHXL1/Expo2023-HABOOB/hardware/parts-guides/دليل الحساسات والقطع للنموذج الأولي.docx

` دليل الحساسات والقطع للنموذج الأولي (نسخة مختصرة)

مشروع هاكثون إكسبو 2030 الرياض · تحدي 2.3

المشروع | منظومة الراحة الحرارية للمناطق الخارجية، تحدي 2.3، هاكثون إكسبو 2030 الرياض
الأصل | مختصر من «الوصف الهندسي لوحدة الاستشعار الميدانية (العمود)» الإصدار 0.1
التاريخ والحالة | 30 سبتمبر 2026 · مسودة

يجمع هذا الملف كل قطعة يحتاجها العمود: ما هي، ووظيفتها، وما نستخدمه منها في النموذج الأولي، والخيارات المتاحة بإيجابياتها وسلبياتها. الخيار المعلَّم (موصى به) هو ترشيحنا للنموذج الأولي. كل المواصفات تُراجع في ورقة بيانات اللوحة المشتراة فعلًا.

# 1. المتحكم (Microcontroller)

ما هو: لوحة إلكترونية صغيرة فيها معالج وواي فاي، تُبرمج لتقرأ الحساسات وترسل البيانات. هي «عقل» العمود.

وظيفته في النموذج الأولي: يقرأ كل الحساسات كل دقيقة، ويرسل القراءات للخادم عبر الواي فاي.

الخيار | الإيجابيات | السلبيات
ESP32-DevKitC بشريحة ESP32-WROOM-32E (موصى به) | الأكثر انتشارًا، ومكتباته وأمثلته كثيرة جدًا؛ منافذ كافية لكل الحساسات؛ متوفر ورخيص | منافذ ADC2 لا تعمل مع الواي فاي؛ بعض منافذه محجوزة للإقلاع ويجب تجنبها
ESP32-S3-DevKitC | معالج أحدث وذاكرة أكبر؛ منفذ USB مدمج؛ منافذ أكثر | ترقيم منافذه مختلف، فبعض الأمثلة الجاهزة تحتاج تعديلًا؛ أغلى قليلًا
ESP32-C3 (لوحات صغيرة) | صغير جدًا ورخيص واستهلاكه منخفض | منافذ قليلة ومعالج بنواة واحدة؛ ضيق إن أضفنا شاشة وبطاقة ذاكرة

# 2. حساس حرارة الهواء والرطوبة

ما هو: شريحة رقمية صغيرة تقيس درجة حرارة الهواء ونسبة الرطوبة، وتتصل بالمتحكم بسلكين (I2C).

وظيفته في النموذج الأولي: يقيس مدخلين أساسيين من مدخلات مؤشر UTCI، ويُركَّب داخل الواقي الإشعاعي فقط.

الخيار | الإيجابيات | السلبيات
SHT45 (موصى به) | أعلى دقة في العائلة (نموذجيًا ±0.1 °م)؛ يعمل على 3.3V مباشرة | أغلى من غيره؛ يُفضّل شراء لوحة عليها غطاء PTFE يحميه من الغبار
SHT40 | دقة جيدة جدًا (نموذجيًا ±0.2 °م) بسعر أقل | أقل دقة من SHT45
SHT31 | منتشر وموثوق، ولوحاته متوفرة بكثرة | أقدم وأقل دقة (نموذجيًا ±0.3 °م)

ما نتجنبه: حساس DHT22 لضعف دقته وثباته، وحساس BME280 لأن قراءة الحرارة فيه أقل موثوقية لهذا الغرض.

# 3. مقياس الحرارة الكروي (Globe Thermometer)

ما هو: كرة مجوفة مطلية بلون مطفي، في مركزها حساس حرارة. تسخن الكرة بأشعة الشمس وحرارة الأسطح كما يسخن جسم الإنسان، فتعطينا أثر الإشعاع. هو أهم ما يميز العمود عن محطة طقس عادية.

وظيفته في النموذج الأولي: يقيس حرارة الكرة (Tg)، ومنها يحسب الخادم متوسط الحرارة الإشعاعية (MRT) الداخل في مؤشر UTCI.

## 3.1 جسم الكرة

الخيار | الإيجابيات | السلبيات
كرة نحاسية مجوفة 150 ملم مطلية بالأسود المطفي | المقاس القياسي المعتمد، فلا تحتاج معامل تصحيح للقطر | أغلى وأصعب في الحصول عليها؛ بطيئة الاستجابة (تحتاج دقائق لتستقر)
كرة تنس طاولة 38 إلى 40 ملم مطلية بالرمادي المطفي (موصى به للنموذج الأولي) | رخيصة ومتوفرة وخفيفة؛ سريعة الاستجابة؛ مستخدمة في أبحاث الراحة الحرارية | تحتاج معامل تصحيح لقطرها في معادلة MRT؛ أكثر تأثرًا بالرياح

## 3.2 الحساس داخل الكرة

الخيار | الإيجابيات | السلبيات
DS18B20 بغلاف معدني مقاوم للماء (موصى به) | رقمي وبسيط؛ سلك بيانات واحد؛ رخيص ومتوفر | دقته ±0.5 °م؛ يحتاج مقاومة سحب 4.7kΩ
PT100 مع محول MAX31865 | دقة أعلى بوضوح | أغلى، ويحتاج لوحة محول وتوصيل SPI (أسلاك أكثر)
ثرمستور NTC 10k مع ADS1115 | رخيص جدًا وصغير | يحتاج معايرة وحسابات، ومحولًا تناظريًا خارجيًا

# 4. مقياس سرعة الرياح (Anemometer)

ما هو: أداة بكؤوس تدور مع الهواء؛ كلما زادت سرعة الرياح زادت سرعة الدوران، فتحولها إلى إشارة يقرؤها المتحكم.

وظيفته في النموذج الأولي: يقيس سرعة الرياح، وهي مدخل أساسي في UTCI وفي حساب MRT. يُركّب أعلى العمود بعيدًا عن العوائق.

الخيار | الإيجابيات | السلبيات
نبضي بمفتاح مغناطيسي (Reed)، مثل مقاييس حزم محطات الطقس الهاوية (موصى به) | يتصل مباشرة بمنفذ رقمي على 3.3V؛ لا يحتاج محولًا ولا جهدًا عاليًا؛ برمجته بسيطة (عدّ نبضات) | أقل دقة في الرياح الخفيفة جدًا؛ يحتاج تنعيم ارتداد المفتاح
تناظري بخرج 0.4 إلى 2V | قراءة مستمرة وسهلة الفهم | يحتاج تغذية 7 إلى 24V، ومحولًا تناظريًا (ADS1115 أو ADC1)
صناعي بمنفذ RS485 (Modbus) | متين ومصمم للخارج؛ دقة أفضل عادة | أغلى؛ يحتاج وحدة تحويل RS485 وبرمجة Modbus وتغذية أعلى
مطبوع ثلاثيًا (كؤوس مع محمل 608 ومغناطيس وحساس Hall) | رخيص ويُظهر مهارة الفريق في التصنيع | معايرته تستهلك وقتًا كبيرًا، ودقته غير مضمونة

# 5. حساس حرارة سطح الأرضية (بالأشعة تحت الحمراء)

ما هو: حساس يقيس حرارة سطح من بعيد دون أن يلمسه، بقراءة الأشعة تحت الحمراء الصادرة منه.

وظيفته في النموذج الأولي: يقيس حرارة الأرض تحت العمود (بلاط أو عشب)، فيساعد نموذج التقدير على فهم المناطق بين الأعمدة. يُركّب مائلًا للأسفل على ارتفاع قرابة 1 م.

الخيار | الإيجابيات | السلبيات
MLX90614 نسخة 3V (موصى به) | بسيط ومنتشر؛ قراءة واحدة سهلة المعالجة؛ يتصل بـ I2C | يقيس متوسط مساحة واحدة؛ يجب طلب نسخة 3V تحديدًا واختيار زاوية رؤية مناسبة؛ يعمل على I2C بسرعة 100 kHz فقط
MLX90640 (مصفوفة حرارية 32×24) | صورة حرارية كاملة للأرض؛ عرض بصري قوي أمام اللجنة | أغلى؛ بيانات أكبر ومعالجة أعقد؛ الأنسب كترقية لاحقة

# 6. حساس شدة الإضاءة

ما هو: حساس يقيس كمية الضوء الساقط عليه بوحدة اللوكس.

وظيفته في النموذج الأولي (اختياري): يميّز هل العمود في الظل أو الشمس، ويدعم نموذج التقدير. يُركّب أعلى العمود تحت قبة بيضاء مشتِّتة.

الخيار | الإيجابيات | السلبيات
VEML7700 (موصى به) | مداه يصل تقريبًا إلى 120,000 لوكس، فيتحمل شمس الرياض المباشرة | يحتاج ضبط الكسب ووقت القياس برمجيًا
BH1750 | رخيص ومنتشر جدًا | حدّه 65,535 لوكس، فيتشبع في الشمس المباشرة إلا مع مشتِّت يخفف الضوء
مقياس إشعاع شمسي (Pyranometer) | يقيس الإشعاع بوحدة W/m² مباشرة، وهو الأدق علميًا | أغلى بكثير، وغالبًا تناظري؛ الأنسب للعمل المستقبلي

# 7. قطع مساندة

## 7.1 محول تناظري إلى رقمي ADS1115

ما هو: شريحة تحول الجهد التناظري إلى رقم دقيق (16 بت، 4 قنوات) وترسله عبر I2C.

وظيفته في النموذج الأولي: نحتاجه فقط إن اخترنا مقياس رياح تناظريًا أو ثرمستورًا. البديل منافذ ADC1 الداخلية، وهي أقل دقة لكنها مجانية.

## 7.2 تسجيل احتياطي للبيانات

ما هو: مكان تُحفظ فيه القراءات داخل العمود إذا انقطع الواي فاي، ثم تُرسل لاحقًا.

الخيار | الإيجابيات | السلبيات
وحدة بطاقة microSD تعمل على 3.3V (موصى به) | سعة كبيرة؛ يمكن نزع البطاقة وقراءة البيانات على الحاسب | قطعة وأسلاك إضافية (SPI)؛ بعض الوحدات مصممة لـ 5V
ذاكرة الفلاش الداخلية في ESP32 | بلا قطع إضافية | سعة صغيرة، وتكفي لساعات فقط

## 7.3 شاشة عرض صغيرة (اختيارية)

ما هي: شاشة OLED صغيرة من نوع SSD1306 مقاس 0.96 بوصة، تتصل بـ I2C.

وظيفتها في النموذج الأولي: تعرض القراءات على العمود نفسه أثناء العرض، فترى اللجنة القياس مباشرة. إيجابياتها: رخيصة وسهلة وتقوّي العرض. سلبياتها: صغيرة ولا تُقرأ جيدًا تحت الشمس المباشرة.

# 8. الطاقة

ما هي: مصدر الكهرباء الذي يشغّل العمود، ويوضع في القاعدة.

وظيفتها في النموذج الأولي: تغذية المتحكم وكل الحساسات بجهد 5V ثابت يتحمل ذروة استهلاك الواي فاي. لم تُحسم بعد، وتعتمد على حجم النموذج ومكان العرض.

الخيار | الإيجابيات | السلبيات
محول 5V بتيار 2A بمخرج USB (موصى به للعرض الداخلي) | الأبسط والأضمن؛ لا يحتاج شحنًا | يحتاج مقبس كهرباء قريبًا
باور بانك | متنقل وسهل | بعض الأنواع تنطفئ تلقائيًا عند الاستهلاك المنخفض؛ مدة التشغيل محدودة
بطارية 12V مع محول خافض (Buck) إلى 5V، مثل وحدات LM2596 أو MP1584 | تشغيل خارجي طويل؛ تناسب مقياس رياح يحتاج 12V | أثقل وأعقد؛ يجب ضبط خرج المحول بالملتيميتر قبل توصيل ESP32
ألواح شمسية مع منظم شحن | مستقلة تمامًا عن الشبكة ورسالة استدامة قوية | أغلى وأعقد؛ الأنسب للعمل المستقبلي

قطع حماية مع أي خيار: فيوز ومفتاح تشغيل، ومكثف 470 إلى 1000µF قرب مدخل 5V لتثبيت الجهد.

# 9. الواقي الإشعاعي (Radiation Shield)

ما هو: غلاف أبيض مهوّى يحيط بحساس الهواء، يمنع الشمس من تسخينه مباشرة ويسمح للهواء بالمرور.

وظيفته في النموذج الأولي: إلزامي؛ بدونه يقرأ حساس الهواء حرارة أعلى من الحقيقة بعدة درجات. يُطبع باللون الأبيض.

الخيار | الإيجابيات | السلبيات
أطباق متراكبة مهوّاة مطبوعة (موصى به) | تصميم معروف ومثبت علميًا؛ نماذجه المفتوحة كثيرة | شكله تقني ولا يحمل الهوية السعودية وحده
غلاف مشربية مزدوج مطبوع | يجمع الوظيفة مع الهوية البصرية، وهو نقطة قوة أمام اللجنة | يحتاج تجربة للتأكد أن تهويته وحجبه للشمس كافيان
واقٍ تجاري جاهز | أداء مضمون | أغلى، وشكله لا يناسب التصميم

# 10. الهيكل ومواد الطباعة

ما هو: الجسم الحامل للعمود: ماسورة مركزية تمر الأسلاك داخلها، تنزلق عليها وحدات مطبوعة ثلاثيًا.

## 10.1 الماسورة المركزية (قطر 32 إلى 40 ملم)

الخيار | الإيجابيات | السلبيات
PVC (موصى به للنموذج الأولي) | رخيصة وخفيفة وسهلة القص والثقب | أقل صلابة، وقد تلين قليلًا تحت الشمس الطويلة
ألمنيوم | صلب ومتين ومقاوم للخارج | أغلى وأصعب في التشغيل؛ يسخن تحت الشمس

## 10.2 مادة الطباعة

الخيار | الإيجابيات | السلبيات
PETG (موصى به) | يتحمل الحرارة أكثر من PLA؛ سهل الطباعة نسبيًا | أقل تحملًا للأشعة فوق البنفسجية من ASA
ASA | الأفضل للخارج: يتحمل الحرارة والأشعة فوق البنفسجية | يحتاج طابعة مغلقة، وطباعته أصعب
PLA | الأسهل والأرخص | يلين قرابة 55 إلى 60 °م؛ يصلح للعرض الداخلي فقط

قطع التثبيت: براغي M3 مع حشوات نحاسية حرارية (Heat-set Inserts)، وأثقال للقاعدة، وجلب كابلات (Cable Glands) لإحكام مخارج الأسلاك.

# 11. التوصيل واللحام

ما هو: اللوحة والأسلاك والموصلات التي تربط الحساسات بالمتحكم.

الخيار | الإيجابيات | السلبيات
لوحة مثقبة (Perfboard) مع مقابس لـ ESP32 (موصى به) | سريعة ورخيصة؛ يمكن استبدال ESP32 إن احترق | تحتاج لحامًا يدويًا دقيقًا، وشكلها أقل احترافية
لوحة دوائر مطبوعة مخصصة (PCB) | احترافية ومرتبة وموثوقة | تصميمها وتصنيعها يستغرق أيامًا؛ الأنسب بعد تثبيت التصميم

للموصلات: موصلات JST-XH (صغيرة ومرتبة لكنها تحتاج أداة كبس) أو براغي طرفية (لا تحتاج أدوات لكنها أكبر حجمًا). المهم أن يُفك كل حساس دون قص الأسلاك.

قطع صغيرة لازمة: مقاومات 4.7kΩ لخط 1-Wire، ومقاومة 10kΩ لمقياس الرياح، وأسلاك مجدولة، وأنابيب انكماش حراري، وأدوات اللحام والملتيميتر.

# 12. ملخص النموذج الأولي (عمود واحد)

القطعة | الاختيار للنموذج الأولي | الاتصال بـ ESP32
المتحكم | ESP32-DevKitC (+1 احتياط) | —
حرارة الهواء والرطوبة | SHT45 داخل واقٍ إشعاعي أبيض | I2C (0x44)
الكرة الحرارية | DS18B20 داخل كرة تنس طاولة رمادية مطفية | 1-Wire
سرعة الرياح | مقياس نبضي بمفتاح مغناطيسي | منفذ مقاطعة
حرارة سطح الأرضية | MLX90614 نسخة 3V | I2C (0x5A)
شدة الإضاءة (اختياري) | VEML7700 تحت قبة مشتِّتة | I2C (0x10)
تسجيل احتياطي (اختياري) | وحدة microSD على 3.3V | SPI
شاشة (اختياري) | OLED SSD1306 | I2C (0x3C)
الطاقة | محول 5V/2A (يُحسم لاحقًا) | 5V
الهيكل | ماسورة PVC ووحدات PETG مطبوعة | —
التوصيل | لوحة مثقبة مع مقابس وموصلات قابلة للفك | —

قبل الشراء: نحتاج قائمة الحساسات الموجودة لديكم فعلًا، وحجم النموذج، والطابعة المتوفرة، حتى لا نشتري ما هو موجود.

دليل الحساسات والقطع للنموذج الأولي · مختصر
