SARAHXL1/Expo2023-HABOOB/hardware/parts-guides/قائمة قطع النموذج الأولي - مدخلات UTCI.docx

قائمة قطع النموذج الأولي لقياس مدخلات مؤشر UTCI

مشروع هاكثون إكسبو 2030 الرياض · تحدي 2.3

المشروع | منظومة الراحة الحرارية للمناطق الخارجية، تحدي 2.3، هاكثون إكسبو 2030 الرياض
النطاق | أبسط نموذج أولي (عمود واحد) يقيس مدخلات مؤشر UTCI الأربعة
التاريخ والحالة | 30 سبتمبر 2026 · مسودة

مؤشر UTCI (Universal Thermal Climate Index) يقدّر كيف يشعر جسم الإنسان بالحرارة أو البرودة في المكان المفتوح، ويعطي قيمة واحدة بالدرجة المئوية. يحتاج أربعة مدخلات: حرارة الهواء، والرطوبة، وسرعة الرياح، ومتوسط الحرارة الإشعاعية (MRT). ثلاثة منها تُقاس مباشرة، والرابع يُحسب في الخادم من حرارة الكرة الحرارية.

العمود يقيس ويرسل فقط، وحساب UTCI يتم في الخادم (مثلًا بمكتبة Python مثل pythermalcomfort، مع التحقق من إصدارها).

# 1. قائمة القطع

القطع الأساسية (1 إلى 18) تكفي وحدها لقياس مدخلات UTCI كاملة. الإضافات الاختيارية لا يحتاجها المؤشر، لكنها تقوّي العرض ونموذج التقدير.

## أ. الحساسات: مدخلات UTCI الأربعة

# | القطعة | الموديل المقترح | البديل المناسب | مدخل UTCI | الكمية | الاتصال بـ ESP32 | ملاحظات

1 | حساس حرارة الهواء والرطوبة | SHT40 على لوحة جاهزة | SHT45 (أدق) أو SHT31 | Ta + RH | 1 | I2C (0x44)، 3.3V | داخل الواقي الإشعاعي ولا يلمس جدرانه. تجنّب DHT22
2 | حساس حرارة مقاوم للماء | DS18B20 بغلاف معدني | PT100 مع MAX31865 (أدق وأغلى) | Tg ← MRT | 1 | 1-Wire، 3.3V | في مركز الكرة، ويحتاج مقاومة سحب 4.7kΩ
3 | جسم الكرة الحرارية | كرة تنس طاولة 40 ملم | كرة نحاسية 150 ملم (المقاس القياسي) | Tg ← MRT | 2 | — | تُطلى بالرمادي المطفي. الثانية احتياط
4 | بخاخ طلاء مطفي | رمادي متوسط مطفي | أسود مطفي (للكرة النحاسية) | Tg ← MRT | 1 | — | طبقة رقيقة متساوية
5 | مقياس سرعة الرياح | كأسي نبضي بمفتاح مغناطيسي (Reed) | تناظري 0.4 إلى 2V مع ADS1115 (تغذية 7 إلى 24V) | va | 1 | منفذ مقاطعة، 3.3V | معامل التحويل من ورقة بياناته. يُركّب أعلى العمود

## ب. المتحكم والتوصيل

# | القطعة | الموديل المقترح | البديل المناسب | الكمية | الاتصال بـ ESP32 | ملاحظات

6 | لوحة متحكم | ESP32-DevKitC (ESP32-WROOM-32E) | ESP32-S3-DevKitC | 2 | — | الثانية احتياط
7 | كابل USB للبيانات | حسب منفذ اللوحة (Micro-USB أو USB-C) | — | 1 | USB | كابل بيانات، لا شحن فقط
8 | لوحة تجارب (Breadboard) | 830 نقطة | لوحة مثقبة ولحام بعد تثبيت الدائرة | 1 | — | توصيل بلا لحام في النموذج الأول
9 | أسلاك توصيل (Jumper Wires) | مجموعة ذكر-ذكر وذكر-أنثى | — | 1 | — | —
10 | سلك تمديد متعدد الأطراف | 4 أطراف، 3 م تقريبًا | كابل شبكة قديم (أسلاك مجدولة) | 1 | — | الأسلاك المجدولة أفضل لخط I2C
11 | مقاومة 4.7kΩ | 1/4 واط | — | 2 | بين خط 1-Wire و3.3V | سحب لخط الكرة الحرارية
12 | مقاومة 10kΩ | 1/4 واط | المقاومة الداخلية للمنفذ | 2 | بين منفذ المقاطعة و3.3V | سحب لمقياس الرياح
13 | مكثف 100nF | سيراميك | — | 2 | بين منفذ المقاطعة وGND | تنعيم ارتداد المفتاح المغناطيسي

## ج. الهيكل والحماية والطاقة

# | القطعة | الموديل المقترح | البديل المناسب | الكمية | ملاحظات

14 | الواقي الإشعاعي | أطباق متراكبة مهوّاة مطبوعة باللون الأبيض (PETG) | غلاف مشربية مزدوج مطبوع | 1 | إلزامي: بدونه تُقرأ الحرارة أعلى من الحقيقة بعدة درجات
15 | الحامل | حامل كاميرا أو حامل إضاءة (Light Stand) جاهز | ماسورة PVC بقطر 32 إلى 40 ملم وطول 1.5 م مع قاعدة مثقلة | 1 | يرفع الحساسات إلى 1.1 إلى 1.5 م. الحامل الجاهز أسرع حل
16 | علبة الإلكترونيات | علبة بلاستيك صغيرة بفتحات تهوية | علبة مطبوعة ثلاثيًا | 1 | تحت الواقي، وبعيدة عنه قليلًا حتى لا تصله حرارة ESP32
17 | رابطات بلاستيك وشريط لاصق | مجموعة | — | 1 | لتثبيت الأسلاك والقطع
18 | مصدر طاقة | محول USB بجهد 5V وتيار 2A | باور بانك لا ينطفئ عند الاستهلاك المنخفض | 1 | الأبسط والأضمن ليوم العرض

## د. إضافات اختيارية

# | القطعة | الموديل المقترح | البديل المناسب | الكمية | الاتصال بـ ESP32 | الفائدة

19 | حساس حرارة سطح الأرضية | MLX90614 نسخة 3V | MLX90640 (مصفوفة حرارية) | 1 | I2C (0x5A) | يدعم نموذج التقدير بين الأعمدة
20 | حساس شدة الإضاءة | VEML7700 | BH1750 مع قبة مشتِّتة | 1 | I2C (0x10) | يميّز الظل من الشمس
21 | شاشة OLED | SSD1306 مقاس 0.96 بوصة | — | 1 | I2C (0x3C) | تعرض قيمة UTCI على العمود أمام اللجنة
22 | وحدة بطاقة microSD | وحدة تعمل على 3.3V مع بطاقة | ذاكرة الفلاش الداخلية في ESP32 | 1 | SPI | تسجيل احتياطي عند انقطاع الواي فاي

# 2. مصدر كل مدخل من مدخلات UTCI

مدخل UTCI | الرمز والوحدة | مصدره في النموذج | طريقة الحصول عليه | تنبيه هندسي
حرارة الهواء | Ta (°م) | SHT40 داخل الواقي الإشعاعي | قياس مباشر | على ارتفاع 1.1 إلى 1.5 م، وبعيدًا عن حرارة ESP32
الرطوبة | RH (%) | SHT40 داخل الواقي الإشعاعي | قياس مباشر | المكتبات عادة تقبل الرطوبة النسبية وتحوّلها داخليًا
سرعة الرياح | va (م/ث) | مقياس الرياح النبضي | عدد النبضات في الثانية × معامل التحويل | تعريف UTCI يستخدم سرعة الرياح على ارتفاع 10 م، ونحن نقيسها قرب 1.5 م؛ يلزم تحويل الارتفاع قبل الحساب
متوسط الحرارة الإشعاعية | MRT (°م) | DS18B20 داخل الكرة + Ta + va | يُحسب بالمعادلة أدناه | تُنتظر دقائق حتى تستقر قراءة الكرة

# 3. حساب MRT من الكرة الحرارية

المعادلة المعتمدة للحمل القسري وفق معيار ISO 7726:

MRT = [ (Tg + 273)^4 + (1.1 × 10^8 × va^0.6) / (ε × D^0.4) × (Tg − Ta) ]^0.25 − 273

- Tg: حرارة الكرة (°م).
- Ta: حرارة الهواء (°م).
- va: سرعة الرياح (م/ث).
- ε: انبعاثية سطح الكرة، وتقارب 0.95 للطلاء المطفي.
- D: قطر الكرة بالمتر: 0.04 لكرة تنس الطاولة، و0.15 للكرة القياسية.

مثال توضيحي (ليس قياسًا من المشروع): إذا كانت Tg = 45 °م، وTa = 38 °م، وva = 1.5 م/ث، مع كرة تنس طاولة (D = 0.04)، فإن MRT ≈ 70.8 °م. أي أن الإشعاع يرفع العبء الحراري أكثر بكثير مما توحي به حرارة الهواء وحدها.

# 4. تصنيفات الإجهاد الحراري في UTCI

الإكسبو يمتد من أكتوبر إلى مارس، فليالي الشتاء قد تصل إلى فئات الإجهاد البارد؛ لذلك أُدرجت الفئات العشر كاملة.

UTCI (°م) | مستوى الإجهاد
أعلى من +46 | إجهاد حراري شديد جدًا
+38 إلى +46 | إجهاد حراري قوي جدًا
+32 إلى +38 | إجهاد حراري قوي
+26 إلى +32 | إجهاد حراري متوسط
+9 إلى +26 | لا يوجد إجهاد حراري
0 إلى +9 | إجهاد بارد خفيف
−13 إلى 0 | إجهاد بارد متوسط
−27 إلى −13 | إجهاد بارد قوي
−40 إلى −27 | إجهاد بارد قوي جدًا
أقل من −40 | إجهاد بارد شديد جدًا

# 5. قبل الشراء

☐ مطابقة القائمة مع الحساسات الموجودة لديكم فعلًا.

☐ جمع أسعار الموردين (لم تُدرج أسعار تقديرية حتى لا تُعتمد أرقام غير موثقة).

☐ التحقق من معامل تحويل مقياس الرياح في ورقة بياناته.

☐ التحقق من طريقة تحويل ارتفاع الرياح إلى 10 م في المكتبة المستخدمة.

قائمة قطع النموذج الأولي · مدخلات UTCI
