SARAHXL1/Expo2023-HABOOB/hardware/3d-models/Anemometer DC motor - 3648443/files/connector.STL

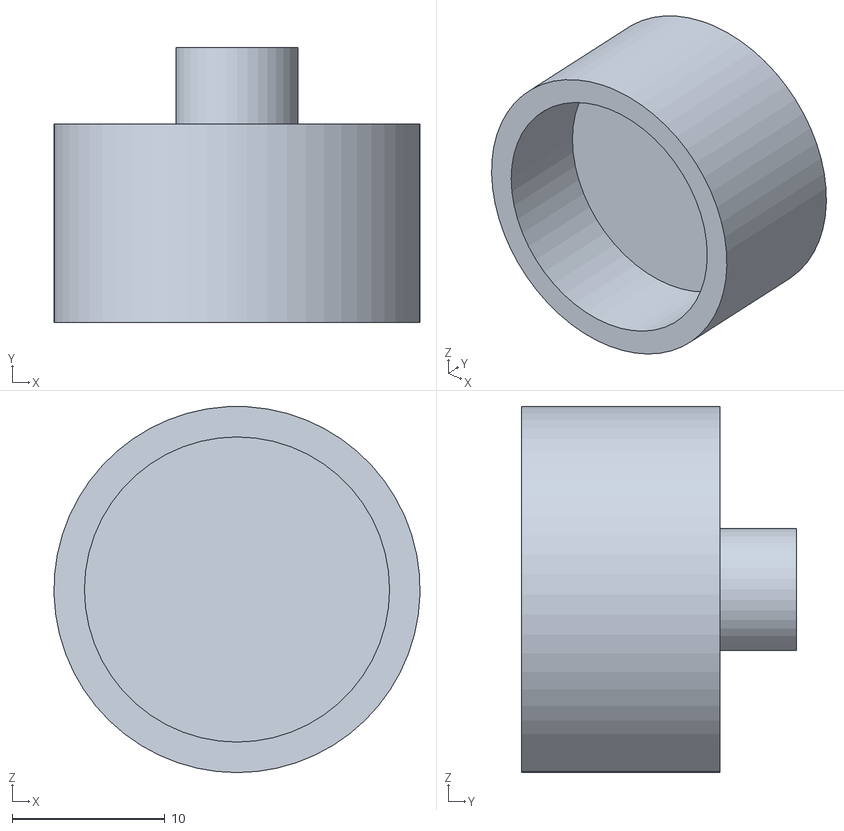
[picture p57: CAD file, 2026-10-16]
hardware/3d-models/Anemometer DC motor - 3648443/files/connector.STL
24.0 x 18.0 x 24.0
