SARAHXL1/Expo2023-HABOOB/hardware/3d-models/هبوب - شبك التهوية وتعديل حساس الرياح/1 - شبك فتحات التهوية/لوح طباعة كامل - 22 شبك طويل و5 قصيرة.3mf

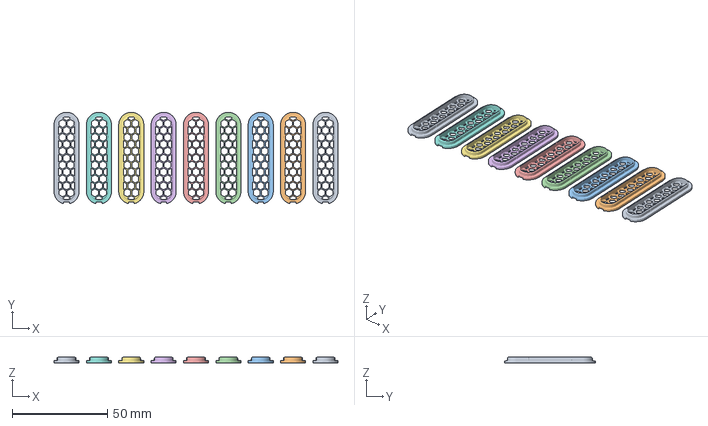
[picture p58: CAD file, 2026-10-16]
hardware/3d-models/هبوب - شبك التهوية وتعديل حساس الرياح/1 - شبك فتحات التهوية/لوح طباعة كامل - 22 شبك طويل و5 قصيرة.3mf
149.2 x 48.0 x 3.00 mm
