SARAHXL1/Expo2023-HABOOB/hardware/3d-models/هبوب - شبك التهوية وتعديل حساس الرياح/2 - حساس الرياح/HB-200 مجموعة الكؤوس - ثقب 1 الأضيق.3mf

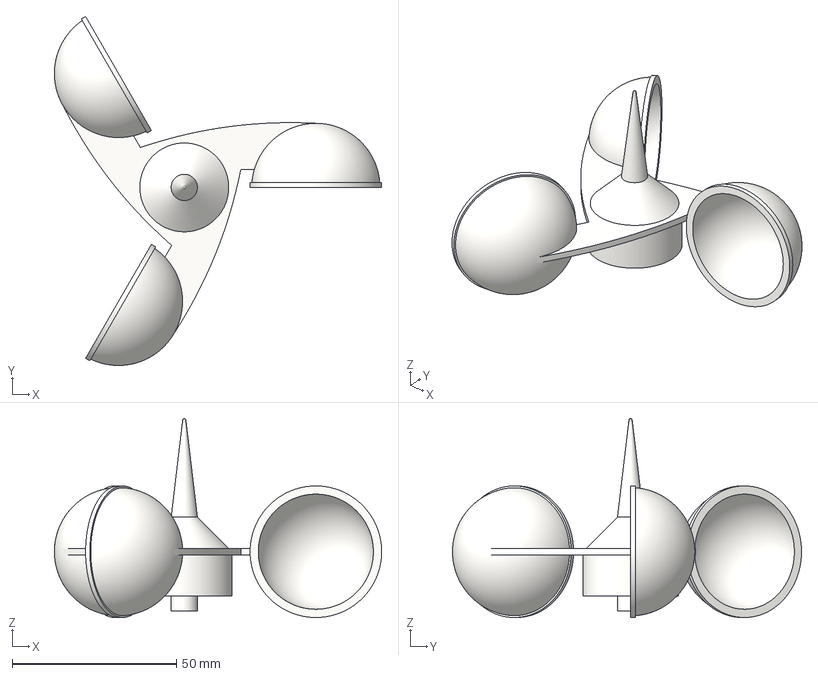
[picture p59: CAD file, 2026-10-16]
hardware/3d-models/هبوب - شبك التهوية وتعديل حساس الرياح/2 - حساس الرياح/HB-200 مجموعة الكؤوس - ثقب 1 الأضيق.3mf
99.5 x 106.1 x 60.5 mm
