SARAHXL1/Expo2023-HABOOB/hardware/3d-models/هبوب - ملفات STL - الإصدار B.2/HB-104_motor_mount.stl

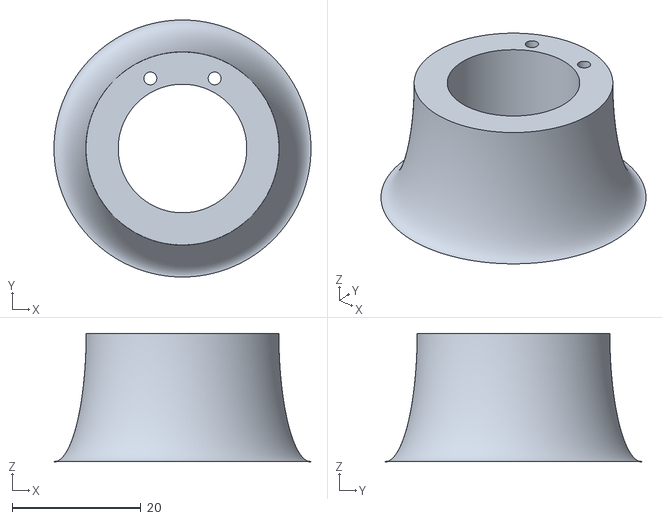
[picture p60: CAD file, 2026-10-16]
hardware/3d-models/هبوب - ملفات STL - الإصدار B.2/HB-104_motor_mount.stl
40.0 x 40.0 x 20.0
