SARAHXL1/Expo2023-HABOOB/hardware/3d-models/هبوب - ملفات الطباعة B.4/1 - حلقات اختبار الخلوص (اطبعها أولًا)/HB-193 حلقة اختبار ذكر كبيرة.3mf

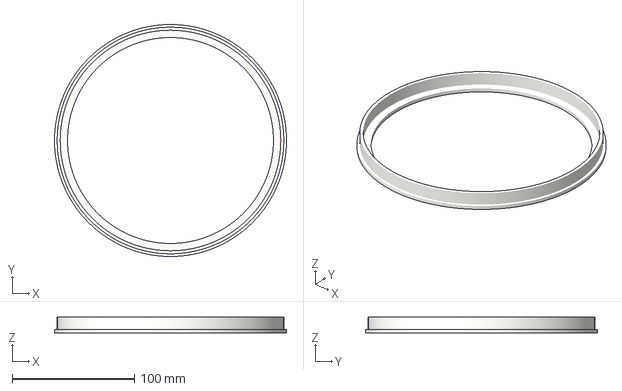
[picture p61: CAD file, 2026-10-16]
hardware/3d-models/هبوب - ملفات الطباعة B.4/1 - حلقات اختبار الخلوص (اطبعها أولًا)/HB-193 حلقة اختبار ذكر كبيرة.3mf
190.0 x 190.0 x 13.0 mm
