SARAHXL1/Expo2023-HABOOB/hardware/3d-models/هبوب - ملفات الطباعة B.4/2 - الهيكل/HB-120 العمود.3mf

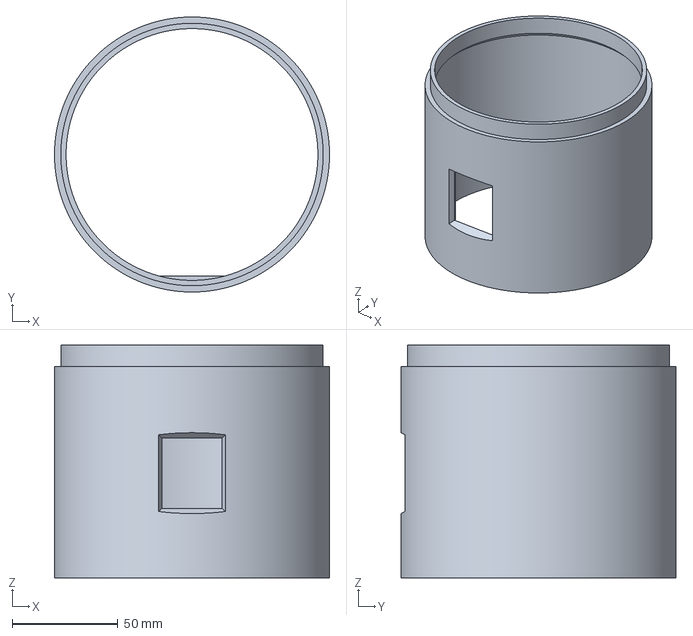
[picture p62: CAD file, 2026-10-16]
hardware/3d-models/هبوب - ملفات الطباعة B.4/2 - الهيكل/HB-120 العمود.3mf
130.0 x 130.0 x 110.0 mm
