SARAHXL1/Expo2023-HABOOB/hardware/3d-models/هبوب - ملفات الطباعة B.4/3 - أسطوانة الزخارف/HB-140 أسطوانة الزخارف - 4 ألوان.3mf

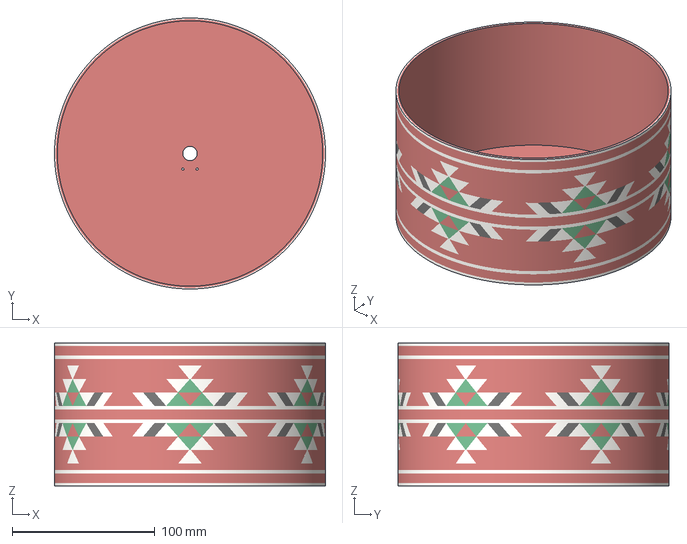
[picture p63: CAD file, 2026-10-16]
hardware/3d-models/هبوب - ملفات الطباعة B.4/3 - أسطوانة الزخارف/HB-140 أسطوانة الزخارف - 4 ألوان.3mf
190.0 x 190.0 x 100.0 mm
