SARAHXL1/Expo2023-HABOOB/hardware/3d-models/هبوب - ملفات الطباعة B.4/هبوب - شبك التهوية وتعديل حساس الرياح/1 - شبك فتحات التهوية/HB-112 شبك فتحة تهوية قصيرة.3mf

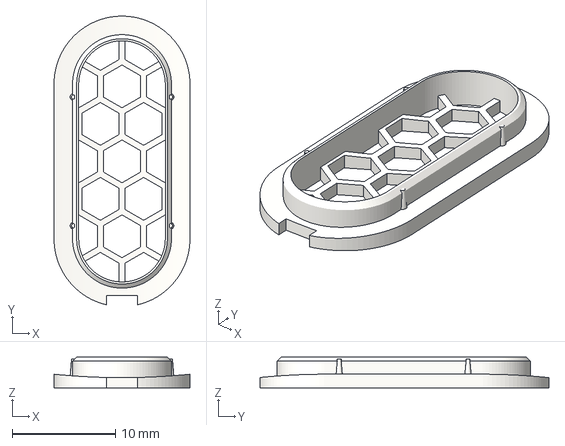
[picture p65: CAD file, 2026-10-16]
hardware/3d-models/هبوب - ملفات الطباعة B.4/هبوب - شبك التهوية وتعديل حساس الرياح/1 - شبك فتحات التهوية/HB-112 شبك فتحة تهوية قصيرة.3mf
13.2 x 28.0 x 3.00 mm
