SARAHXL1/Expo2023-HABOOB/hardware/3d-models/Anemometer DC motor - 3648443/files/base.STL

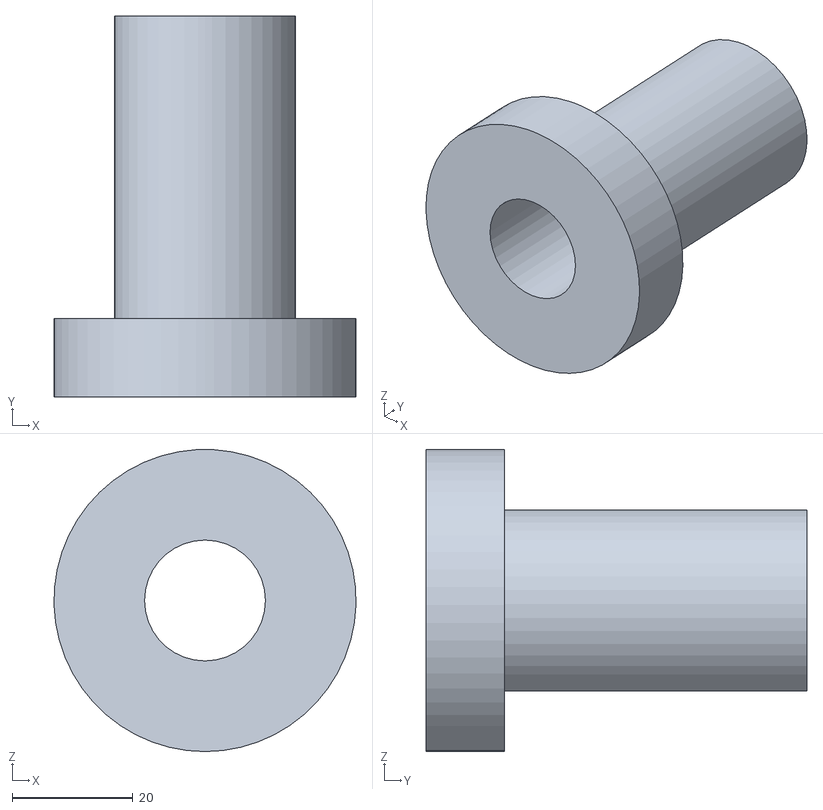
[picture p66: CAD file, 2026-10-16]
hardware/3d-models/Anemometer DC motor - 3648443/files/base.STL
50.0 x 63.0 x 50.0
