SARAHXL1/Expo2023-HABOOB/hardware/3d-models/هبوب - شبك التهوية وتعديل حساس الرياح/1 - شبك فتحات التهوية/HB-111 شبك فتحة تهوية طويلة.3mf

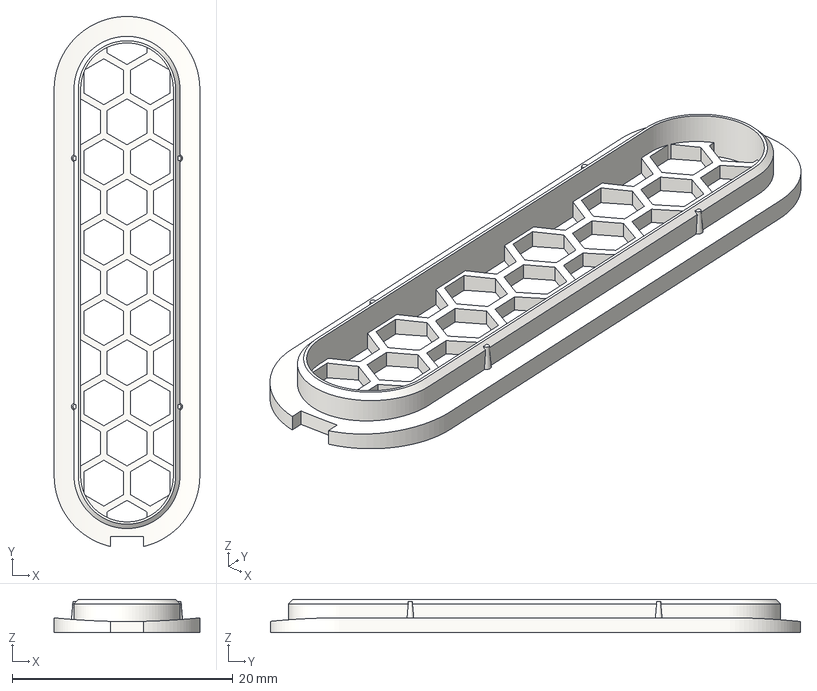
[picture p67: CAD file, 2026-10-16]
hardware/3d-models/هبوب - شبك التهوية وتعديل حساس الرياح/1 - شبك فتحات التهوية/HB-111 شبك فتحة تهوية طويلة.3mf
13.2 x 48.0 x 3.00 mm
