SARAHXL1/Expo2023-HABOOB/hardware/3d-models/هبوب - شبك التهوية وتعديل حساس الرياح/2 - حساس الرياح/HB-195 قطعة اختبار ثقب عمود الموتور.3mf

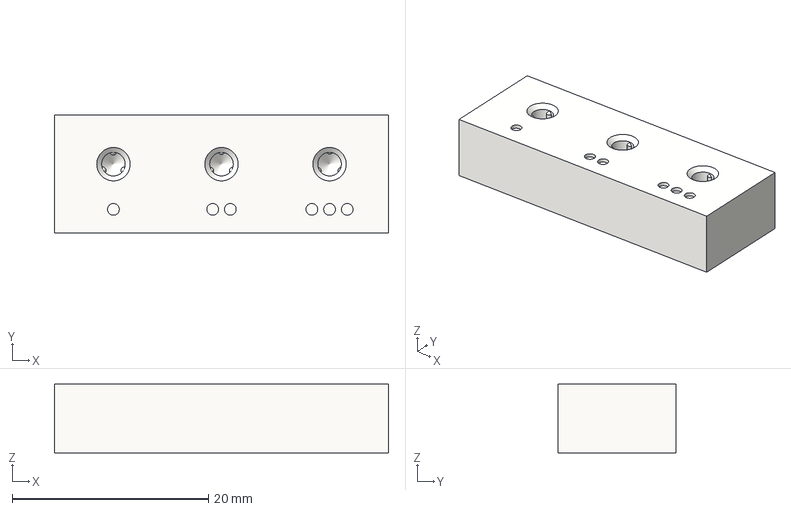
[picture p68: CAD file, 2026-10-16]
hardware/3d-models/هبوب - شبك التهوية وتعديل حساس الرياح/2 - حساس الرياح/HB-195 قطعة اختبار ثقب عمود الموتور.3mf
34.0 x 12.0 x 7.00 mm
