SARAHXL1/Expo2023-HABOOB/hardware/3d-models/هبوب - ملفات الطباعة B.4/1 - حلقات اختبار الخلوص (اطبعها أولًا)/HB-194 حلقة اختبار أنثى كبيرة.3mf

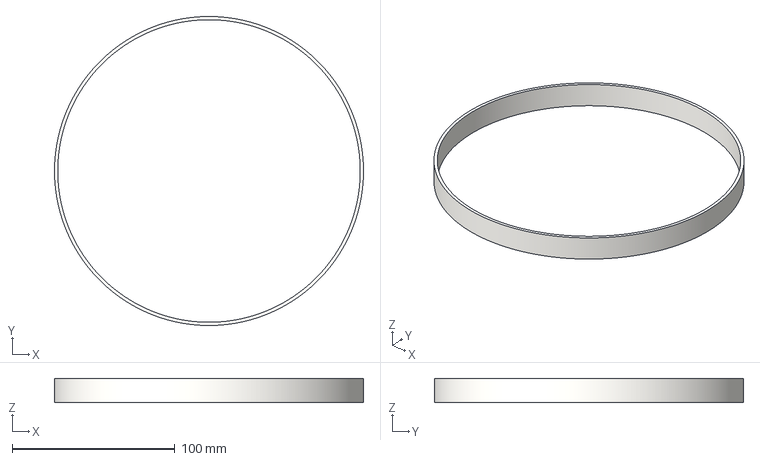
[picture p69: CAD file, 2026-10-16]
hardware/3d-models/هبوب - ملفات الطباعة B.4/1 - حلقات اختبار الخلوص (اطبعها أولًا)/HB-194 حلقة اختبار أنثى كبيرة.3mf
190.0 x 190.0 x 15.0 mm
