SARAHXL1/Expo2023-HABOOB/hardware/3d-models/هبوب - ملفات الطباعة B.4/2 - الهيكل/HB-110 حجرة الحساسات.3mf

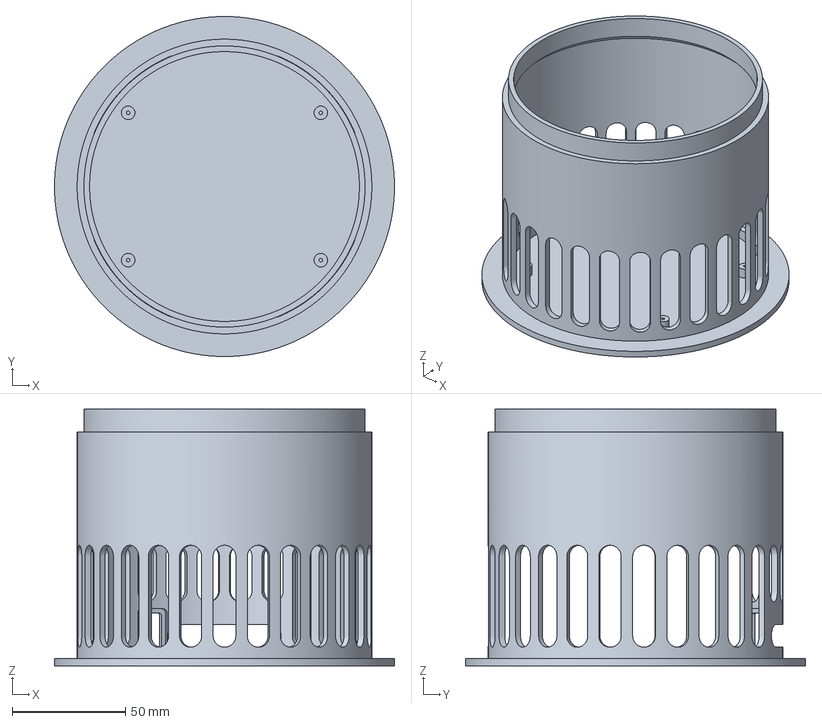
[picture p70: CAD file, 2026-10-16]
hardware/3d-models/هبوب - ملفات الطباعة B.4/2 - الهيكل/HB-110 حجرة الحساسات.3mf
150.0 x 150.0 x 113.2 mm
