SARAHXL1/Expo2023-HABOOB/hardware/3d-models/هبوب - ملفات الطباعة B.4/هبوب - شبك التهوية وتعديل حساس الرياح/1 - شبك فتحات التهوية/لوح طباعة كامل - 22 شبك طويل و5 قصيرة.3mf

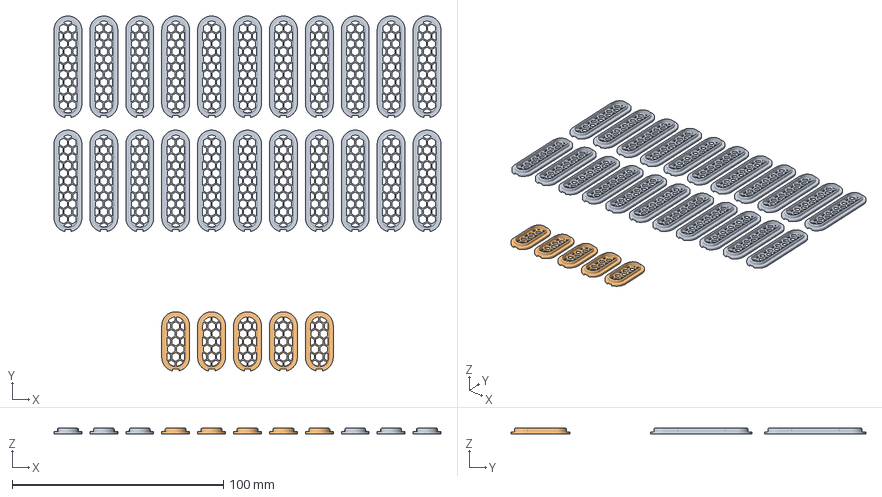
[picture p72: CAD file, 2026-10-16]
hardware/3d-models/هبوب - ملفات الطباعة B.4/هبوب - شبك التهوية وتعديل حساس الرياح/1 - شبك فتحات التهوية/لوح طباعة كامل - 22 شبك طويل و5 قصيرة.3mf
183.2 x 168.0 x 3.00 mm
HB-111 شبك طويل x 22
HB-112 شبك قصير x 5
