SARAHXL1/Expo2023-HABOOB/hardware/3d-models/هبوب - ملفات الطباعة B.4/1 - حلقات اختبار الخلوص (اطبعها أولًا)/HB-192 حلقة اختبار أنثى صغيرة.3mf

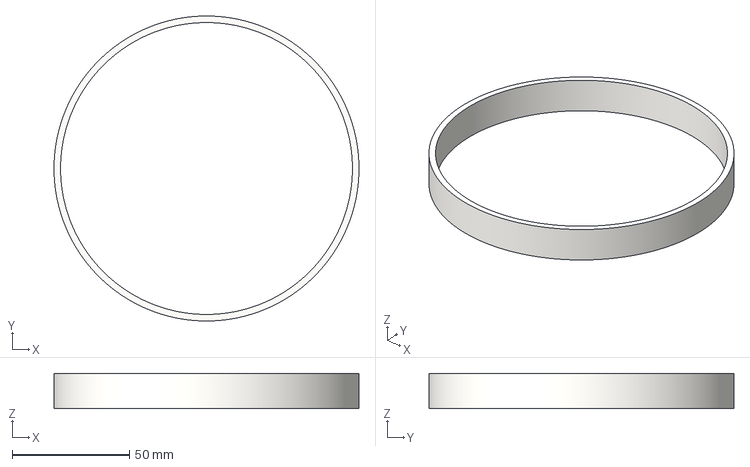
[picture p74: CAD file, 2026-10-16]
hardware/3d-models/هبوب - ملفات الطباعة B.4/1 - حلقات اختبار الخلوص (اطبعها أولًا)/HB-192 حلقة اختبار أنثى صغيرة.3mf
130.0 x 130.0 x 15.0 mm
