SARAHXL1/Expo2023-HABOOB/hardware/3d-models/هبوب - ملفات الطباعة B.4/2 - الهيكل/HB-130 الوصلة الكبيرة.3mf

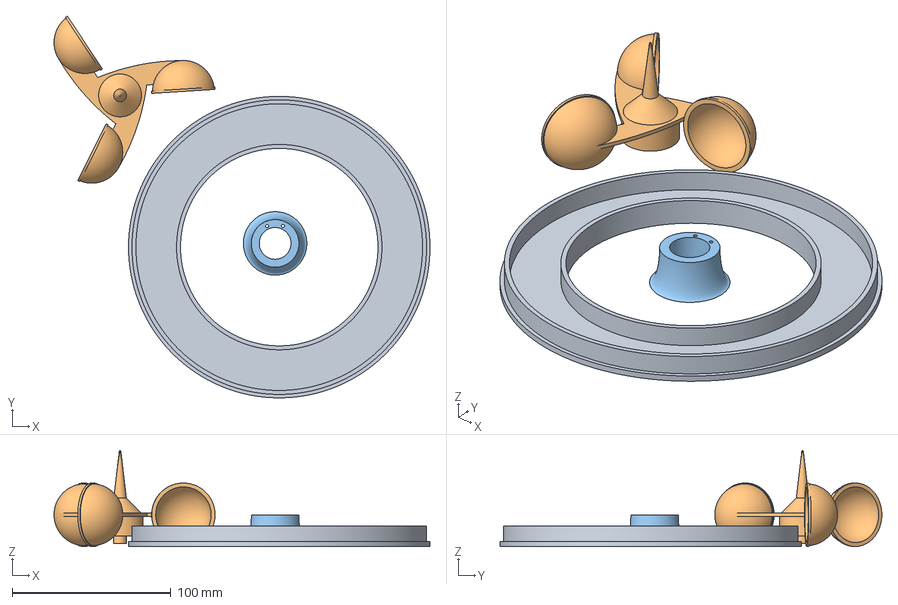
[picture p75: CAD file, 2026-10-16]
hardware/3d-models/هبوب - ملفات الطباعة B.4/2 - الهيكل/HB-130 الوصلة الكبيرة.3mf
237.0 x 240.6 x 60.5 mm
HB-130 الوصلة الكبيرة
HB-200 مجموعة الكؤوس - قطعة واحدة
HB-104 قاعدة المحرك
