SARAHXL1/Expo2023-HABOOB/hardware/3d-models/Anemometer DC motor - 3648443/files/حساس الرياح.3mf

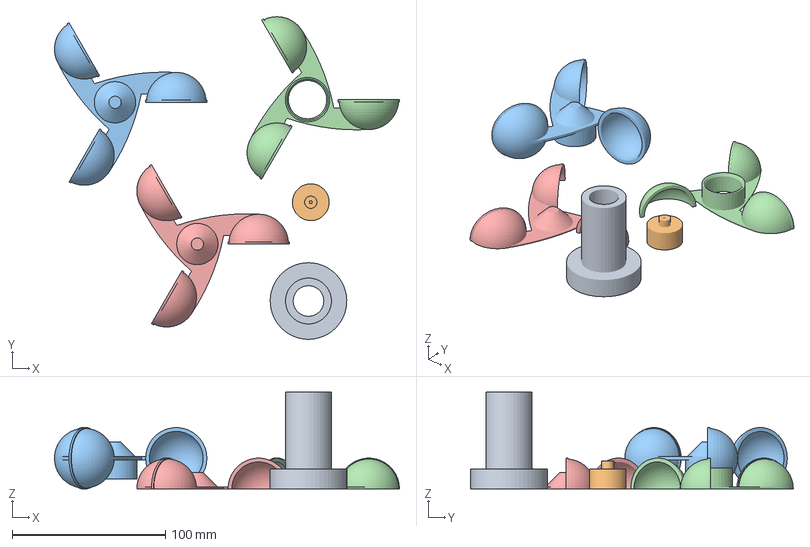
[picture p77: CAD file, 2026-10-16]
hardware/3d-models/Anemometer DC motor - 3648443/files/حساس الرياح.3mf
225.1 x 210.5 x 63.0 mm
base.STL
connector.STL
fan.STL
fan_bottom.STL
fan_top.STL
