SARAHXL1/Expo2023-HABOOB/hardware/3d-models/هبوب - ملفات STL - الإصدار B.2/HB-191_test_ring_small_male.stl

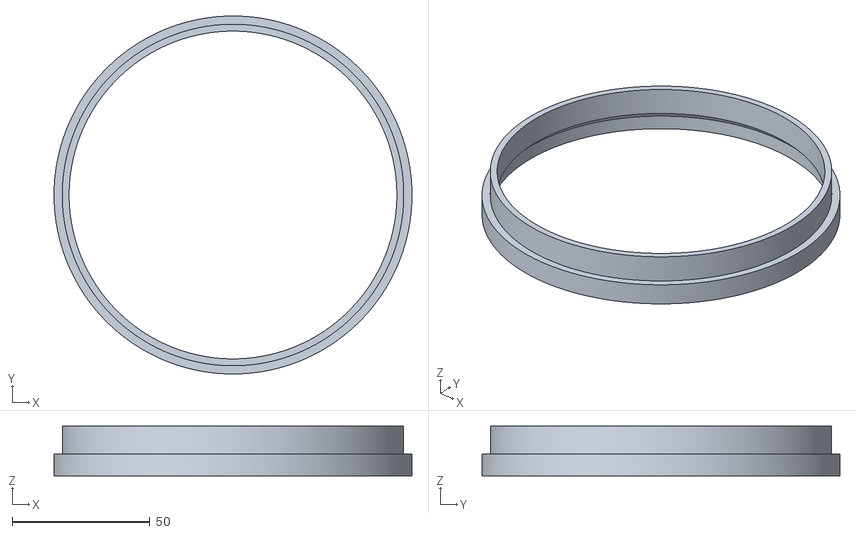
[picture p78: CAD file, 2026-10-16]
hardware/3d-models/هبوب - ملفات STL - الإصدار B.2/HB-191_test_ring_small_male.stl
130.0 x 130.0 x 18.0
