SARAHXL1/Expo2023-HABOOB/hardware/3d-models/هبوب - ملفات الطباعة B.4/STL/3 - أسطوانة الزخارف/HB-140 أسطوانة الزخارف - 4 أسود.stl

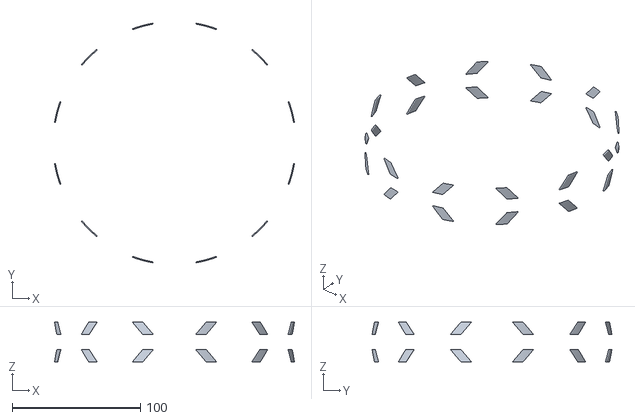
[picture p79: CAD file, 2026-10-16]
hardware/3d-models/هبوب - ملفات الطباعة B.4/STL/3 - أسطوانة الزخارف/HB-140 أسطوانة الزخارف - 4 أسود.stl
187.3 x 187.0 x 31.0
