SARAHXL1/Expo2023-HABOOB/hardware/3d-models/Anemometer DC motor - 3648443/files/fan.STL

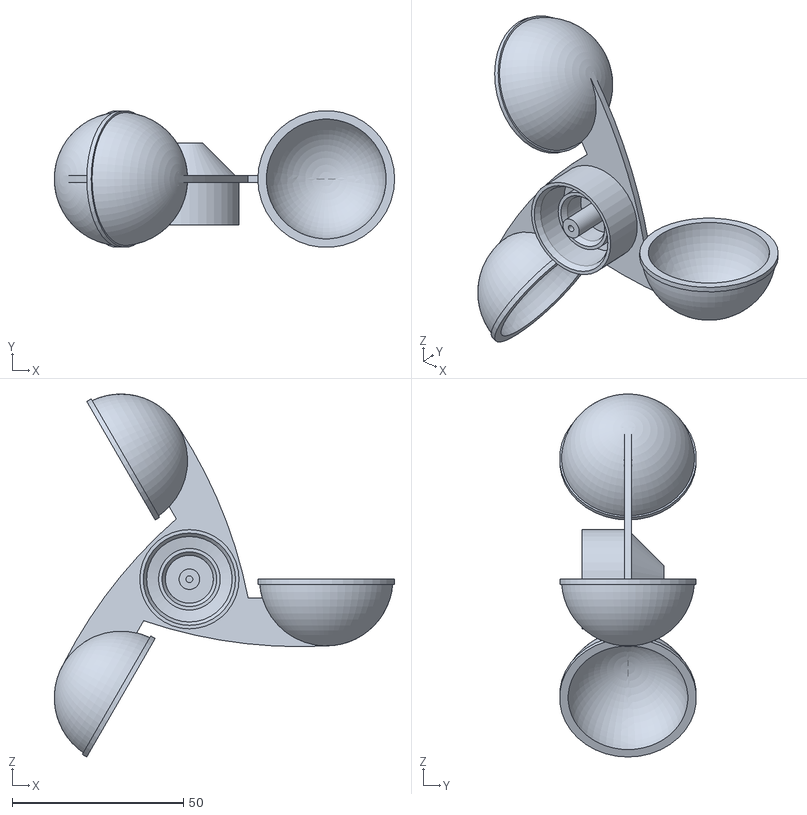
[picture p80: CAD file, 2026-10-16]
hardware/3d-models/Anemometer DC motor - 3648443/files/fan.STL
99.5 x 39.9 x 106.1
