SARAHXL1/Expo2023-HABOOB/hardware/3d-models/هبوب - ملفات STL - الإصدار B.2/HB-204_spike.stl

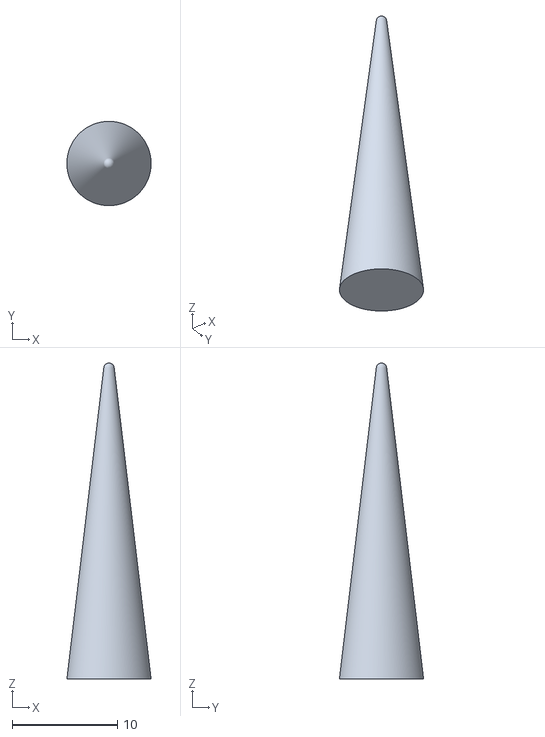
[picture p81: CAD file, 2026-10-16]
hardware/3d-models/هبوب - ملفات STL - الإصدار B.2/HB-204_spike.stl
8.00 x 8.00 x 30.0
