SARAHXL1/Expo2023-HABOOB/hardware/3d-models/Anemometer DC motor - 3648443/files/fan_top.STL

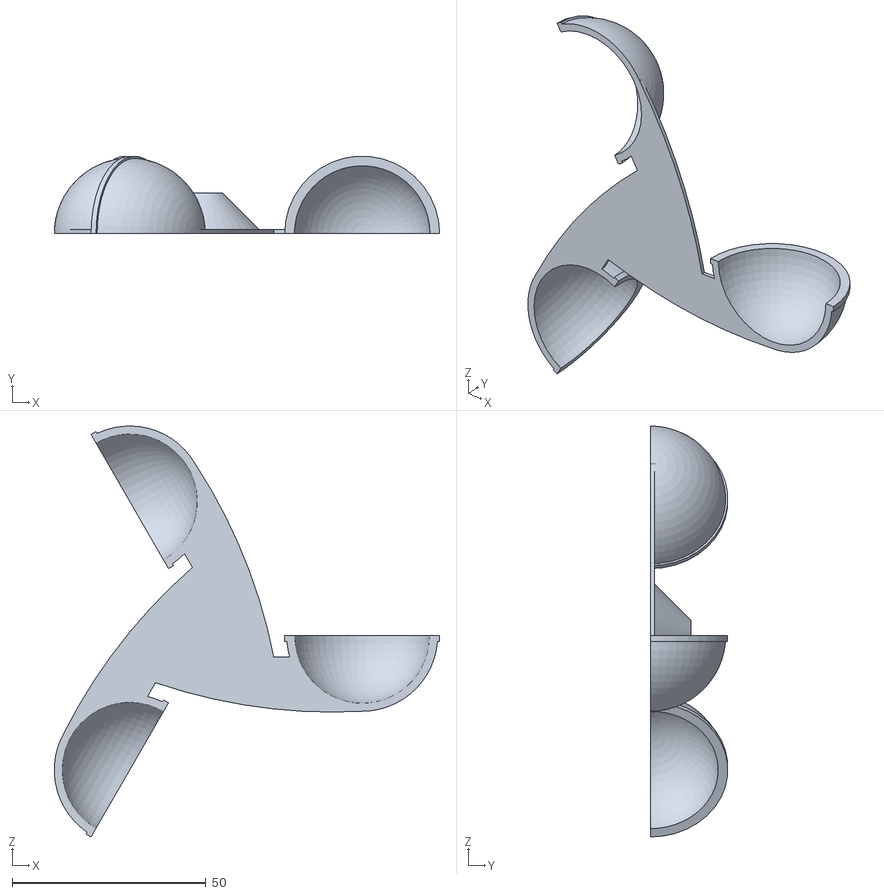
[picture p82: CAD file, 2026-10-16]
hardware/3d-models/Anemometer DC motor - 3648443/files/fan_top.STL
99.5 x 19.9 x 106.1
