SARAHXL1/Expo2023-HABOOB/hardware/3d-models/هبوب - ملفات STL - الإصدار B.2/HB-130_adapter.stl

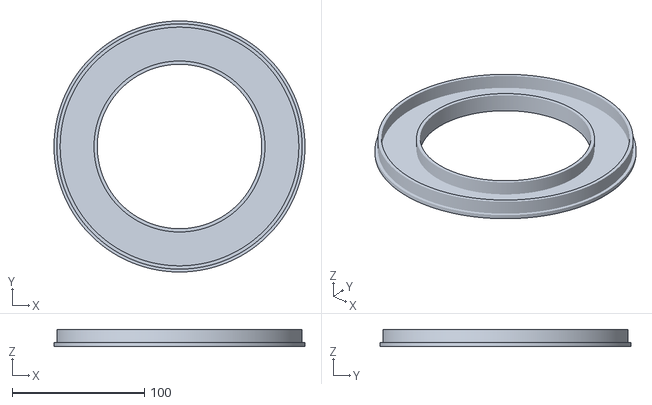
[picture p83: CAD file, 2026-10-16]
hardware/3d-models/هبوب - ملفات STL - الإصدار B.2/HB-130_adapter.stl
190.0 x 190.0 x 13.0
