SARAHXL1/Expo2023-HABOOB/hardware/3d-models/هبوب - ملفات STL - الإصدار B.2/HB-140_deco_cylinder_PRINT_UPSIDE_DOWN.stl

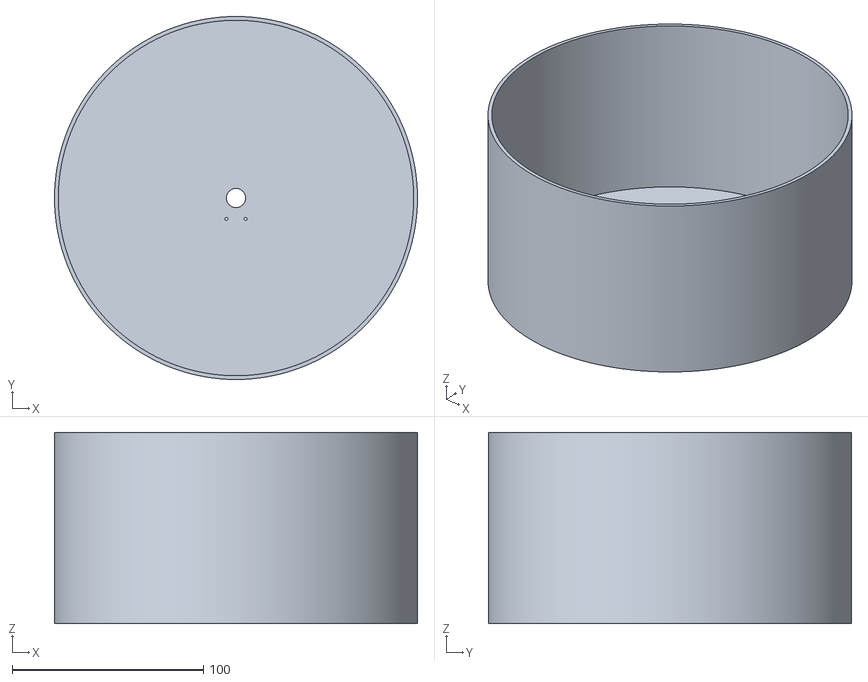
[picture p84: CAD file, 2026-10-16]
hardware/3d-models/هبوب - ملفات STL - الإصدار B.2/HB-140_deco_cylinder_PRINT_UPSIDE_DOWN.stl
190.0 x 190.0 x 100.0
