SARAHXL1/Expo2023-HABOOB/(list of files, cad)

Other CAD files:
hardware/3d-models/حساس الرياح.gcode.3mf
hardware/3d-models/هبوب - ملفات الطباعة B.4/4 - حساس الرياح/HB-104 قاعدة المحرك.3mf
hardware/3d-models/هبوب - ملفات الطباعة B.4/هبوب - شبك التهوية وتعديل حساس الرياح/2 - حساس الرياح/HB-200 مجموعة الكؤوس - ثقب 2 المقترح.3mf
hardware/3d-models/HB-200 مجموعة الكؤوس - ثقب 2.15.3mf
hardware/3d-models/هبوب - ملفات STL - الإصدار B.2/HB-193_test_ring_big_male.stl
hardware/3d-models/هبوب - ملفات الطباعة B.4/4 - حساس الرياح/HB-200 مجموعة الكؤوس - قطعة واحدة.3mf
hardware/3d-models/HB-200 مجموعة الكؤوس - ثقب 2.6.3mf
hardware/3d-models/هبوب - شبك التهوية وتعديل حساس الرياح/2 - حساس الرياح/HB-200 مجموعة الكؤوس - ثقب 3 الأوسع.3mf
hardware/3d-models/هبوب - ملفات STL - الإصدار B.2/HB-194_test_ring_big_female.stl
hardware/3d-models/هبوب - شبك التهوية وتعديل حساس الرياح/2 - حساس الرياح/HB-200 مجموعة الكؤوس - ثقب 2 المقترح.3mf
hardware/3d-models/هبوب - ملفات الطباعة B.4/1 - حلقات اختبار الخلوص (اطبعها أولًا)/HB-191 حلقة اختبار ذكر صغيرة.3mf
hardware/3d-models/هبوب - ملفات الطباعة B.4/هبوب - شبك التهوية وتعديل حساس الرياح/2 - حساس الرياح/HB-200 مجموعة الكؤوس - ثقب 3 الأوسع.3mf
hardware/3d-models/هبوب - ملفات STL - الإصدار B.2/HB-110_sensor_bay.stl
hardware/3d-models/هبوب - ملفات STL - الإصدار B.2/HB-120_column.stl
hardware/3d-models/هبوب - ملفات STL - الإصدار B.2/HB-192_test_ring_small_female.stl
hardware/3d-models/هبوب - شبك التهوية وتعديل حساس الرياح/STL/1 - شبك فتحات التهوية/HB-111 شبك فتحة تهوية طويلة.stl
hardware/3d-models/هبوب - شبك التهوية وتعديل حساس الرياح/STL/1 - شبك فتحات التهوية/HB-112 شبك فتحة تهوية قصيرة.stl
hardware/3d-models/هبوب - شبك التهوية وتعديل حساس الرياح/STL/2 - حساس الرياح/HB-195 قطعة اختبار ثقب عمود الموتور.stl
hardware/3d-models/هبوب - شبك التهوية وتعديل حساس الرياح/STL/2 - حساس الرياح/HB-200 مجموعة الكؤوس - ثقب 1 الأضيق.stl
hardware/3d-models/هبوب - شبك التهوية وتعديل حساس الرياح/STL/2 - حساس الرياح/HB-200 مجموعة الكؤوس - ثقب 2 المقترح.stl
hardware/3d-models/هبوب - شبك التهوية وتعديل حساس الرياح/STL/2 - حساس الرياح/HB-200 مجموعة الكؤوس - ثقب 3 الأوسع.stl
hardware/3d-models/هبوب - ملفات الطباعة B.4/STL/1 - حلقات اختبار الخلوص (اطبعها أولًا)/HB-191 حلقة اختبار ذكر صغيرة.stl
hardware/3d-models/هبوب - ملفات الطباعة B.4/STL/1 - حلقات اختبار الخلوص (اطبعها أولًا)/HB-192 حلقة اختبار أنثى صغيرة.stl
hardware/3d-models/هبوب - ملفات الطباعة B.4/STL/1 - حلقات اختبار الخلوص (اطبعها أولًا)/HB-193 حلقة اختبار ذكر كبيرة.stl
hardware/3d-models/هبوب - ملفات الطباعة B.4/STL/1 - حلقات اختبار الخلوص (اطبعها أولًا)/HB-194 حلقة اختبار أنثى كبيرة.stl
hardware/3d-models/هبوب - ملفات الطباعة B.4/STL/2 - الهيكل/HB-110 حجرة الحساسات.stl
hardware/3d-models/هبوب - ملفات الطباعة B.4/STL/2 - الهيكل/HB-120 العمود.stl
hardware/3d-models/هبوب - ملفات الطباعة B.4/STL/2 - الهيكل/HB-130 الوصلة الكبيرة.stl
hardware/3d-models/هبوب - ملفات الطباعة B.4/STL/4 - حساس الرياح/HB-104 قاعدة المحرك.stl
hardware/3d-models/هبوب - ملفات الطباعة B.4/STL/4 - حساس الرياح/HB-200 مجموعة الكؤوس - قطعة واحدة.stl
hardware/3d-models/هبوب - ملفات الطباعة B.4/هبوب - شبك التهوية وتعديل حساس الرياح/STL/1 - شبك فتحات التهوية/HB-111 شبك فتحة تهوية طويلة.stl
hardware/3d-models/هبوب - ملفات الطباعة B.4/هبوب - شبك التهوية وتعديل حساس الرياح/STL/1 - شبك فتحات التهوية/HB-112 شبك فتحة تهوية قصيرة.stl
hardware/3d-models/هبوب - ملفات الطباعة B.4/هبوب - شبك التهوية وتعديل حساس الرياح/STL/2 - حساس الرياح/HB-195 قطعة اختبار ثقب عمود الموتور.stl
hardware/3d-models/هبوب - ملفات الطباعة B.4/هبوب - شبك التهوية وتعديل حساس الرياح/STL/2 - حساس الرياح/HB-200 مجموعة الكؤوس - ثقب 1 الأضيق.stl
hardware/3d-models/هبوب - ملفات الطباعة B.4/هبوب - شبك التهوية وتعديل حساس الرياح/STL/2 - حساس الرياح/HB-200 مجموعة الكؤوس - ثقب 2 المقترح.stl
hardware/3d-models/هبوب - ملفات الطباعة B.4/هبوب - شبك التهوية وتعديل حساس الرياح/STL/2 - حساس الرياح/HB-200 مجموعة الكؤوس - ثقب 3 الأوسع.stl
