SARAHXL1/Expo2023-HABOOB/hardware/3d-models/هبوب - الرسومات الهندسية - الإصدار B.2.pdf

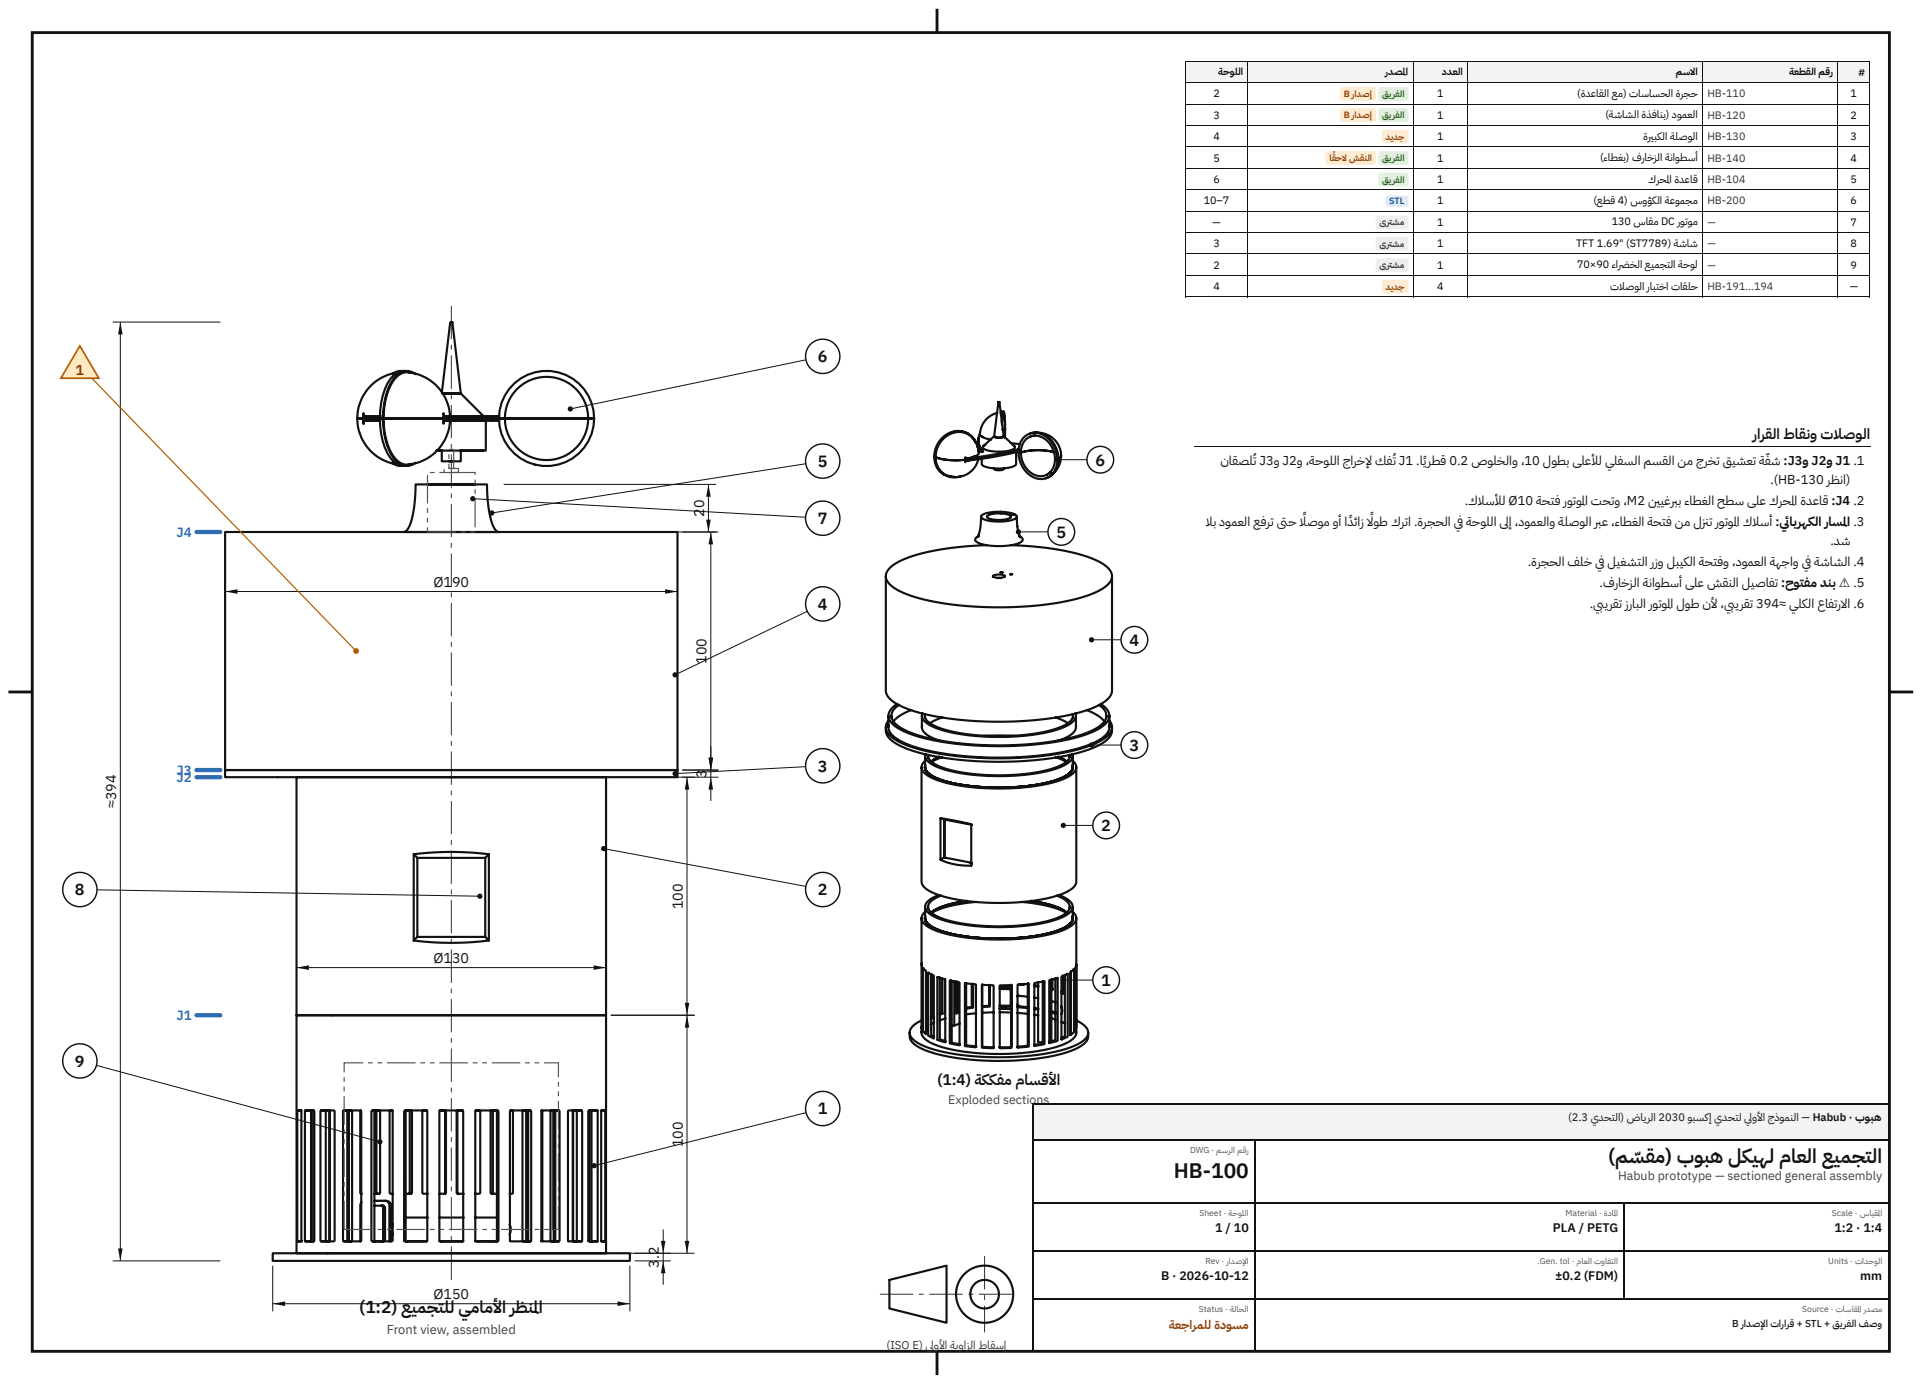
[picture p86: page 1]
األقسام مفككة )1:4( Exploded sections; الوصالت ونقاط القرار; .1 لصقان; 1J و2J و3J: شّف )انظر -130HB).

# رقم القطعة االسم العدد املصدر اللوحة
1 -110HB حجرة الحساسات )مع القاعدة( 1 الفريق إصدار B 2
2 -120HB العمود )بنافذة الشاشة( 1 الفريق إصدار B 3
3 -130HB الوصلة الكبرية 1 جديد 4
ًق الفريق النقش الحًق 5 | 4 -140HB أسطوانة الزخارف )بغطاء( 1 ا
5 -104HB قاعدة املحرك 1 الفريق 6
7 — موتور DC مقاس 130 1 مشرتى — 6 -200HB مجموعة الكؤوس )4 قطع( 1 STL 7–10

8 — شاشة (7789ST" (1.69 TFT 1 مشرتى 3
9 — لوحة التجميع الخرضاء 90×70 1 مشرتى 2
— 194...-191HB حلقات اختبار الوصالت 4 جديد 4

فك إلخراج اللوحة، و2J و3J ُت

ة تعشيق تخرج من القسم السفلي لألعلى بطول ،10 والخلوص 0.2 قطرًيا. 1J ُت

.2 4J: قاعدة املحرك على سطح الغطاء بربغيني 2M، وتحت املوتور فتحة 10Ø لألسالك.

.3 حىت ترفع العمود بال

زائًدا أو موصاًل

املسار الكهربايئ: أسالك املوتور تزنل من فتحة الغطاء، عرب الوصلة والعمود، إىل اللوحة يف الحجرة. اترك طواًل

.4 الشاشة يف واجهة العمود، وفتحة الكيبل وزر التشغيل يف خلف الحجرة.

.5 ⚠ بند مفتوح: تفاصيل النقش على أسطوانة الزخارف.
.6 االرتفاع الكلي ≈394 تقرييب، ألن طول املوتور البارز تقرييب.

هبوب · Habub — النموذج األويل لتحدي إكسبو 2030 الرياض )التحدي 2.3(

-100HB رقم الرسم · DWG | التجميع العام لهيكل هبوب )مقّسم( Habub prototype — sectioned general assembly

10 / 1 اللوحة · Sheet | Material · املادة PLA / PETG | 1:4 · 1:2 املقياس · Scale

Rev · اإلصدار B · 2026-10-12 | .Gen. tol · العام التفاوت ±0.2) FDM) | Units · الوحدات mm

املنظر األمامي للتجميع )1:2(
Front view, assembled

مسودة للمراجعة الحالة · Status | وصف الفريق + STL + قرارات اإلصدار B مصدر املقاسات · Source

إسقاط الزاوية األوىل )E ISO)

D

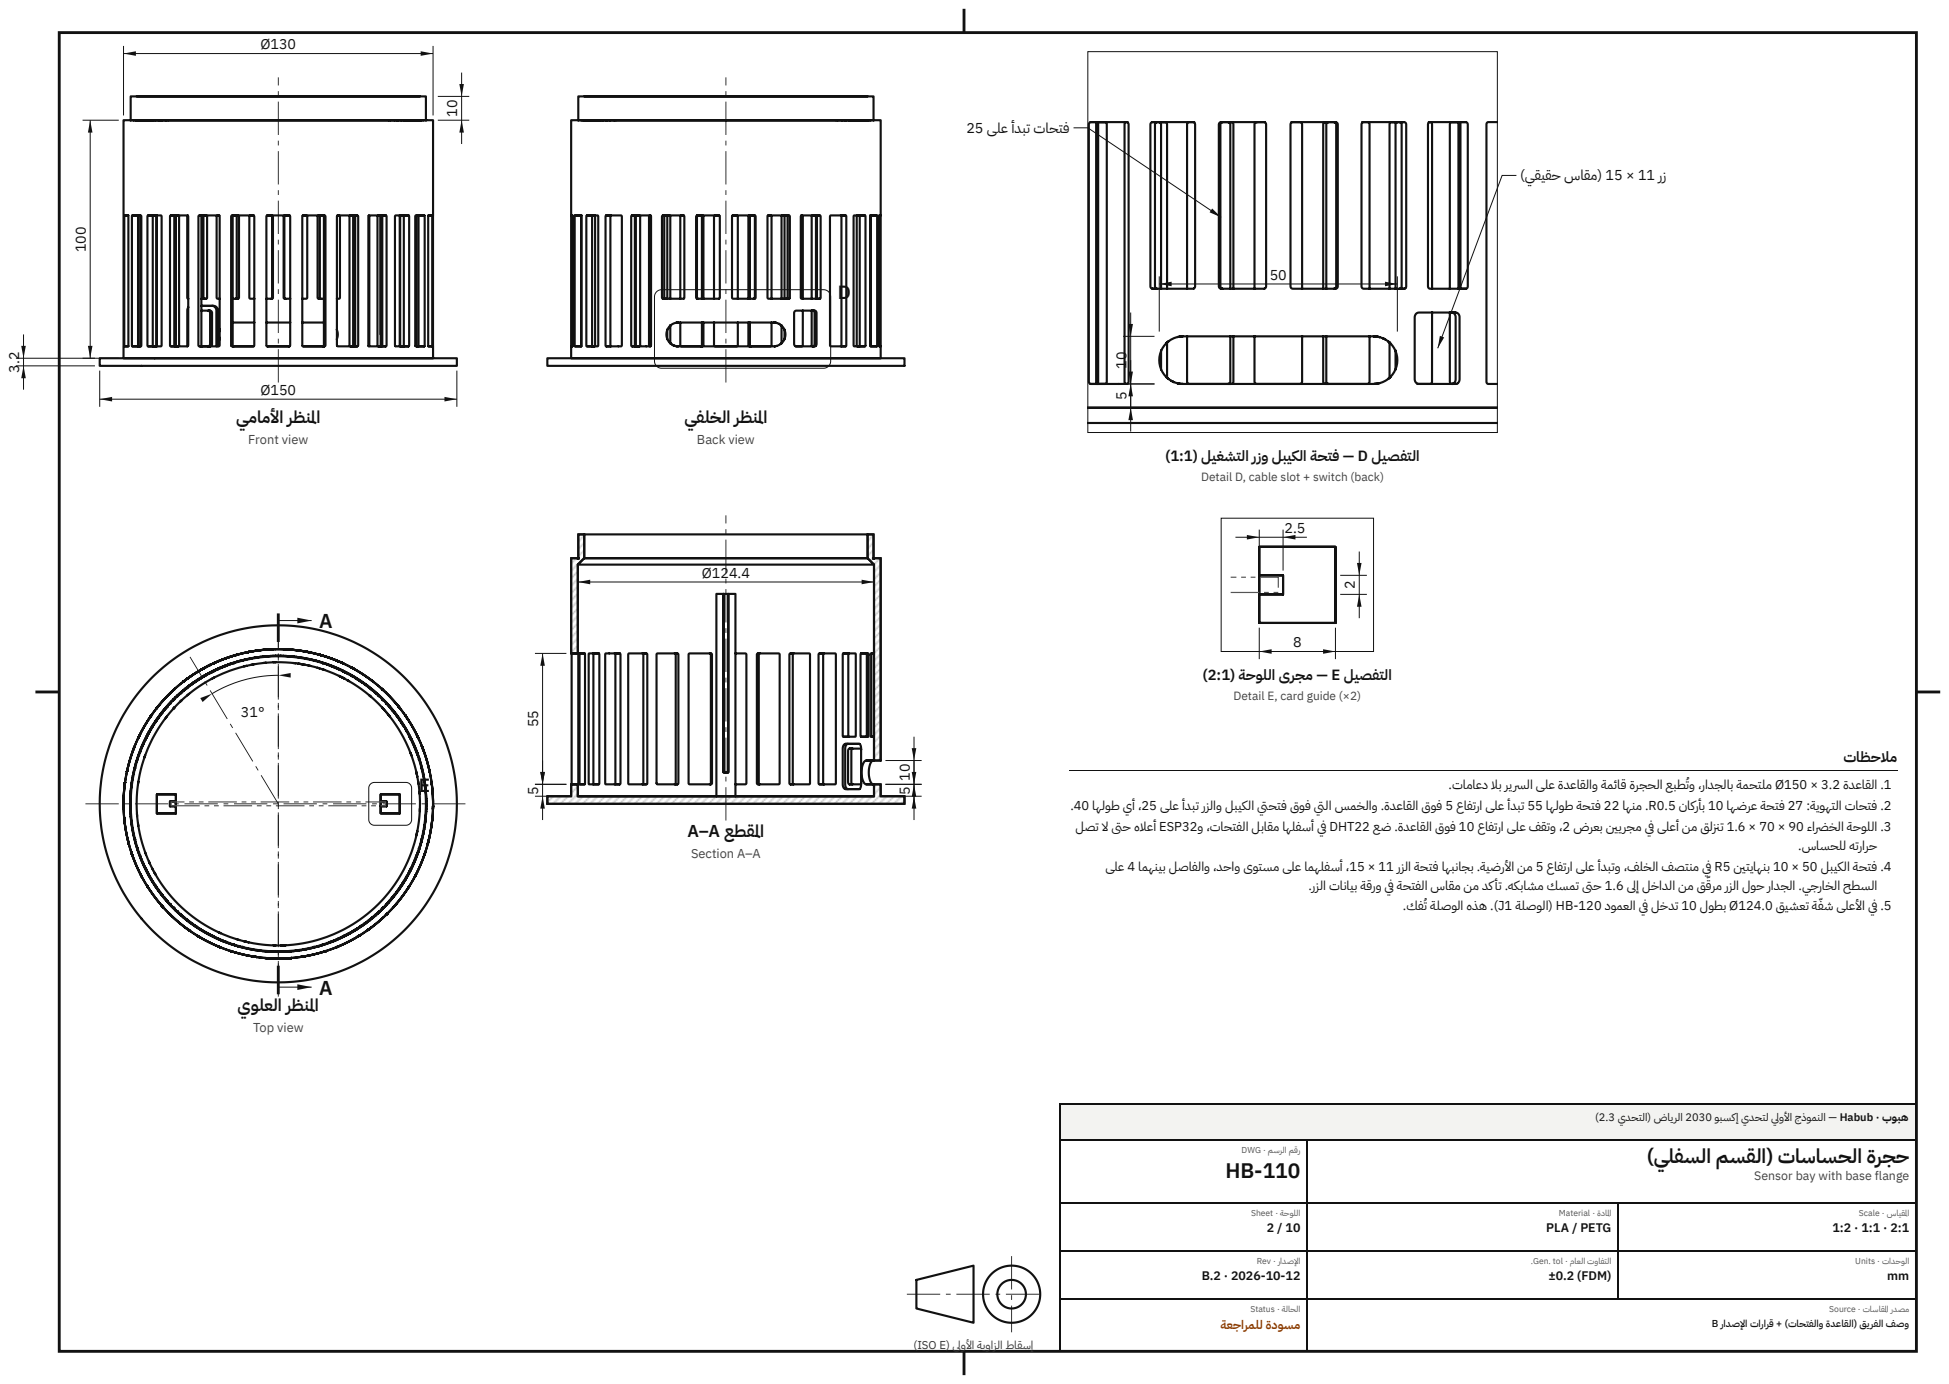
[picture p87: page 2]
املنظر األمامي; Front view; املنظر الخلفي; Back view; املنظر العلوي; Top view; املقطع; Section A–A; مالحظات; .4 فتحة الكيبل 50 × 10 بنهايتني 5R يف منتصف الخلف، وتبدأ على ارتفاع 5 من األرضية. بجانبها فتحة الزر 11 × ،15 أسفلهما على مستوى واحد، والفاصل بينهما 4 على; حرارته للحساس.; يف األعلى شّف

فتحات تبدأ على 25

زر 11 × 15 )مقاس حقيقي(

التفصيل D — فتحة الكيبل وزر التشغيل )1:1(
Detail D, cable slot + switch (back)

التفصيل E — مجرى اللوحة )2:1(
Detail E, card guide (×2)

.1 طبع الحجرة قائمة والقاعدة على الرسير بال دعامات.

القاعدة 3.2 × 150Ø ملتحمة بالجدار، وُت

.2 فتحات التهوية: 27 فتحة عرضها 10 بأركان 0.5R. منها 22 فتحة طولها 55 تبدأ على ارتفاع 5 فوق القاعدة. والخمس اليت فوق فتحيت الكيبل والزر تبدأ على ،25 أي طولها .40
.3 اللوحة الخرضاء 90 × 70 × 1.6 تزنلق من أعلى يف مجريني بعرض ،2 وتقف على ارتفاع 10 فوق القاعدة. ضع 22DHT يف أسفلها مقابل الفتحات، و32ESP أعاله حىت ال تصل

ق من الداخل إىل 1.6 حىت تمسك مشابكه. تأكد من مقاس الفتحة يف ورقة بيانات الزر.

السطح الخارجي. الجدار حول الزر مرّق

ة تعشيق 124.0Ø بطول 10 تدخل يف العمود -120HB( الوصلة 1J). هذه الوصلة ُت

هبوب · Habub — النموذج األويل لتحدي إكسبو 2030 الرياض )التحدي 2.3(

-110HB رقم الرسم · DWG | حجرة الحساسات )القسم السفلي( Sensor bay with base flange

10 / 2 اللوحة · Sheet | Material · املادة PLA / PETG | 2:1 · 1:1 · 1:2 املقياس · Scale

Rev · اإلصدار B.2 · 2026-10-12 | .Gen. tol · العام التفاوت ±0.2) FDM) | Units · الوحدات mm

وصف الفريق )القاعدة والفتحات( + قرارات اإلصدار B مصدر املقاسات · Source

B

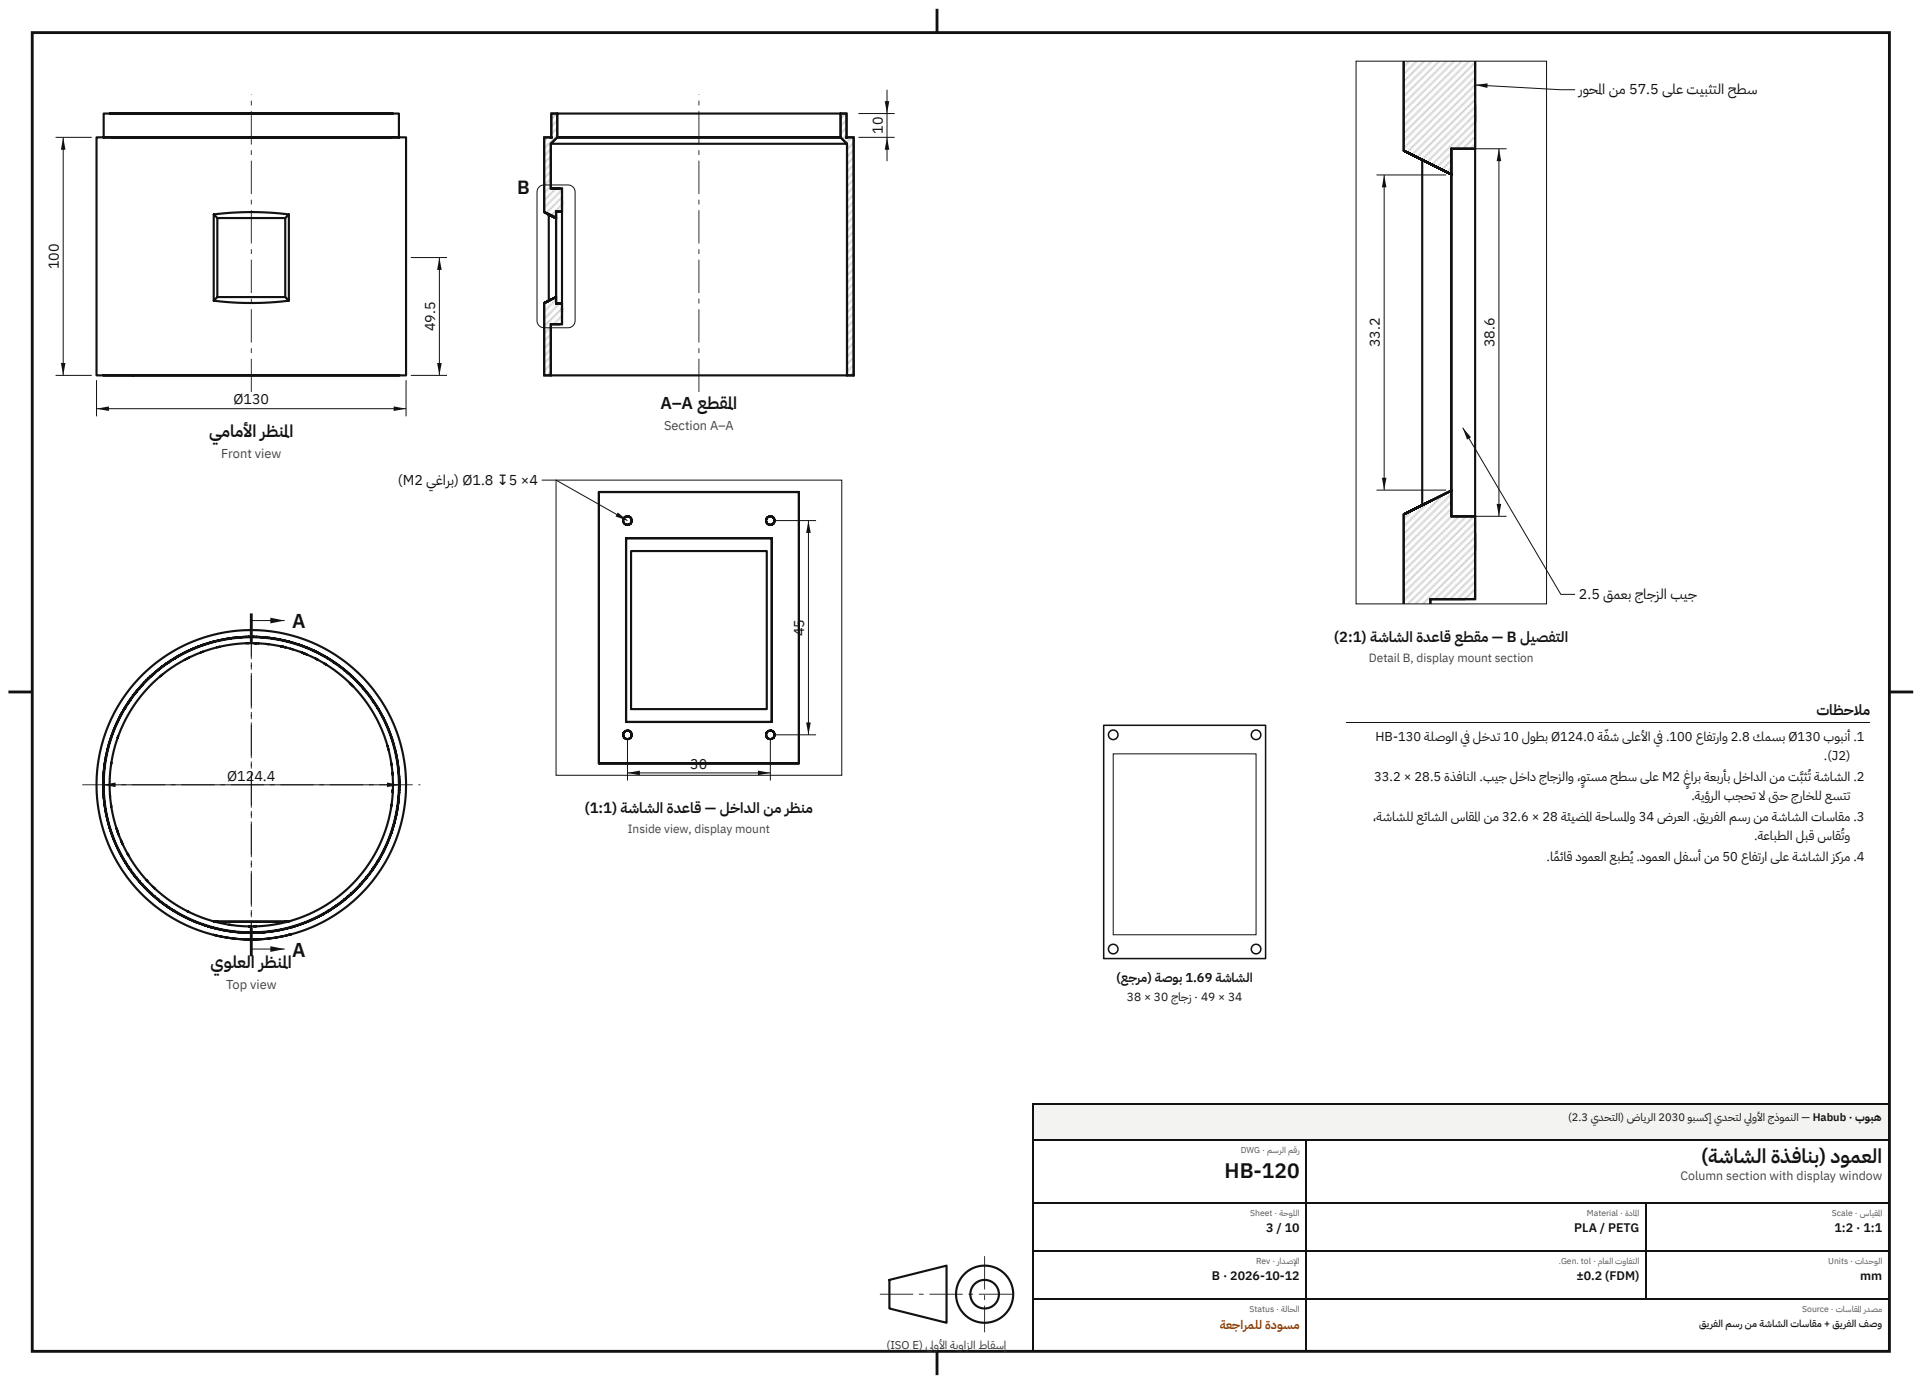
[picture p88: page 3]
املنظر األمامي; Front view; املقطع; Section A–A; املنظر العلوي; Top view; براغي; مالحظات; الشاشة ُت

سطح التثبيت على 57.5 من املحور

جيب الزجاج بعمق 2.5

التفصيل B — مقطع قاعدة الشاشة )2:1(
Detail B, display mount section

.1 ة 124.0Ø بطول 10 تدخل يف الوصلة -130HB

أنبوب 130Ø بسمك 2.8 وارتفاع .100 يف األعلى شّف

.2 ، والزجاج داخل جيب. النافذة 28.5 × 33.2

2M على سطح مست

ثَّبت من الداخل بأربعة برا

منظر من الداخل — قاعدة الشاشة )1:1(
Inside view, display mount

تتسع للخارج حىت ال تحجب الرؤية.

.3 مقاسات الشاشة من رسم الفريق. العرض 34 واملساحة املضيئة 28 × 32.6 من املقاس الشائع للشاشة،

قاس قبل الطباعة.

.4 مركز الشاشة على ارتفاع 50 من أسفل العمود. ُيطبع العمود قائًما.

الشاشة 1.69 بوصة )مرجع(
34 × 49 · زجاج 30 × 38

هبوب · Habub — النموذج األويل لتحدي إكسبو 2030 الرياض )التحدي 2.3(

-120HB رقم الرسم · DWG | العمود )بنافذة الشاشة( Column section with display window

10 / 3 اللوحة · Sheet | Material · املادة PLA / PETG | 1:1 · 1:2 املقياس · Scale

Rev · اإلصدار B · 2026-10-12 | .Gen. tol · العام التفاوت ±0.2) FDM) | Units · الوحدات mm

وصف الفريق + مقاسات الشاشة من رسم الفريق مصدر املقاسات · Source

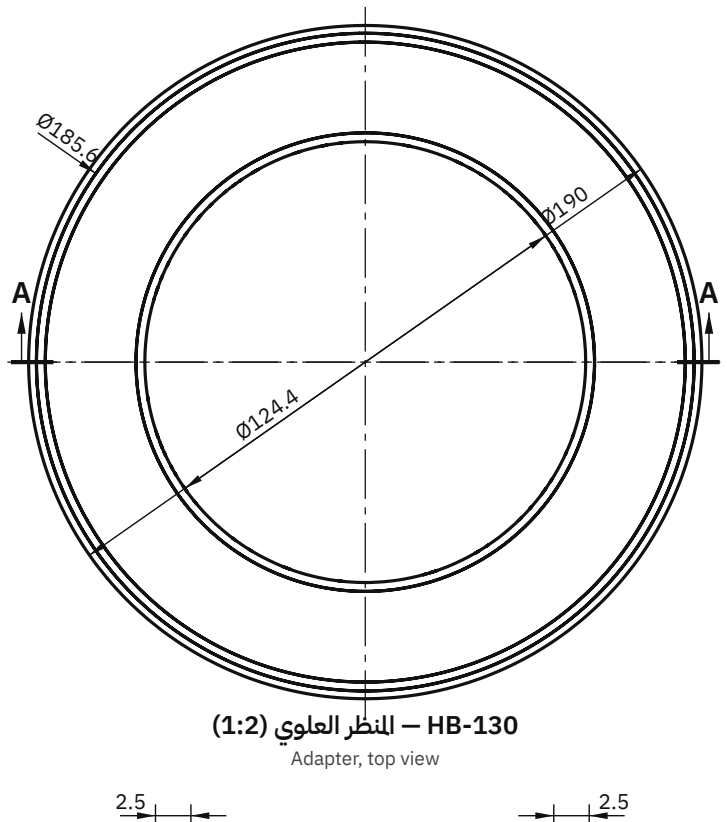
[picture p89: figure]
-130HB — املنظر العلوي )1:2(; Adapter, top view

3

10

32.8

A–A (2:1) | نصفي | مقطع | — HB-130
Adapter half-section

2.5

0.2

10

حافة دعم °45

ة العمود )4:1(
2J / 1J — شّف
Column spigot joint (same at J2 into HB-130)

0.2

10

## 3J — الوصلة داخل أسطوانة الزخارف )4:1(

Adapter lip into decorated cylinder

| | الرقم حلقة االختبار املقاس تخترب
ّف 130Ø / شّف 1J و2J | ّف ذكر صغري: جدار 8 + حافة دعم + شّف ة 124.0Ø | -191HB ة 10
| | -192HB أنىث صغرية: جدار عمود بطول 15 124.4Ø / 130Ø 1J و2J
ّف 190Ø / شّف 3J | ّف ذكر كبري: قرص 3 + شّف ة 185.6Ø | -193HB ة 10
| | -194HB أنىث كبرية: جدار أسطوانة بطول 15 186Ø / 190Ø 3J

طريقة ضبط الوصالت بحلقات االختبار

.1 مقارنة باألقسام.

ا قلياًل

### اطبع الحلقات األربع بنفس الطابعة والخامة وإعدادات األقسام. تأخذ وقًت

.2 أدخل كل ذكر يف أنثاه. املطلوب: يدخل باليد بضغط خفيف، وال يتحرك جانبًيا.

.3 ر الخلوص إىل .0.1 ثم اطبع الحلقة مرة ثانية قبل طباعة األقسام الكبرية.

### ة 0.2(. وإذا كانت واسعة: صّغ

ر قطر الشّف

### إذا كانت ضيقة: كرّب الخلوص من 0.2 إىل 0.3 )أو صّغ

.4 لصقان بعد التأكد من األسالك.

### ة لزيادة اإلحكام. 2J و3J ُت

فك إلخراج اللوحة، ويمكن إضافة رشيط الصق رفيع حول الشّف
1J بال صمغ ألنها ُت

.5 طبع مقلوبة.

ات تخرج من القسم السفلي لألعلى، فُيطبع كل قسم يف وضع استخدامه بال دعامات، ما عدا أسطوانة الزخارف ُت

كل الشّف

هبوب · Habub — النموذج األويل لتحدي إكسبو 2030 الرياض )التحدي 2.3(

-130HB رقم الرسم · DWG | الوصلة الكبرية وتفاصيل الوصالت وحلقات االختبار Adapter (HB-130), joint details, test rings (HB-191…194)
10 / 4 اللوحة · Sheet | Material · املادة PLA / PETG | 4:1 · 1:2 املقياس · Scale
Rev · اإلصدار B · 2026-10-12 | .Gen. tol · العام التفاوت ±0.2) FDM) | Units · الوحدات mm
| مصدر املقاسات · Source قرارات اإلصدار B( مقرتح(

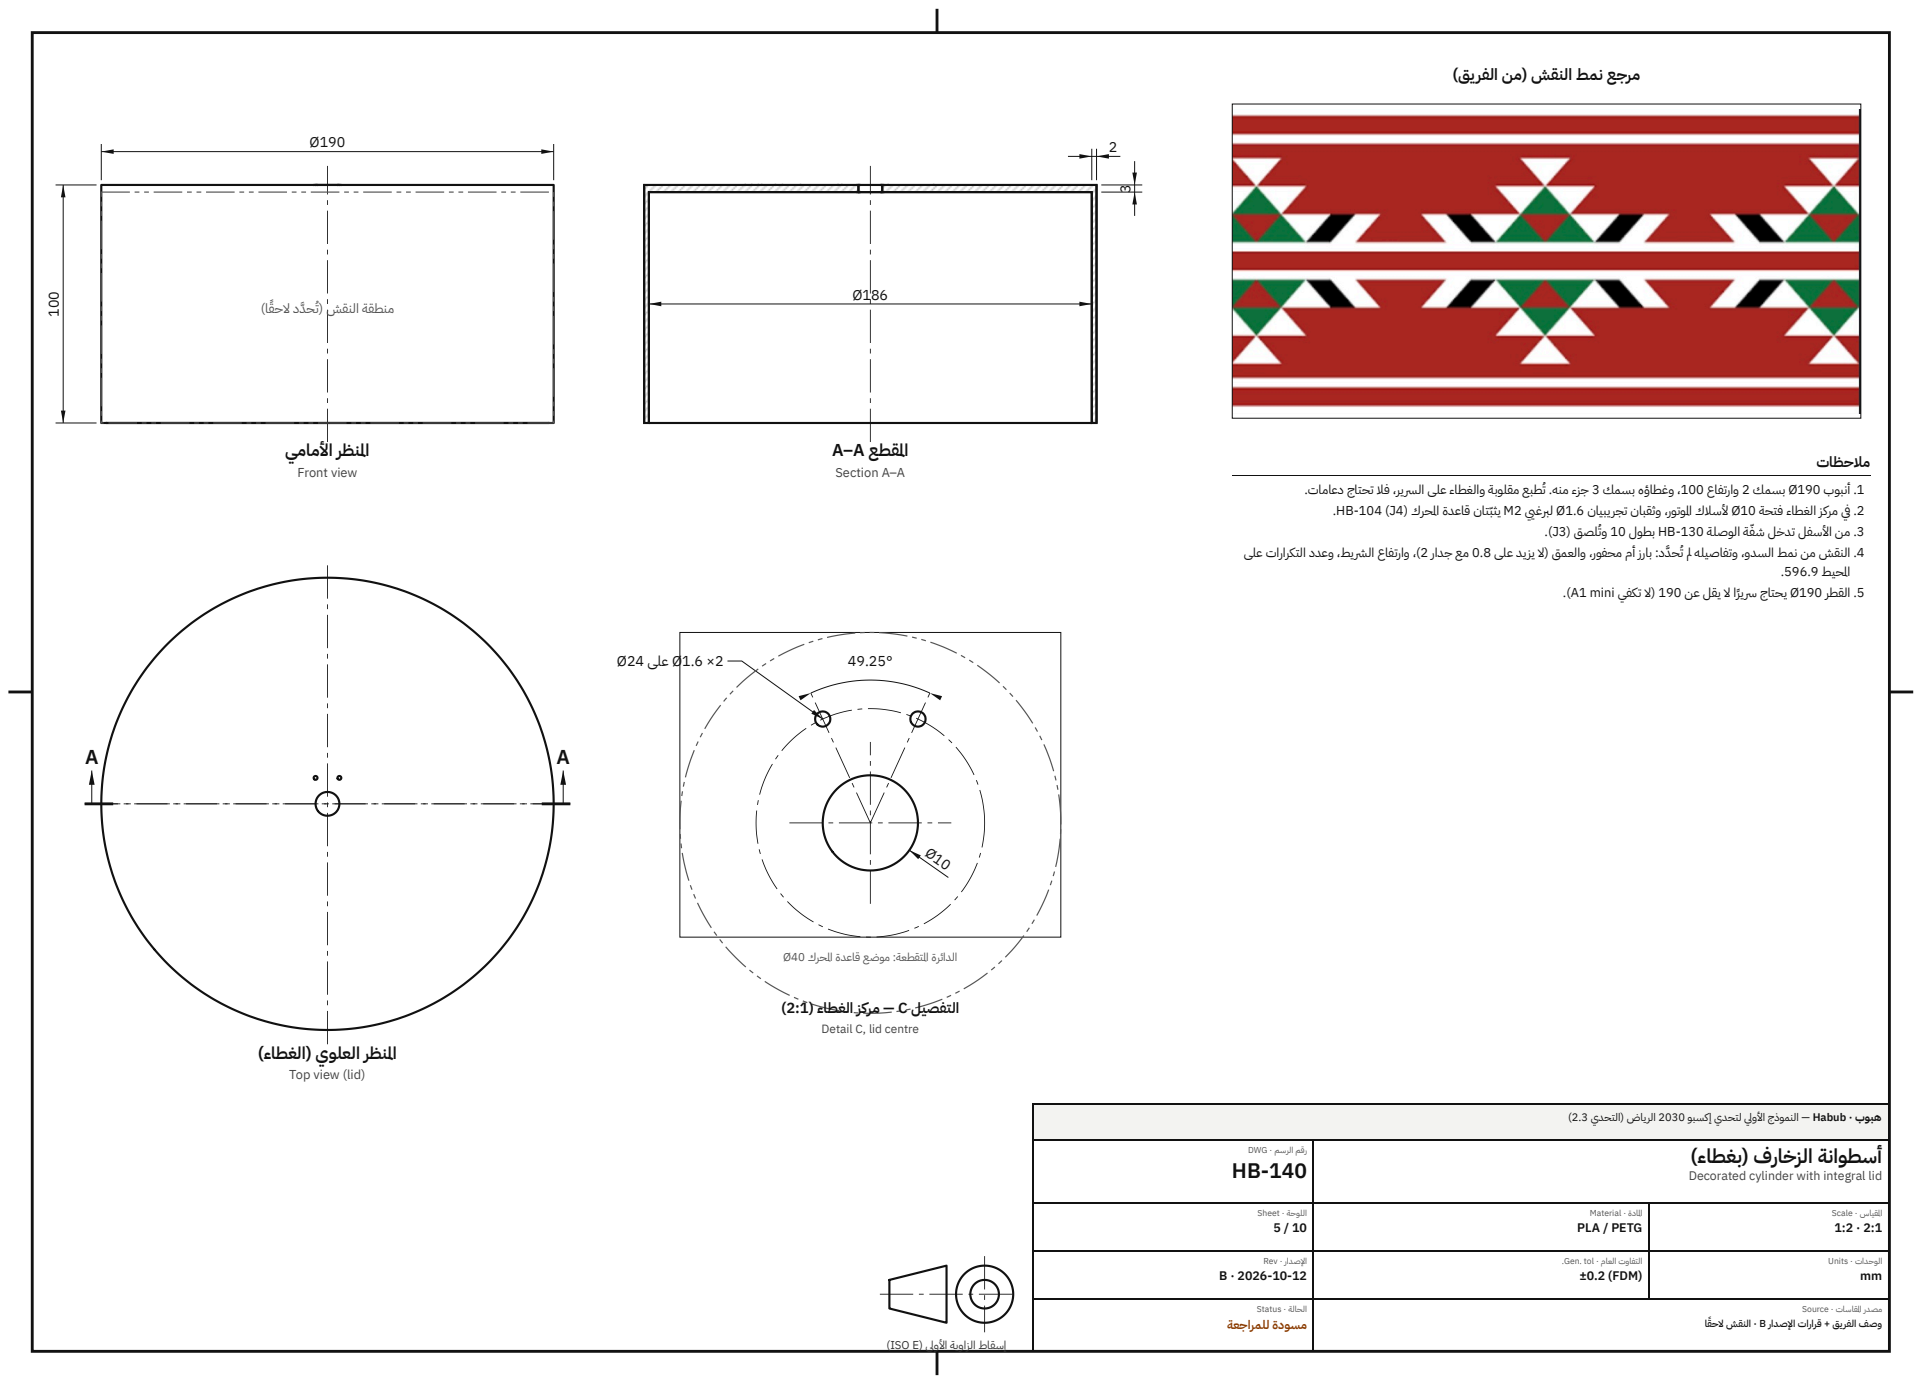
[picture p90: page 5]
املنظر األمامي; Front view; املقطع; Section A–A; Ø24 على; مالحظات; .3 لصق )3J).; ة الوصلة -130HB بطول 10 وُت; .4 حَّدد: بارز أم محفور، والعمق )ال يزيد على 0.8 مع جدار 2(، وارتفاع الرشيط، وعدد التكرارات على; من األسفل تدخل شّف; املحيط .596.9

مرجع نمط النقش )من الفريق(

منطقة النقش )ُتحَّدد الحًق

.1 طبع مقلوبة والغطاء على الرسير، فال تحتاج دعامات.
.2 يف مركز الغطاء فتحة 10Ø ألسالك املوتور، وثقبان تجريبيان 1.6Ø لربغيي 2M يثّبتان قاعدة املحرك (4J (-104HB.

أنبوب 190Ø بسمك 2 وارتفاع ،100 وغطاؤه بسمك 3 جزء منه. ُت

النقش من نمط السدو، وتفاصيله مل ُت

.5 القطر 190Ø يحتاج رسيًرا ال يقل عن 190 )ال تكفي mini 1A).

الدائرة املتقطعة: موضع قاعدة املحرك 40Ø

التفصيل C — مركز الغطاء )2:1(
Detail C, lid centre

املنظر العلوي )الغطاء(
Top view (lid)

هبوب · Habub — النموذج األويل لتحدي إكسبو 2030 الرياض )التحدي 2.3(

-140HB رقم الرسم · DWG | أسطوانة الزخارف )بغطاء( Decorated cylinder with integral lid

10 / 5 اللوحة · Sheet | Material · املادة PLA / PETG | 2:1 · 1:2 املقياس · Scale

Rev · اإلصدار B · 2026-10-12 | .Gen. tol · العام التفاوت ±0.2) FDM) | Units · الوحدات mm

وصف الفريق + قرارات اإلصدار B · النقش الحًق ا

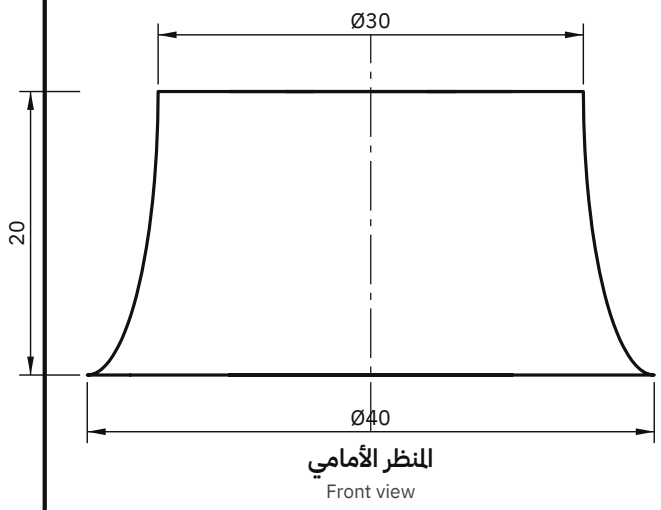
[picture p91: figure]
املنظر األمامي; Front view

نافذ 20Ø

## A–A املقطع

Section A–A

10

2× 2Ø نافذ

املقطع B–B( عرب الثقبني(
Section B–B

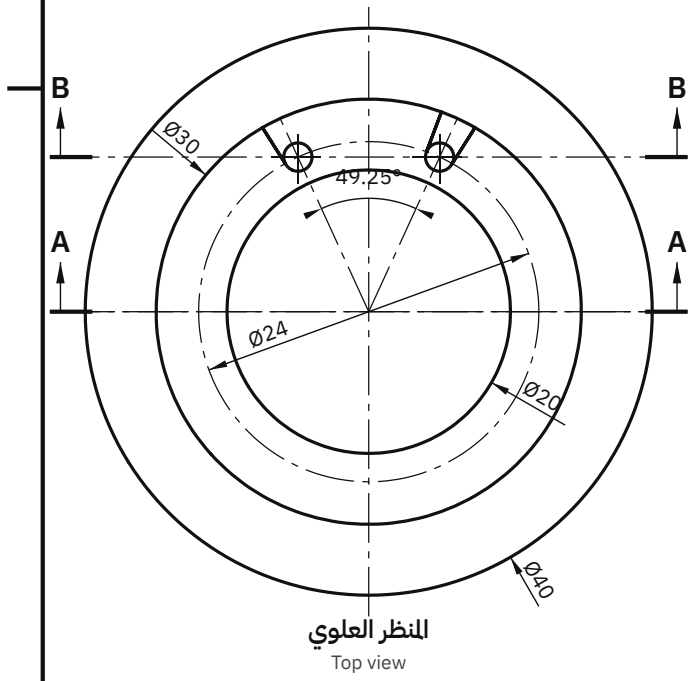
[picture p92: figure]
املنظر العلوي; Top view

مجّسم
Isometric

a = 5

b = 20

ربع قطع ناقص مقّعر

### التفصيل E — مقطع الجدار )3:1(

Detail E, wall profile

مالحظات

.1 التجويف 20Ø دائري نافذ، مطابق لفتحة STL.base املرفقة )20Ø بطول 63(. الجدار 5 عند األعلى )30Ø)، وينحين إىل 40Ø عند األسفل على كامل االرتفاع .20
.2 االنحناء ربع قطع ناقص مقّعر، محوره األفقي 5 والرأيس ،20 تفسًريا لعبارة »يكمل كمثلث ويصري كأنه انحناء«. البديل األبسط خط مستقيم )مخروط(.

.3 الثقبان 2Ø نافذان، واملسافة بني مركزيهما ،10 وحافتهما على بعد 2 من الحافة الخارجية 30Ø،
فمركزاهما على دائرة 24Ø.

.4 ُيثَّبت الجزء على سطح غطاء أسطوانة الزخارف -140HB بربغيني 2M ذاتيي القلوظة، يمران يف الثقبني إىل
ثقبني تجريبيني 1.6Ø يف الغطاء. وتحت املوتور فتحة 10Ø يف الغطاء لألسالك.
.5 املوتور يرتكز على سطح الغطاء داخل التجويف، ويربز منه قرابة 5 )طول جسم املوتور التقرييب 25(.
قاعدة املحرك | هبوب · Habub — النموذج األويل لتحدي إكسبو 2030 الرياض )التحدي 2.3(
-104HB رقم الرسم · DWG | Motor mount (130-size DC motor)
10 / 6 اللوحة · Sheet | Material · املادة PLA / PETG | 3:1 · 2:1 املقياس · Scale
Rev · اإلصدار A · 2026-10-12 | .Gen. tol · العام التفاوت ±0.2) FDM) | Units · الوحدات mm
| وصف الفريق والرسم اليدوي + افرتاضات )انظر املالحظات(

2

4

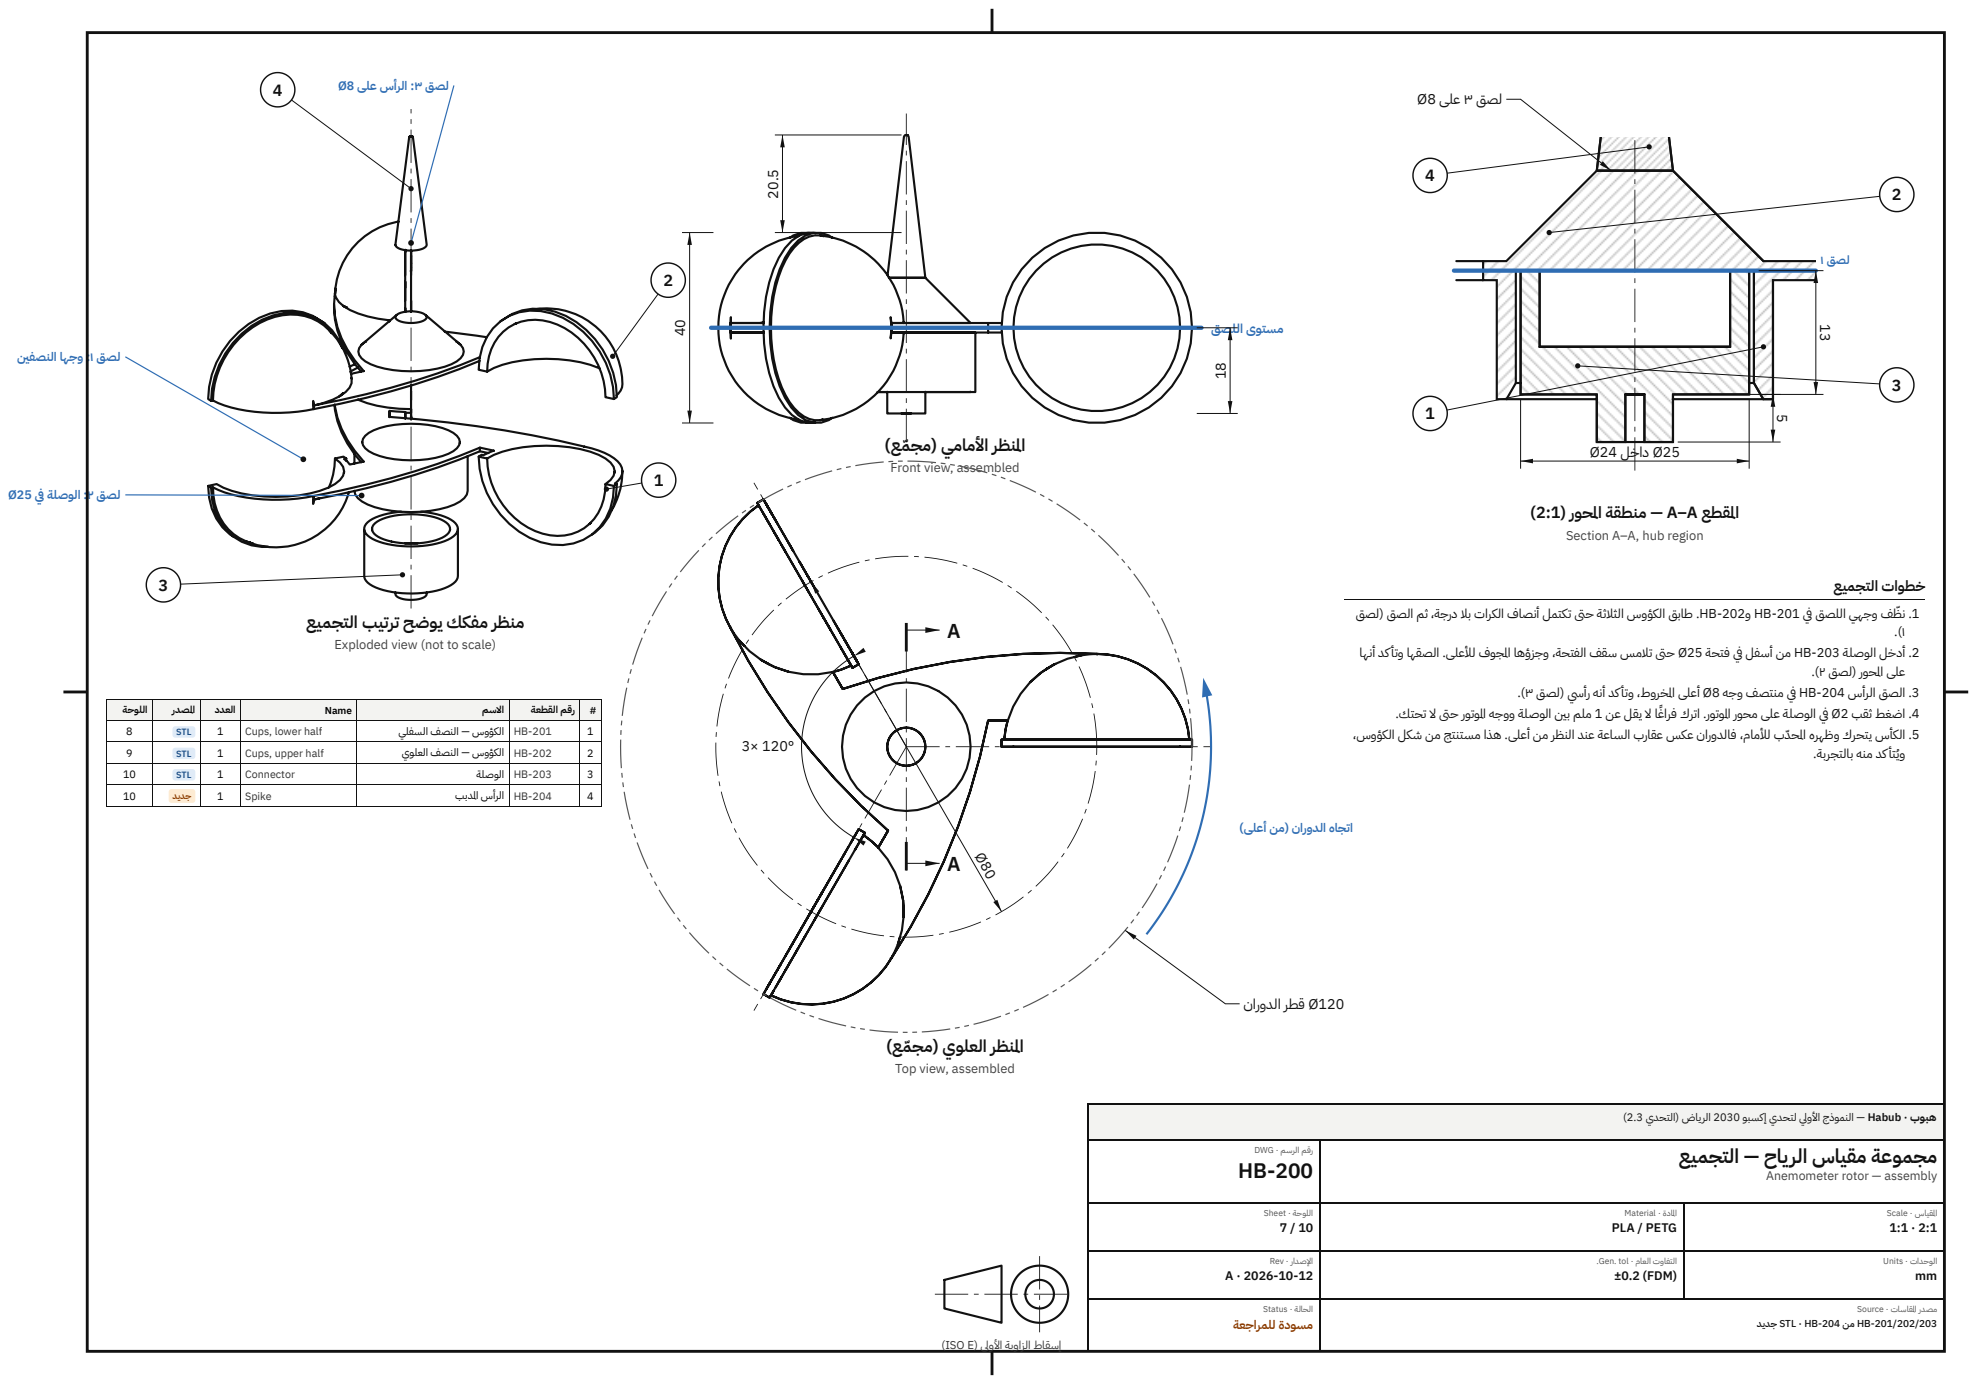
[picture p93: page 7]
0 مستوى اللصق; 120Ø قطر الدوران; لصق ١; داخل; لصق ٣ على 8Ø; خطوات التجميع

لصق :٣ الرأس على 8Ø

لصق :١ وجها النصفني

املنظر األمامي )مجّمع(
Front view, assembled

لصق :٢ الوصلة يف 25Ø

املقطع A–A — منطقة املحور )2:1(
Section A–A, hub region

نّظ .1 ف وجهي اللصق يف -201HB و-202HB. طابق الكؤوس الثالثة حىت تكتمل أنصاف الكرات بال درجة، ثم الصق )لصق

منظر مفكك يوضح ترتيب التجميع
Exploded view (not to scale)

.2 أدخل الوصلة -203HB من أسفل يف فتحة 25Ø حىت تالمس سقف الفتحة، وجزؤها املجوف لألعلى. الصقها وتأكد أنها

على املحور )لصق ٢(.

.3 الصق الرأس -204HB يف منتصف وجه 8Ø أعلى املخروط، وتأكد أنه رأيس )لصق ٣(.

# رقم القطعة االسم Name العدد املصدر اللوحة
8 | STL | 1 | Cups, lower half | السفلي النصف — الكؤوس | HB-201 | 1
9 | STL | 1 | Cups, upper half | العلوي النصف — الكؤوس | HB-202 | 2
10 | STL | 1 | Connector | الوصلة | HB-203 | 3
4 -204HB الرأس املدبب Spike 1 جديد 10

.4 ا ال يقل عن 1 ملم بني الوصلة ووجه املوتور حىت ال تحتك.
.5 الكأس يتحرك وظهره املحّدب لألمام، فالدوران عكس عقارب الساعة عند النظر من أعلى. هذا مستنتج من شكل الكؤوس،

اضغط ثقب 2Ø يف الوصلة على محور املوتور. اترك فرا

وُيتأكد منه بالتجربة.

اتجاه الدوران )من أعلى(

املنظر العلوي )مجّمع(
Top view, assembled

هبوب · Habub — النموذج األويل لتحدي إكسبو 2030 الرياض )التحدي 2.3(

-200HB رقم الرسم · DWG | مجموعة مقياس الرياح — التجميع Anemometer rotor — assembly

10 / 7 اللوحة · Sheet | Material · املادة PLA / PETG | 2:1 · 1:1 املقياس · Scale

Rev · اإلصدار A · 2026-10-12 | .Gen. tol · العام التفاوت ±0.2) FDM) | Units · الوحدات mm

-201/202/203HB من -204HB · STL جديد مصدر املقاسات · Source

## املنظر األمامي

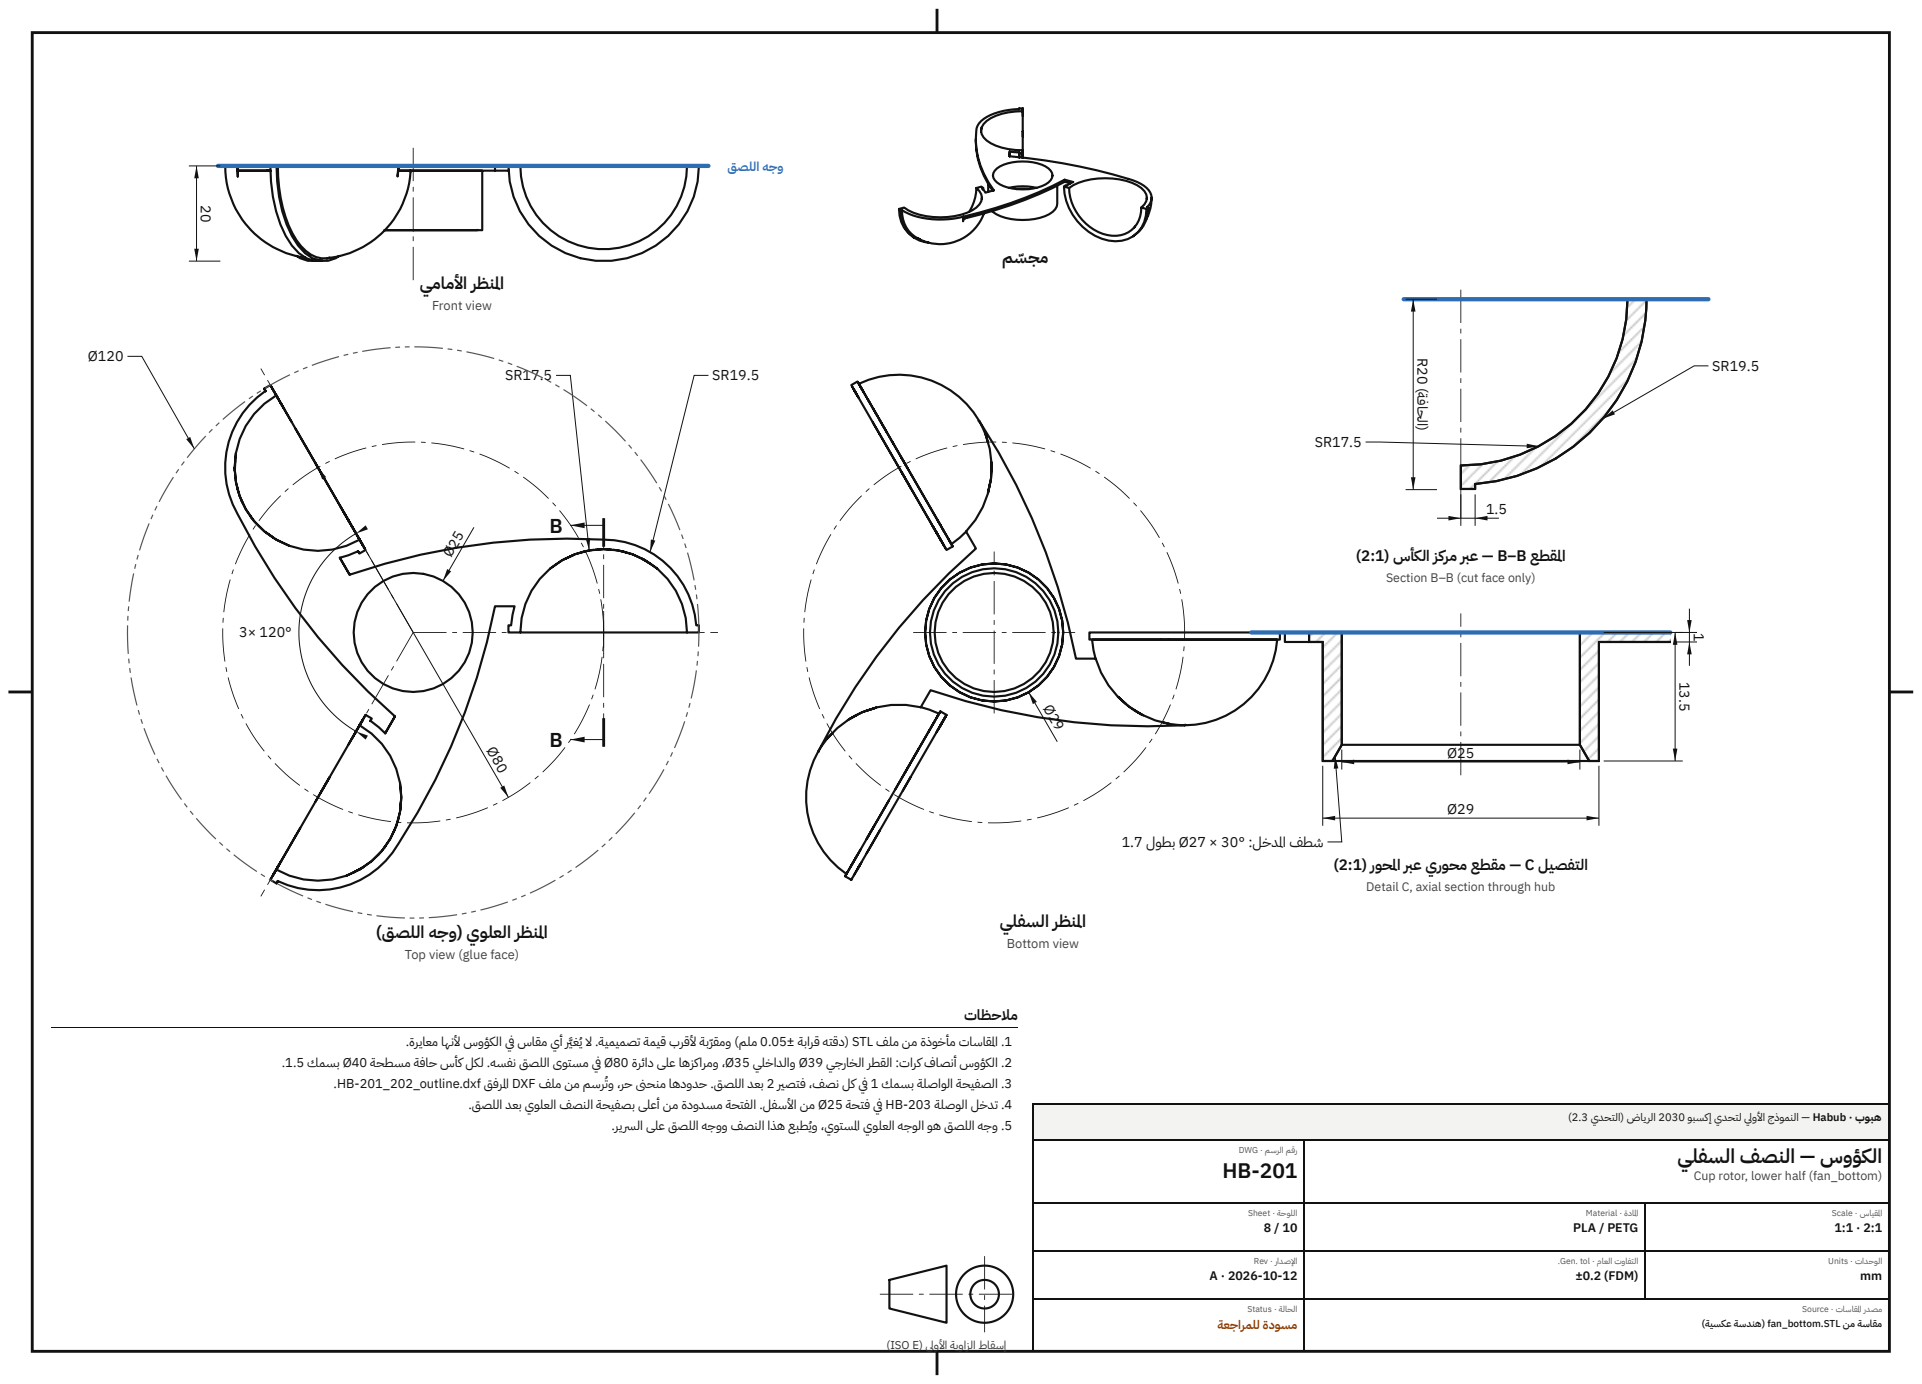
[picture p94: page 8]
وجه اللصق; Front view; املنظر السفلي; Bottom view; (الحافة) 20R; مالحظات

املقطع B–B — عرب مركز الكأس )2:1(
Section B–B (cut face only)

شطف املدخل: 30° × 27Ø بطول 1.7

التفصيل C — مقطع محوري عرب املحور )2:1(
Detail C, axial section through hub

املنظر العلوي )وجه اللصق(
Top view (glue face)

.1 املقاسات مأخوذة من ملف STL( دقته قرابة 0.05± ملم( ومقّربة ألقرب قيمة تصميمية. ال ُيغرَّي أي مقاس يف الكؤوس ألنها معايرة.

.2 الكؤوس أنصاف كرات: القطر الخارجي 39Ø والداخلي 35Ø، ومراكزها على دائرة 80Ø يف مستوى اللصق نفسه. لكل كأس حافة مسطحة 40Ø بسمك .1.5

.3 رسم من ملف DXF املرفق dxf.outline_202_-201HB.

الصفيحة الواصلة بسمك 1 يف كل نصف، فتصري 2 بعد اللصق. حدودها منحىن حر، وُت

.4 تدخل الوصلة -203HB يف فتحة 25Ø من األسفل. الفتحة مسدودة من أعلى بصفيحة النصف العلوي بعد اللصق.

.5 وجه اللصق هو الوجه العلوي املستوي، وُيطبع هذا النصف ووجه اللصق على الرسير.

هبوب · Habub — النموذج األويل لتحدي إكسبو 2030 الرياض )التحدي 2.3(

-201HB رقم الرسم · DWG | الكؤوس — النصف السفلي Cup rotor, lower half (fan_bottom)

10 / 8 اللوحة · Sheet | Material · املادة PLA / PETG | 2:1 · 1:1 املقياس · Scale

Rev · اإلصدار A · 2026-10-12 | .Gen. tol · العام التفاوت ±0.2) FDM) | Units · الوحدات mm

مقاسة من STL.bottom_fan( هندسة عكسية(

## املنظر األمامي

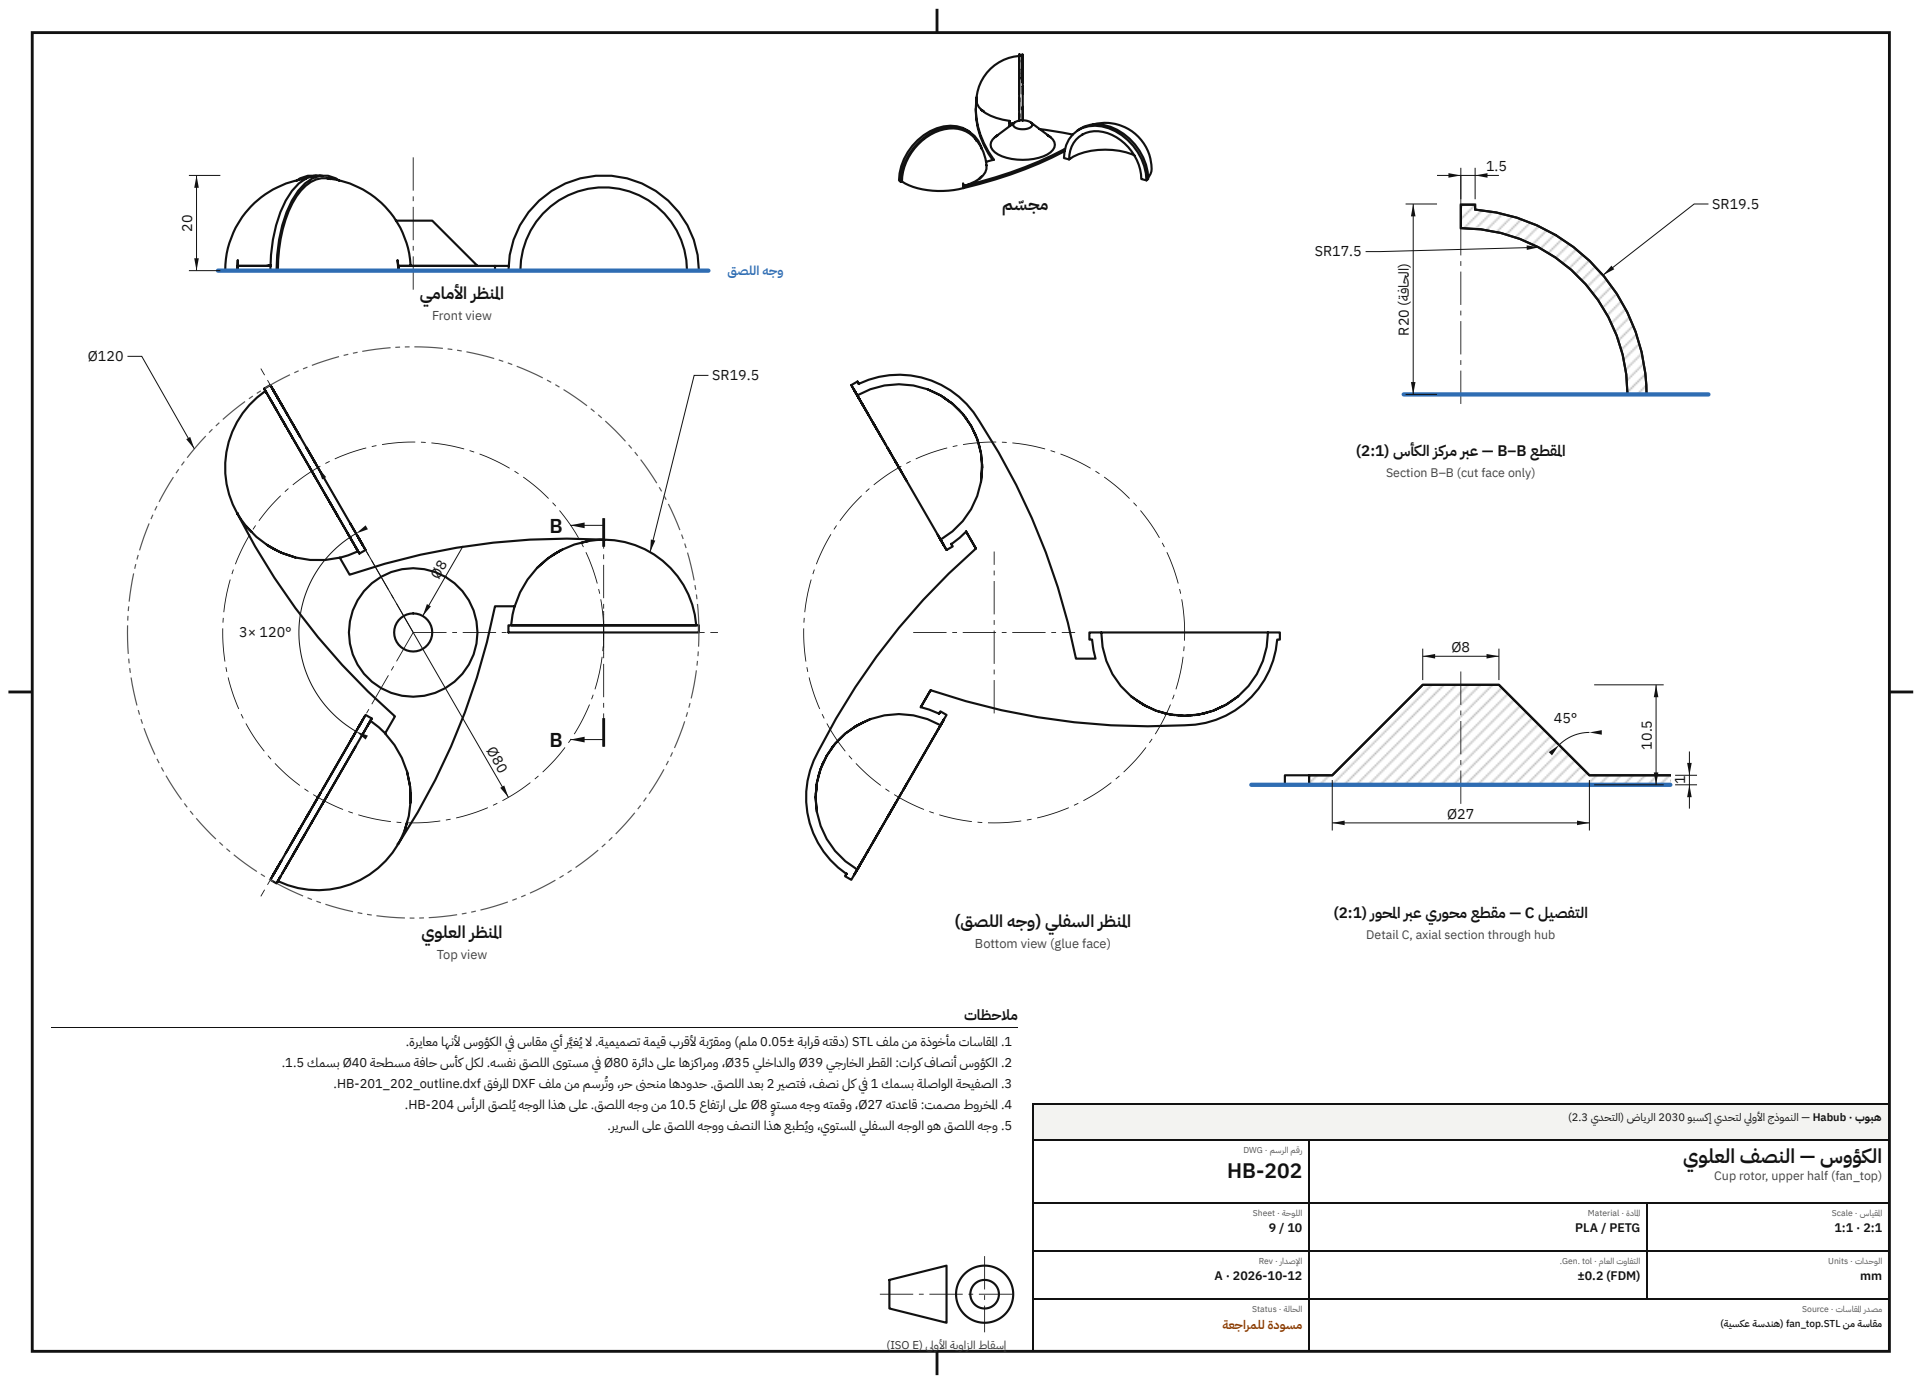
[picture p95: page 9]
وجه اللصق; Front view; املنظر العلوي; Top view; (الحافة) 20R; مالحظات

املقطع B–B — عرب مركز الكأس )2:1(
Section B–B (cut face only)

التفصيل C — مقطع محوري عرب املحور )2:1(
Detail C, axial section through hub

املنظر السفلي )وجه اللصق(
Bottom view (glue face)

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

.3 رسم من ملف DXF املرفق dxf.outline_202_-201HB.

الصفيحة الواصلة بسمك 1 يف كل نصف، فتصري 2 بعد اللصق. حدودها منحىن حر، وُت

.4 8Ø على ارتفاع 10.5 من وجه اللصق. على هذا الوجه ُيلصق الرأس -204HB.

املخروط مصمت: قاعدته 27Ø، وقمته وجه مست

.5 وجه اللصق هو الوجه السفلي املستوي، وُيطبع هذا النصف ووجه اللصق على الرسير.

هبوب · Habub — النموذج األويل لتحدي إكسبو 2030 الرياض )التحدي 2.3(

-202HB رقم الرسم · DWG | الكؤوس — النصف العلوي Cup rotor, upper half (fan_top)

10 / 9 اللوحة · Sheet | Material · املادة PLA / PETG | 2:1 · 1:1 املقياس · Scale

Rev · اإلصدار A · 2026-10-12 | .Gen. tol · العام التفاوت ±0.2) FDM) | Units · الوحدات mm

مقاسة من STL.top_fan( هندسة عكسية(

3:1 — )Connector( | الوصلة | HB-203

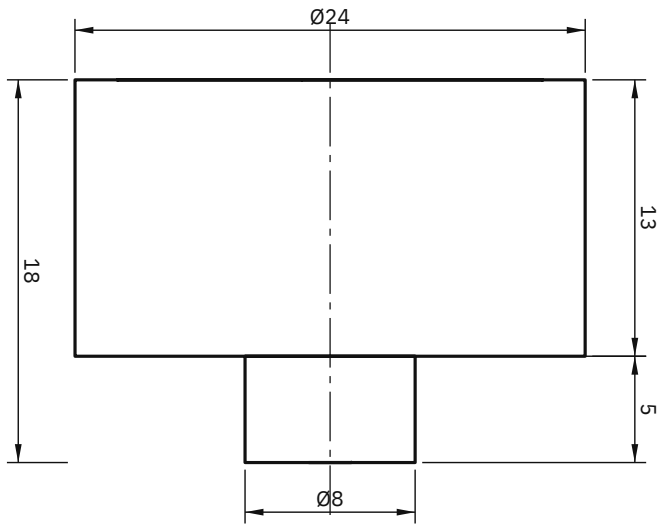
[picture p96: figure]

## املنظر األمامي

Ø20

8 5

Ø2 ↧5

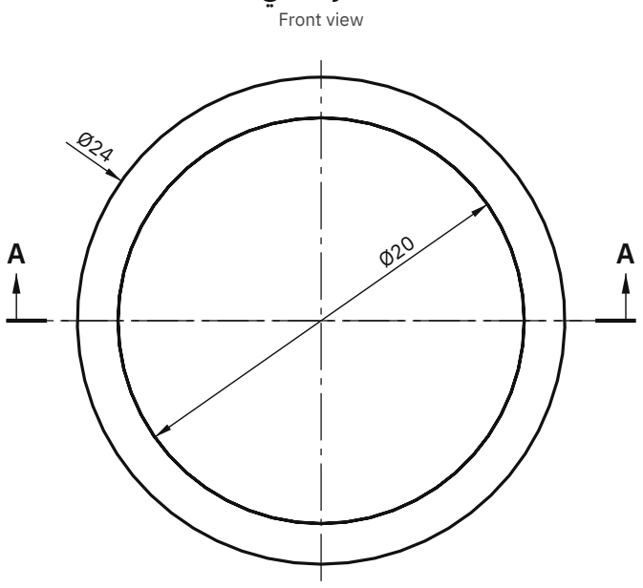
[picture p97: figure]
Front view
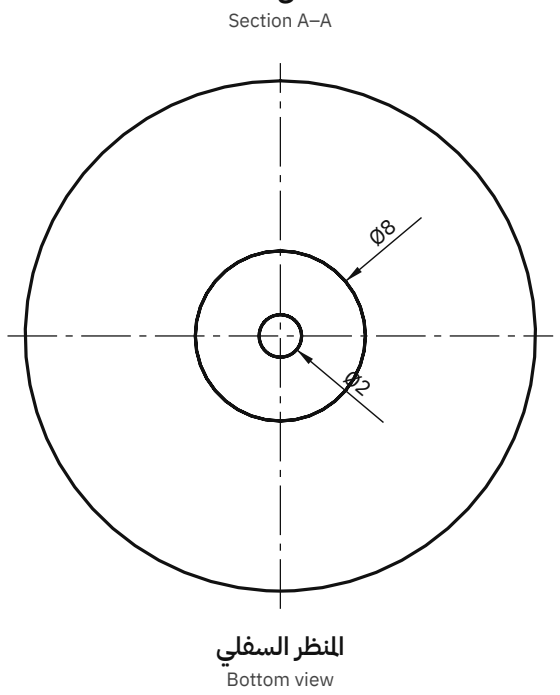
[picture p98: figure]
Section A–A; املنظر السفلي; Bottom view

## A–A املقطع

## املنظر العلوي

Top view

## منظوران مجّسمان )من أعلى ومن أسفل(

Isometric views

## -204HB الرأس املدبب )Spike — )2:1 · جديد

Ø8

# 30 R0.5

### زاوية الرأس ≈ °13.5

## املنظر األمامي

Front view

Ø8

## املنظر العلوي

Top view

مجّسم

.1 لصق حىت تالمس | مالحظات

دخل يف فتحة املحور 25Ø أسفل النصف السفلي -201HB( الخلوص 0.5 قطرًيا( وُت

-203HB مأخوذة كما هي من ملف STL.connector دون تعديل. ُت

سقف الفتحة.
.2 اتجاه الرتكيب: الجزء املجوف 20Ø لألعلى داخل فتحة املحور، والربوز 8Ø لألسفل. ثقب 2Ø ُيضغط على محور املوتور مبارشة.

.3 ، والتثبيت بالضغط مقصود.

ثقب 2Ø مقاسه االسمي يف امللف .2.0 الثقوب الصغرية املطبوعة تخرج عادة أضيق قلياًل
.4 -204HB قطعة جديدة حسب وصف الفريق: مخروط قاعدته 8Ø وارتفاعه ،30 ورأسه مدّور 0.5R حىت ُيطبع بال كرس.
.5 وقاعدته على الرسير، ثم لصقه يف منتصف وجه 8Ø أعلى املخروط يف -202HB. بهذا تبقى الكؤوس املعايرة كما هي دون إعادة طباعة.

ُيقرتح طباعة -204HB منفصاًل
.6 حدث عدم اتزان. ُيتحقق من رسعة بدء الدوران بعد الرتكيب.

### ا قرابة 0.6 غ، وتقع على محور الدوران، فال ُت

كتلة -204HB مصمًت

الوصلة والرأس املدبب | هبوب · Habub — النموذج األويل لتحدي إكسبو 2030 الرياض )التحدي 2.3(
-203/204HB رقم الرسم · DWG | Connector (HB-203) & Spike (HB-204)
10 / 10 اللوحة · Sheet | Material · املادة PLA / PETG | 2:1 · 3:1 املقياس · Scale
Rev · اإلصدار A · 2026-10-12 | .Gen. tol · العام التفاوت ±0.2) FDM) | Units · الوحدات mm
| -203HB من -204HB · STL من وصف الفريق مصدر املقاسات · Source
