SARAHXL1/Expo2023-HABOOB/src/01_firmware_esp32/sensor_node/secrets.example.h

// انسخ هذا الملف باسم secrets.h في المجلد نفسه، واكتب بيانات هوتسبوت الجوال.
// secrets.h مذكور في .gitignore فلا يُرفع إلى GitHub.
#pragma once
const char* WIFI_SSID = "ضع_اسم_الشبكة_هنا";   // بنفس الحروف الكبيرة والصغيرة · 2.4 GHz فقط
const char* WIFI_PASS = "ضع_كلمة_المرور_هنا";
